jejeong5976/Project2_Turtle_Ninja/sim/robot_sim/rl/tasks/swerve_follow/README.md

# swerve_follow — 스워브 경로 추종 RL

Nav2 플래너 경로 + 목표 자세 → 몸 속도 (vx, vy, wz) 20 Hz. 아래는 팀 스워브 컨트롤러(`nt_swerve` 규칙) 그대로 → 정책은 바퀴를 직접 안 만짐.
목적 = MPPI(`motion_model: omni`, 조향 지연 모름) 가 못 보는 조향 지연 · 조향 범위 끝(한 바퀴 못 돎) 을 아는 명령. MPPI 대체 후보 (채택은 평가 후).

설계는 Claude 초안 → Codex 검토 3회 (설계 · 수정안 · 구현 코드) 로 정함 (2026-10-30).

## 구조

| 파일 | 내용 |
|---|---|
| `sim_core/swerve_torch.py` | `nt_swerve.SwerveDrive.update` torch 벡터화 (coherent · 범위 · blend · 균일 cos 감속 · 게이트 · 굴림 보상) |
| `tools/check_swerve_torch.py` | 원본과 일치 검사: 역기구학 2만 건 + 상태 기계 48 env × 3000 틱, 불일치 0 |
| `tools/make_path_bank.py` | 경로 은행 `rl/data/path_bank.npz` (NavFn 흉내 지도 경로 + 합성) |
| `cfg.py` | 환경 · DR · 보상 · PPO 설정 |
| `plant.py` | 간이 플랜트 (조향 속도 한계 + 1차 지연, 바퀴 1차 지연, 순기구학 최소제곱, 몸 관성 필터) |
| `paths.py` | 경로 묶음: 창 안 투영 (부호 횡오차 · 경로까지 거리), 호 길이 보간 |
| `follower.py` | 기준 추종기 (= `scripts/measure_dice_routes.py` 추종기 식) |
| `env.py` | rsl_rl VecEnv (Isaac 안 띄움) |
| `check_env.py` | 경로 끝 이탈 · 헤어핀 창 · 플랜트 직진/옆/회전 · 명령 지연 · 관측 지연 검사 |
| `rl/train.py`, `rl/tasks/swerve_follow/play.py` | 학습 · 간이 플랜트 평가 (기준선 vs 정책, 같은 경로 · DR) |
| `rl/tasks/swerve_follow/viz_episode.py` | 평가 지도 경로 1 개를 지도 방향 그대로 달려 미로 위에 그림 (gif · png, 바퀴 조향 · 게이트 표시) |

**미로 물리는 없음**: 학습 · 평가 모두 평평한 바닥 간이 플랜트 (벽 충돌 없음, 라이다 관측 없음). 미로는 경로를 만드는 지도로만 씀. 벽 충돌 · 여유는 Isaac 미로 평가로 따로 (미구현).

## 주요 결정

| 항목 | 결정 | 이유 |
|---|---|---|
| 학습 시뮬 | torch 간이 플랜트 (GPU, 4096 env) | 전체 로봇 Isaac + Python 컨트롤러는 env 수천 개 불가. Isaac 은 검증용 (미구현) |
| 행동 | **잔차** = 기준 추종기 + (Δvx, Δvy) 노름 ≤ 0.05 m/s, Δwz ≤ 0.3 rad/s | 잔차 0 = 기준선, 실패 원인 분리. Codex 는 0.03 / 0.15 권고 → 비교 실험 대상 |
| yaw | 기준 추종기가 처음부터 목표 yaw 로 (비례 1.5), 잔차가 조정 | 자유 yaw 학습 안 함 |
| 속도 한계 | {0.10/0.2, 0.13/0.2} (m/s, m/s²) 균등, 관측으로 줌. 각속도 = 1.675 × v/0.2612, 각가속 = 6 × a | 실물 확인 범위. 0.2612/1.0 은 `--hardware_profile` |
| 판정 자세 | 보상 · 도착 · 이탈 = 현재 추정 자세 (참 + 위치 오차, 지연 없음) | Nav2 goal checker 와 같음. 위치 오차는 컨트롤러가 못 고침 |
| reset 조향 | 직전 에피소드 끝 상태 이어받기 (컨트롤러 분기 이력도), 20 % 는 범위 안 무작위 | 연속 Nav2 목표와 같은 상황. 설계 v2 의 '무작위 사전 주행' 대신 |
| 지도 나눔 | 학습 real + rand_00..06, 평가 dice + rand_07 | 같은 지도로 평가하면 일반화 주장 불가 |

## 관측 (actor 130)

| 항목 | 차원 |
|---|---|
| 경로 앞 점 16 개 (0.1 m 간격, 추정 자세 base 기준) | 32 |
| 목표 (dx/2, dy/2, sin · cos dyaw, 남은 길이/3) | 5 |
| 기준 추종기 명령 / 한계 | 3 |
| 고유 상태 × 4 프레임 (현재 + 이전 3): 조향 sin · cos · 범위 위치, 바퀴 속도, odom, 직전 보낸 명령 | 22 × 4 |
| 한계 (v_max/0.26, a_max/1.0) | 2 |

critic 추가 (25): 참 몸 속도, 판정 자세 횡오차 · dyaw · 남은 길이, 조향 속도 한계 · τ 3 개 · 지연 2 개 · blend 비율 · 게이트, 위치 오차, 바퀴 미끄럼 4.

## 보상 (정책 스텝 50 ms)

| 항 | 식 |
|---|---|
| 진행 | +5 · Δs (부호 있음, \|Δs\| > v_max·dt + 0.05 면 0) |
| 경로 거리 | −0.02 · min((d/0.05)², 9) |
| 끝 방향 | −0.02 · (1 − cos dyaw) · clip(1 − 남은 길이/0.3, 0, 1) |
| 행동 변화 | −0.01 · ‖Δa‖² |
| 시간 | −0.005 |
| 성공 | +20: 5 cm · 0.1 rad · 0.02 m/s · 0.05 rad/s 를 0.5 s 유지 (종료) |
| 실패 | −20: 경로 거리 0.25 m 즉시 또는 0.15 m 0.5 s (종료) |
| 시간 초과 | 2 L / v_max + 15 s, truncation (bootstrap = rsl_rl 식 V(s_t) 근사) |

분기 전환 · 조향 이동량은 가중 0, 지표로만 기록.

## 도메인 랜덤화 (에피소드마다)

| 항목 | 범위 |
|---|---|
| 조향 속도 한계 | {0.96, 2.44, 4.80} × U(0.8, 1.2) rad/s (실물 미측정 → 3 조건 층화) |
| 조향 · 바퀴 · 몸 1차 지연 τ | 0.05–0.15 · 0.02–0.06 · 0.02–0.08 s |
| 바퀴별 접지 미끄럼 | 0.90–1.0 (odom 에는 안 걸림) |
| 명령 · 관측 지연 | 0–30 · 0–40 ms (10 ms 틱 링 버퍼) |
| 관측 잡음 | 조향 0.005 rad, 선속도 0.005 m/s, 각속도 0.02 rad/s |
| 위치 추정 오차 | 시작 ±2 cm · ±1°, 2 s 마다 30 % 로 ±1 cm · ±0.5° 계단 (범위 안으로 자름) |

## 경로

- 지도 경로: `layout_to_occupancy` 격자 → Nav2 식 비용 (내접 0.17 m 253, 팽창 0.25 m · scale 10) → NavFn 식 칸 비용 (50 + 0.8 c) Dijkstra 8 이웃 (대각선 모서리 통과 금지) → 퍼텐셜 경사 하강 → 0.05 m 재표본 → 중심 비용 < 253. 사각 footprint 충돌 검사는 안 함 (NavFn 과 같음). 실제 NavFn 출력과 비교 안 함.
- 합성: 꺾은선 + 원호, 등급 0 (≤45°, ≤2 m) / 1 (≤135°) / 2 (U턴).
- 학습 7800 개 (지도 4800), 평가 1200 개 (지도 600). 길이 중앙 2.4 m · 최대 10 m.
- 커리큘럼: 학습 성공률 (최근 2000 에피소드) 0.9 넘으면 등급 0 → 1 → 2. 초기 위치 ±2 → 5 cm, yaw ±15° → ±180°.

## PPO

actor [128, 128] ELU · critic [256, 256] ELU, 관측 정규화, 초기 std 0.3, entropy 0.001, γ 0.995, λ 0.95, 64 스텝/env, 5 epoch, 4 미니배치, lr 3e-4 adaptive (kl 0.01).

## 결과 (2026-10-30)

| 항목 | 기준선 (잔차 0) |
|---|---|
| 평가 에피소드 | 2400 (평가 경로 1200 × 2) |
| 성공 · 실패 · 시간 초과 | 99.25 % · 0.75 % · 0 % |
| 성공 시간 · 평균 속도 | 29.9 s · 0.092 m/s |
| 경로 거리 평균 · 최대 평균 · 최대 p95 | 1.7 · 6.2 · 11.5 cm |
| 분기 전환 · 조향 이동량 · 게이트 정지 | 4.4 회 · 29.6 rad · 0.41 s |
| 참 자세 끝 오차 p95 | 2.7 cm |

학습 처리량: 컨트롤러 + 플랜트 한 틱을 `torch.compile` (cfg `compile`) → 4096 env 111 → 16 ms/step, 16384 env 21 ms/step (약 78 만 env-step/s). 작은 연산 수천 개라 커널 띄우는 시간이 병목 (nvidia-smi 사용률은 높게 나와도 메모리 · 연산은 적음) → env 를 늘리는 게 거의 공짜. 기본 16384 env, iteration 3.2 s (100 만 샘플). 본학습 아직.

## 실행

```bash
cd sim/robot_sim
PY="env -u PYTHONPATH $HOME/pa-course/IsaacLab-6.2/.venv/bin/python"
$PY tools/check_swerve_torch.py              # 컨트롤러 일치
$PY rl/tasks/swerve_follow/check_env.py      # 환경 검사
$PY tools/make_path_bank.py                  # 경로 은행 (4 s)
$PY rl/tasks/swerve_follow/play.py --baseline                    # 기준선
$PY rl/train.py --max_iterations 1500 --run_name res005   # 약 80 분
$PY rl/tasks/swerve_follow/play.py --checkpoint rl/logs/swerve_follow/<실행>/model_1500.pt
$PY rl/tasks/swerve_follow/viz_episode.py --baseline --map dice --k 0   # → rl/data/swerve_follow/viz/*.gif
```

## 본학습 1 (2026-10-30, `rl/logs/swerve_follow/20261030_162155_res005`, 16384 env · 1500 iter · 약 61 분)

| 항목 | 기준선 | 정책 |
|---|---|---|
| 성공 | 99.25 % | 99.29 % |
| 성공 시간 · 평균 속도 | 29.89 s · 0.0918 m/s | 29.92 s · 0.0917 m/s |
| 경로 거리 평균 · 최대 p95 | 1.73 · 11.5 cm | 1.63 · 11.5 cm |
| 분기 전환 · 조향 이동량 | 4.4 회 · 29.6 rad | **6.9 회 · 40.1 rad** |
| 게이트 정지 | 0.41 s | 0.39 s |
| 끝 오차 (판정) | 0.23 cm | 1.0 cm |
| 조향 끝 0.5° 안 닿은 env (75 s 연속) | 37.9 % | 39.0 % |

- 개선 없음. 잔차 평균 약 0.01 m/s · 0.065 rad/s 만 씀, std 0.29 → 0.005 (iter 750 쯤 0.017) 로 일찍 줄어듦. 커리큘럼은 iter 150 전에 단계 2
- 원인 (판단): ① 보상에서 빨리 가는 이득이 작음 (진행 보상 총합은 속도와 무관, 시간 감점 0.005/스텝뿐), ② 기준 추종기가 이미 직선 · 곡선에서 v_max, 남는 시간은 가속 · 끝 감속 · 0.5 s 유지 쪽, ③ 조향 비용 가중 0 → 정책이 조향을 더 많이 씀, ④ 탐색이 일찍 죽음

## 남은 것 · 한계

- 간이 플랜트는 접촉 물리가 아님 (최소제곱 순기구학 = 바퀴 어긋남 근사). Isaac 재생 비교 (같은 명령 → 궤적) 로 τ 맞추기 · Isaac 미로 평가 (footprint 충돌 · 최소 여유) 미구현
- `nt_swerve` = 팀 swerve.cpp 10-27 로컬 판. 레포 main C++ 은 옛 판 → 실물에 올라간 판 확인 필요 (control)
- 실물 `/joint_states` 조향각 · 바퀴 속도 제공 · 빈도 · 신선도 미확인 (관측에 필수)
- 실물 조향 속도 (0.96 vs 4.8 rad/s) 미측정 → 측정되면 DR 3 조건을 실측 ±20 % 로
- 잔차 0.05/0.3 vs 0.03/0.15 비교, 커리큘럼 승급을 고정 검증셋 기준으로 바꿀지 (Codex 권고)
- 배포: 가중치 + 정규화 → Nav2 controller 플러그인 (C++) 미구현
- 채택 기준 (Codex 제안): 시뮬 고정 평가 100 회 충돌 0 · 성공 ≥ 99, 실물 대표 경로 20 회 연속, 기준선 대비 중앙 시간 10 % 이상 개선 + p95 오차 · 시간 악화 없음
