jejeong5976/Project2_Turtle_Ninja/sim/robot_sim/rl/tasks/swerve_track/README.md

# swerve_track — 스워브 속도 추종 잔차 RL

`/cmd_vel` (MPPI 출력) → 몸 속도 잔차 → `nt_swerve` → 조향 · 바퀴. MPPI 는 그대로 두고 그 아래 끼우는 층 (MPPI 대체 아님).
R12 팀 주행 PPO (velog "프로젝트2 PPO 신경망 구조": 목표 속도 → 바퀴 속도 잔차, 고정 평가 RMSE) 를 참고해 2026-11-02 설계. `swerve_follow` (경로 층) 본학습 1 이 보상 문제로 개선 없었던 것 → 목표를 "명령 속도 따라가기" 하나로 좁힘.

```
Nav2 MPPI → collision_monitor → /cmd_vel ─┐
                                          ├→ [정책: 몸 속도 잔차] → nt_swerve → 조향 · 바퀴
odom · 조향각 · 바퀴 속도 · 자이로 ───────┘
```

## R12 설계와 다른 점

| 항목 | R12 | 여기 | 이유 |
|---|---|---|---|
| 행동 | 바퀴 구동 속도 잔차 4 | 몸 속도 잔차 3 (nt_swerve 앞) | 바퀴별로 고치면 역기구학이 맞춘 바퀴 사이 일관성이 깨짐 → 실물 끌림. 간이 플랜트 (최소제곱 순기구학) 는 끌림 비용을 못 봄 |
| 기울기 보상 | −10 (roll² + pitch²) | 없음 | 간이 플랜트에 roll · pitch 없음 (Isaac 검증 때 지표로만) |
| IMU | 각속도 3 · 가속도 3 | 자이로 z 1 | 평평한 바닥 플랜트 |
| 조향 비용 | 없음 | 이동량 + 범위 끝 | swerve_follow 본학습 1 에서 분기 전환 4.4 → 6.9 회 악화, 조향 끝 닿음 38 % (선 꼬임) |
| 학습 규모 | env 8 × 64 스텝 | env 16384 × 64 (torch 플랜트) | |
| critic | 1 층 128 | [256, 256] + 특권 관측 | |

## 구조

| 파일 | 내용 |
|---|---|
| `tools/make_cmd_bank.py` | 명령 은행 `rl/data/swerve_track/cmd_bank.npz` (20 Hz, 열 최대 20 s, 열마다 v_max · a_max) |
| `cfg.py` | 환경 · 보상 · PPO. DR = `swerve_follow.cfg.DRCfg` 그대로 |
| `env.py` | rsl_rl VecEnv. 플랜트 · 컨트롤러 = `swerve_follow.plant` · `sim_core/swerve_torch.py` |
| `rl/tasks/swerve_track/play.py` | 평가 (기준선 vs 정책, 출처별) |
| `rl/train.py --task swerve_track` | 학습 |

## 명령 은행

| 출처 | 만드는 법 | 학습 · 평가 열 |
|---|---|---|
| follower | `swerve_follow` 기준 추종기를 경로 은행 위에서 닫힌 고리 주행 → 보낸 명령 기록 (경로 split 0 → 학습, 1 → 평가) | 13851 · 2192 |
| synth | 구간 상수 (0.5–3 s, 정지 15 %, 방향 ±90° 40 % · 180° 20 %, 회전 동시 50 %) → 가속 한계 램프 → 잡음 0.005 | 4000 · 600 |

- 실제 MPPI 출력이 아님 (대용). MPPI 녹화 (`sim_nav2` 로 `/cmd_vel` 기록) 는 미구현 → 하면 은행에 출처 2 로 추가

## 관측 (actor 77)

| 항목 | 차원 |
|---|---|
| 목표 명령 / 한계 | 3 |
| 목표 − odom / 한계 | 3 |
| 앞으로 올 명령 (`preview`, 기본 0) | 3 × k |
| 고유 상태 × 3 프레임: 조향 sin · cos · 범위 위치 12, 바퀴 4, odom 3, 자이로 z 1, 직전 보낸 명령 3 | 23 × 3 |
| 한계 (v_max/0.26, a_max/1.0) | 2 |

critic 추가 (21): 참 몸 속도 3, 조향 속도 한계 · τ 3 · 지연 2 · blend · 게이트 8, 바퀴 미끄럼 4, 0.25 · 0.5 s 뒤 명령 6.

- 미리보기 기본 0: 실물에서 앞 명령을 얻으려면 MPPI 내부 최적 열이 필요 (Nav2 는 경로 형태로만 냄) → 지금은 반응형만

## 행동 · 안전

- 잔차 = (Δvx, Δvy) 노름 ≤ 0.03 m/s, Δwz ≤ 0.15 rad/s (Codex 권고값). 합친 명령은 v_max · w_max 로 자름
- 목표가 정지 (‖v‖ < 0.005 · |wz| < 0.02) 면 잔차 0 → collision_monitor 정지 · `/mission/hold` 가 항상 이김

## 보상 (정책 스텝 50 ms)

| 항 | 식 |
|---|---|
| 선속도 추종 | 1.0 · exp(−‖v_xy − c_xy‖² / 0.05²) (참 몸 속도) |
| 각속도 추종 | 0.5 · exp(−(wz − c_wz)² / 0.15²) |
| 조향 이동량 | −0.2 · Σ\|Δθ\| [rad/스텝] |
| 조향 범위 끝 | −0.05 · 바퀴 평균 clip((0.1 − 끝까지 거리)/0.1, 0, 1) |
| 행동 크기 · 변화 | −0.01 ‖a‖², −0.01 ‖Δa‖² |

에피소드 = 명령 열 끝까지 (truncation, 실패 종료 없음). 조향 상태는 직전 에피소드에서 이어받음 (20 % 무작위).

## PPO

actor [128, 128] ELU · critic [256, 256] ELU, 관측 정규화, 초기 std 0.3 · **최소 std 0.02** (`std_range`), entropy 0.002, γ 0.99, λ 0.95, 64 스텝/env, 5 epoch, 4 미니배치, lr 3e-4 adaptive (kl 0.01).

## 기준선 (잔차 0, 2026-11-02, 평가 2792 열 × 2)

| 묶음 | 선속도 RMSE 평균 · p95 | 각속도 RMSE 평균 · p95 | R12 기준 (0.03 · 0.10) 통과 | 조향 이동 rad/s | 게이트 s |
|---|---|---|---|---|---|
| 전체 | 0.039 · 0.070 | 0.111 · 0.317 | 22.5 % | 1.79 | 0.40 |
| follower | 0.040 · 0.073 | 0.117 · 0.332 | 21.4 % | 1.24 | 0.32 |
| synth | 0.038 · 0.060 | 0.088 · 0.148 | 26.4 % | 3.76 | 0.72 |

조향 속도별 (follower + synth, 첫 1 s 따로):

| 조향 속도 | 선속도 전체 · 첫 1 s · 나머지 | 각속도 전체 · 첫 1 s · 나머지 | \|wz 명령\| > 0.3 스텝 (12.6 %) 각속도 |
|---|---|---|---|
| 0.96 rad/s | 0.054 · 0.103 · 0.049 | 0.194 · 0.451 · 0.164 | 0.528 |
| 2.44 | 0.037 · 0.096 · 0.030 | 0.141 · 0.419 · 0.100 | 0.380 |
| 4.80 | 0.029 · 0.080 · 0.022 | 0.109 · 0.355 · 0.068 | 0.289 |

- 오차 대부분 = 느린 조향 · 출발 첫 1 s (무작위 조향에서 시작) · 큰 회전 명령 구간
- 조향 4.8 rad/s 면 첫 1 s 뺀 나머지는 R12 기준 안 → **실물 조향 속도가 정책 쓸모를 정함** (hardware_map profile_vel 40 = 0.96 rad/s 라는 기록 있음, 실측 필요)

## 본학습 1 (2026-11-02, `rl/logs/swerve_track/20261102_170547_track`, 16384 env · 1000 iter, 잔차 0.03 · 0.15, 미리보기 0)

평가 은행 (2792 열 × 2), 기준선 → 정책:

| 조건 | 선속도 RMSE 평균 | 각속도 RMSE 평균 | 각속도 p95 | 변화 구간 각속도 | 조향 이동 rad/s | 게이트 s |
|---|---|---|---|---|---|---|
| DR 3 조건 | 0.0394 → 0.0385 (−2.1 %) | 0.1105 → 0.1085 (−1.8 %) | 0.317 → 0.303 (−4.4 %) | 0.105 → 0.101 (−3.9 %) | 1.79 → 1.79 | 0.40 → 0.39 |
| 조향 0.96 | 0.0531 → 0.0517 (−2.7 %) | 0.1417 → 0.1388 (−2.1 %) | 0.394 → 0.383 | 0.153 → 0.152 | 1.45 → 1.47 | 0.69 → 0.67 |
| 조향 2.44 | 0.0367 → 0.0358 (−2.4 %) | 0.1049 → 0.1023 (−2.4 %) | 0.281 → 0.266 | 0.090 → 0.088 | 1.88 → 1.88 | 0.33 → 0.32 |
| 조향 4.80 | 0.0282 → 0.0281 (−0.7 %) | 0.0850 → 0.0842 (−0.9 %) | 0.211 → 0.204 | 0.073 → 0.067 (−8.9 %) | 2.04 → 2.04 | 0.19 → 0.18 |

- 개선 1–3 % = 채택 기준 (20 %) 에 크게 못 미침. 조향 비용 · 범위 끝은 악화 없음 (본학습 1 swerve_follow 와 달리 조향을 더 쓰지 않음)
- 잔차 평균 선속도 0.008 m/s (한계의 27 %) · 각속도 0.009 rad/s (6 %), std 0.30 → 0.034 (하한 0.02 근처)
- synth (계단 · 90° 전환) 는 개선 0 또는 소폭 악화 (선속도 +0.8 %). 이득은 follower 쪽 (−2.8 %) 에서만
- 판단: 오차가 조향 속도 · 출발 조향 · 가속 한계 같은 물리 한계에서 나옴 → 지금 명령만 보는 반응형 잔차로는 못 줄임. 줄이려면 앞 명령 (미리보기) 이 필요 → 시뮬에서 `preview` 로 상한 확인할 가치 있음

## 남은 것

- 실물 조향 속도 · `/joint_states` 빈도 실측 → DR 을 실측 ±20 % 로
- MPPI `/cmd_vel` 녹화 은행 (`sim_nav2`), 미리보기 (MPPI 최적 열) 얻는 법
- Isaac 재생 비교 (같은 명령 → 궤적), 배포 (C++ 추론, swerve_controller 안 또는 cmd_vel 중계 노드)
- 채택 기준 (안): 평가 은행에서 기준선 대비 선속도 · 각속도 RMSE 20 % 이상 감소 + 조향 이동량 · 범위 끝 악화 없음, 실물 대표 경로 20 회

## 실행

```bash
cd sim/robot_sim
PY="env -u PYTHONPATH $HOME/pa-course/IsaacLab-6.2/.venv/bin/python"
$PY tools/make_cmd_bank.py                                  # 약 2.5 분
$PY rl/tasks/swerve_track/play.py --baseline                             # 기준선
$PY rl/train.py --task swerve_track --max_iterations 1000 --run_name track
$PY rl/tasks/swerve_track/play.py --checkpoint rl/logs/swerve_track/<실행>/model_1000.pt
```
