jejeong5976/Project2_Turtle_Ninja/config/camera_home_ref.png

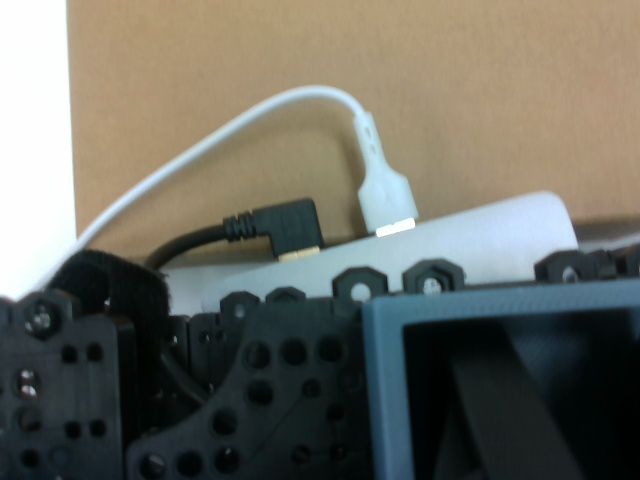
config/camera_home_ref.png
