jejeong5976/Project2_Turtle_Ninja/sim/robot_sim/usd/props/tex/barcode_3.png

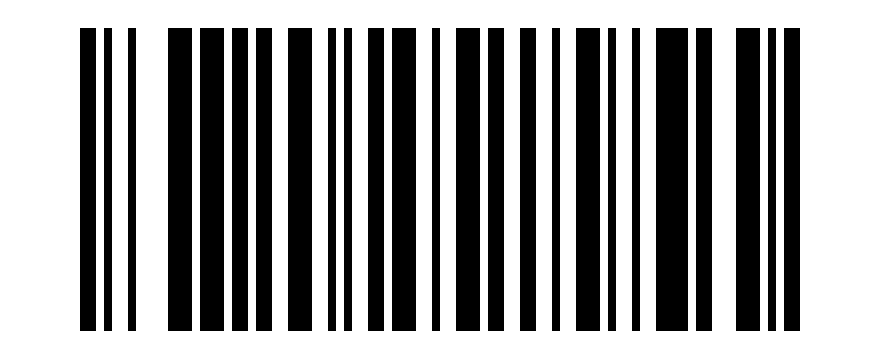
sim/robot_sim/usd/props/tex/barcode_3.png
