jejeong5976/Project2_Turtle_Ninja/sim/robot_sim/usd/props/tex/tag36h11_03.png

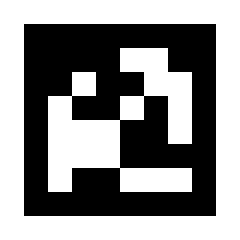
sim/robot_sim/usd/props/tex/tag36h11_03.png
