jejeong5976/Project2_Turtle_Ninja/sim/robot_sim/usd/textures/carpet_tile.jpg

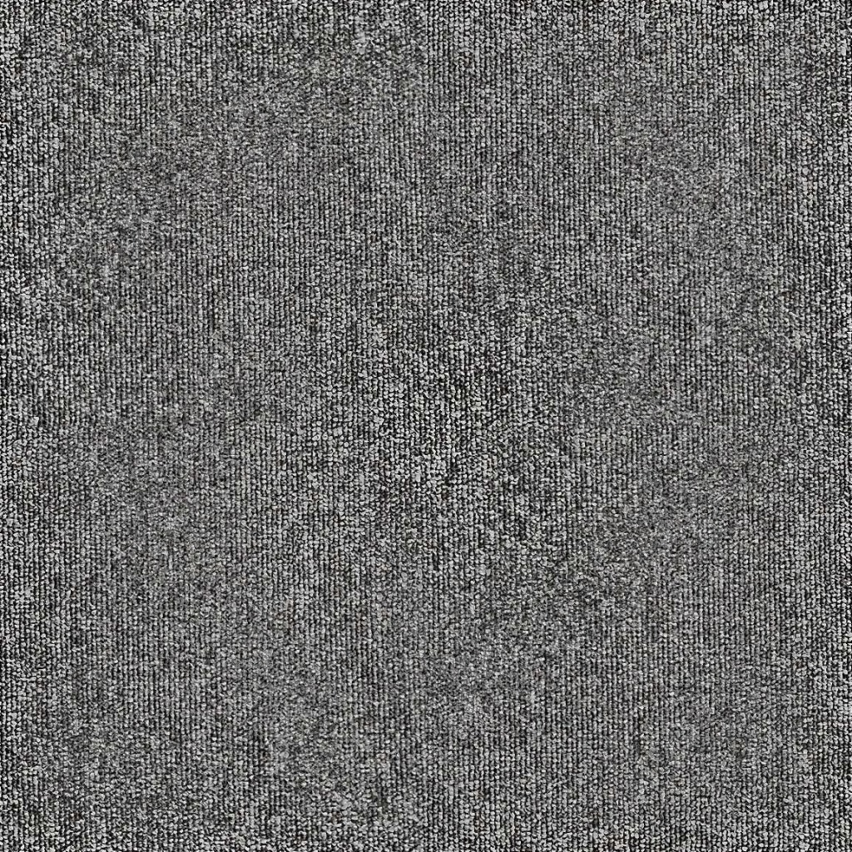
sim/robot_sim/usd/textures/carpet_tile.jpg
