jejeong5976/Project2_Turtle_Ninja/sim/robot_sim/usd/textures/pano_191331.jpg

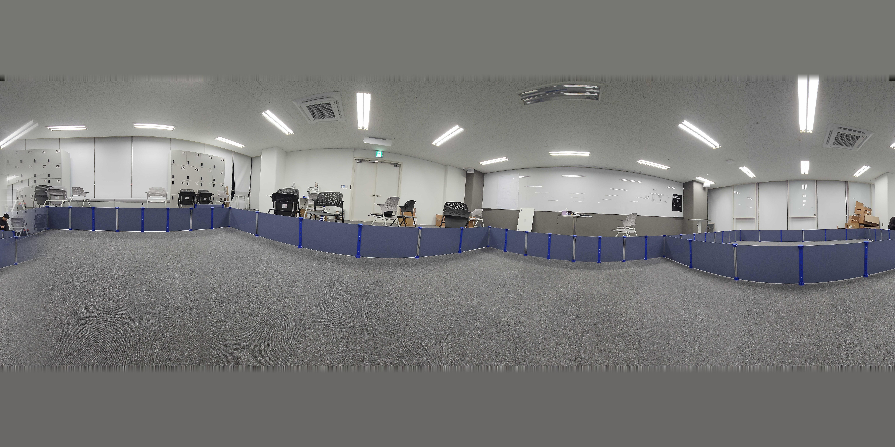
sim/robot_sim/usd/textures/pano_191331.jpg
