jejeong5976/Project2_Turtle_Ninja/ros2_ws/src/description/meshes/arm/collision/wrist_assembly_2_1_part_1_1.obj

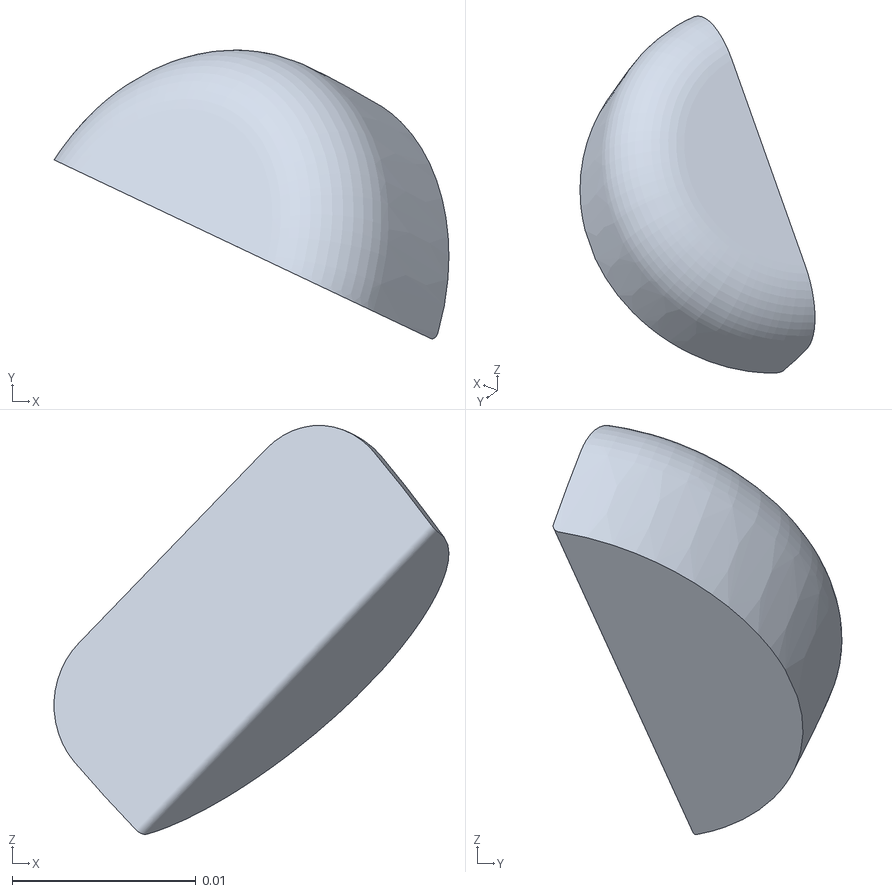
[picture p30: CAD file, 2026-11-02]
ros2_ws/src/description/meshes/arm/collision/wrist_assembly_2_1_part_1_1.obj
0.0215 x 0.0157 x 0.0222
