jejeong5976/Project2_Turtle_Ninja/ros2_ws/src/description/meshes/arm/collision/wrist_assembly_2_1_part_2_1.obj

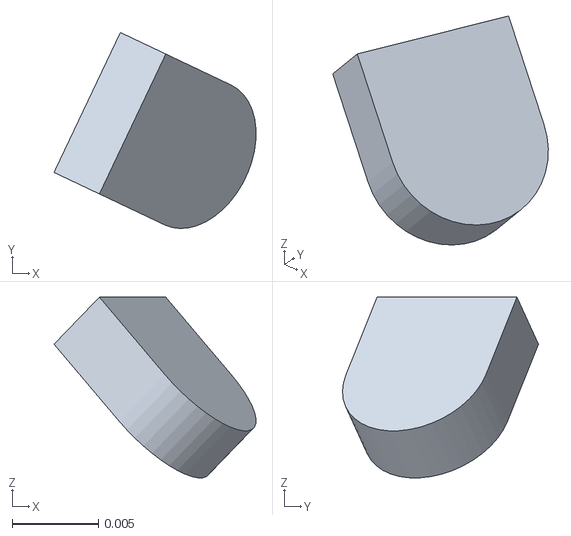
[picture p31: CAD file, 2026-11-02]
ros2_ws/src/description/meshes/arm/collision/wrist_assembly_2_1_part_2_1.obj
0.0117 x 0.0114 x 0.0105
