jejeong5976/Project2_Turtle_Ninja/ros2_ws/src/description/meshes/arm/collision/wrist_assembly_2_1_part_3_1.obj

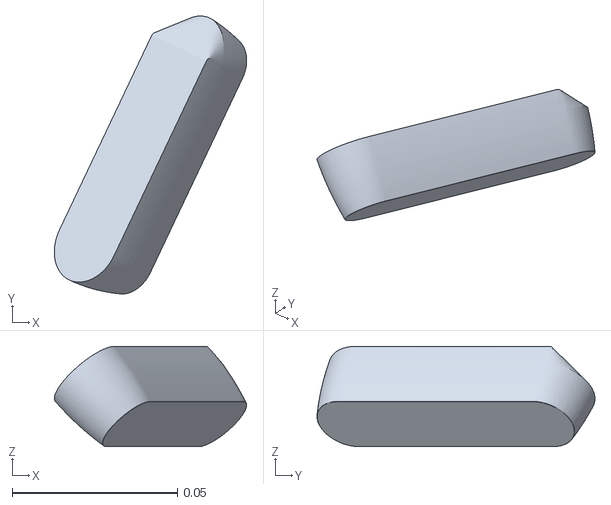
[picture p32: CAD file, 2026-11-02]
ros2_ws/src/description/meshes/arm/collision/wrist_assembly_2_1_part_3_1.obj
0.0581 x 0.084 x 0.0303
