jejeong5976/Project2_Turtle_Ninja/ros2_ws/src/description/meshes/arm/wrist_motor_mount_plate.obj

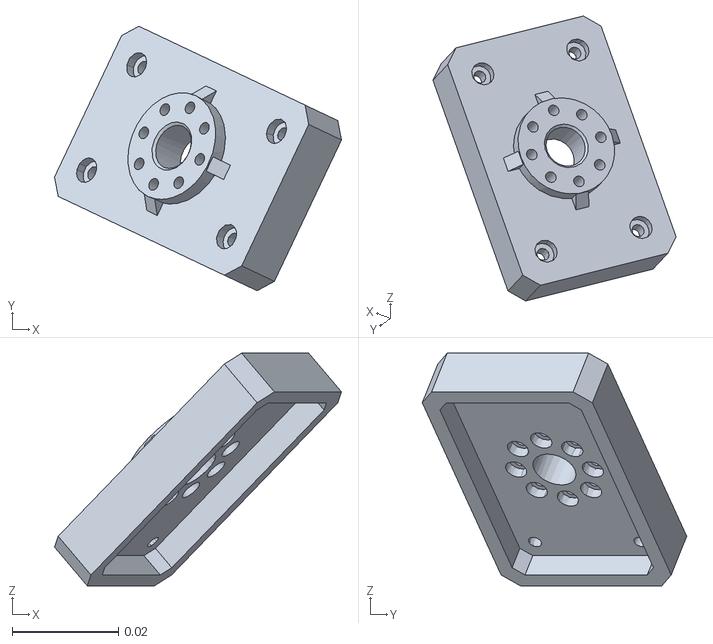
[picture p35: CAD file, 2026-11-02]
ros2_ws/src/description/meshes/arm/wrist_motor_mount_plate.obj
0.0541 x 0.0499 x 0.0439
