jejeong5976/Project2_Turtle_Ninja/ros2_ws/src/description/meshes/base/hardware/support_hex_m3_0xl35_ff_1.obj

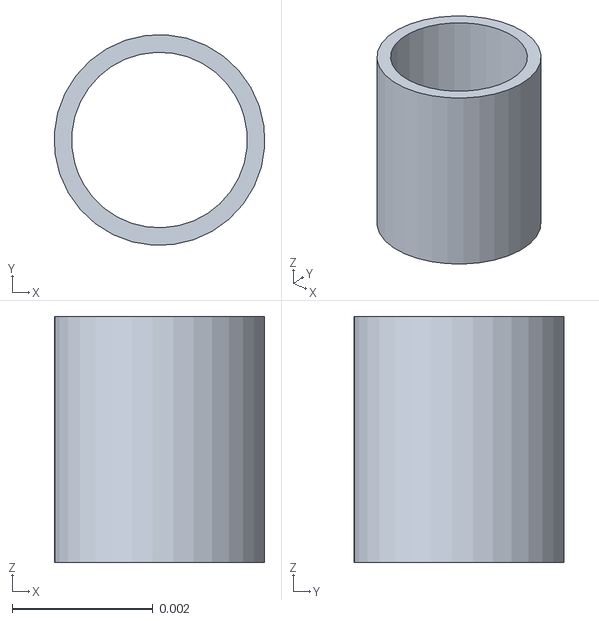
[picture p36: CAD file, 2026-11-02]
ros2_ws/src/description/meshes/base/hardware/support_hex_m3_0xl35_ff_1.obj
0.00299 x 0.00299 x 0.0035
