jejeong5976/Project2_Turtle_Ninja/ros2_ws/src/description/meshes/base/steer_motor.obj

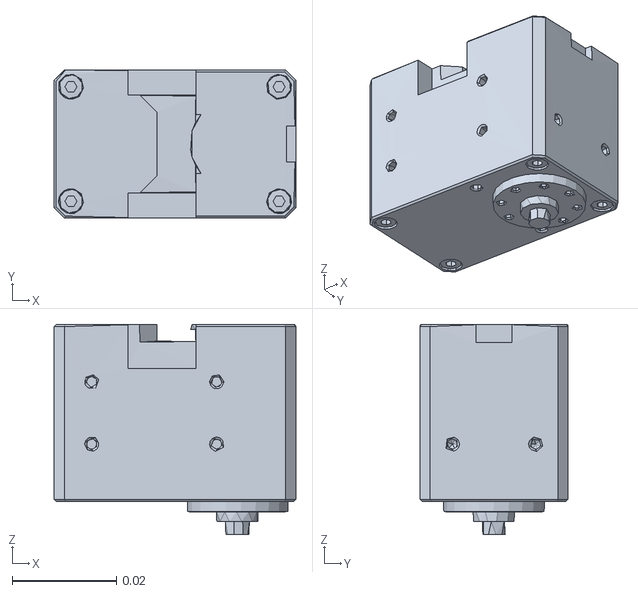
[picture p37: CAD file, 2026-11-02]
ros2_ws/src/description/meshes/base/steer_motor.obj
0.0465 x 0.0285 x 0.0404
