jejeong5976/Project2_Turtle_Ninja/ros2_ws/src/description/meshes/camera/bracket_lever.obj

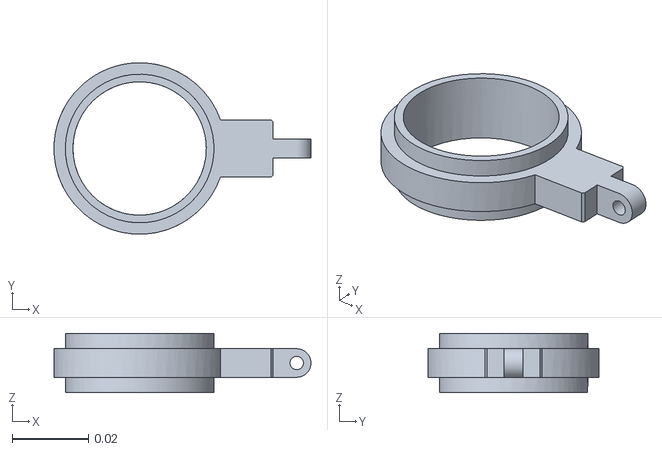
[picture p38: CAD file, 2026-11-02]
ros2_ws/src/description/meshes/camera/bracket_lever.obj
0.0675 x 0.045 x 0.0155
