jejeong5976/Project2_Turtle_Ninja/ros2_ws/src/description/meshes/camera/collision/birdeye_connector.obj

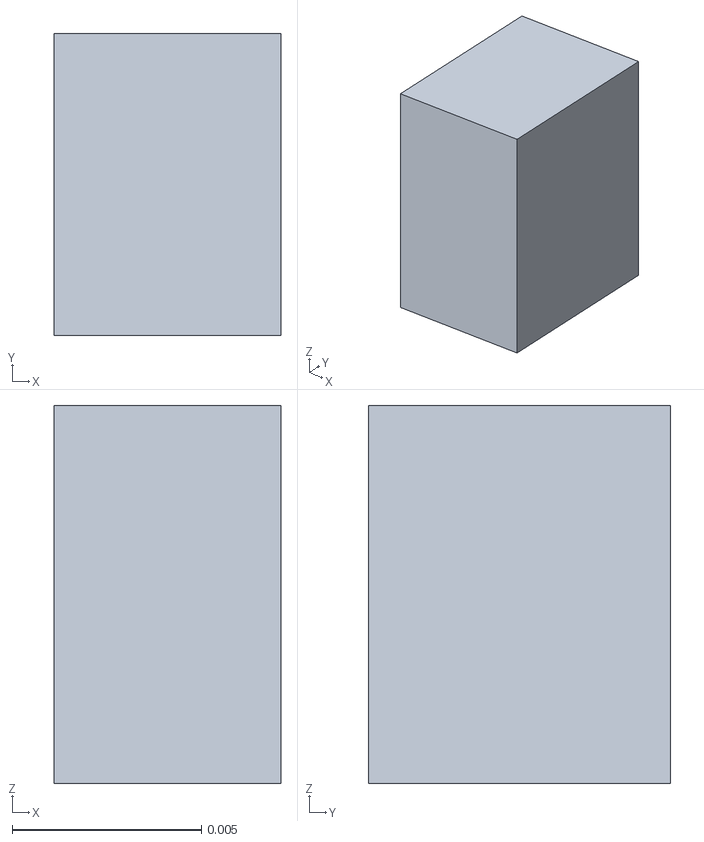
[picture p39: CAD file, 2026-11-02]
ros2_ws/src/description/meshes/camera/collision/birdeye_connector.obj
0.006 x 0.008 x 0.01
