jejeong5976/Project2_Turtle_Ninja/ros2_ws/src/description/meshes/electronics/opencr_drive.obj

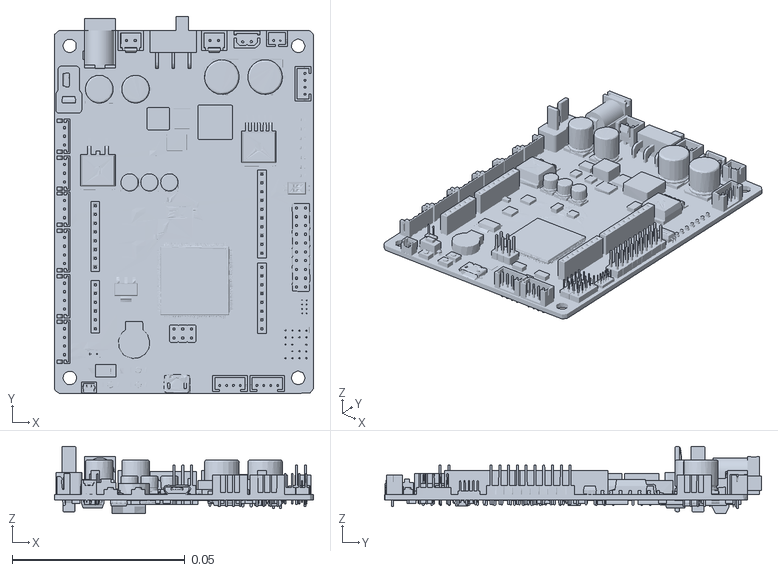
[picture p40: CAD file, 2026-11-02]
ros2_ws/src/description/meshes/electronics/opencr_drive.obj
0.075 x 0.109 x 0.0194
