jejeong5976/Project2_Turtle_Ninja/ros2_ws/src/description/meshes/lidar/lds03_body.obj

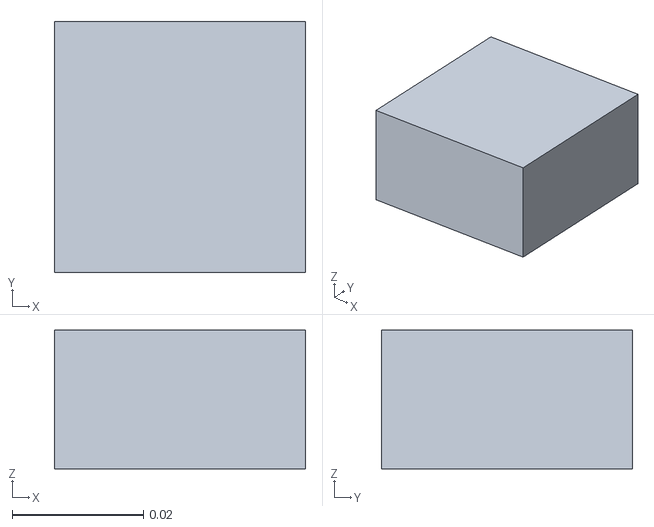
[picture p41: CAD file, 2026-11-02]
ros2_ws/src/description/meshes/lidar/lds03_body.obj
0.0382 x 0.0382 x 0.0211
