jejeong5976/Project2_Turtle_Ninja/ros2_ws/src/description/meshes/rack/rack_4cell.obj

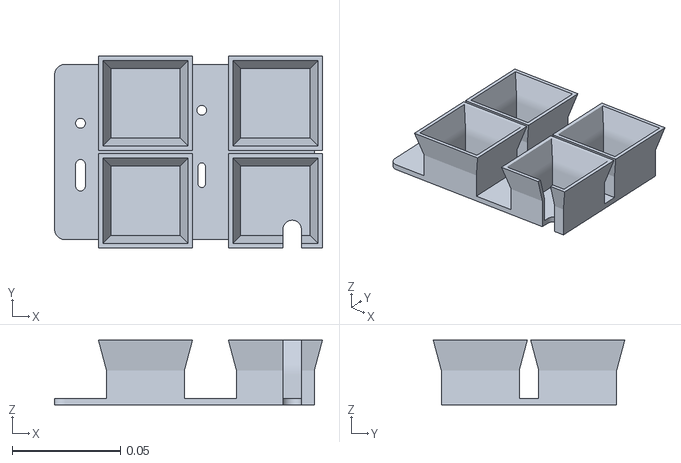
[picture p42: CAD file, 2026-11-05]
ros2_ws/src/description/meshes/rack/rack_4cell.obj
0.124 x 0.0885 x 0.03
