jejeong5976/Project2_Turtle_Ninja/ros2_ws/src/description/meshes/structure/collision/profile_holder.obj

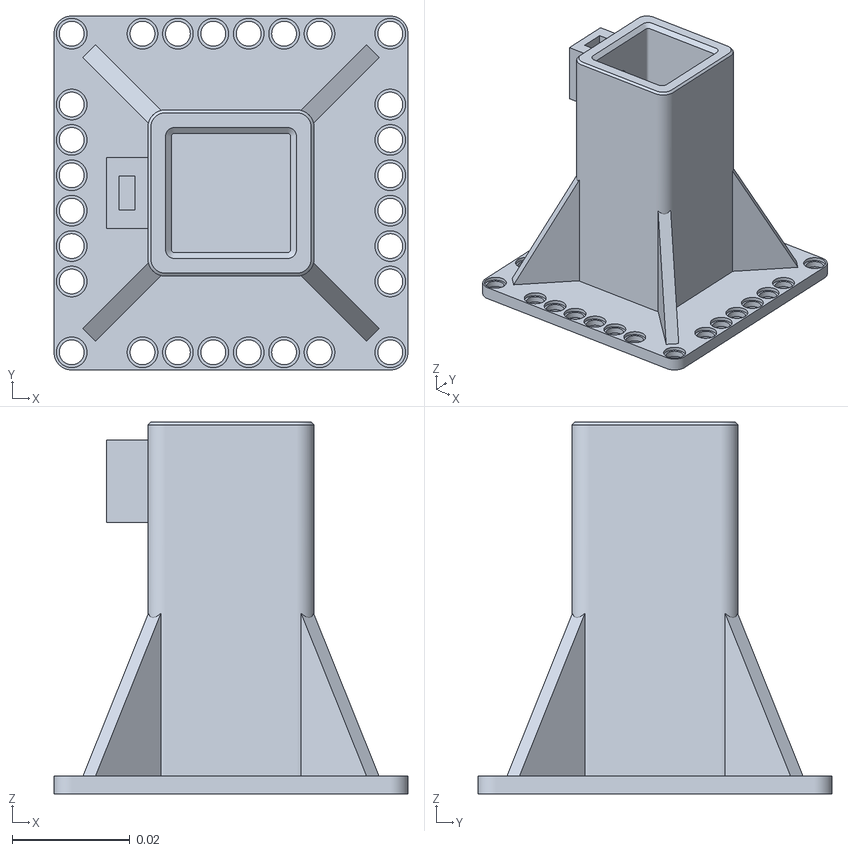
[picture p43: CAD file, 2026-11-02]
ros2_ws/src/description/meshes/structure/collision/profile_holder.obj
0.06 x 0.06 x 0.063
