jejeong5976/Project2_Turtle_Ninja/ros2_ws/src/description/meshes/structure/profile_450mm.obj

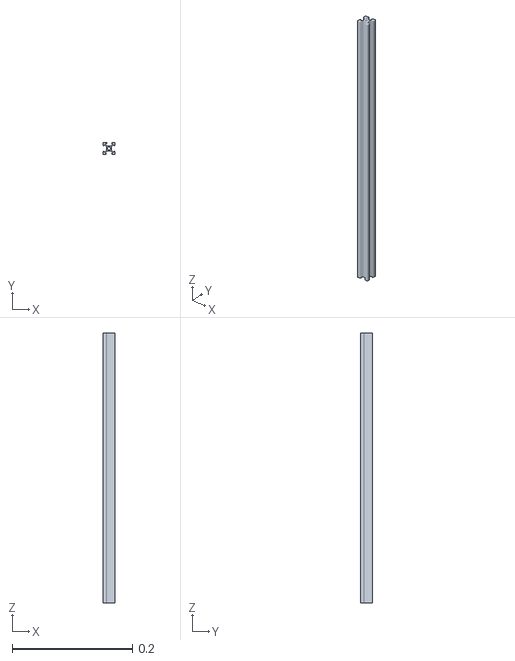
[picture p44: CAD file, 2026-11-02]
ros2_ws/src/description/meshes/structure/profile_450mm.obj
0.02 x 0.02 x 0.45
