jejeong5976/Project2_Turtle_Ninja/ros2_ws/src/description/meshes/swerve/module_fr.stl

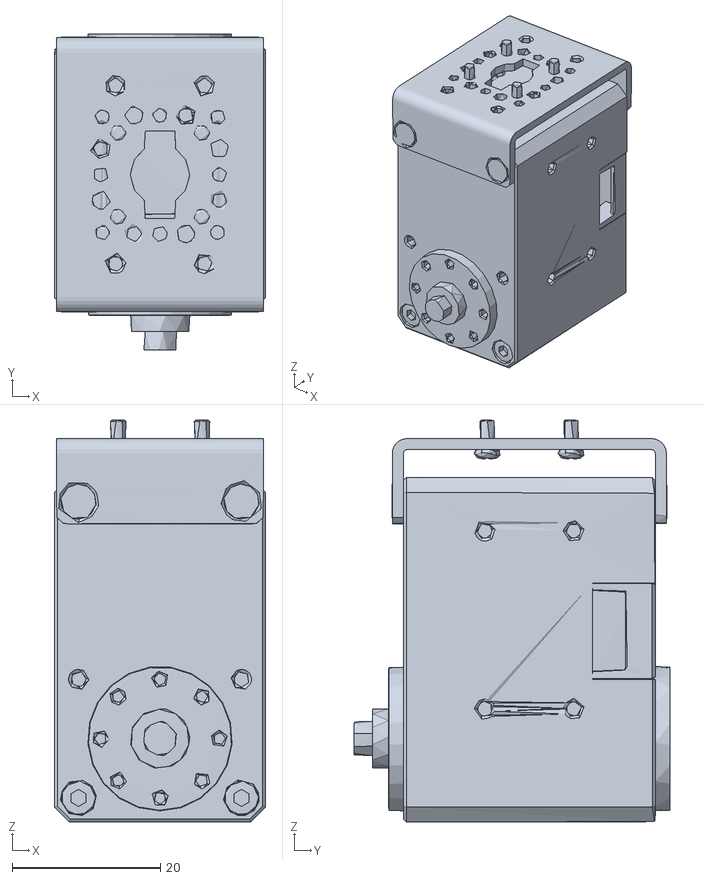
[picture p45: CAD file, 2026-10-21]
ros2_ws/src/description/meshes/swerve/module_fr.stl
28.5 x 42.7 x 54.3
