jejeong5976/Project2_Turtle_Ninja/ros2_ws/src/description/meshes/arm/wrist_frame_hinged_camera.obj

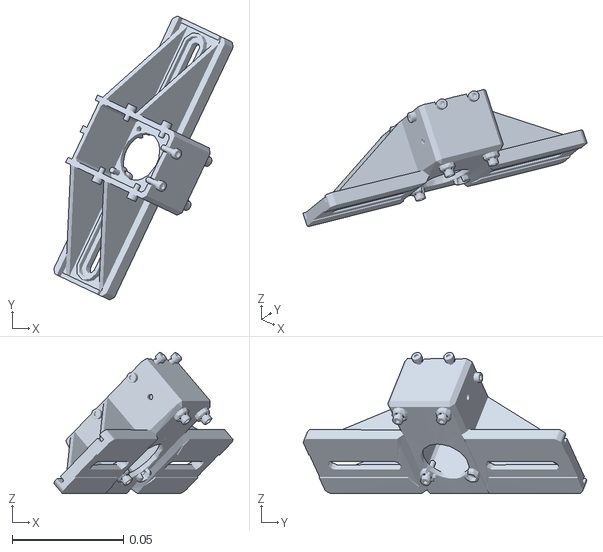
[picture p47: CAD file, 2026-11-02]
ros2_ws/src/description/meshes/arm/wrist_frame_hinged_camera.obj
0.0805 x 0.128 x 0.0635
