jejeong5976/Project2_Turtle_Ninja/ros2_ws/src/description/meshes/base/hardware/nut2_m3_1.obj

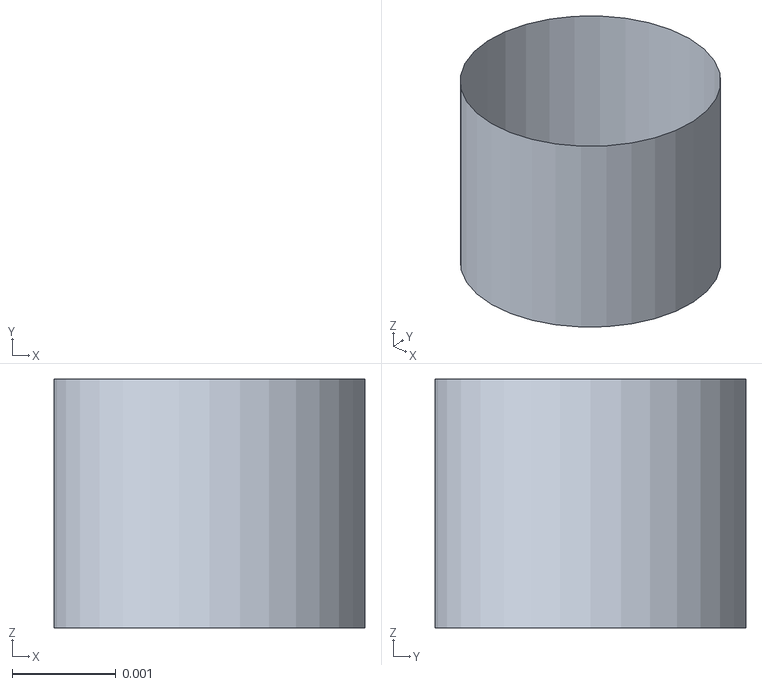
[picture p48: CAD file, 2026-11-02]
ros2_ws/src/description/meshes/base/hardware/nut2_m3_1.obj
0.003 x 0.003 x 0.0024
