jejeong5976/Project2_Turtle_Ninja/ros2_ws/src/description/meshes/base/usb_board.obj

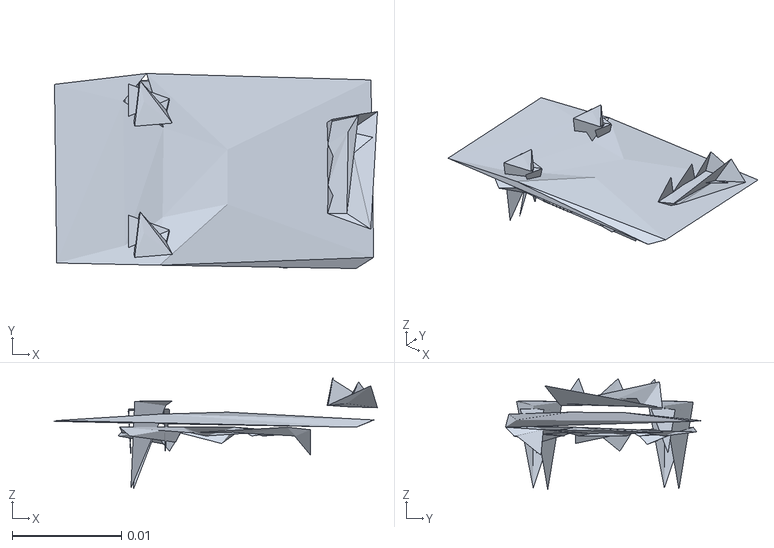
[picture p49: CAD file, 2026-11-02]
ros2_ws/src/description/meshes/base/usb_board.obj
0.0295 x 0.0178 x 0.0102
