jejeong5976/Project2_Turtle_Ninja/ros2_ws/src/description/meshes/camera/birdeye_pcb.obj

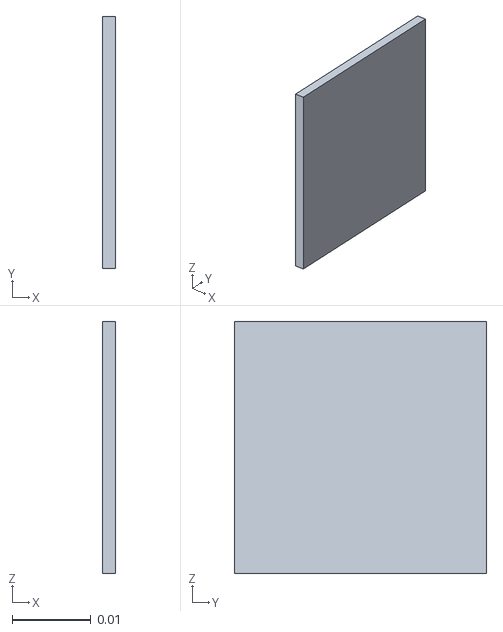
[picture p50: CAD file, 2026-11-02]
ros2_ws/src/description/meshes/camera/birdeye_pcb.obj
0.0016 x 0.032 x 0.032
