jejeong5976/Project2_Turtle_Ninja/ros2_ws/src/description/meshes/electronics/jetson_carrier.obj

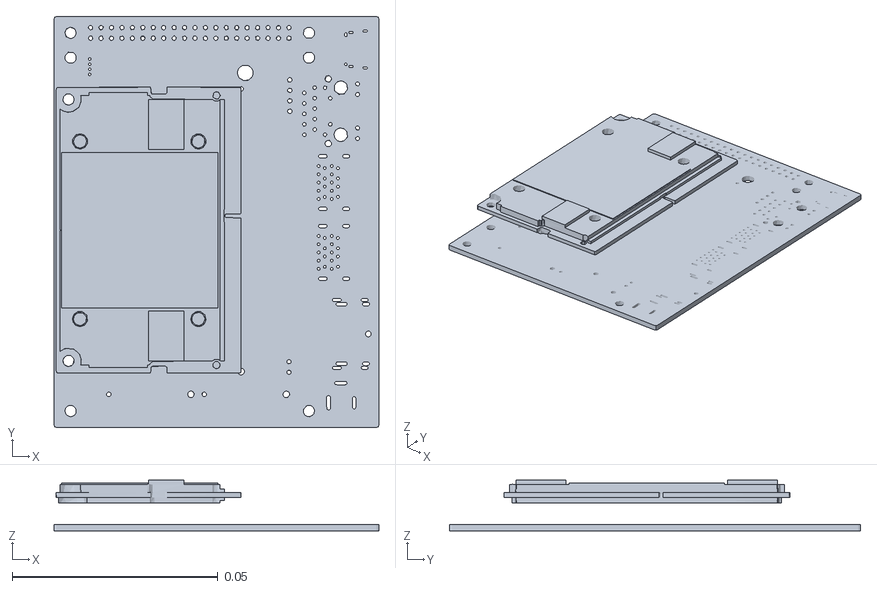
[picture p51: CAD file, 2026-11-02]
ros2_ws/src/description/meshes/electronics/jetson_carrier.obj
0.079 x 0.1 x 0.0123
