jejeong5976/Project2_Turtle_Ninja/ros2_ws/src/description/meshes/lidar/lds03_mount_right.obj

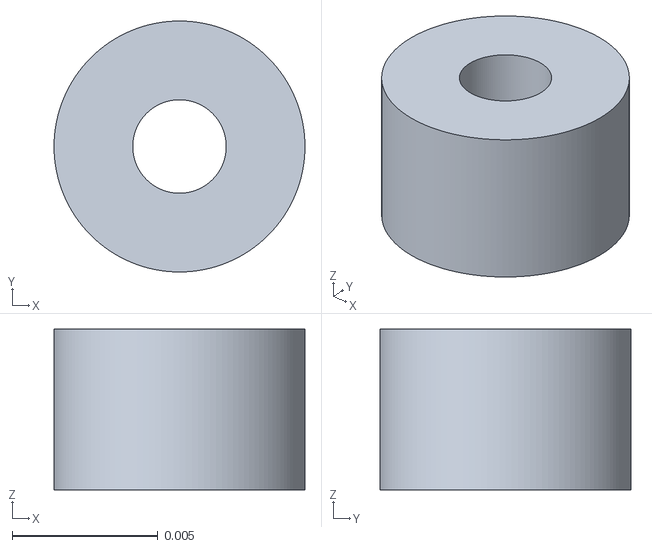
[picture p52: CAD file, 2026-11-02]
ros2_ws/src/description/meshes/lidar/lds03_mount_right.obj
0.0086 x 0.0086 x 0.0055
