jejeong5976/Project2_Turtle_Ninja/ros2_ws/src/description/meshes/rack/rack_8cell.obj

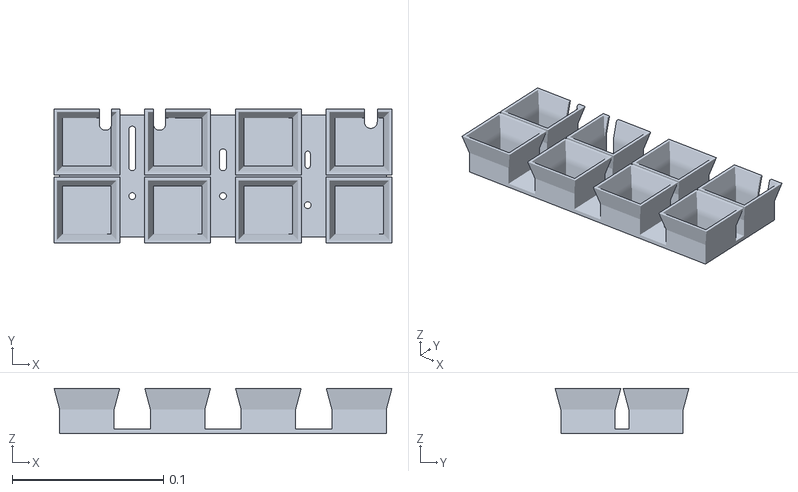
[picture p53: CAD file, 2026-11-05]
ros2_ws/src/description/meshes/rack/rack_8cell.obj
0.224 x 0.0885 x 0.03
