jejeong5976/Project2_Turtle_Ninja/ros2_ws/src/description/meshes/arm/collision/gripper_drive_crank_collision.obj

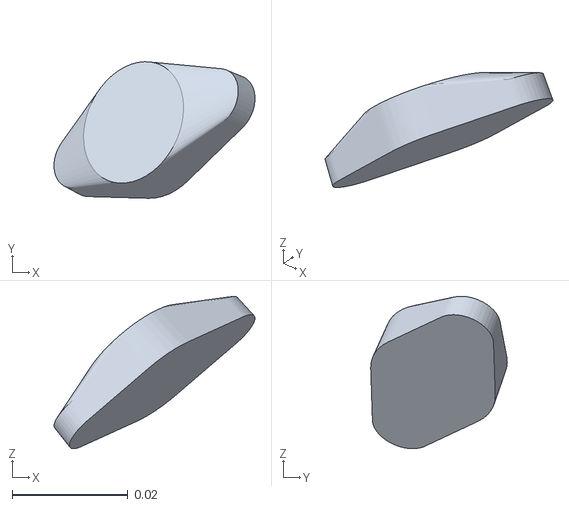
[picture p54: CAD file, 2026-11-02]
ros2_ws/src/description/meshes/arm/collision/gripper_drive_crank_collision.obj
0.0347 x 0.0236 x 0.0263
