jejeong5976/Project2_Turtle_Ninja/ros2_ws/src/description/meshes/base/hardware/nut2_m2.obj

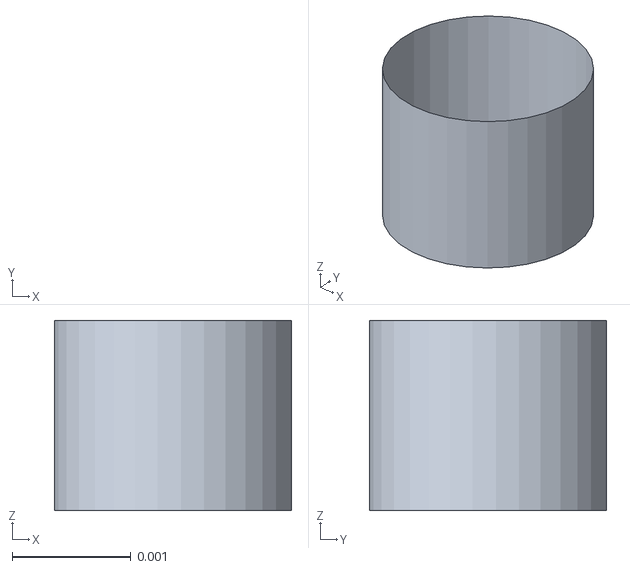
[picture p55: CAD file, 2026-11-02]
ros2_ws/src/description/meshes/base/hardware/nut2_m2.obj
0.002 x 0.002 x 0.0016
