jejeong5976/Project2_Turtle_Ninja/ros2_ws/src/description/meshes/base/waffle_plate.obj

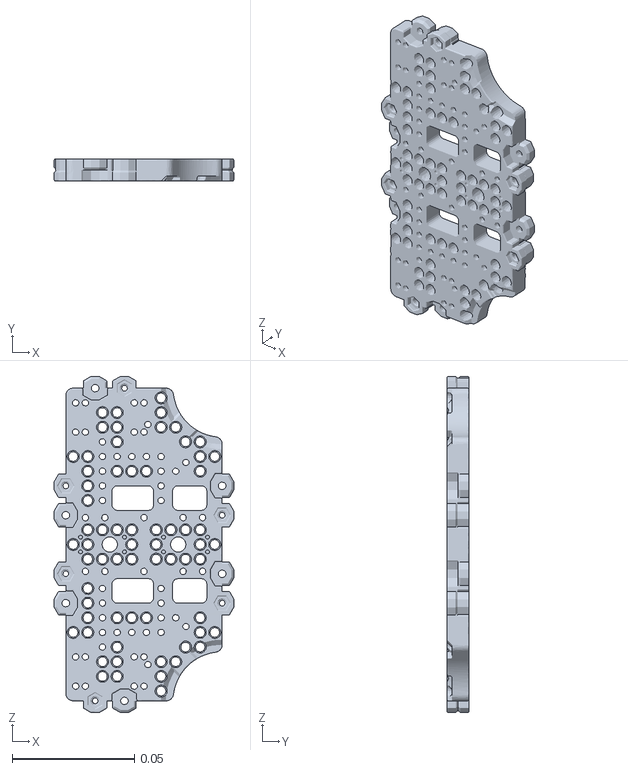
[picture p56: CAD file, 2026-11-02]
ros2_ws/src/description/meshes/base/waffle_plate.obj
0.0735 x 0.00905 x 0.138
