jejeong5976/Project2_Turtle_Ninja/ros2_ws/src/description/meshes/camera/bracket_clamp.obj

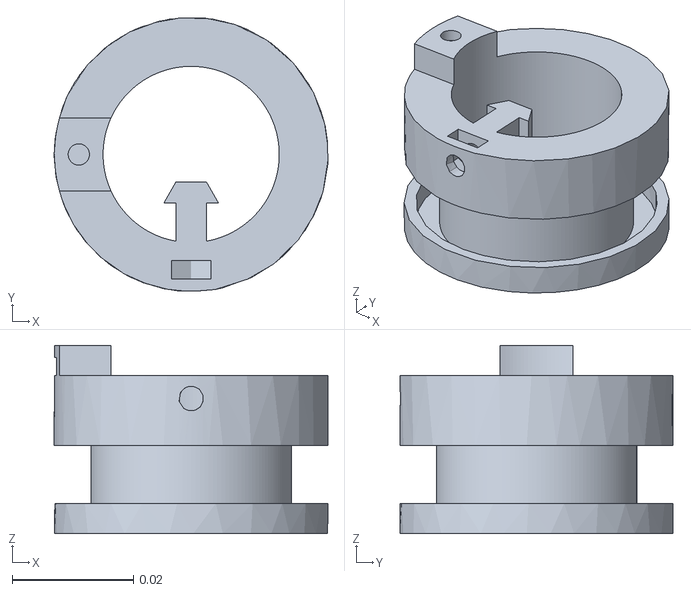
[picture p57: CAD file, 2026-11-02]
ros2_ws/src/description/meshes/camera/bracket_clamp.obj
0.0451 x 0.045 x 0.031
