jejeong5976/Project2_Turtle_Ninja/ros2_ws/src/description/meshes/electronics/jetson_ssd.obj

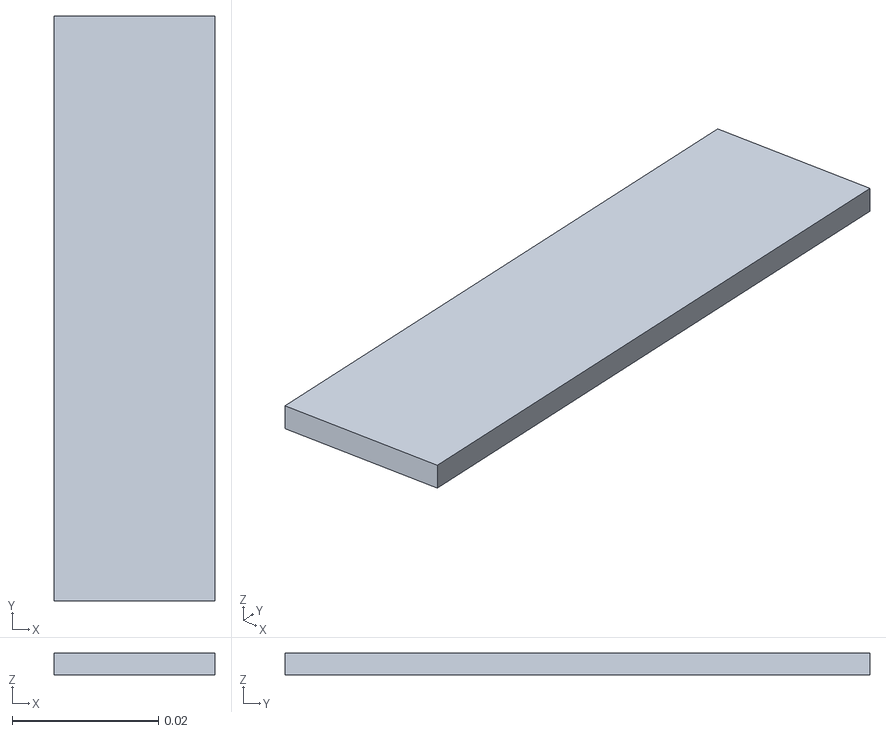
[picture p58: CAD file, 2026-11-02]
ros2_ws/src/description/meshes/electronics/jetson_ssd.obj
0.022 x 0.08 x 0.003
