jejeong5976/Project2_Turtle_Ninja/ros2_ws/src/description/meshes/swerve/wheel_fl.stl

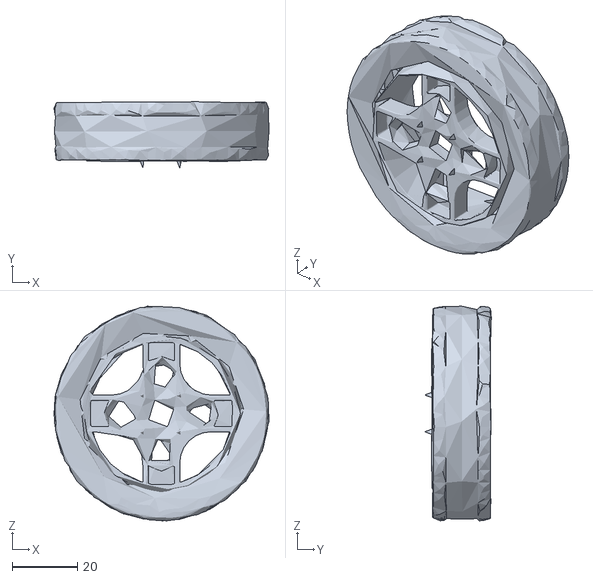
[picture p59: CAD file, 2026-10-21]
ros2_ws/src/description/meshes/swerve/wheel_fl.stl
66.1 x 20.5 x 66.0
