jejeong5976/Project2_Turtle_Ninja/ros2_ws/src/description/meshes/arm/wrist_camera_bracket_fixed.obj

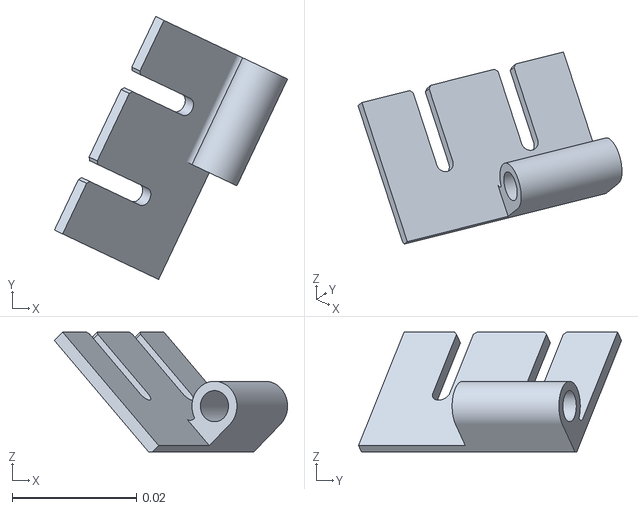
[picture p60: CAD file, 2026-11-02]
ros2_ws/src/description/meshes/arm/wrist_camera_bracket_fixed.obj
0.0375 x 0.0423 x 0.0193
