jejeong5976/Project2_Turtle_Ninja/ros2_ws/src/description/meshes/camera/bracket_cradle.obj

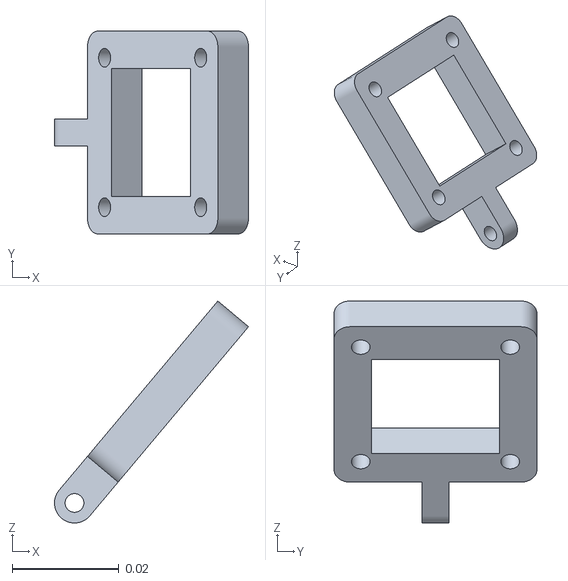
[picture p62: CAD file, 2026-11-02]
ros2_ws/src/description/meshes/camera/bracket_cradle.obj
0.0364 x 0.038 x 0.0416
