jejeong5976/Project2_Turtle_Ninja/ros2_ws/src/description/meshes/camera/collision/birdeye_lens.obj

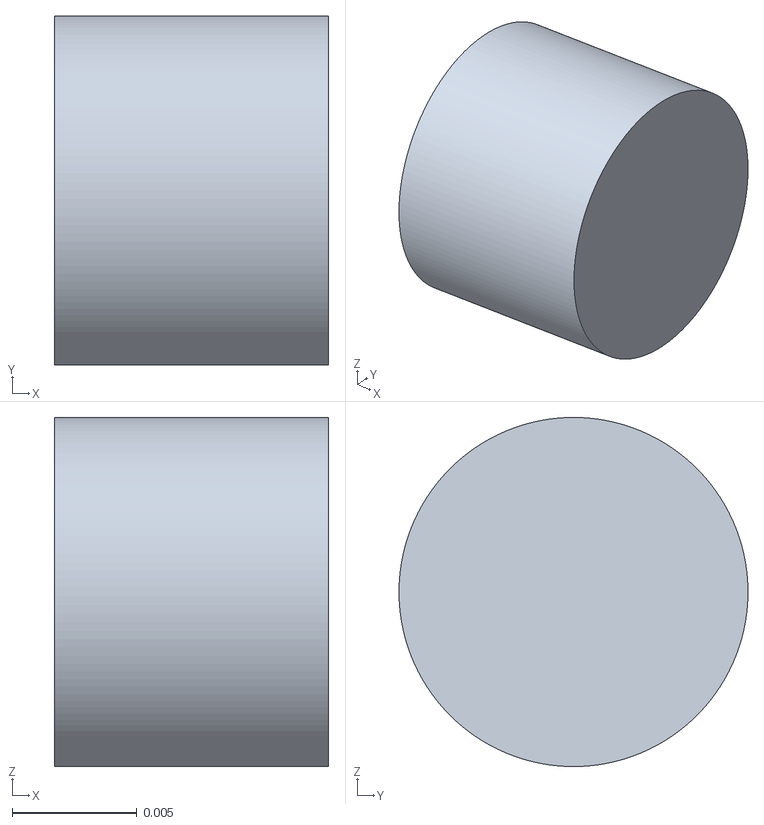
[picture p63: CAD file, 2026-11-02]
ros2_ws/src/description/meshes/camera/collision/birdeye_lens.obj
0.011 x 0.014 x 0.014
