jejeong5976/Project2_Turtle_Ninja/ros2_ws/src/description/meshes/electronics/battery_right.obj

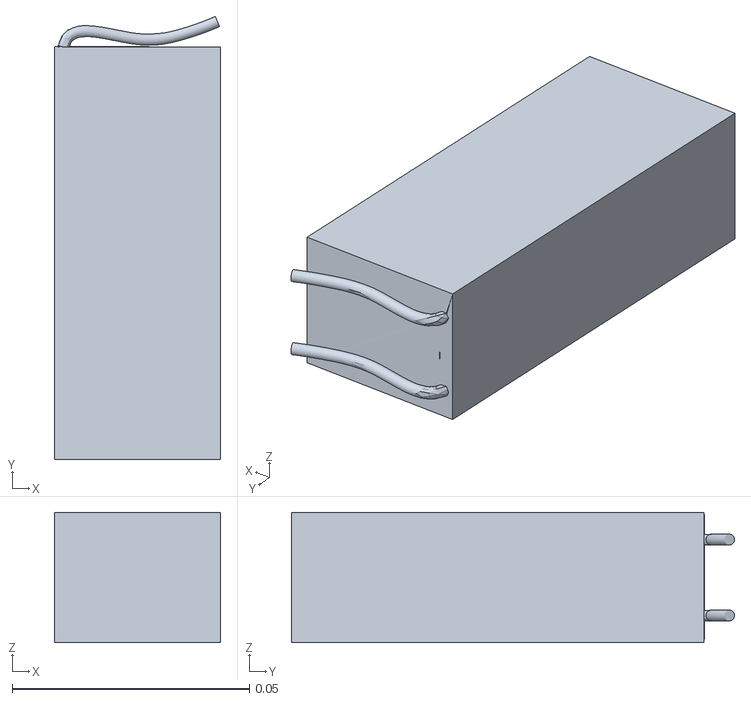
[picture p64: CAD file, 2026-11-02]
ros2_ws/src/description/meshes/electronics/battery_right.obj
0.035 x 0.0934 x 0.0275
