jejeong5976/Project2_Turtle_Ninja/ros2_ws/src/description/meshes/arm/collision/wrist_camera_bracket_fixed.obj

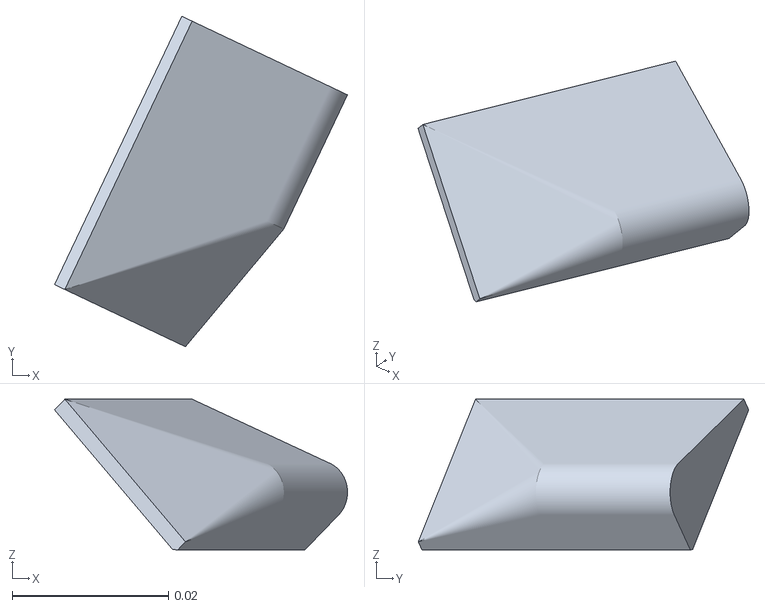
[picture p65: CAD file, 2026-11-02]
ros2_ws/src/description/meshes/arm/collision/wrist_camera_bracket_fixed.obj
0.0375 x 0.0423 x 0.0193
