jejeong5976/Project2_Turtle_Ninja/ros2_ws/src/description/meshes/arm/gripper_drive_crank.obj

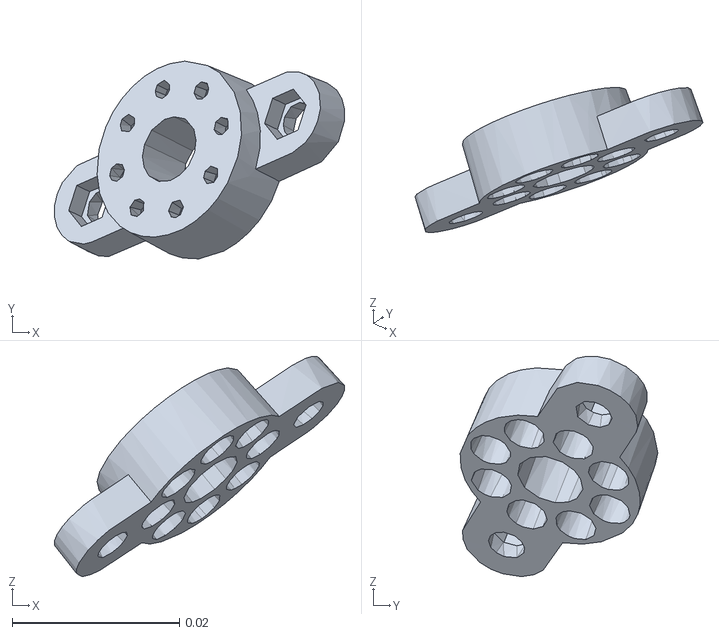
[picture p66: CAD file, 2026-11-02]
ros2_ws/src/description/meshes/arm/gripper_drive_crank.obj
0.0346 x 0.0236 x 0.0263
