jejeong5976/Project2_Turtle_Ninja/ros2_ws/src/description/meshes/base/hardware/m_pr07_a01_pin_3.obj

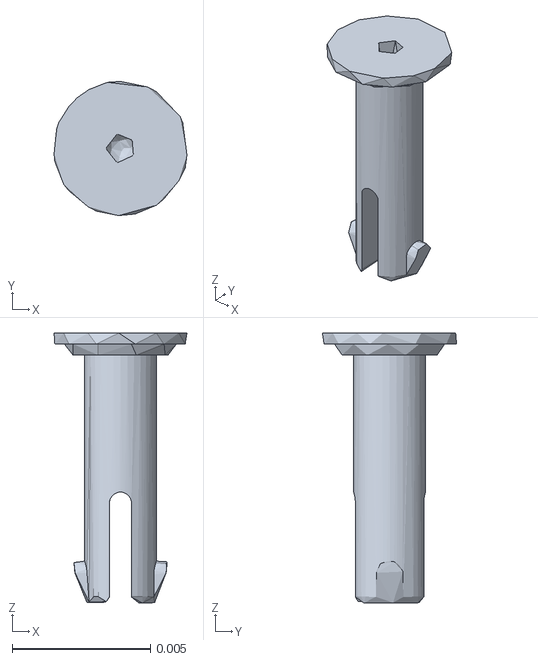
[picture p67: CAD file, 2026-11-02]
ros2_ws/src/description/meshes/base/hardware/m_pr07_a01_pin_3.obj
0.00481 x 0.00485 x 0.00976
