jejeong5976/Project2_Turtle_Ninja/ros2_ws/src/description/meshes/lidar/lds03_optics.obj

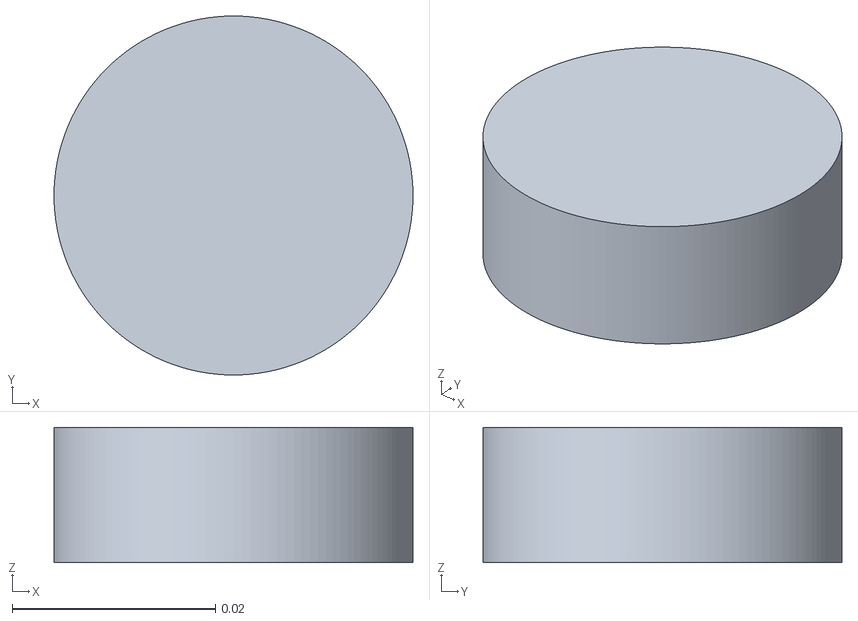
[picture p68: CAD file, 2026-11-02]
ros2_ws/src/description/meshes/lidar/lds03_optics.obj
0.0353 x 0.0353 x 0.0133
