jejeong5976/Project2_Turtle_Ninja/ros2_ws/src/description/meshes/arm/gripper_drive_pin.obj

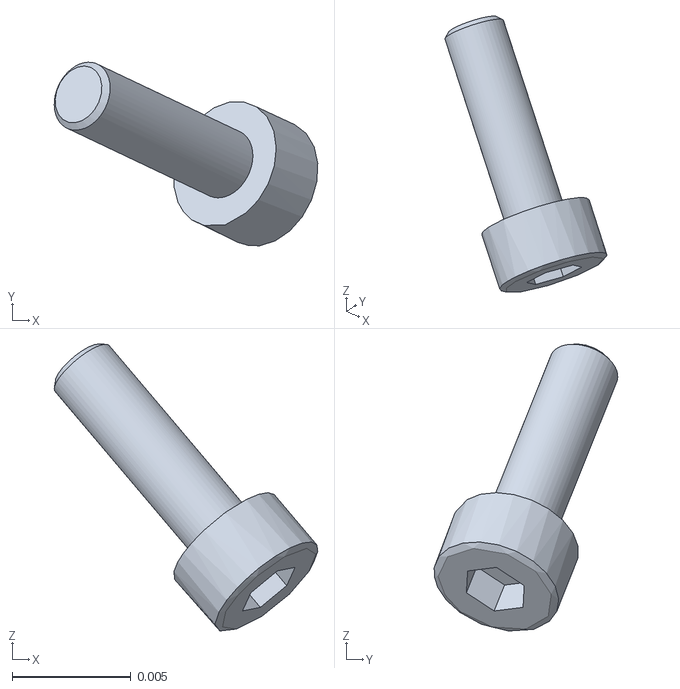
[picture p69: CAD file, 2026-11-02]
ros2_ws/src/description/meshes/arm/gripper_drive_pin.obj
0.0111 x 0.00775 x 0.0121
