jejeong5976/Project2_Turtle_Ninja/ros2_ws/src/description/meshes/base/hardware/phs_m2x6.obj

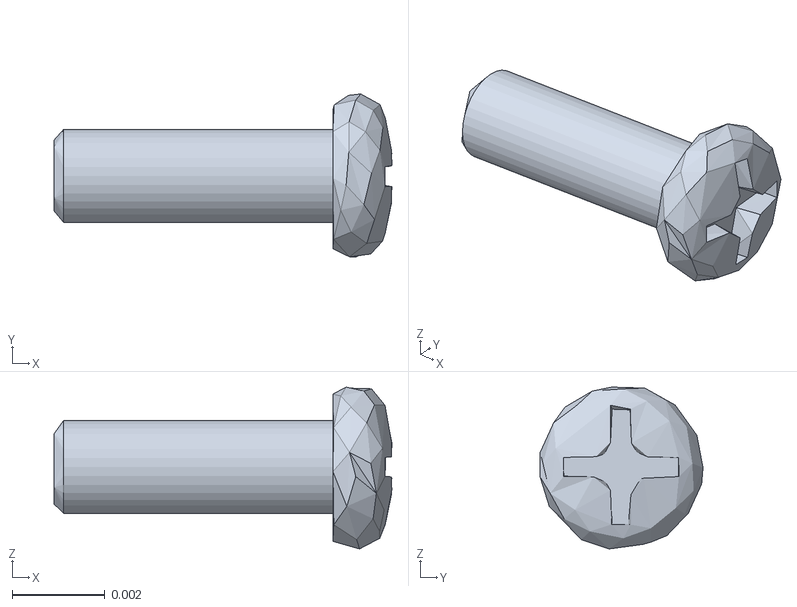
[picture p70: CAD file, 2026-11-02]
ros2_ws/src/description/meshes/base/hardware/phs_m2x6.obj
0.00728 x 0.00351 x 0.00349
