jejeong5976/Project2_Turtle_Ninja/ros2_ws/src/description/meshes/camera/collision/birdeye_lens_seat.obj

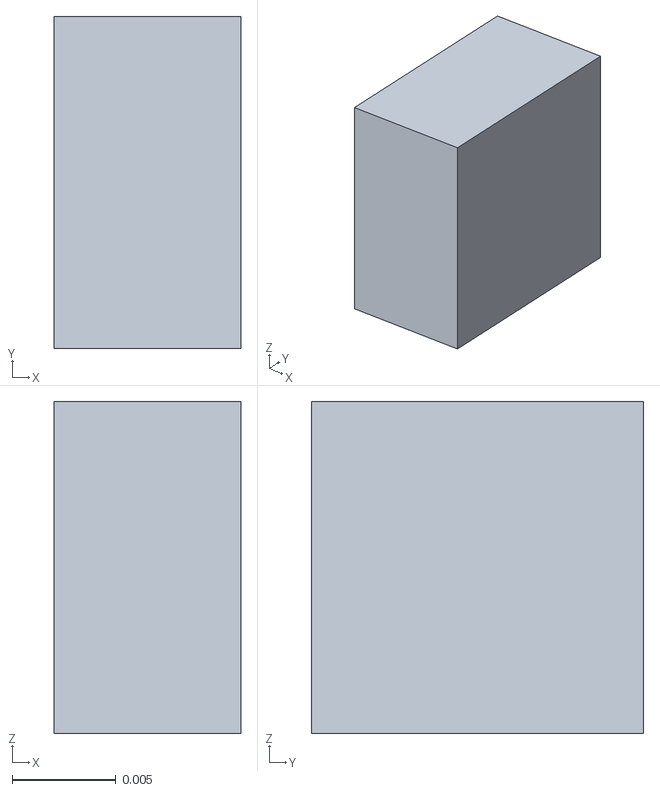
[picture p71: CAD file, 2026-11-02]
ros2_ws/src/description/meshes/camera/collision/birdeye_lens_seat.obj
0.009 x 0.016 x 0.016
