jejeong5976/Project2_Turtle_Ninja/ros2_ws/src/description/meshes/camera/wrist_d435.obj

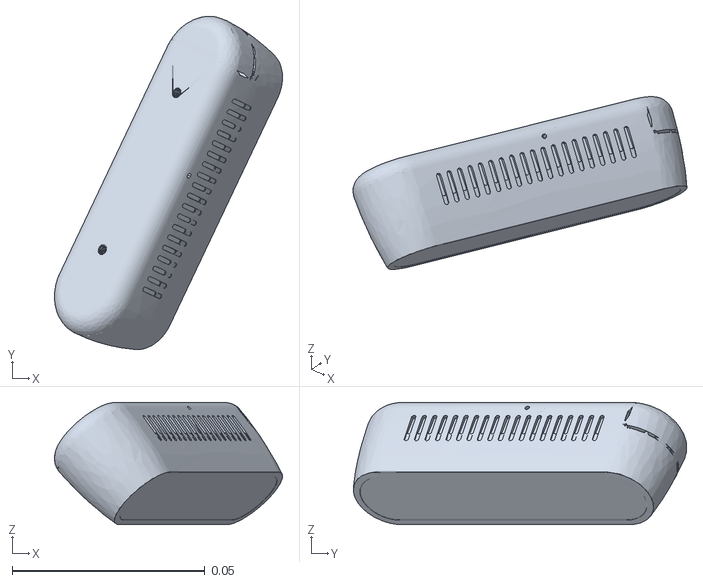
[picture p72: CAD file, 2026-11-02]
ros2_ws/src/description/meshes/camera/wrist_d435.obj
0.0591 x 0.0864 x 0.0317
