jejeong5976/Project2_Turtle_Ninja/ros2_ws/src/description/meshes/arm/collision/wrist_irb_a02_open_1.obj

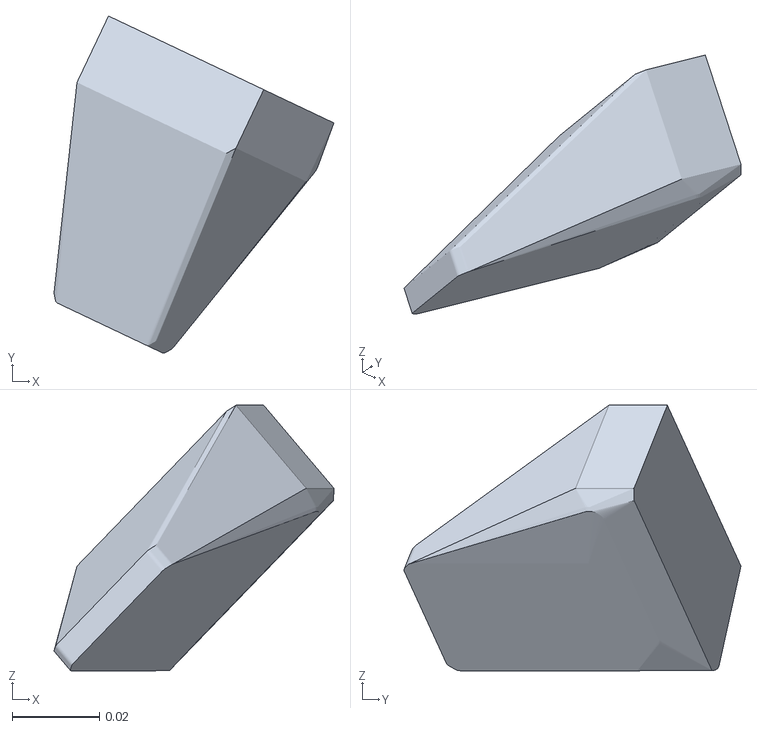
[picture p73: CAD file, 2026-11-02]
ros2_ws/src/description/meshes/arm/collision/wrist_irb_a02_open_1.obj
0.064 x 0.077 x 0.0607
