jejeong5976/Project2_Turtle_Ninja/ros2_ws/src/description/meshes/arm/wrist_camera_bracket_carrier.obj

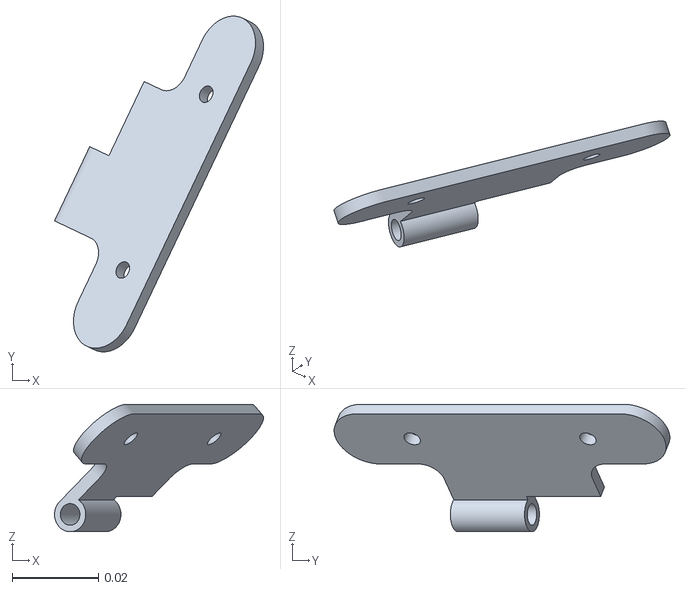
[picture p74: CAD file, 2026-11-02]
ros2_ws/src/description/meshes/arm/wrist_camera_bracket_carrier.obj
0.0483 x 0.0777 x 0.0295
