jejeong5976/Project2_Turtle_Ninja/ros2_ws/src/description/meshes/base/hardware/nut2_m2_5.obj

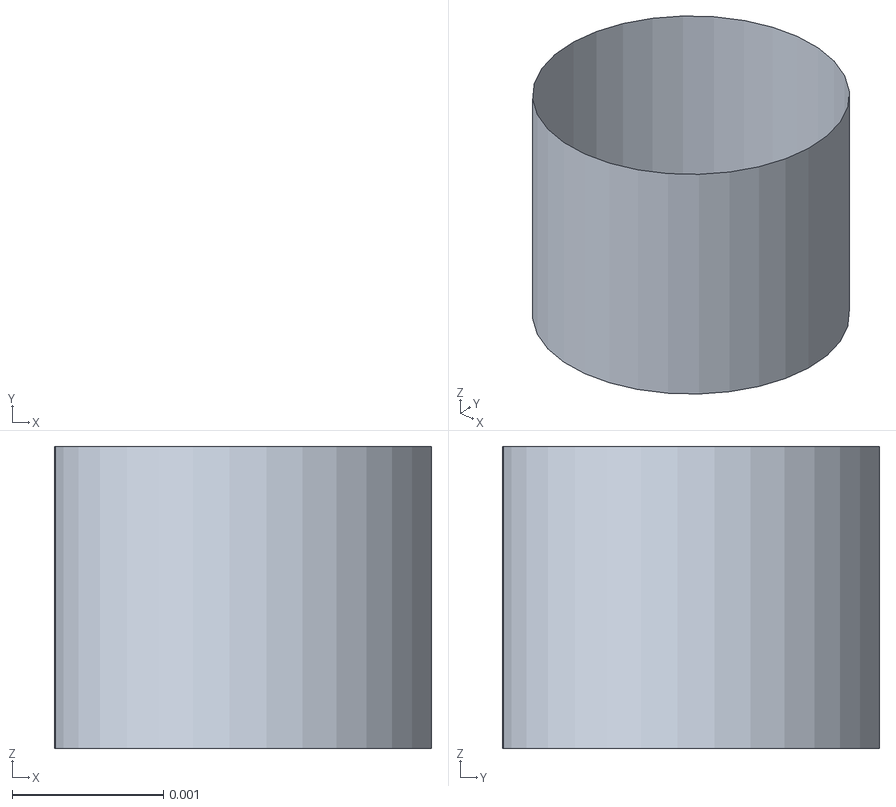
[picture p75: CAD file, 2026-11-02]
ros2_ws/src/description/meshes/base/hardware/nut2_m2_5.obj
0.00249 x 0.00249 x 0.002
