jejeong5976/Project2_Turtle_Ninja/ros2_ws/src/description/meshes/electronics/jetson_module.obj

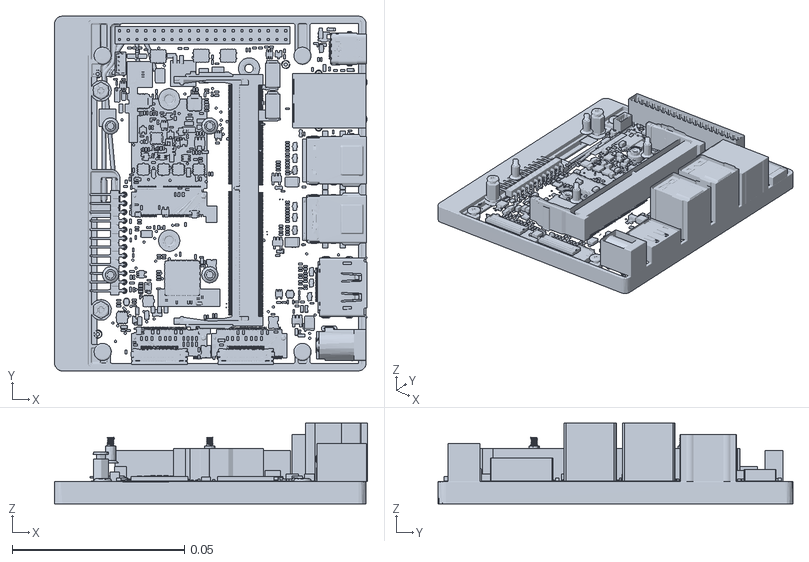
[picture p76: CAD file, 2026-11-02]
ros2_ws/src/description/meshes/electronics/jetson_module.obj
0.0909 x 0.103 x 0.0234
