jejeong5976/Project2_Turtle_Ninja/ros2_ws/src/description/meshes/arm/collision/finger_right_049.obj

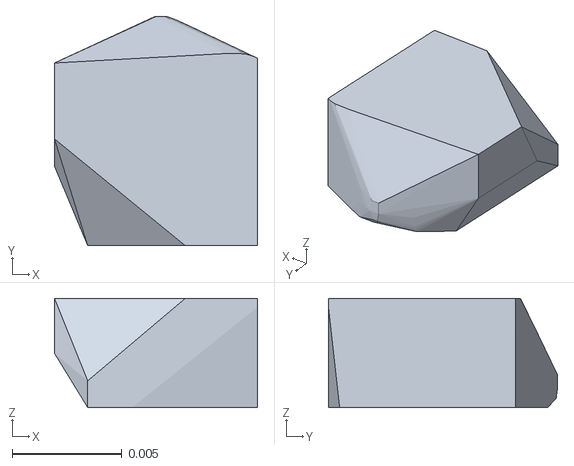
[picture p77: CAD file, 2026-11-02]
ros2_ws/src/description/meshes/arm/collision/finger_right_049.obj
0.00923 x 0.0104 x 0.00496
