jejeong5976/Project2_Turtle_Ninja/ros2_ws/src/description/meshes/arm/gripper_link_right.obj

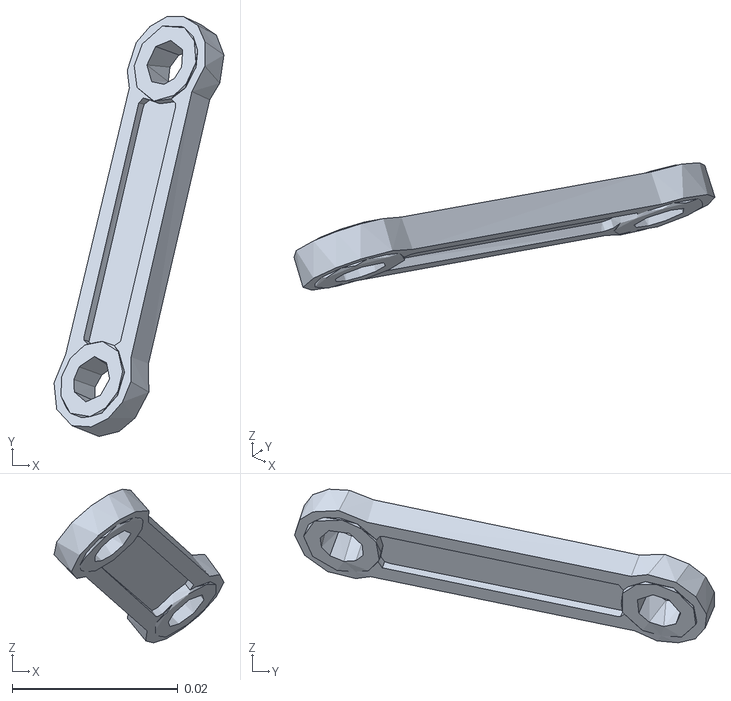
[picture p78: CAD file, 2026-11-02]
ros2_ws/src/description/meshes/arm/gripper_link_right.obj
0.0205 x 0.0507 x 0.0185
