jejeong5976/Project2_Turtle_Ninja/ros2_ws/src/description/meshes/base/hardware/camera_stand.obj

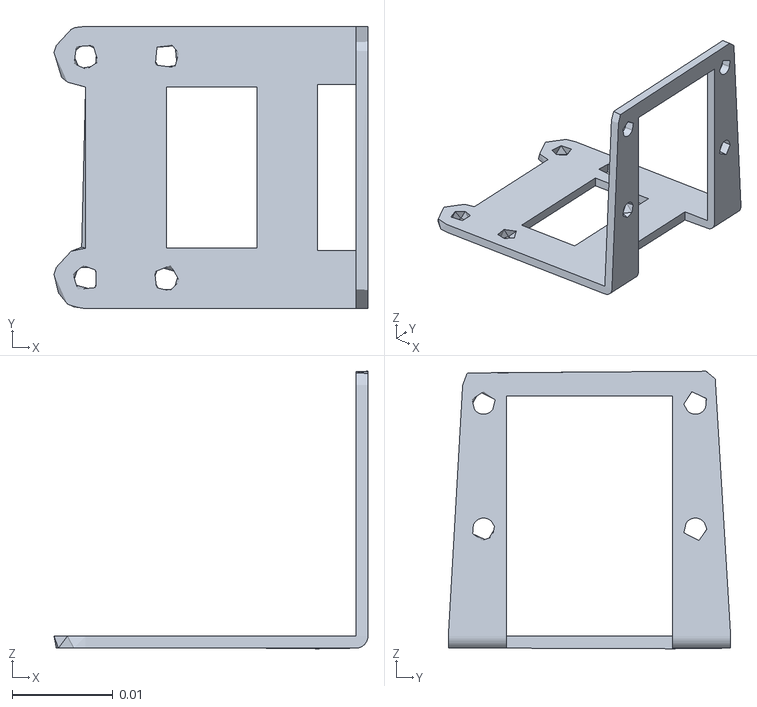
[picture p79: CAD file, 2026-11-02]
ros2_ws/src/description/meshes/base/hardware/camera_stand.obj
0.0311 x 0.028 x 0.0275
