jejeong5976/Project2_Turtle_Ninja/ros2_ws/src/description/meshes/electronics/jetson_ssd_mount.obj

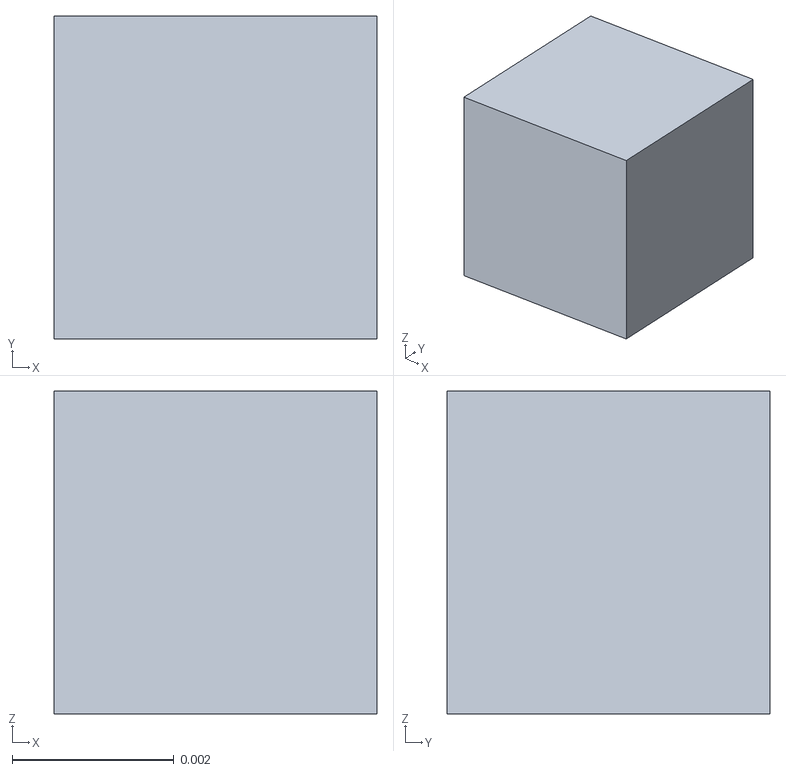
[picture p80: CAD file, 2026-11-02]
ros2_ws/src/description/meshes/electronics/jetson_ssd_mount.obj
0.004 x 0.004 x 0.004
