jejeong5976/Project2_Turtle_Ninja/ros2_ws/src/description/meshes/arm/collision/finger_left_044.obj

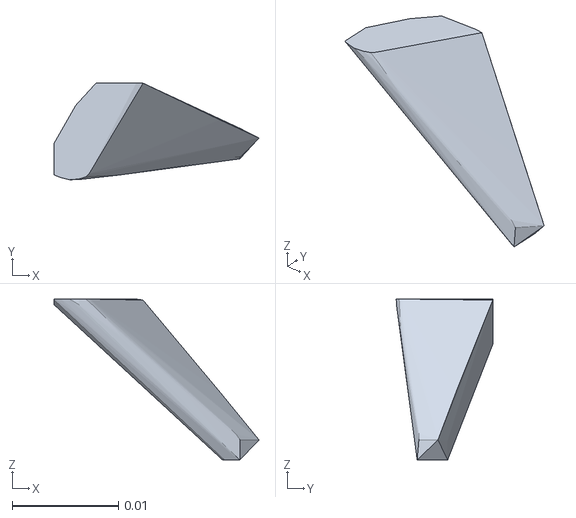
[picture p81: CAD file, 2026-11-02]
ros2_ws/src/description/meshes/arm/collision/finger_left_044.obj
0.0193 x 0.00908 x 0.0151
