jejeong5976/Project2_Turtle_Ninja/ros2_ws/src/description/meshes/base/hardware/nut2_m3.obj

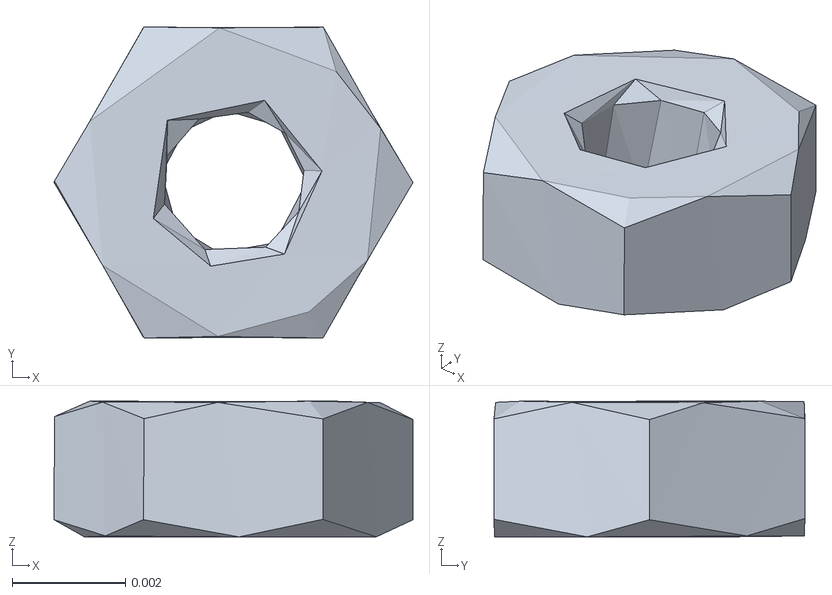
[picture p82: CAD file, 2026-11-02]
ros2_ws/src/description/meshes/base/hardware/nut2_m3.obj
0.00635 x 0.0055 x 0.0024
