jejeong5976/Project2_Turtle_Ninja/ros2_ws/src/description/meshes/electronics/jetson_heatsink.obj

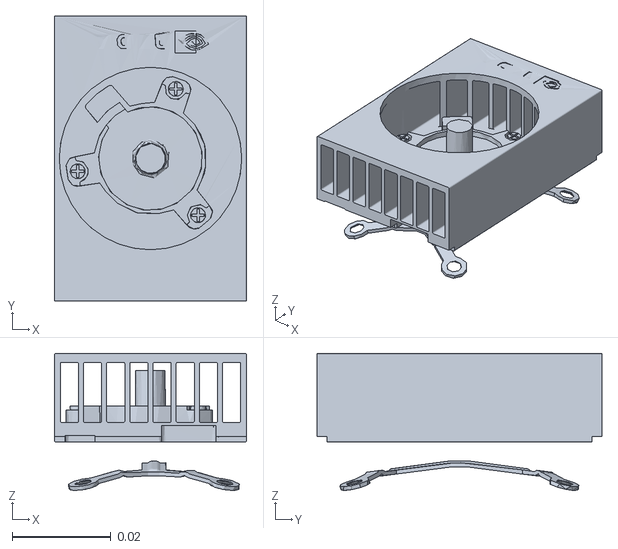
[picture p83: CAD file, 2026-11-02]
ros2_ws/src/description/meshes/electronics/jetson_heatsink.obj
0.039 x 0.0578 x 0.0278
