jejeong5976/Project2_Turtle_Ninja/ros2_ws/src/description/meshes/arm/collision/finger_right_091.obj

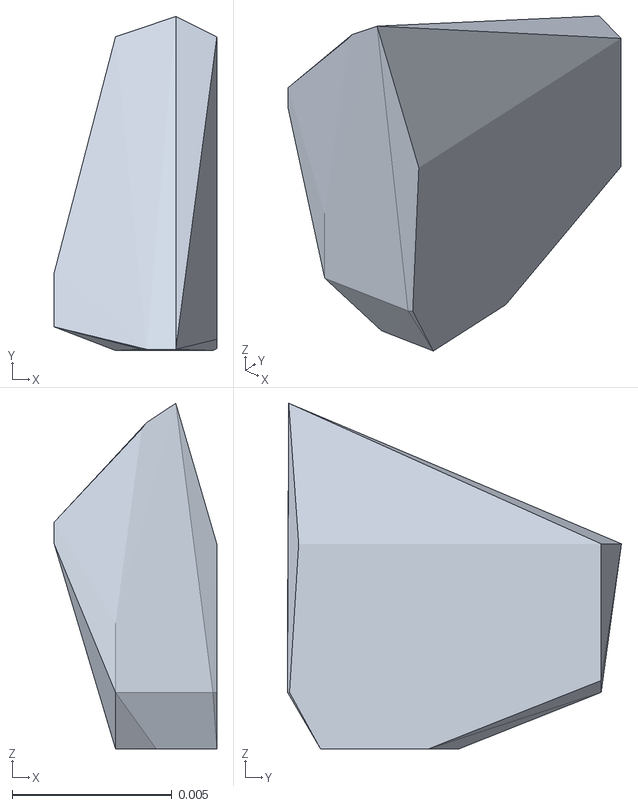
[picture p84: CAD file, 2026-11-02]
ros2_ws/src/description/meshes/arm/collision/finger_right_091.obj
0.00509 x 0.0105 x 0.0108
