jejeong5976/Project2_Turtle_Ninja/ros2_ws/src/description/meshes/arm/link1_motor.obj

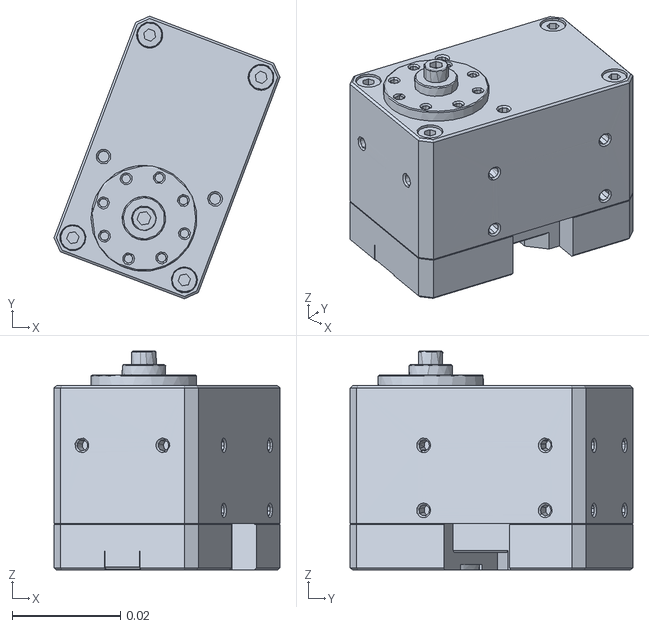
[picture p85: CAD file, 2026-11-02]
ros2_ws/src/description/meshes/arm/link1_motor.obj
0.0417 x 0.0522 x 0.0404
