jejeong5976/Project2_Turtle_Ninja/ros2_ws/src/description/meshes/base/hardware/m_pr07_a01_bracket_2_2.obj

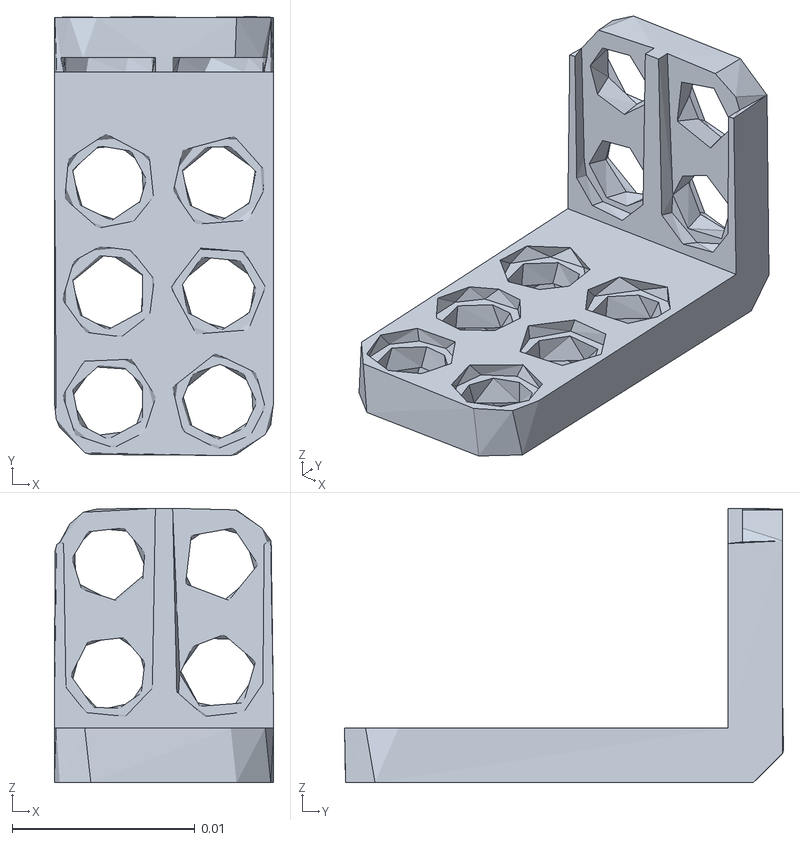
[picture p86: CAD file, 2026-11-02]
ros2_ws/src/description/meshes/base/hardware/m_pr07_a01_bracket_2_2.obj
0.012 x 0.024 x 0.015
