jejeong5976/Project2_Turtle_Ninja/ros2_ws/src/description/meshes/electronics/jetson_fan.obj

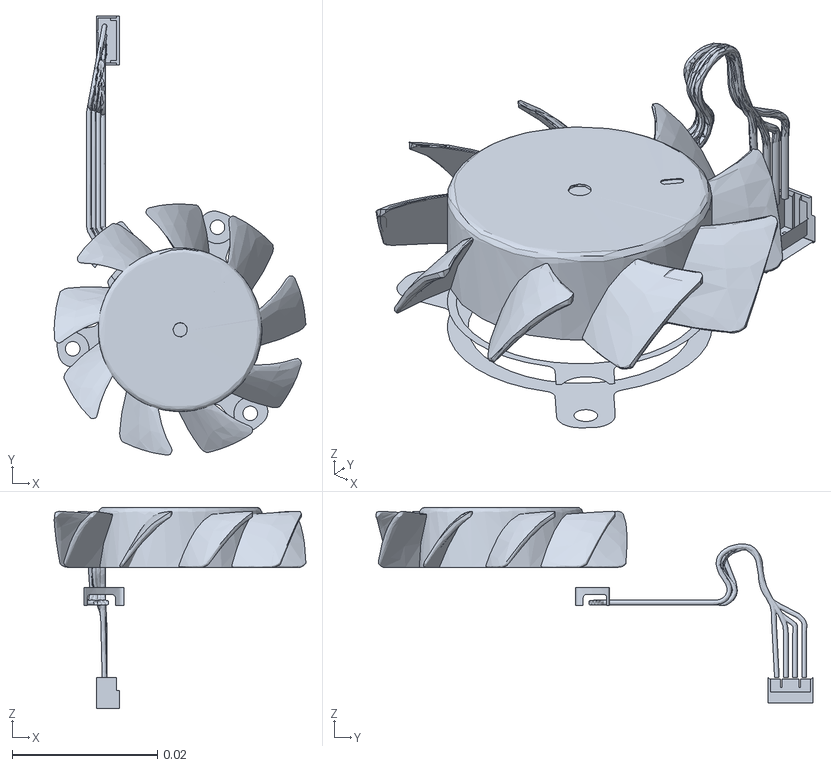
[picture p87: CAD file, 2026-11-02]
ros2_ws/src/description/meshes/electronics/jetson_fan.obj
0.0346 x 0.0604 x 0.0277
