jejeong5976/Project2_Turtle_Ninja/ros2_ws/src/description/meshes/arm/collision/finger_left_090.obj

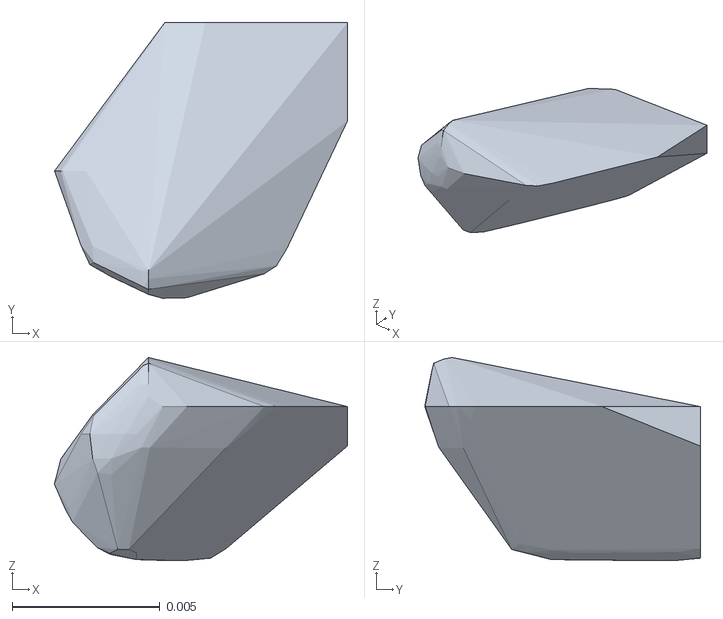
[picture p88: CAD file, 2026-11-02]
ros2_ws/src/description/meshes/arm/collision/finger_left_090.obj
0.00993 x 0.00934 x 0.00688
