jejeong5976/Project2_Turtle_Ninja/ros2_ws/src/description/meshes/arm/collision/finger_left_081.obj

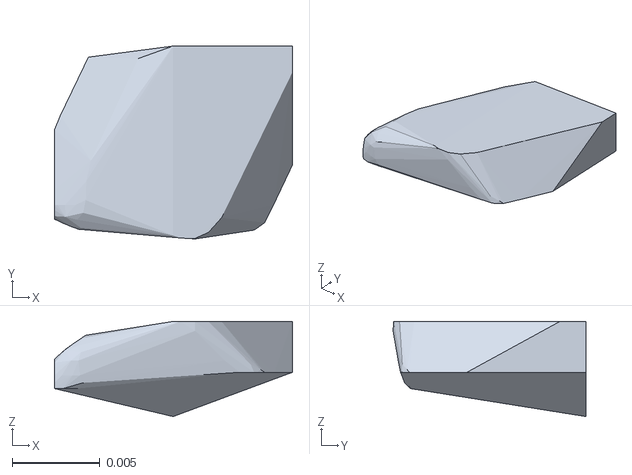
[picture p90: CAD file, 2026-11-02]
ros2_ws/src/description/meshes/arm/collision/finger_left_081.obj
0.0135 x 0.011 x 0.00541
