jejeong5976/Project2_Turtle_Ninja/ros2_ws/src/description/meshes/arm/finger_left.obj

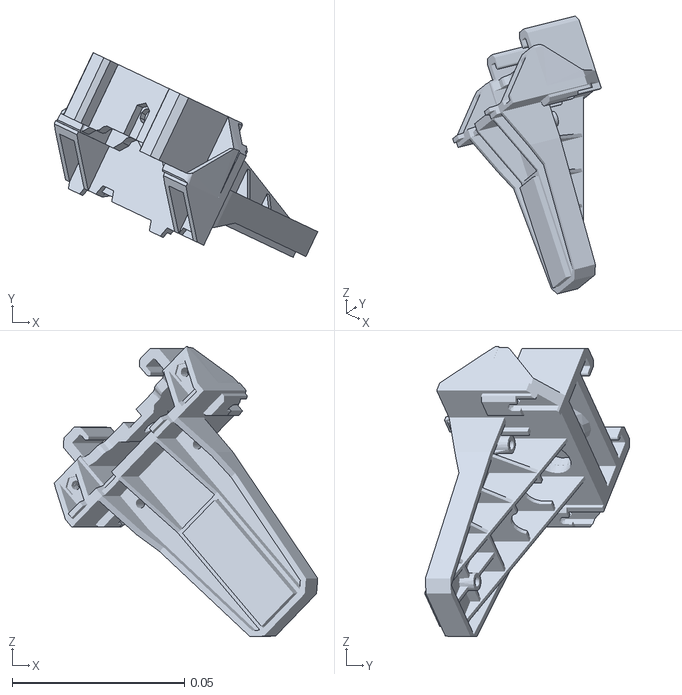
[picture p91: CAD file, 2026-11-02]
ros2_ws/src/description/meshes/arm/finger_left.obj
0.0764 x 0.0594 x 0.0841
