jejeong5976/Project2_Turtle_Ninja/ros2_ws/src/description/meshes/base/hardware/phs_m2_5x8.obj

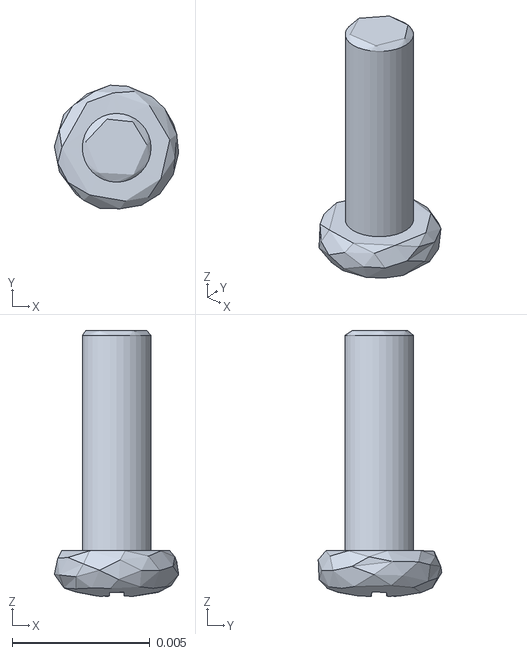
[picture p92: CAD file, 2026-11-02]
ros2_ws/src/description/meshes/base/hardware/phs_m2_5x8.obj
0.00452 x 0.0045 x 0.00967
