jejeong5976/Project2_Turtle_Ninja/ros2_ws/src/description/meshes/arm/collision/finger_right_009.obj

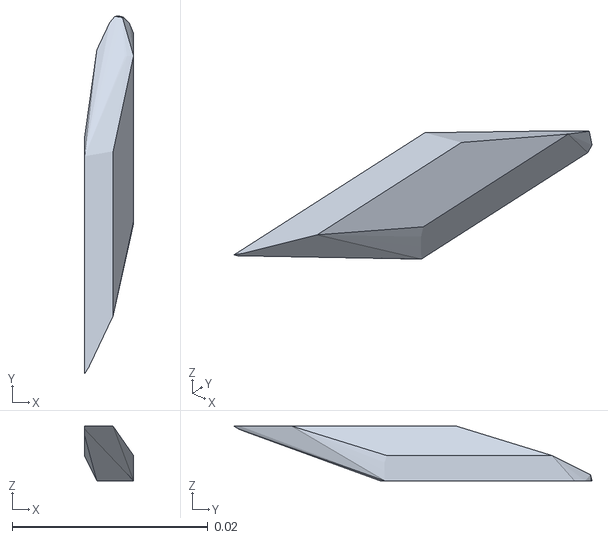
[picture p93: CAD file, 2026-11-02]
ros2_ws/src/description/meshes/arm/collision/finger_right_009.obj
0.00503 x 0.0366 x 0.00558
