jejeong5976/Project2_Turtle_Ninja/ros2_ws/src/description/meshes/arm/link4_frame.obj

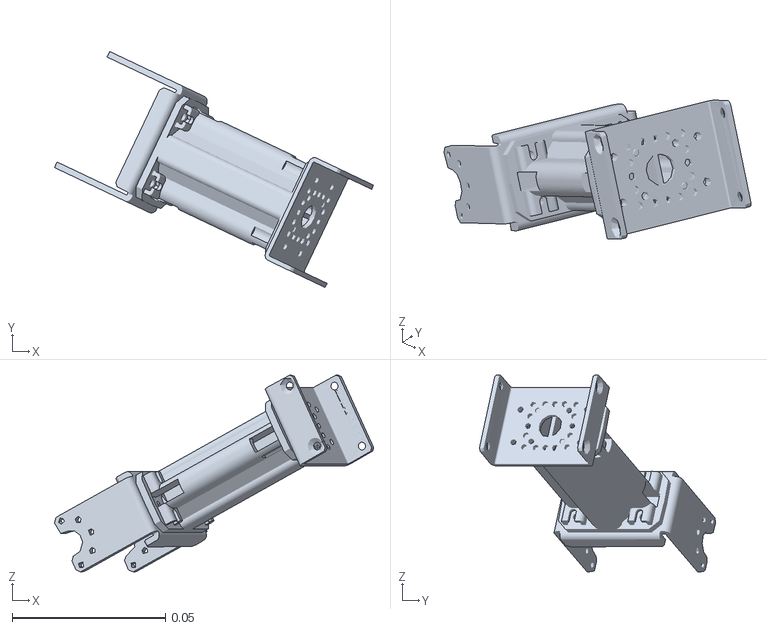
[picture p94: CAD file, 2026-11-02]
ros2_ws/src/description/meshes/arm/link4_frame.obj
0.104 x 0.0771 x 0.0643
