jejeong5976/Project2_Turtle_Ninja/ros2_ws/src/description/meshes/base/hardware/phs_m2_5x12_1.obj

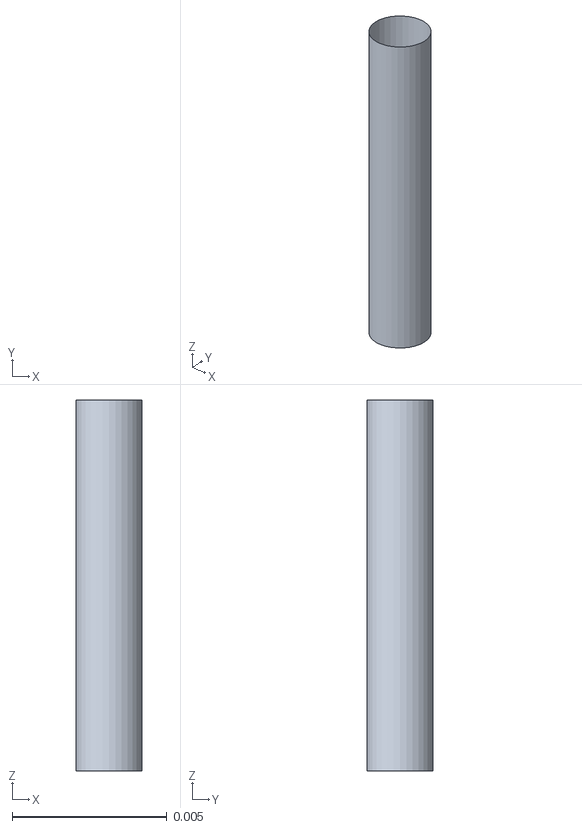
[picture p95: CAD file, 2026-11-02]
ros2_ws/src/description/meshes/base/hardware/phs_m2_5x12_1.obj
0.00215 x 0.00215 x 0.012
