jejeong5976/Project2_Turtle_Ninja/ros2_ws/src/description/meshes/arm/collision/finger_right_067.obj

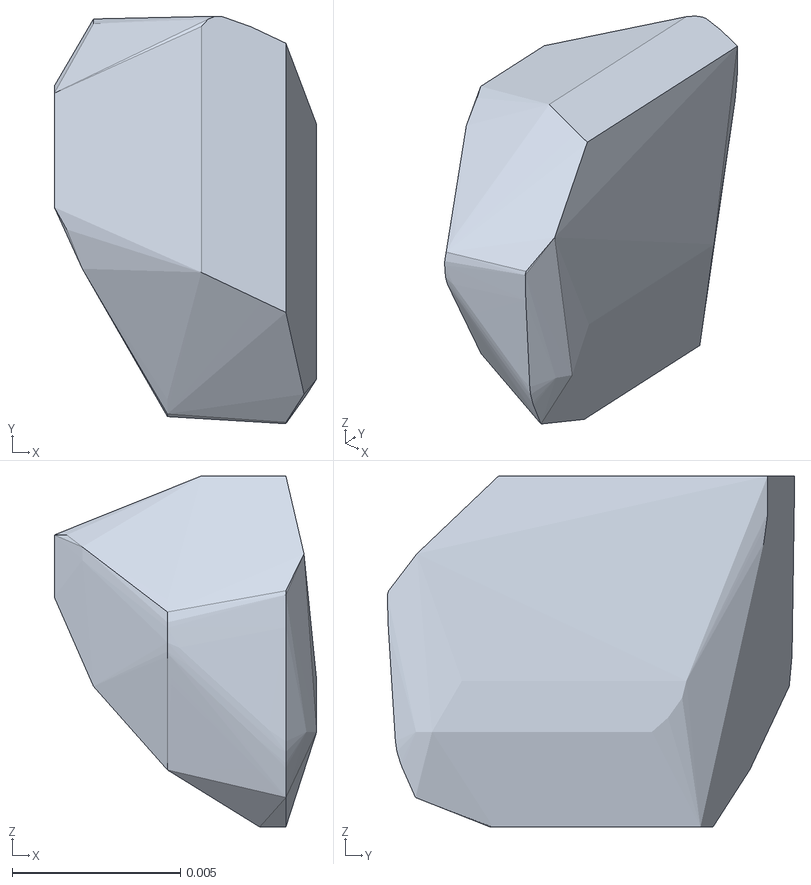
[picture p96: CAD file, 2026-11-02]
ros2_ws/src/description/meshes/arm/collision/finger_right_067.obj
0.0078 x 0.0121 x 0.0104
