jejeong5976/Project2_Turtle_Ninja/ros2_ws/src/description/meshes/arm/link3_frame.obj

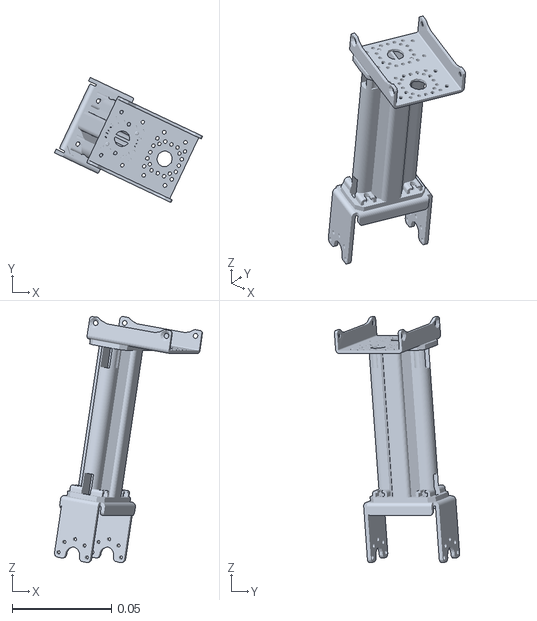
[picture p97: CAD file, 2026-11-02]
ros2_ws/src/description/meshes/arm/link3_frame.obj
0.0745 x 0.063 x 0.124
