jejeong5976/Project2_Turtle_Ninja/ros2_ws/src/description/meshes/arm/collision/finger_left_008.obj

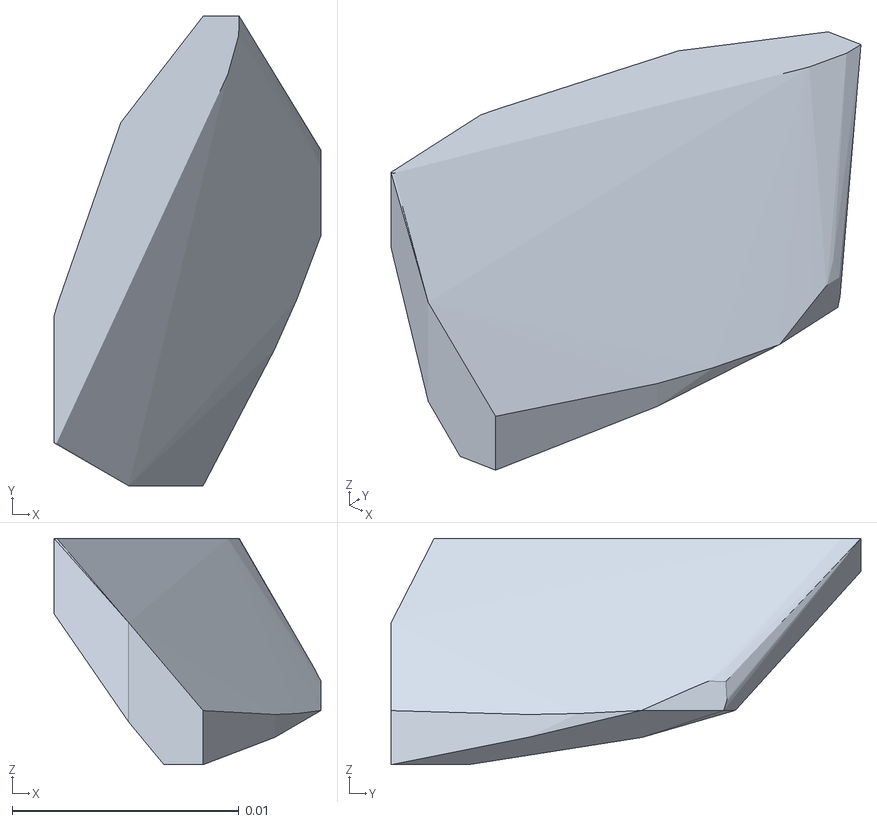
[picture p98: CAD file, 2026-11-02]
ros2_ws/src/description/meshes/arm/collision/finger_left_008.obj
0.0118 x 0.0207 x 0.00998
