jejeong5976/Project2_Turtle_Ninja/ros2_ws/src/description/meshes/arm/link3_motor.obj

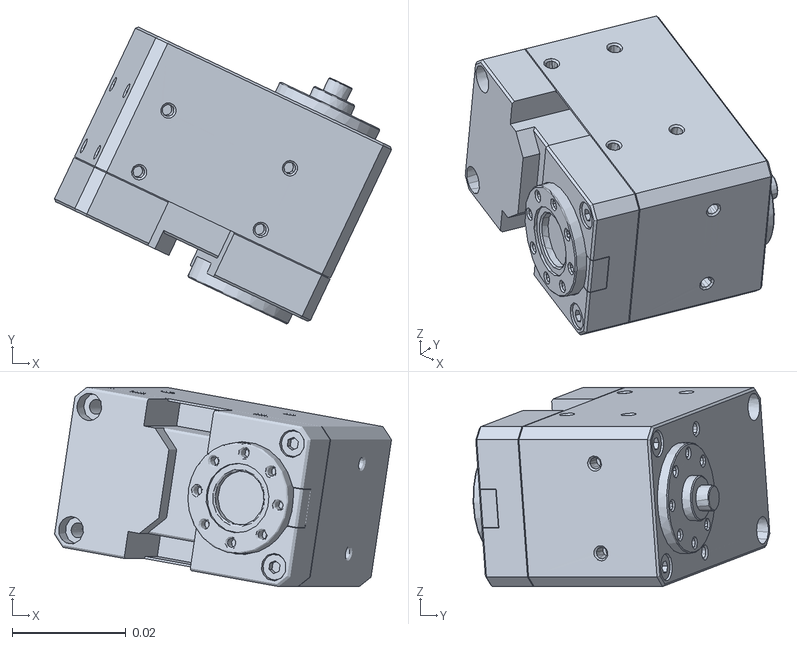
[picture p99: CAD file, 2026-11-02]
ros2_ws/src/description/meshes/arm/link3_motor.obj
0.0593 x 0.0522 x 0.035
