jejeong5976/Project2_Turtle_Ninja/ros2_ws/src/description/meshes/base/hardware/space_ring.obj

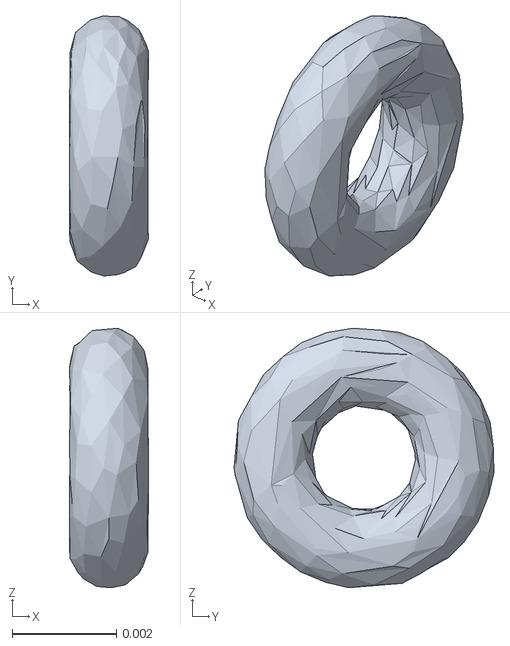
[picture p100: CAD file, 2026-11-02]
ros2_ws/src/description/meshes/base/hardware/space_ring.obj
0.00152 x 0.00499 x 0.00498
