jejeong5976/Project2_Turtle_Ninja/ros2_ws/src/description/meshes/arm/collision/wrist_part_1_2.obj

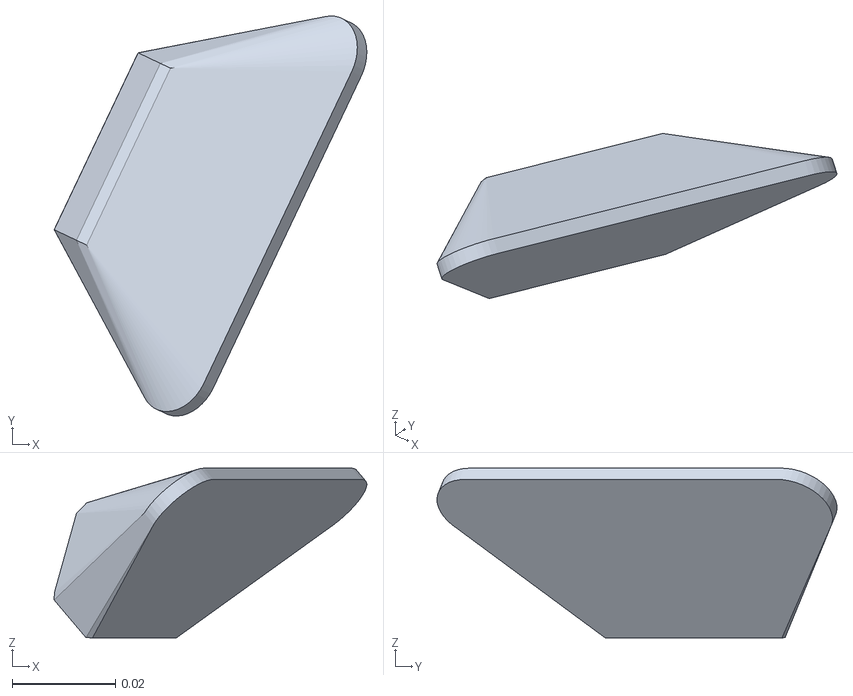
[picture p101: CAD file, 2026-11-02]
ros2_ws/src/description/meshes/arm/collision/wrist_part_1_2.obj
0.0607 x 0.0777 x 0.0329
