jejeong5976/Project2_Turtle_Ninja/ros2_ws/src/description/meshes/arm/link2_motor.obj

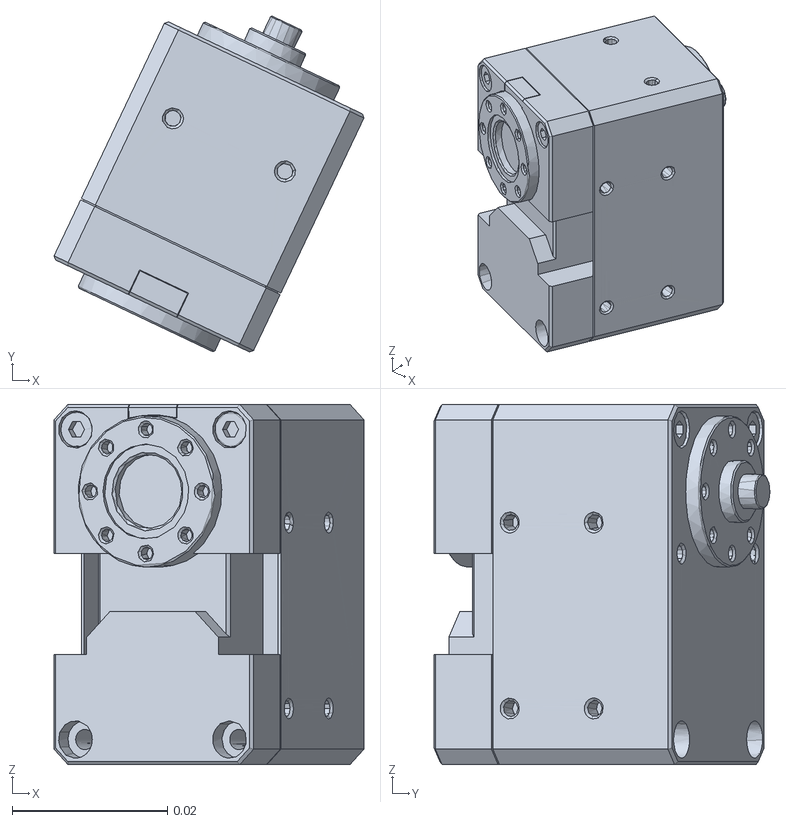
[picture p102: CAD file, 2026-11-02]
ros2_ws/src/description/meshes/arm/link2_motor.obj
0.04 x 0.0433 x 0.0465
