jejeong5976/Project2_Turtle_Ninja/ros2_ws/src/description/meshes/base/hardware/nut2_m2_1.obj

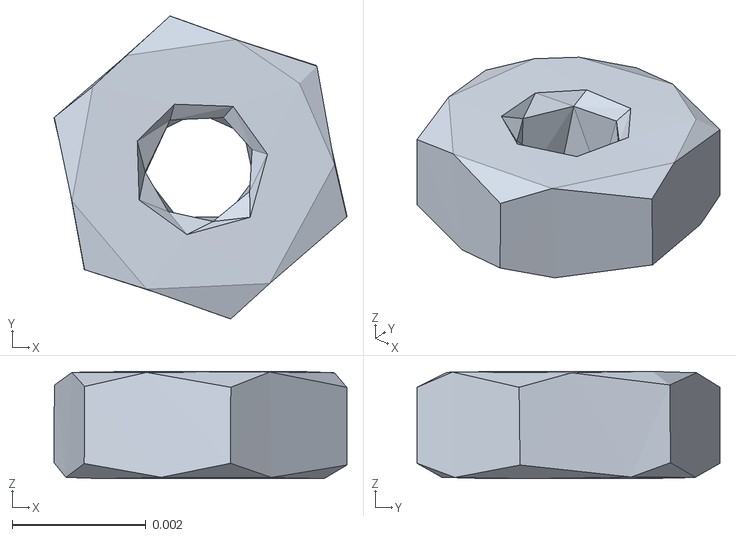
[picture p103: CAD file, 2026-11-02]
ros2_ws/src/description/meshes/base/hardware/nut2_m2_1.obj
0.00438 x 0.00453 x 0.0016
