jejeong5976/Project2_Turtle_Ninja/ros2_ws/src/description/meshes/arm/collision/finger_right_045.obj

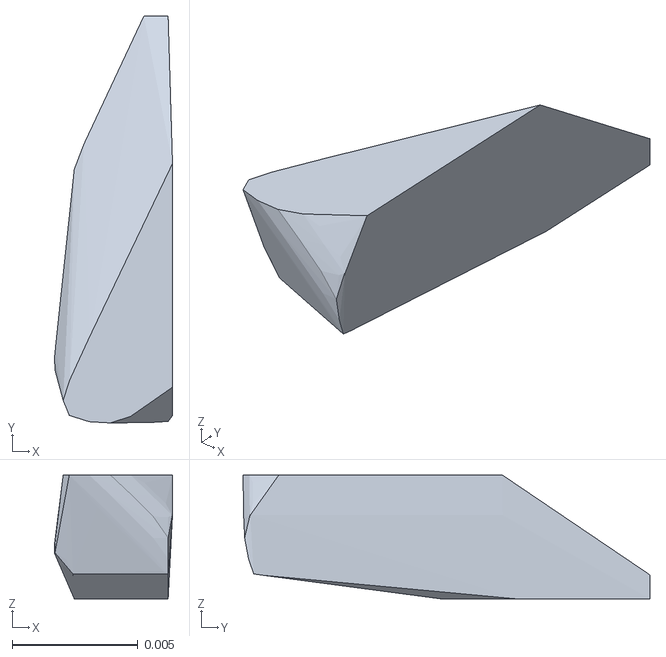
[picture p104: CAD file, 2026-11-02]
ros2_ws/src/description/meshes/arm/collision/finger_right_045.obj
0.00469 x 0.0162 x 0.00492
