jejeong5976/Project2_Turtle_Ninja/ros2_ws/src/description/meshes/arm/link2_frame.obj

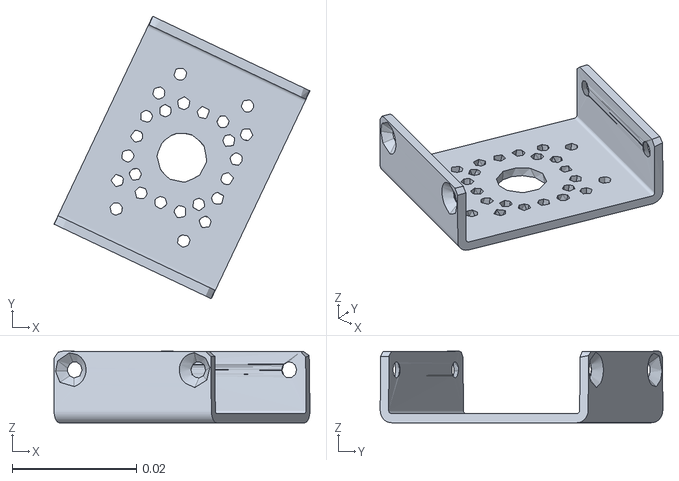
[picture p105: CAD file, 2026-11-02]
ros2_ws/src/description/meshes/arm/link2_frame.obj
0.0412 x 0.0454 x 0.0115
