jejeong5976/Project2_Turtle_Ninja/ros2_ws/src/description/meshes/arm/collision/finger_left_037.obj

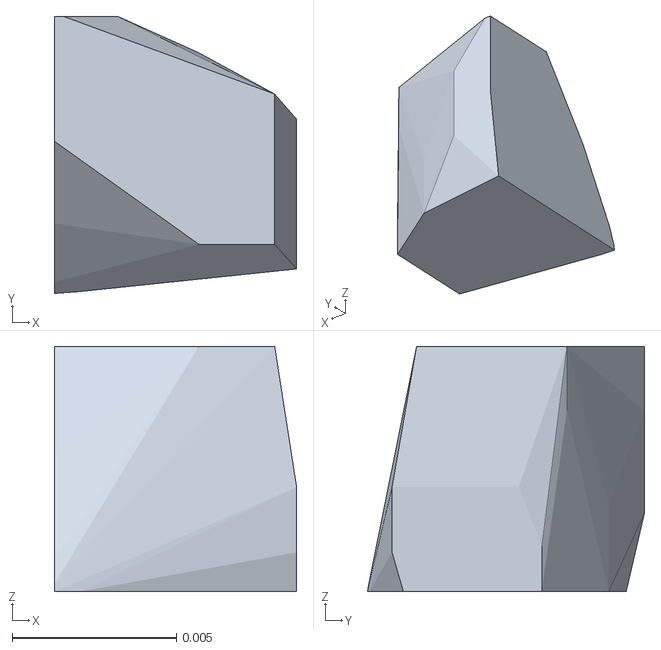
[picture p106: CAD file, 2026-11-02]
ros2_ws/src/description/meshes/arm/collision/finger_left_037.obj
0.00738 x 0.00843 x 0.00747
