jejeong5976/Project2_Turtle_Ninja/ros2_ws/src/description/meshes/base/hardware/pi_camera_2_1.obj

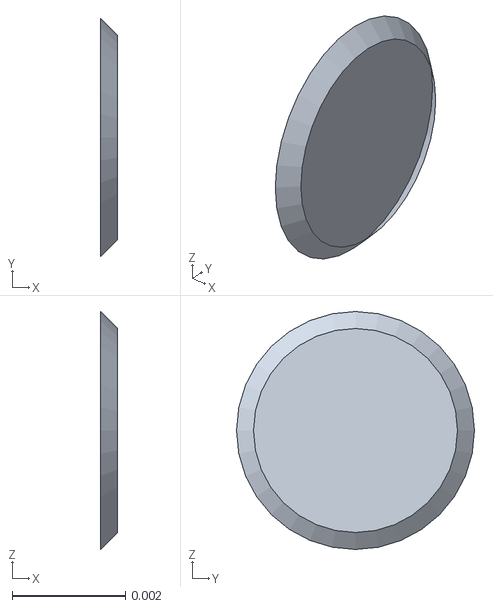
[picture p107: CAD file, 2026-11-02]
ros2_ws/src/description/meshes/base/hardware/pi_camera_2_1.obj
0.0003 x 0.0042 x 0.0042
