jejeong5976/Project2_Turtle_Ninja/ros2_ws/src/description/meshes/arm/collision/finger_right_001.obj

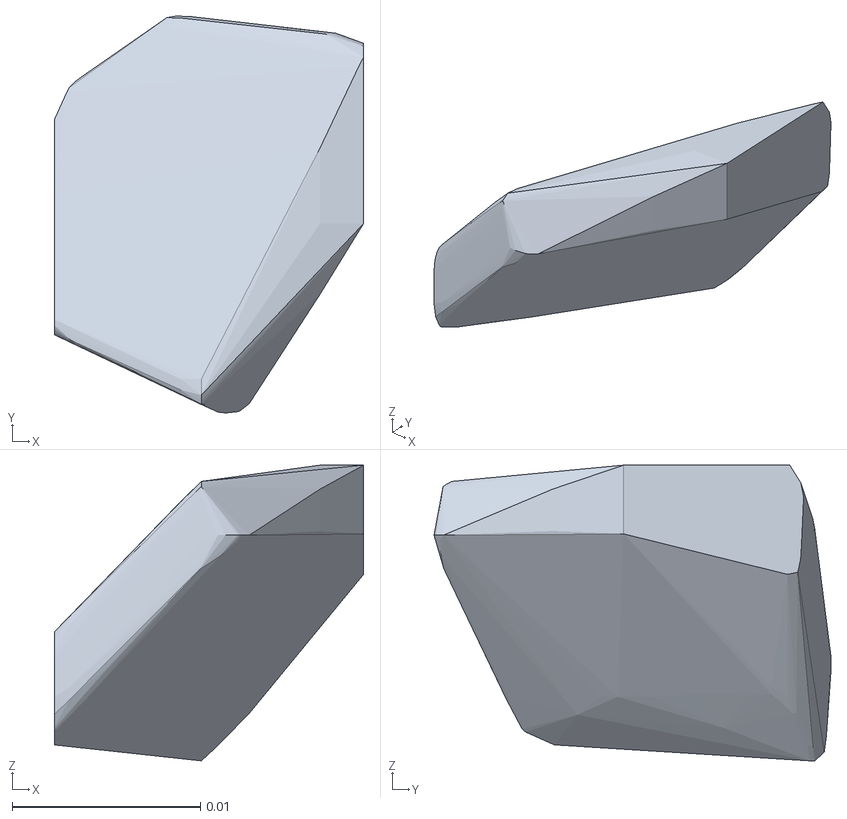
[picture p108: CAD file, 2026-11-02]
ros2_ws/src/description/meshes/arm/collision/finger_right_001.obj
0.0164 x 0.0211 x 0.0157
