jejeong5976/Project2_Turtle_Ninja/ros2_ws/src/description/meshes/arm/finger_right.obj

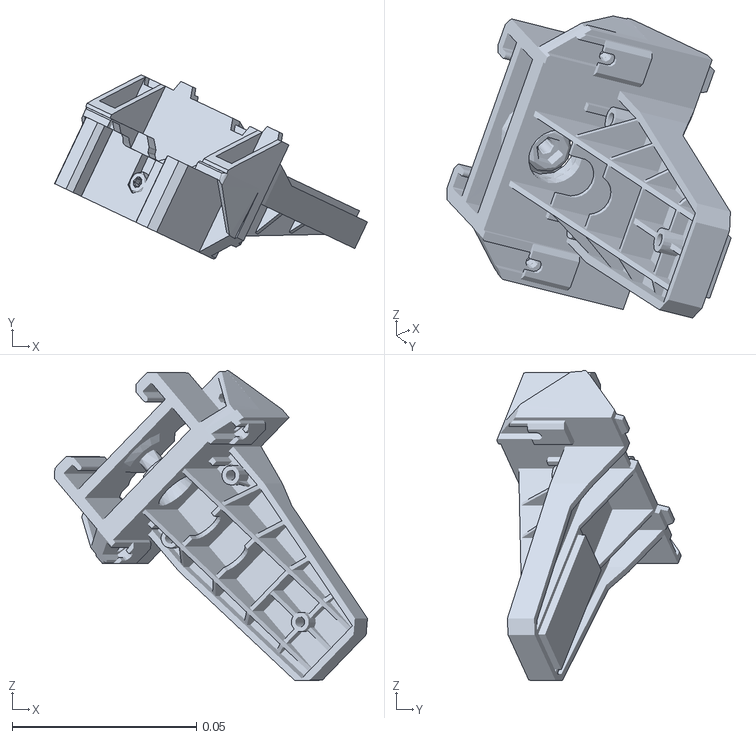
[picture p109: CAD file, 2026-11-02]
ros2_ws/src/description/meshes/arm/finger_right.obj
0.0849 x 0.05 x 0.0841
