jejeong5976/Project2_Turtle_Ninja/ros2_ws/src/description/meshes/arm/collision/finger_left_017.obj

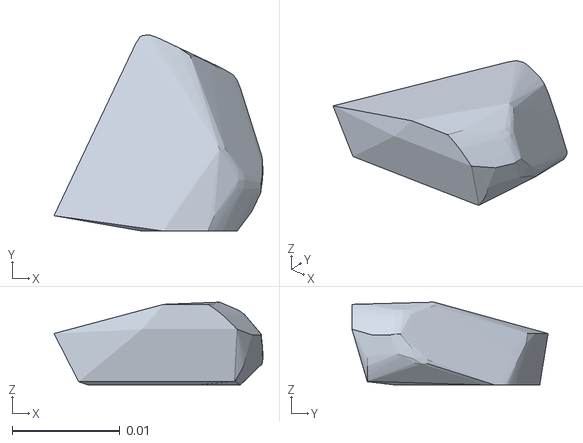
[picture p111: CAD file, 2026-11-02]
ros2_ws/src/description/meshes/arm/collision/finger_left_017.obj
0.0194 x 0.0182 x 0.00767
