jejeong5976/Project2_Turtle_Ninja/ros2_ws/src/description/meshes/arm/wrist_plate.obj

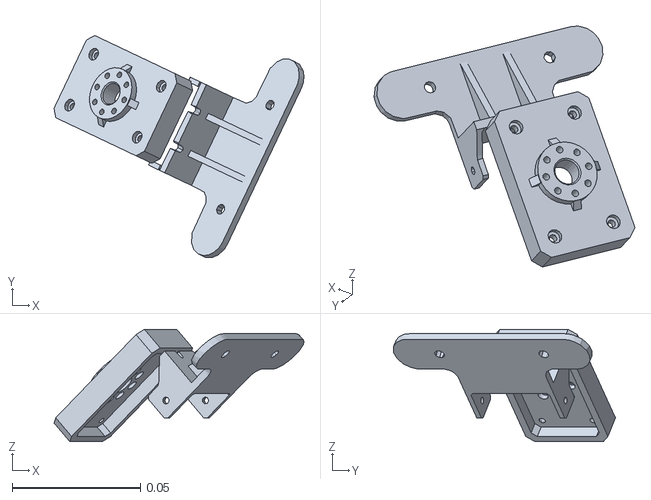
[picture p112: CAD file, 2026-11-02]
ros2_ws/src/description/meshes/arm/wrist_plate.obj
0.0976 x 0.0866 x 0.0439
