jejeong5976/Project2_Turtle_Ninja/ros2_ws/src/description/meshes/base/hardware/nut2_m2_5_1.obj

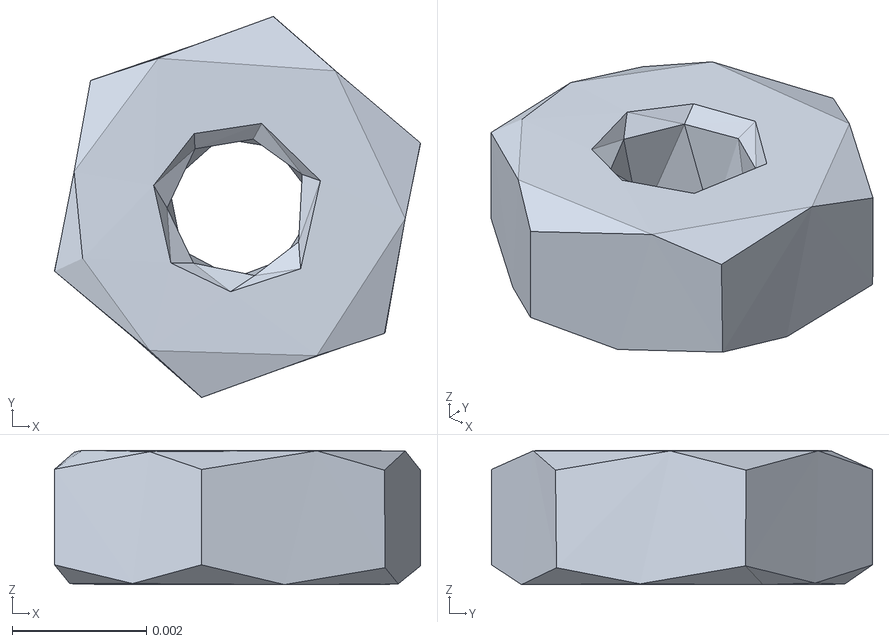
[picture p113: CAD file, 2026-11-02]
ros2_ws/src/description/meshes/base/hardware/nut2_m2_5_1.obj
0.00545 x 0.00567 x 0.002
