jejeong5976/Project2_Turtle_Ninja/ros2_ws/src/description/meshes/arm/gripper_linkage.obj

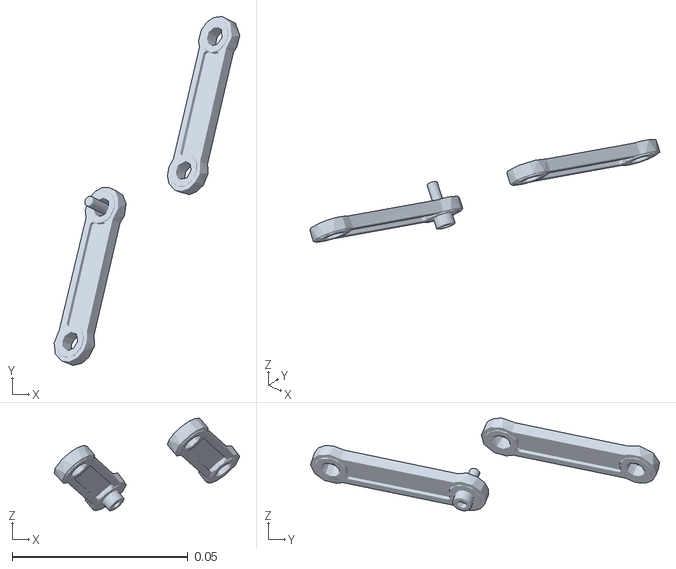
[picture p115: CAD file, 2026-11-02]
ros2_ws/src/description/meshes/arm/gripper_linkage.obj
0.0529 x 0.0994 x 0.0264
