jejeong5976/Project2_Turtle_Ninja/ros2_ws/src/description/meshes/base/hardware/m_bic13_a01_case_top.obj

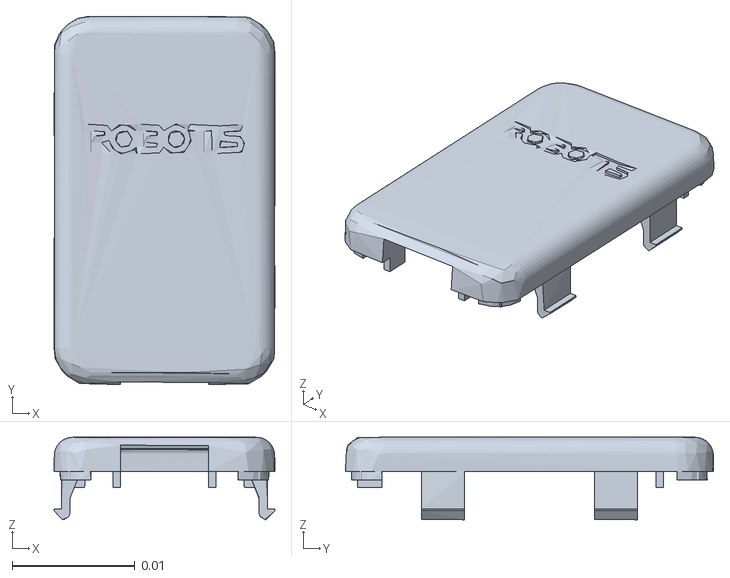
[picture p116: CAD file, 2026-11-02]
ros2_ws/src/description/meshes/base/hardware/m_bic13_a01_case_top.obj
0.018 x 0.03 x 0.00672
