jejeong5976/Project2_Turtle_Ninja/ros2_ws/src/description/meshes/arm/wrist_motor.obj

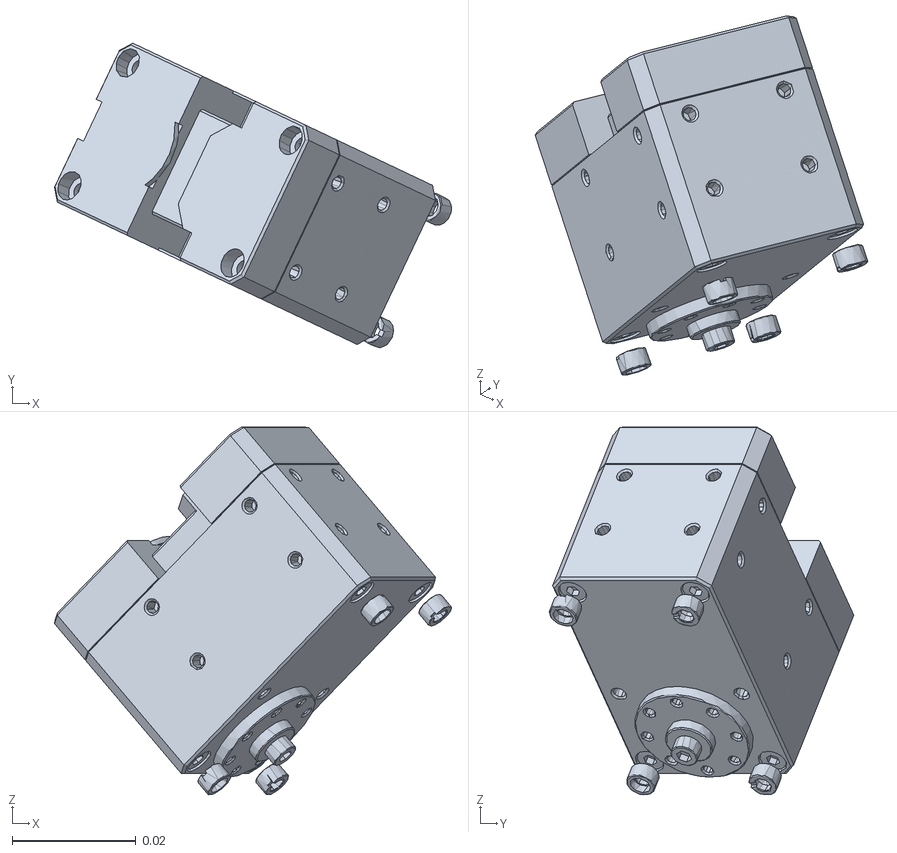
[picture p117: CAD file, 2026-11-02]
ros2_ws/src/description/meshes/arm/wrist_motor.obj
0.0643 x 0.0493 x 0.0595
