jejeong5976/Project2_Turtle_Ninja/ros2_ws/src/description/meshes/base/hardware/pi_camera_2_1_1.obj

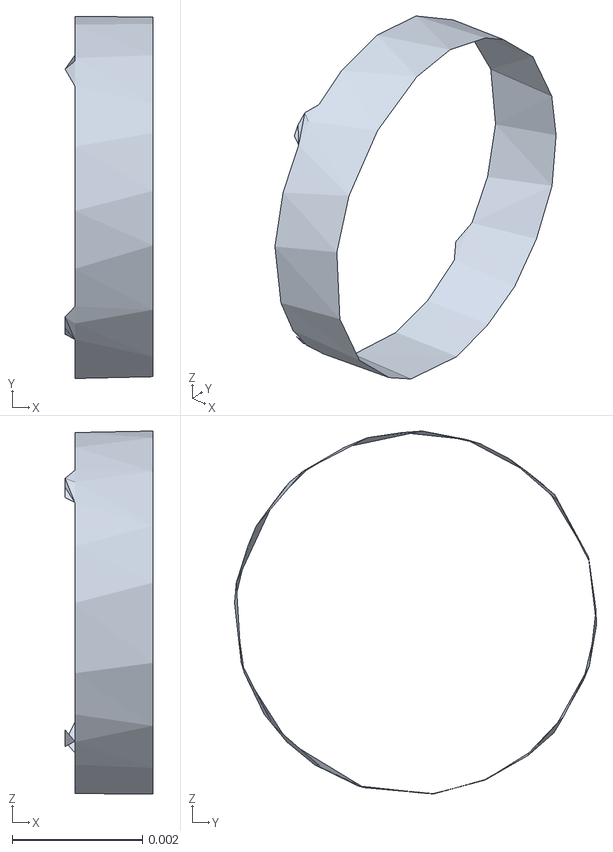
[picture p118: CAD file, 2026-11-02]
ros2_ws/src/description/meshes/base/hardware/pi_camera_2_1_1.obj
0.00135 x 0.00557 x 0.00558
