jejeong5976/Project2_Turtle_Ninja/ros2_ws/src/description/meshes/arm/collision/finger_right_017.obj

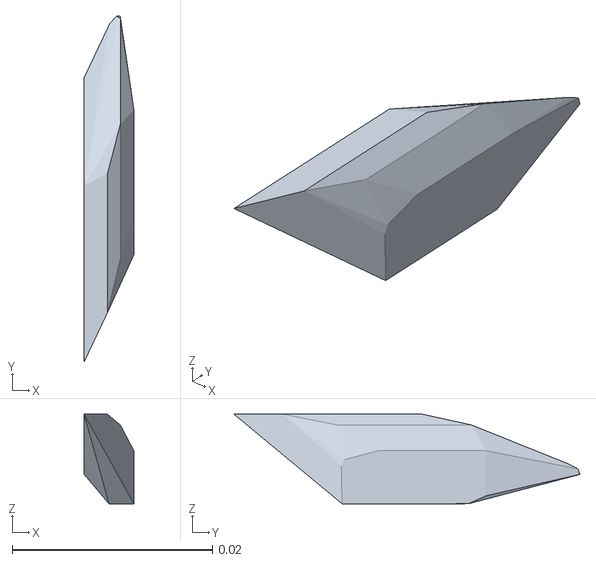
[picture p119: CAD file, 2026-11-02]
ros2_ws/src/description/meshes/arm/collision/finger_right_017.obj
0.00498 x 0.0346 x 0.00894
