jejeong5976/Project2_Turtle_Ninja/ros2_ws/src/description/meshes/arm/link5_frame.obj

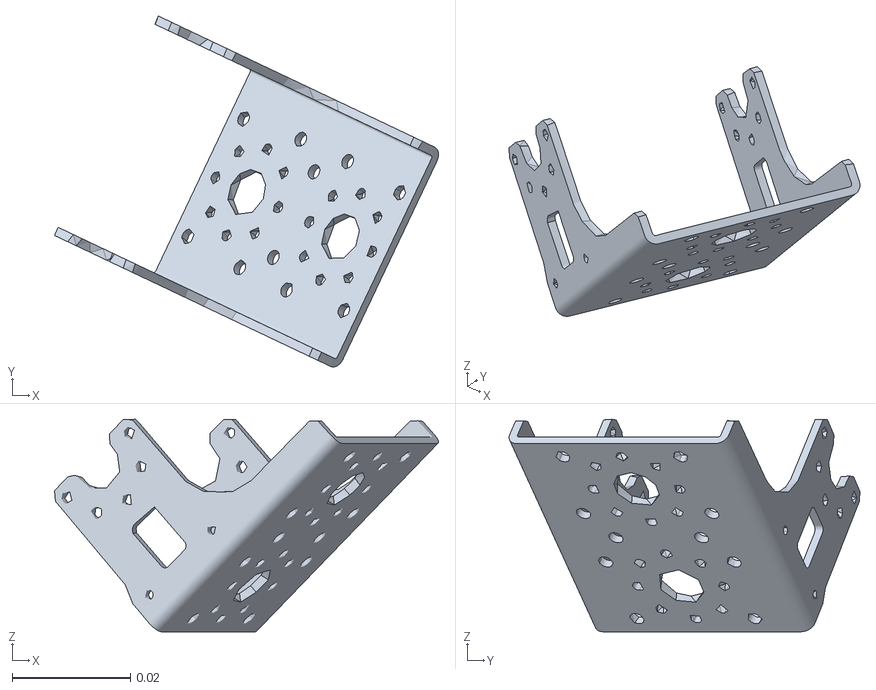
[picture p120: CAD file, 2026-11-02]
ros2_ws/src/description/meshes/arm/link5_frame.obj
0.0649 x 0.0593 x 0.0359
