jejeong5976/Project2_Turtle_Ninja/ros2_ws/src/description/meshes/arm/collision/finger_left_059.obj

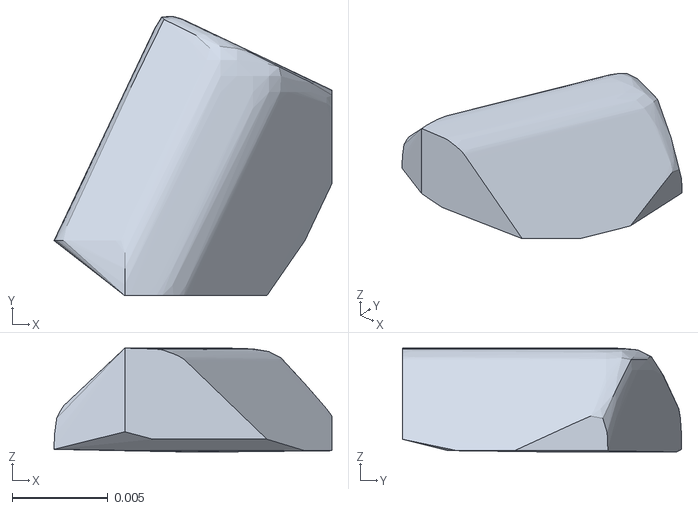
[picture p121: CAD file, 2026-11-02]
ros2_ws/src/description/meshes/arm/collision/finger_left_059.obj
0.0145 x 0.0146 x 0.00544
