jejeong5976/Project2_Turtle_Ninja/ros2_ws/src/description/meshes/arm/park_stand.obj

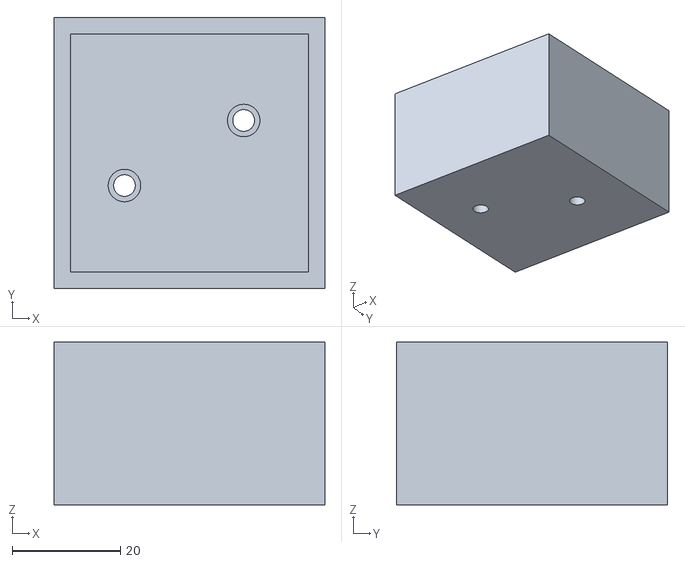
[picture p122: CAD file, 2026-11-02]
ros2_ws/src/description/meshes/arm/park_stand.obj
50.0 x 50.0 x 30.0
