jejeong5976/Project2_Turtle_Ninja/ros2_ws/src/description/meshes/base/hardware/pi_camera_2_1_2.obj

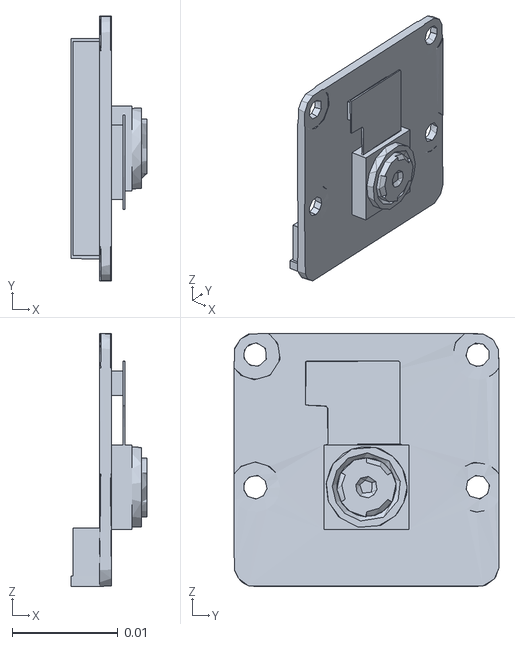
[picture p123: CAD file, 2026-11-02]
ros2_ws/src/description/meshes/base/hardware/pi_camera_2_1_2.obj
0.00715 x 0.025 x 0.0239
