jejeong5976/Project2_Turtle_Ninja/ros2_ws/src/description/meshes/arm/collision/finger_right_077.obj

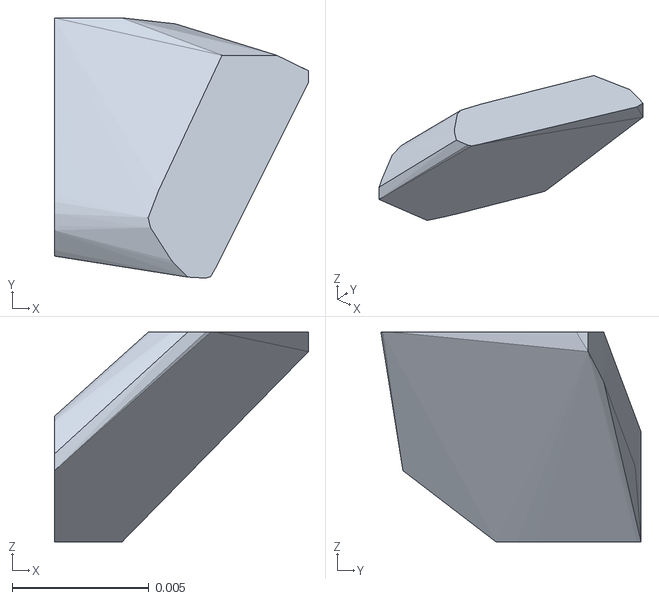
[picture p124: CAD file, 2026-11-02]
ros2_ws/src/description/meshes/arm/collision/finger_right_077.obj
0.0093 x 0.00953 x 0.00768
