jejeong5976/Project2_Turtle_Ninja/ros2_ws/src/description/meshes/base/hardware/phs_m2x6_1.obj

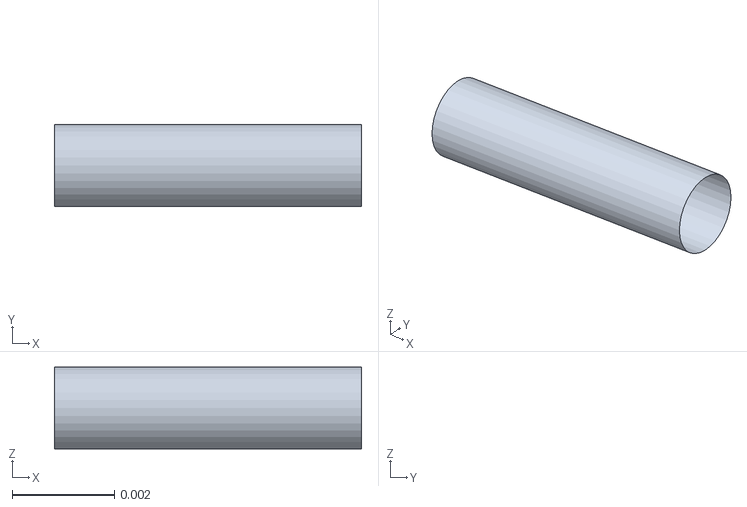
[picture p125: CAD file, 2026-11-02]
ros2_ws/src/description/meshes/base/hardware/phs_m2x6_1.obj
0.006 x 0.0016 x 0.0016
