jejeong5976/Project2_Turtle_Ninja/ros2_ws/src/description/meshes/arm/collision/finger_right_020.obj

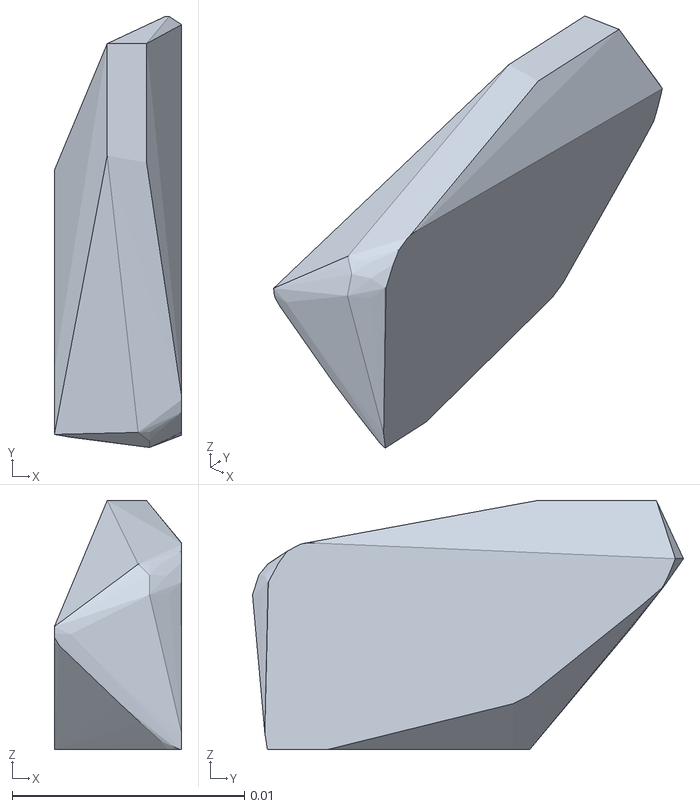
[picture p126: CAD file, 2026-11-02]
ros2_ws/src/description/meshes/arm/collision/finger_right_020.obj
0.00547 x 0.0185 x 0.0107
