jejeong5976/Project2_Turtle_Ninja/ros2_ws/src/description/meshes/arm/link4_motor.obj

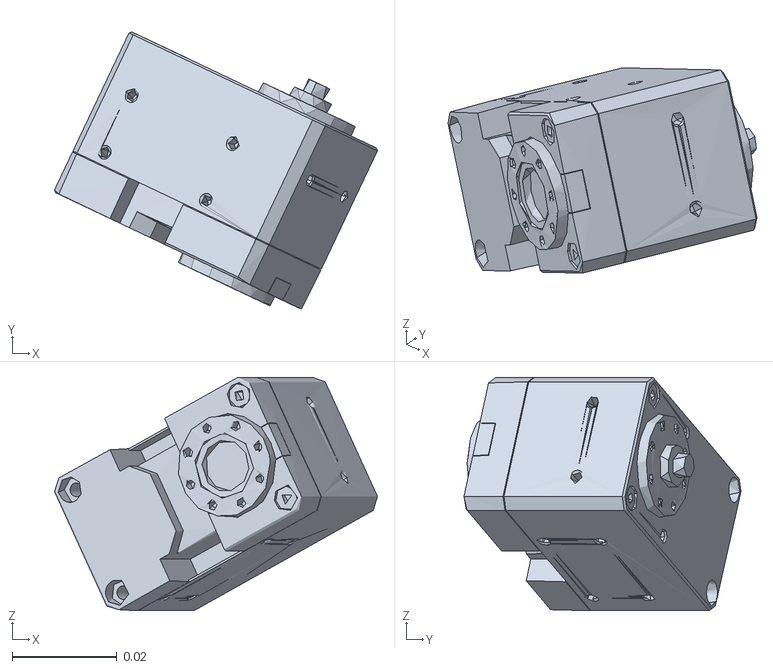
[picture p127: CAD file, 2026-11-02]
ros2_ws/src/description/meshes/arm/link4_motor.obj
0.0617 x 0.0529 x 0.0446
