jejeong5976/Project2_Turtle_Ninja/ros2_ws/src/description/meshes/arm/collision/finger_left_068.obj

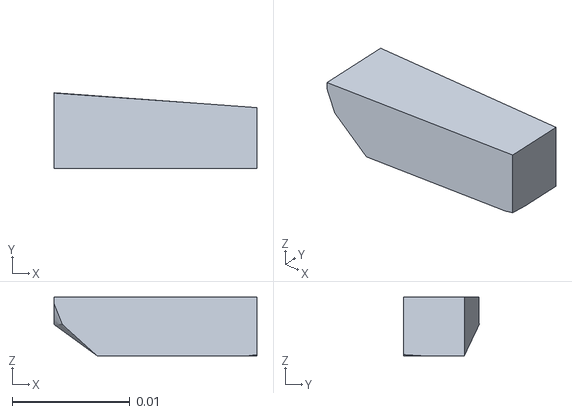
[picture p129: CAD file, 2026-11-02]
ros2_ws/src/description/meshes/arm/collision/finger_left_068.obj
0.0172 x 0.00641 x 0.00497
