jejeong5976/Project2_Turtle_Ninja/ros2_ws/src/description/meshes/arm/link5_motor.obj

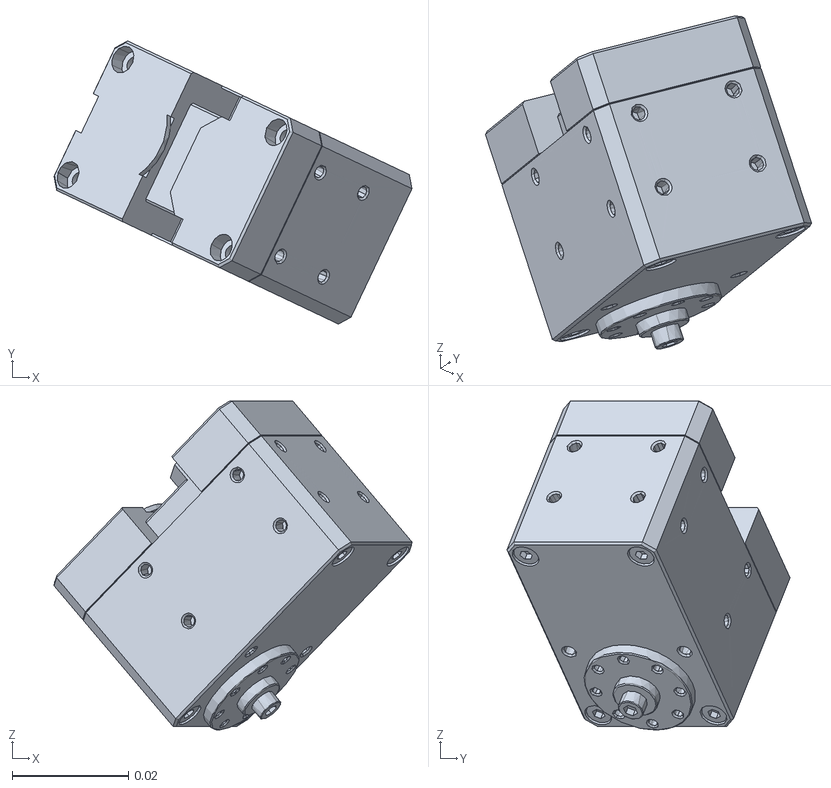
[picture p130: CAD file, 2026-11-02]
ros2_ws/src/description/meshes/arm/link5_motor.obj
0.0617 x 0.0488 x 0.0566
