jejeong5976/Project2_Turtle_Ninja/ros2_ws/src/description/meshes/arm/collision/finger_left_016.obj

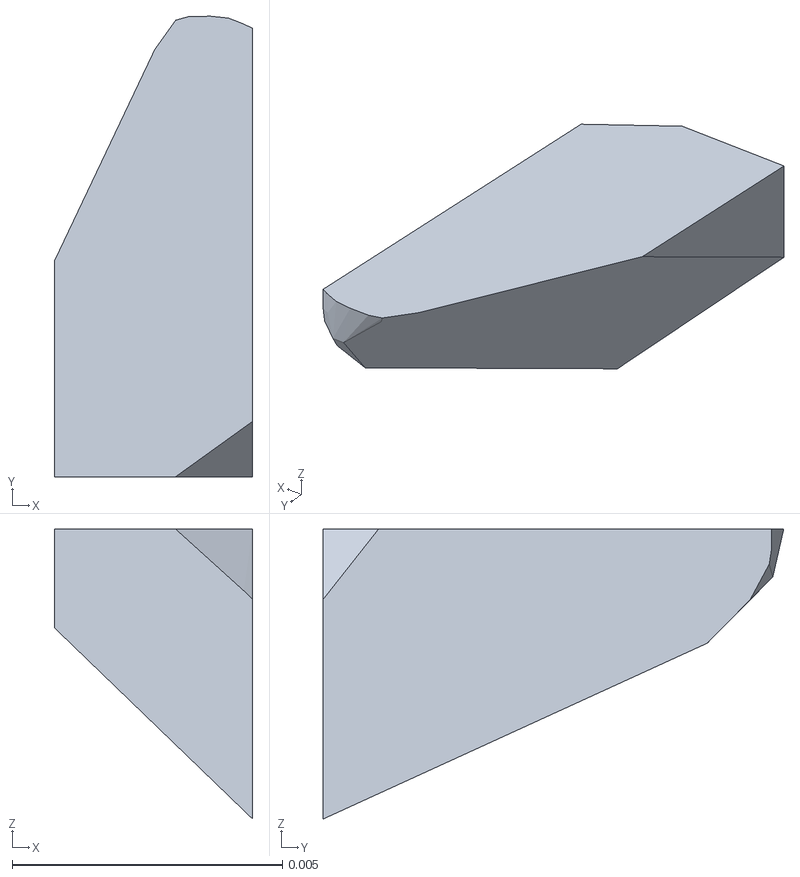
[picture p131: CAD file, 2026-11-02]
ros2_ws/src/description/meshes/arm/collision/finger_left_016.obj
0.00366 x 0.00851 x 0.00536
