jejeong5976/Project2_Turtle_Ninja/ros2_ws/src/description/meshes/arm/collision/finger_left_050.obj

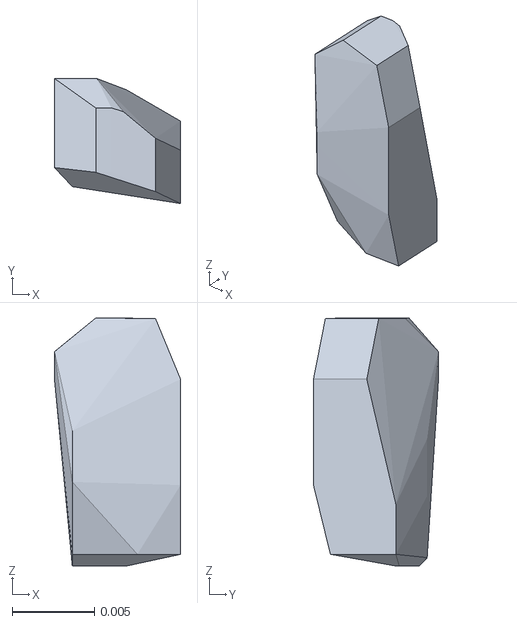
[picture p132: CAD file, 2026-11-02]
ros2_ws/src/description/meshes/arm/collision/finger_left_050.obj
0.00766 x 0.00759 x 0.0151
