jejeong5976/Project2_Turtle_Ninja/ros2_ws/src/description/meshes/base/hardware/pcb_surface.obj

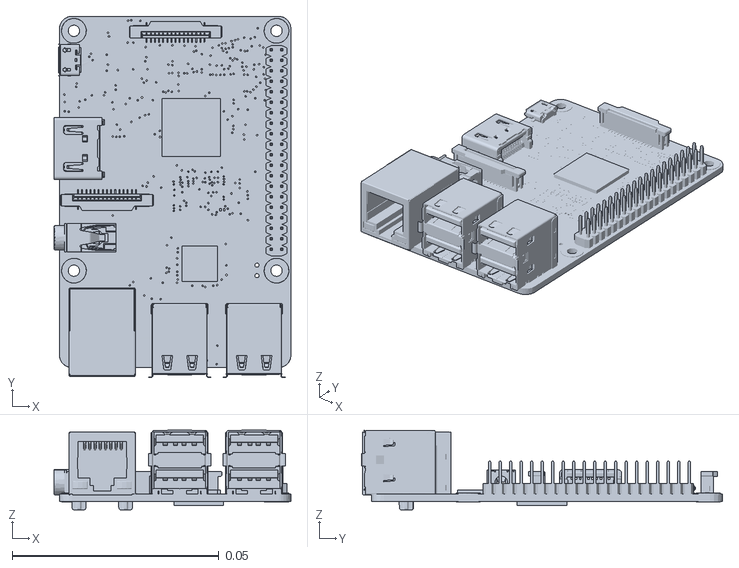
[picture p133: CAD file, 2026-11-02]
ros2_ws/src/description/meshes/base/hardware/pcb_surface.obj
0.0573 x 0.0874 x 0.0193
