jejeong5976/Project2_Turtle_Ninja/ros2_ws/src/description/meshes/base/hardware/connector_50_37_5023.obj

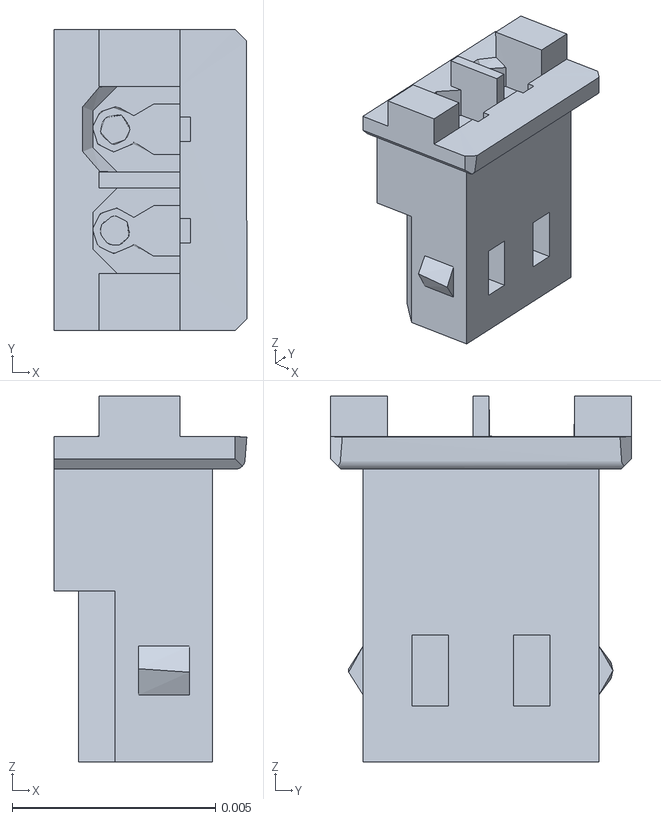
[picture p134: CAD file, 2026-11-02]
ros2_ws/src/description/meshes/base/hardware/connector_50_37_5023.obj
0.00474 x 0.0074 x 0.009
