jejeong5976/Project2_Turtle_Ninja/ros2_ws/src/description/meshes/arm/collision/finger_left_057.obj

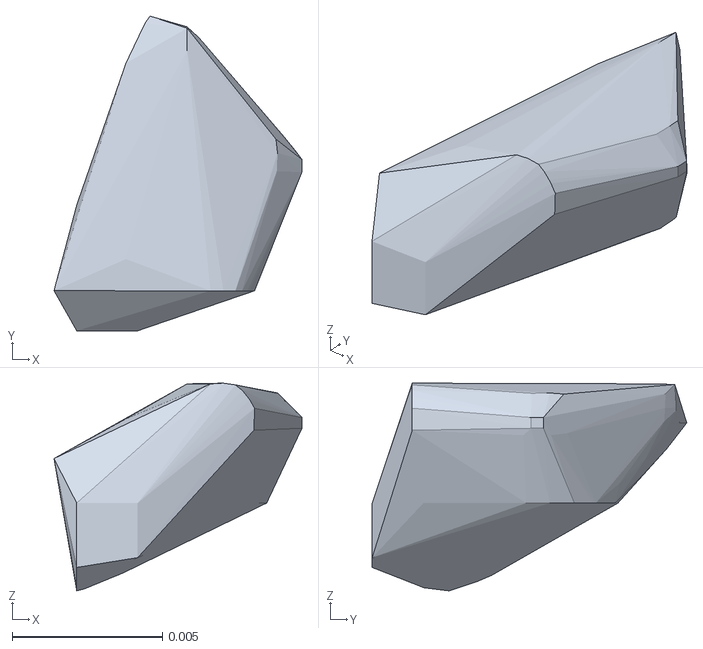
[picture p135: CAD file, 2026-11-02]
ros2_ws/src/description/meshes/arm/collision/finger_left_057.obj
0.00824 x 0.0105 x 0.0069
