jejeong5976/Project2_Turtle_Ninja/ros2_ws/src/description/meshes/base/hardware/pr30_ibb_01.obj

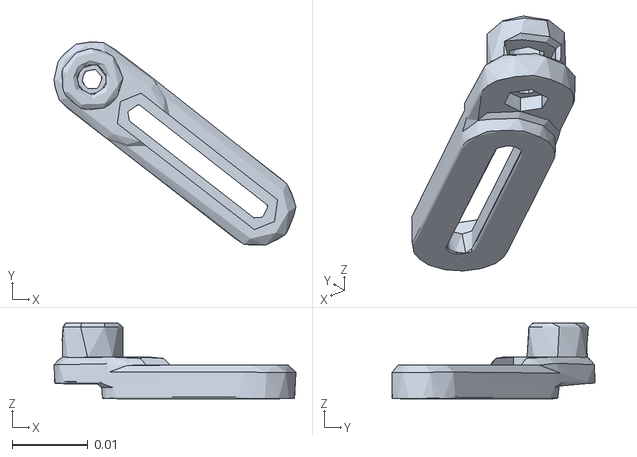
[picture p136: CAD file, 2026-11-02]
ros2_ws/src/description/meshes/base/hardware/pr30_ibb_01.obj
0.032 x 0.0269 x 0.01
