jejeong5976/Project2_Turtle_Ninja/ros2_ws/src/description/meshes/arm/collision/finger_left_060.obj

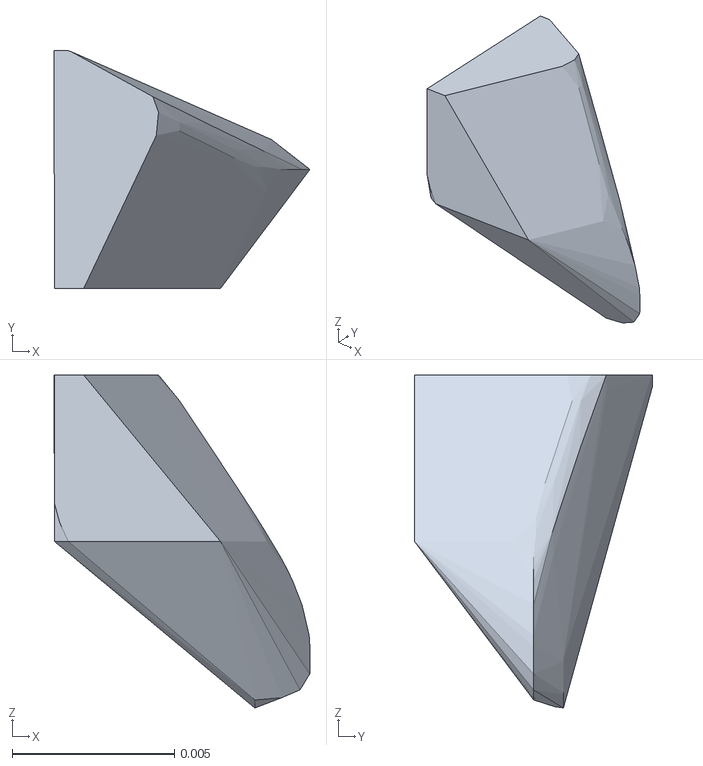
[picture p137: CAD file, 2026-11-02]
ros2_ws/src/description/meshes/arm/collision/finger_left_060.obj
0.00788 x 0.00733 x 0.0103
