jejeong5976/Project2_Turtle_Ninja/ros2_ws/src/description/meshes/arm/collision/finger_left_021.obj

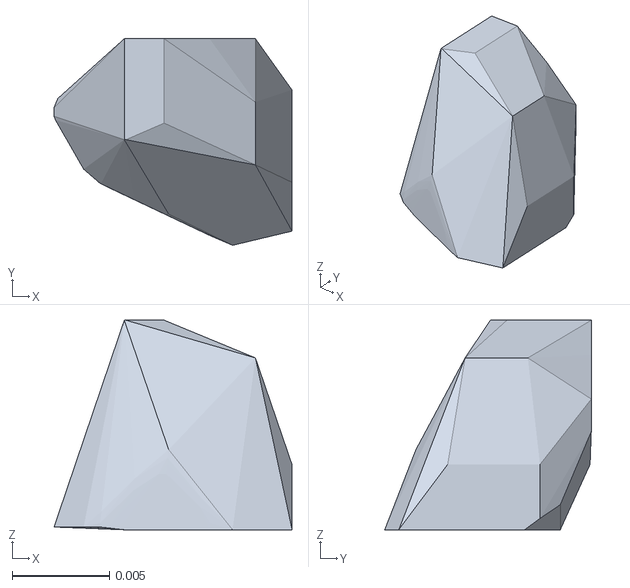
[picture p139: CAD file, 2026-11-02]
ros2_ws/src/description/meshes/arm/collision/finger_left_021.obj
0.0123 x 0.0106 x 0.0108
