jejeong5976/Project2_Turtle_Ninja/ros2_ws/src/description/meshes/base/hardware/connector_530480810.obj

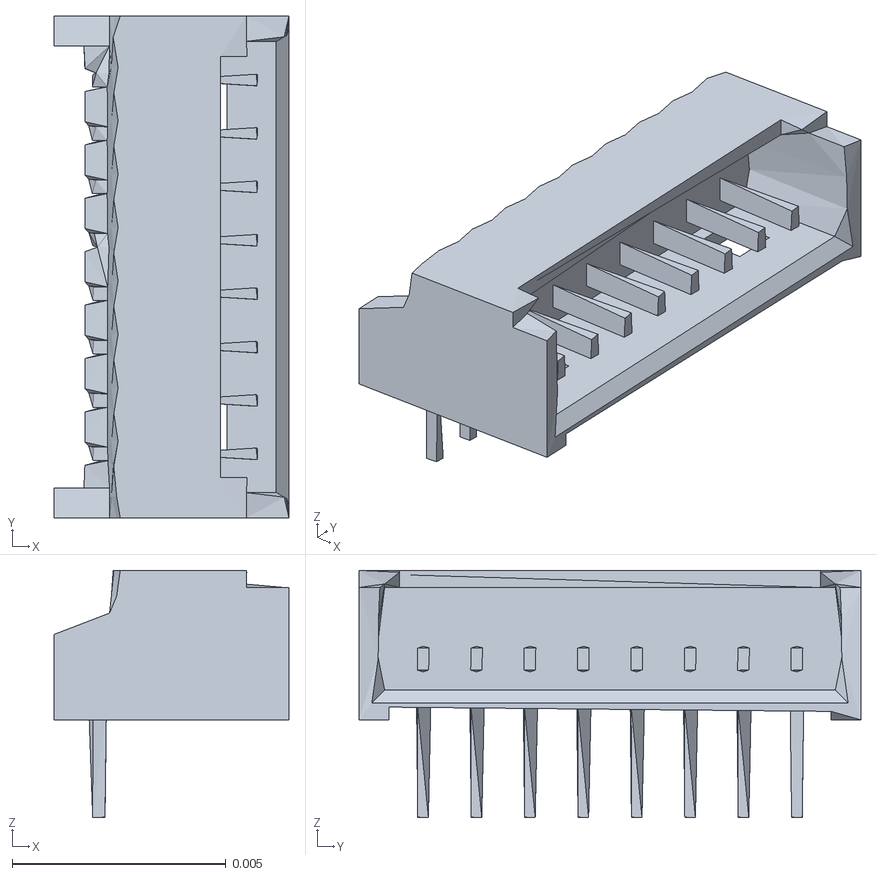
[picture p140: CAD file, 2026-11-02]
ros2_ws/src/description/meshes/base/hardware/connector_530480810.obj
0.0055 x 0.0118 x 0.00579
