jejeong5976/Project2_Turtle_Ninja/ros2_ws/src/description/meshes/base/hardware/pi_camera_2_1_3.obj

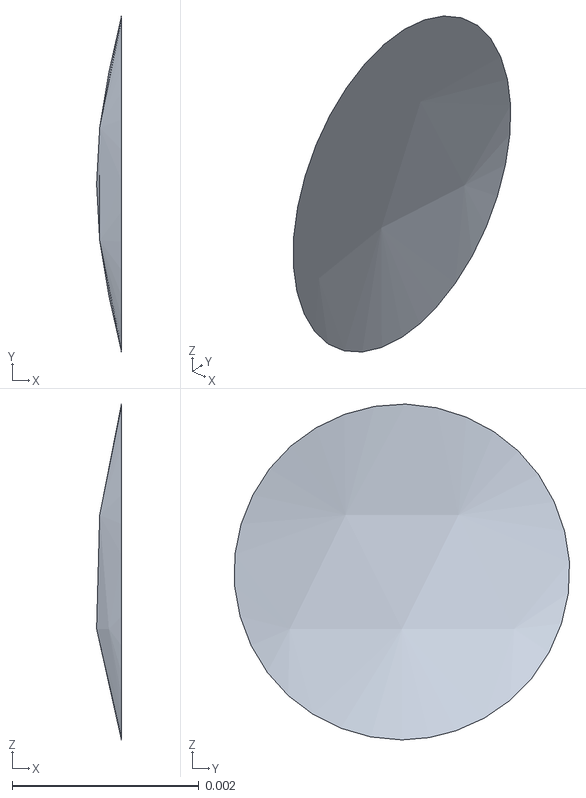
[picture p141: CAD file, 2026-11-02]
ros2_ws/src/description/meshes/base/hardware/pi_camera_2_1_3.obj
0.000266 x 0.00359 x 0.0036
