jejeong5976/Project2_Turtle_Ninja/ros2_ws/src/description/meshes/arm/collision/finger_right_047.obj

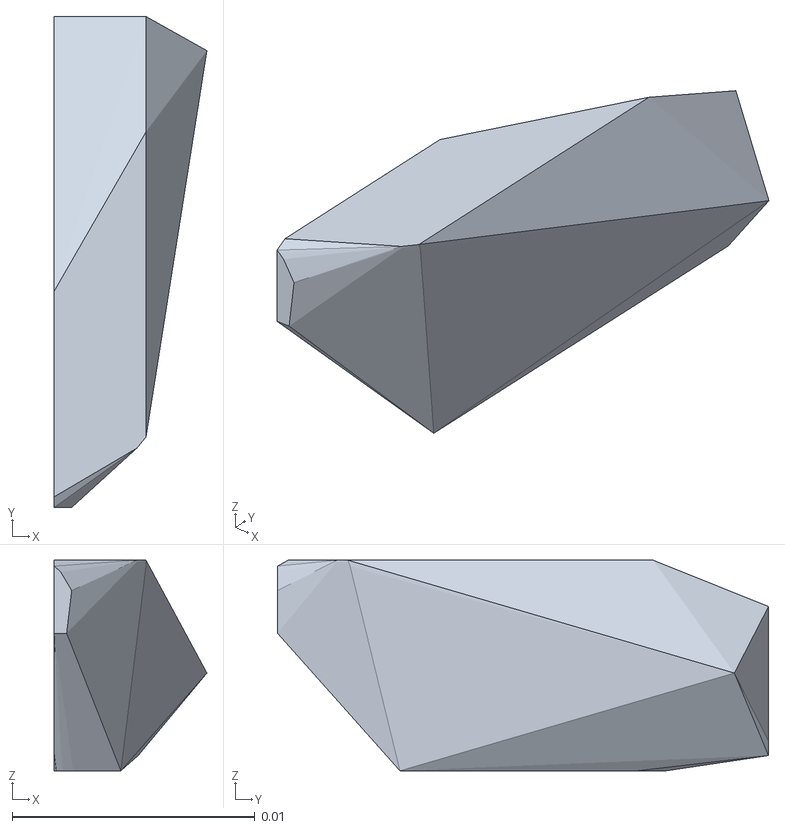
[picture p142: CAD file, 2026-11-02]
ros2_ws/src/description/meshes/arm/collision/finger_right_047.obj
0.0063 x 0.0202 x 0.00868
