jejeong5976/Project2_Turtle_Ninja/ros2_ws/src/description/meshes/arm/collision/finger_right_069.obj

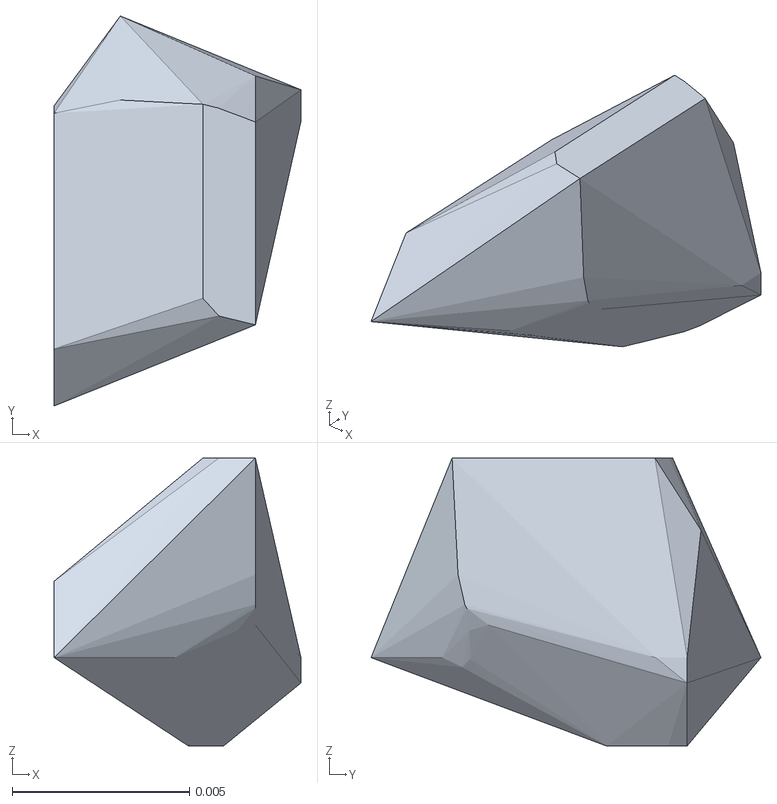
[picture p144: CAD file, 2026-11-02]
ros2_ws/src/description/meshes/arm/collision/finger_right_069.obj
0.00696 x 0.011 x 0.00812
