jejeong5976/Project2_Turtle_Ninja/ros2_ws/src/description/meshes/base/hardware/pr07_one_rivet_2.obj

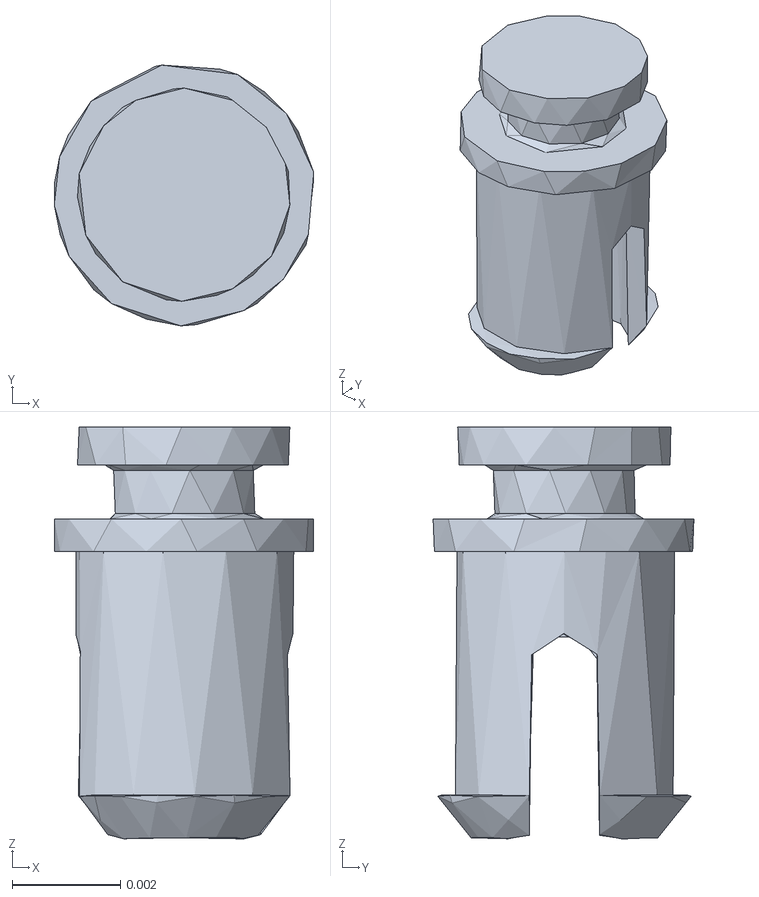
[picture p145: CAD file, 2026-11-02]
ros2_ws/src/description/meshes/base/hardware/pr07_one_rivet_2.obj
0.0048 x 0.00482 x 0.00762
