jejeong5976/Project2_Turtle_Ninja/ros2_ws/src/description/meshes/arm/collision/finger_right_056.obj

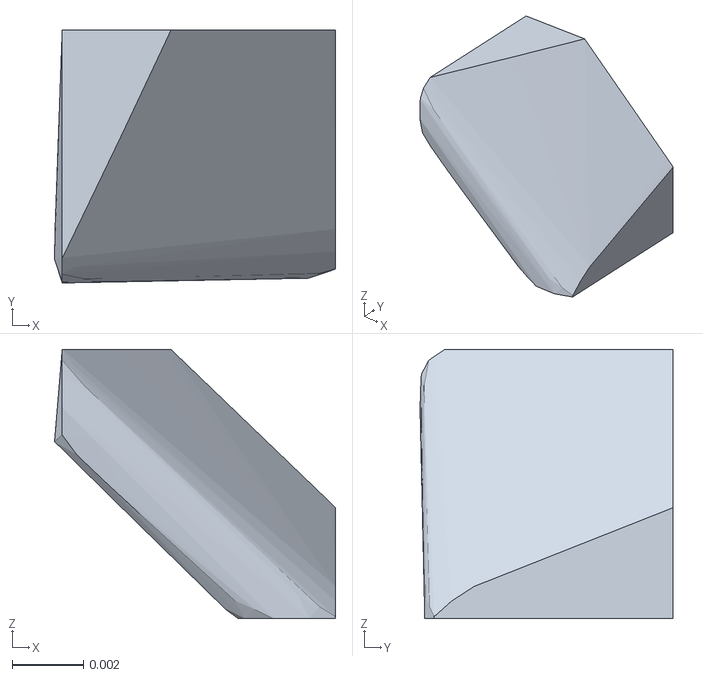
[picture p146: CAD file, 2026-11-02]
ros2_ws/src/description/meshes/arm/collision/finger_right_056.obj
0.00786 x 0.00708 x 0.00753
