jejeong5976/Project2_Turtle_Ninja/ros2_ws/src/description/meshes/base/hardware/m_pr07_plate_3x3_b_1.obj

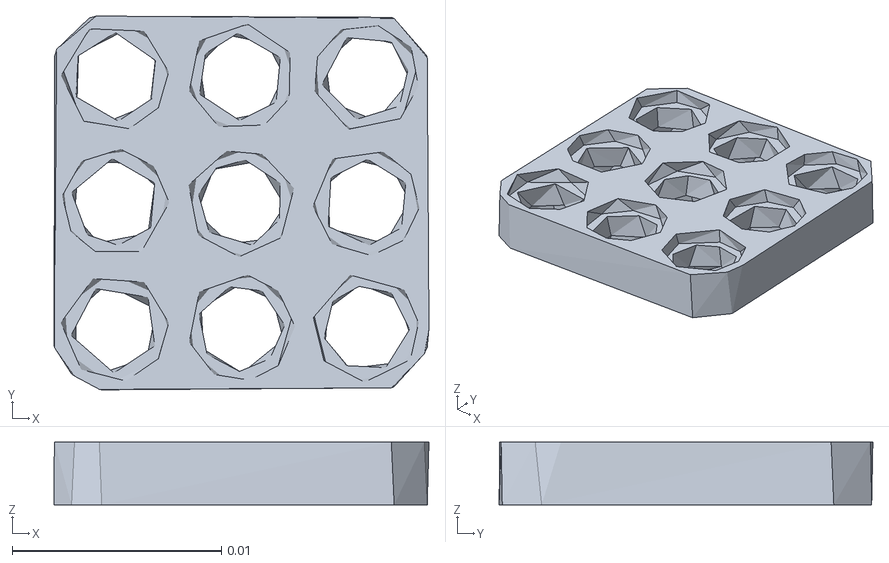
[picture p147: CAD file, 2026-11-02]
ros2_ws/src/description/meshes/base/hardware/m_pr07_plate_3x3_b_1.obj
0.0179 x 0.0179 x 0.003
