jejeong5976/Project2_Turtle_Ninja/ros2_ws/src/description/meshes/arm/collision/wrist_dc12_a01_spacer_ring_1_1.obj

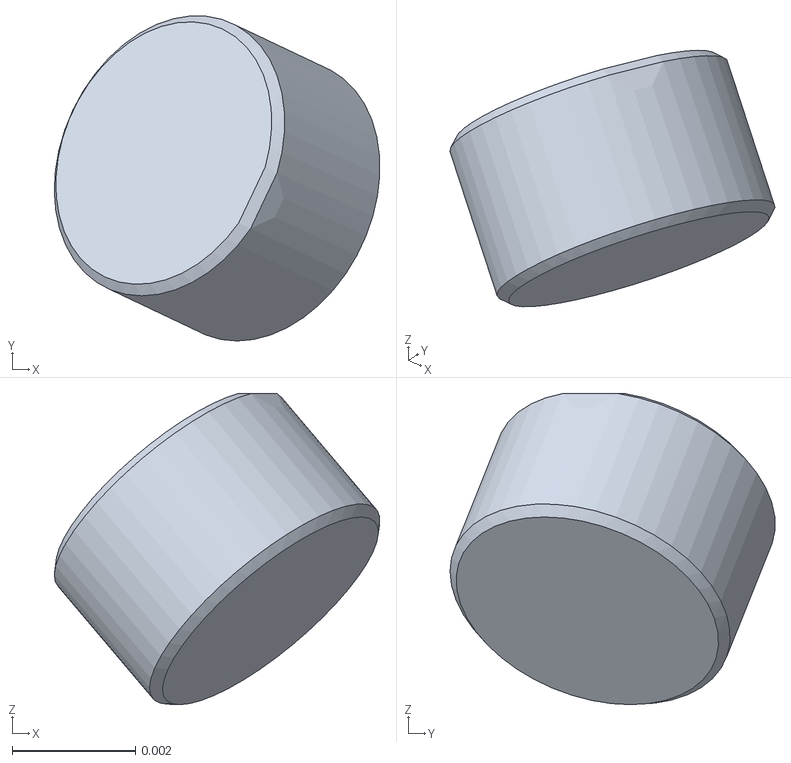
[picture p148: CAD file, 2026-11-02]
ros2_ws/src/description/meshes/arm/collision/wrist_dc12_a01_spacer_ring_1_1.obj
0.00528 x 0.00527 x 0.00505
