jejeong5976/Project2_Turtle_Ninja/ros2_ws/src/description/meshes/base/hardware/phs_m3x8.obj

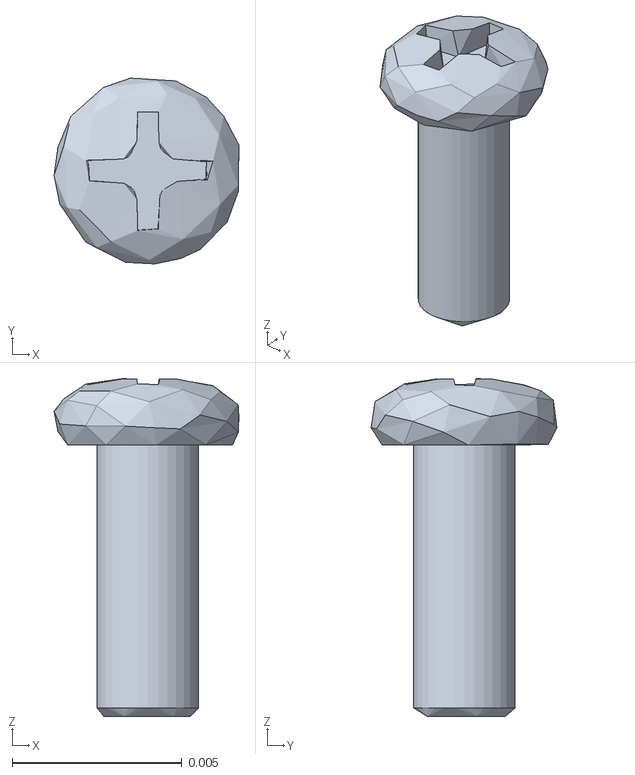
[picture p149: CAD file, 2026-11-02]
ros2_ws/src/description/meshes/base/hardware/phs_m3x8.obj
0.00545 x 0.00548 x 0.00997
