jejeong5976/Project2_Turtle_Ninja/ros2_ws/src/description/meshes/arm/collision/finger_right_024.obj

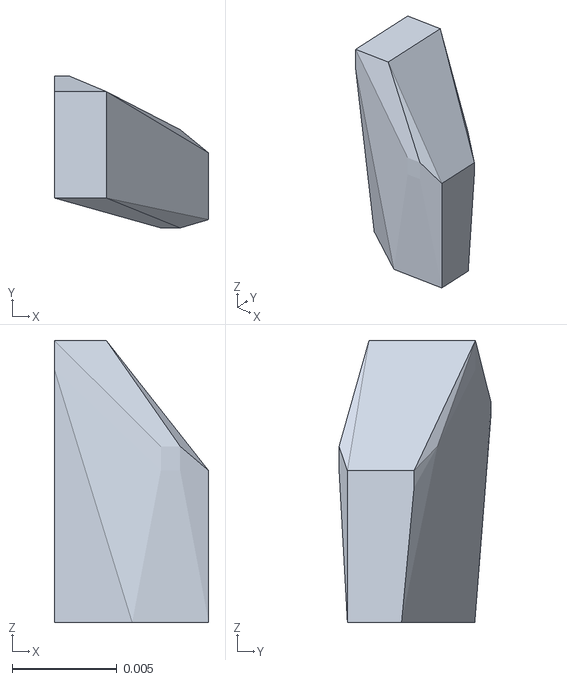
[picture p150: CAD file, 2026-11-02]
ros2_ws/src/description/meshes/arm/collision/finger_right_024.obj
0.00737 x 0.00725 x 0.0135
