jejeong5976/Project2_Turtle_Ninja/ros2_ws/src/description/meshes/base/hardware/support_hex_m3_0xl45_ff.obj

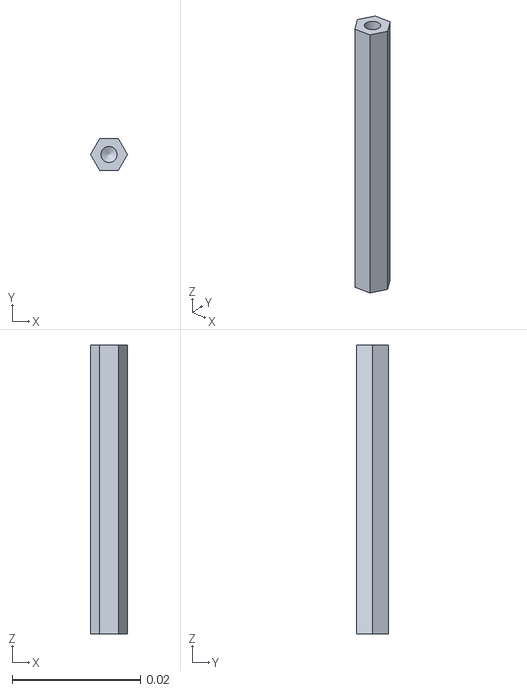
[picture p151: CAD file, 2026-11-02]
ros2_ws/src/description/meshes/base/hardware/support_hex_m3_0xl45_ff.obj
0.00577 x 0.005 x 0.045
