jejeong5976/Project2_Turtle_Ninja/(list of files, cad)

Other CAD files:
ros2_ws/src/description/meshes/camera/collision/bracket_lever.obj
ros2_ws/src/description/meshes/structure/profile_holder.obj
ros2_ws/src/description/meshes/swerve/module_rl.stl
ros2_ws/src/description/meshes/camera/collision/bracket_clamp.obj
ros2_ws/src/description/meshes/lidar/lds03_mount_left.obj
ros2_ws/src/description/meshes/lidar/lds03_mount_single.obj
ros2_ws/src/description/meshes/swerve/wheel_rl.stl
ros2_ws/src/description/meshes/camera/birdeye_lens.obj
ros2_ws/src/description/meshes/camera/collision/birdeye_pcb.obj
ros2_ws/src/description/meshes/electronics/opencr_arm.obj
ros2_ws/src/description/meshes/swerve/module_fl.stl
ros2_ws/src/description/meshes/arm/collision/gripper_link_left.obj
ros2_ws/src/description/meshes/electronics/battery_left.obj
ros2_ws/src/description/meshes/swerve/module_rr.stl
ros2_ws/src/description/meshes/camera/birdeye_lens_seat.obj
ros2_ws/src/description/meshes/camera/collision/bracket_cradle.obj
ros2_ws/src/description/meshes/swerve/wheel_rr.stl
ros2_ws/src/description/meshes/camera/birdeye_connector.obj
ros2_ws/src/description/meshes/swerve/wheel_fr.stl
ros2_ws/src/description/meshes/arm/gripper_link_left.obj
ros2_ws/src/description/meshes/arm/wrist_frame.obj
ros2_ws/src/description/meshes/base/hardware/support_hex_m3_0xl35_ff_2.obj
ros2_ws/src/description/meshes/base/hardware/support_hex_m3_0xl45_ff_1.obj
ros2_ws/src/description/meshes/base/hardware/support_hex_m3_0xl45_ff_2.obj
ros2_ws/src/description/meshes/arm/gripper_crank.obj
ros2_ws/src/description/meshes/base/hardware/m_pr07_a01_bracket_2.obj
ros2_ws/src/description/meshes/base/hardware/m_pr07_a01_bracket_2_1.obj
ros2_ws/src/description/meshes/arm/collision/finger_left_000.obj
ros2_ws/src/description/meshes/arm/collision/finger_left_001.obj
ros2_ws/src/description/meshes/arm/collision/finger_left_002.obj
ros2_ws/src/description/meshes/arm/collision/finger_left_003.obj
ros2_ws/src/description/meshes/arm/collision/finger_left_004.obj
ros2_ws/src/description/meshes/arm/collision/finger_left_005.obj
ros2_ws/src/description/meshes/arm/collision/finger_left_006.obj
ros2_ws/src/description/meshes/arm/collision/finger_left_007.obj
ros2_ws/src/description/meshes/arm/collision/finger_left_009.obj
ros2_ws/src/description/meshes/arm/collision/finger_left_010.obj
ros2_ws/src/description/meshes/arm/collision/finger_left_011.obj
ros2_ws/src/description/meshes/arm/collision/finger_left_012.obj
ros2_ws/src/description/meshes/arm/collision/finger_left_013.obj
ros2_ws/src/description/meshes/arm/collision/finger_left_014.obj
ros2_ws/src/description/meshes/arm/collision/finger_left_015.obj
ros2_ws/src/description/meshes/arm/collision/finger_left_018.obj
ros2_ws/src/description/meshes/arm/collision/finger_left_019.obj
ros2_ws/src/description/meshes/arm/collision/finger_left_020.obj
ros2_ws/src/description/meshes/arm/collision/finger_left_022.obj
ros2_ws/src/description/meshes/arm/collision/finger_left_023.obj
ros2_ws/src/description/meshes/arm/collision/finger_left_024.obj
ros2_ws/src/description/meshes/arm/collision/finger_left_025.obj
ros2_ws/src/description/meshes/arm/collision/finger_left_027.obj
ros2_ws/src/description/meshes/arm/collision/finger_left_028.obj
ros2_ws/src/description/meshes/arm/collision/finger_left_029.obj
ros2_ws/src/description/meshes/arm/collision/finger_left_030.obj
ros2_ws/src/description/meshes/arm/collision/finger_left_031.obj
ros2_ws/src/description/meshes/arm/collision/finger_left_032.obj
ros2_ws/src/description/meshes/arm/collision/finger_left_033.obj
ros2_ws/src/description/meshes/arm/collision/finger_left_034.obj
ros2_ws/src/description/meshes/arm/collision/finger_left_035.obj
ros2_ws/src/description/meshes/arm/collision/finger_left_036.obj
ros2_ws/src/description/meshes/arm/collision/finger_left_038.obj
ros2_ws/src/description/meshes/arm/collision/finger_left_039.obj
ros2_ws/src/description/meshes/arm/collision/finger_left_040.obj
ros2_ws/src/description/meshes/arm/collision/finger_left_041.obj
ros2_ws/src/description/meshes/arm/collision/finger_left_042.obj
ros2_ws/src/description/meshes/arm/collision/finger_left_043.obj
ros2_ws/src/description/meshes/arm/collision/finger_left_045.obj
ros2_ws/src/description/meshes/arm/collision/finger_left_046.obj
ros2_ws/src/description/meshes/arm/collision/finger_left_047.obj
ros2_ws/src/description/meshes/arm/collision/finger_left_048.obj
ros2_ws/src/description/meshes/arm/collision/finger_left_049.obj
ros2_ws/src/description/meshes/arm/collision/finger_left_051.obj
ros2_ws/src/description/meshes/arm/collision/finger_left_052.obj
ros2_ws/src/description/meshes/arm/collision/finger_left_053.obj
ros2_ws/src/description/meshes/arm/collision/finger_left_054.obj
ros2_ws/src/description/meshes/arm/collision/finger_left_055.obj
ros2_ws/src/description/meshes/arm/collision/finger_left_056.obj
ros2_ws/src/description/meshes/arm/collision/finger_left_058.obj
ros2_ws/src/description/meshes/arm/collision/finger_left_061.obj
ros2_ws/src/description/meshes/arm/collision/finger_left_062.obj
ros2_ws/src/description/meshes/arm/collision/finger_left_063.obj
ros2_ws/src/description/meshes/arm/collision/finger_left_064.obj
ros2_ws/src/description/meshes/arm/collision/finger_left_065.obj
ros2_ws/src/description/meshes/arm/collision/finger_left_066.obj
ros2_ws/src/description/meshes/arm/collision/finger_left_067.obj
ros2_ws/src/description/meshes/arm/collision/finger_left_069.obj
ros2_ws/src/description/meshes/arm/collision/finger_left_070.obj
ros2_ws/src/description/meshes/arm/collision/finger_left_071.obj
ros2_ws/src/description/meshes/arm/collision/finger_left_072.obj
ros2_ws/src/description/meshes/arm/collision/finger_left_073.obj
ros2_ws/src/description/meshes/arm/collision/finger_left_074.obj
ros2_ws/src/description/meshes/arm/collision/finger_left_075.obj
ros2_ws/src/description/meshes/arm/collision/finger_left_076.obj
ros2_ws/src/description/meshes/arm/collision/finger_left_077.obj
ros2_ws/src/description/meshes/arm/collision/finger_left_078.obj
ros2_ws/src/description/meshes/arm/collision/finger_left_079.obj
ros2_ws/src/description/meshes/arm/collision/finger_left_080.obj
ros2_ws/src/description/meshes/arm/collision/finger_left_082.obj
ros2_ws/src/description/meshes/arm/collision/finger_left_083.obj
ros2_ws/src/description/meshes/arm/collision/finger_left_084.obj
ros2_ws/src/description/meshes/arm/collision/finger_left_085.obj
ros2_ws/src/description/meshes/arm/collision/finger_left_086.obj
ros2_ws/src/description/meshes/arm/collision/finger_left_087.obj
ros2_ws/src/description/meshes/arm/collision/finger_left_088.obj
ros2_ws/src/description/meshes/arm/collision/finger_left_089.obj
ros2_ws/src/description/meshes/arm/collision/finger_left_091.obj
ros2_ws/src/description/meshes/arm/collision/finger_left_092.obj
ros2_ws/src/description/meshes/arm/collision/finger_left_093.obj
ros2_ws/src/description/meshes/arm/collision/finger_left_094.obj
ros2_ws/src/description/meshes/arm/collision/finger_left_095.obj
ros2_ws/src/description/meshes/arm/collision/finger_right_000.obj
ros2_ws/src/description/meshes/arm/collision/finger_right_002.obj
ros2_ws/src/description/meshes/arm/collision/finger_right_003.obj
ros2_ws/src/description/meshes/arm/collision/finger_right_004.obj
ros2_ws/src/description/meshes/arm/collision/finger_right_005.obj
ros2_ws/src/description/meshes/arm/collision/finger_right_006.obj
ros2_ws/src/description/meshes/arm/collision/finger_right_007.obj
ros2_ws/src/description/meshes/arm/collision/finger_right_008.obj
ros2_ws/src/description/meshes/arm/collision/finger_right_010.obj
ros2_ws/src/description/meshes/arm/collision/finger_right_011.obj
ros2_ws/src/description/meshes/arm/collision/finger_right_012.obj
ros2_ws/src/description/meshes/arm/collision/finger_right_013.obj
ros2_ws/src/description/meshes/arm/collision/finger_right_014.obj
ros2_ws/src/description/meshes/arm/collision/finger_right_015.obj
ros2_ws/src/description/meshes/arm/collision/finger_right_016.obj
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
