jejeong5976/Project2_Turtle_Ninja/sim/robot_sim/robot_description/robot.urdf

<?xml version="1.0"?>
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
<robot name="nt_ninja_turtle_release_20261026">
  <link name="base_link">
    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
    <inertial>
      <mass value="2.291189" />
      <origin xyz="0.000645130182916 -0.000396029069585 0.0379828377509" rpy="0 0 0" />
      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
    </inertial>
    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
  </link>
  <link name="birdeye_camera_link">
    <inertial>
      <mass value="0.03" />
      <origin xyz="-7.95939647524e-10 4.86405549172e-09 -1.25984772614e-09" rpy="0 0 0" />
      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
    </inertial>
    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
  </link>
  <joint name="birdeye_camera_link_mount" type="fixed">
    <parent link="profile_camera_bracket_TEMP" />
    <child link="birdeye_camera_link" />
    <origin xyz="0.0555354645249 0.0065 0.0195025360476" rpy="0 0.698131700798 0" />
  </joint>
  <link name="birdeye_camera_optical_frame" />
  <joint name="birdeye_camera_optical_frame_fixed" type="fixed">
    <parent link="birdeye_camera_link" />
    <child link="birdeye_camera_optical_frame" />
    <origin xyz="0 0 0" rpy="-1.57079632679 0 -1.57079632679" />
  </joint>
  <link name="v5_fl_steer_link_0">
    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
    <inertial>
      <origin xyz="0 0.000411 0.013322" rpy="0 0 0" />
      <mass value="0.09411" />
      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
    </inertial>
    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
  </link>
  <link name="v5_fl_wheel_link_0">
    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
    <inertial>
      <origin xyz="2e-06 0.000144 0" rpy="0 0 0" />
      <mass value="0.029086" />
      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
    </inertial>
    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
  </link>
  <link name="v5_fr_steer_link_0">
    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
    <inertial>
      <origin xyz="0 0.000411 0.013322" rpy="0 0 0" />
      <mass value="0.09411" />
      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
    </inertial>
    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
  </link>
  <link name="v5_fr_wheel_link_0">
    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
    <inertial>
      <origin xyz="2e-06 0.000144 0" rpy="0 0 0" />
      <mass value="0.029086" />
      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
    </inertial>
    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
  </link>
  <link name="v5_rl_steer_link_0">
    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
    <inertial>
      <origin xyz="0 -0.000411 0.013322" rpy="0 0 0" />
      <mass value="0.09411" />
      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
    </inertial>
    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
  </link>
  <link name="v5_rl_wheel_link_0">
    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
    <inertial>
      <origin xyz="-2e-06 -0.000144 0" rpy="0 0 0" />
      <mass value="0.029086" />
      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
    </inertial>
    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
  </link>
  <link name="v5_rr_steer_link_0">
    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
    <inertial>
      <origin xyz="0 -0.000411 0.013322" rpy="0 0 0" />
      <mass value="0.09411" />
      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
    </inertial>
    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
  </link>
  <link name="v5_rr_wheel_link_0">
    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
    <inertial>
      <origin xyz="-2e-06 -0.000144 0" rpy="0 0 0" />
      <mass value="0.029086" />
      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
    </inertial>
    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
  </link>
  <joint name="steer_fl_joint" type="revolute">
    <parent link="base_link" />
    <child link="v5_fl_steer_link_0" />
    <origin xyz="-0.064 0.112 -0.039" rpy="0 0 0" />
    <axis xyz="0 0 1" />
    <limit effort="4.1" velocity="4.7962" lower="-1.578466" upper="4.703185" />
    <dynamics damping="0.01" friction="0" />
  </joint>
  <joint name="drive_fl_joint" type="continuous">
    <parent link="v5_fl_steer_link_0" />
    <child link="v5_fl_wheel_link_0" />
    <origin xyz="0 0.0269 0" rpy="0 0 0" />
    <axis xyz="0 1 0" />
    <limit effort="3.0" velocity="7.9137" />
    <dynamics damping="0.01" friction="0" />
  </joint>
  <joint name="steer_fr_joint" type="revolute">
    <parent link="base_link" />
    <child link="v5_fr_steer_link_0" />
    <origin xyz="0.064 0.112 -0.039" rpy="0 0 0" />
    <axis xyz="0 0 1" />
    <limit effort="4.1" velocity="4.7962" lower="-3.900913" upper="2.380738" />
    <dynamics damping="0.01" friction="0" />
  </joint>
  <joint name="drive_fr_joint" type="continuous">
    <parent link="v5_fr_steer_link_0" />
    <child link="v5_fr_wheel_link_0" />
    <origin xyz="0 0.0269 0" rpy="0 0 0" />
    <axis xyz="0 1 0" />
    <limit effort="3.0" velocity="7.9137" />
    <dynamics damping="0.01" friction="0" />
  </joint>
  <joint name="steer_rl_joint" type="revolute">
    <parent link="base_link" />
    <child link="v5_rl_steer_link_0" />
    <origin xyz="-0.064 -0.112 -0.039" rpy="0 0 0" />
    <axis xyz="0 0 1" />
    <limit effort="4.1" velocity="4.7962" lower="-2.328583" upper="3.953068" />
    <dynamics damping="0.01" friction="0" />
  </joint>
  <joint name="drive_rl_joint" type="continuous">
    <parent link="v5_rl_steer_link_0" />
    <child link="v5_rl_wheel_link_0" />
    <origin xyz="0 -0.0269 0" rpy="0 0 0" />
    <axis xyz="0 1 0" />
    <limit effort="3.0" velocity="7.9137" />
    <dynamics damping="0.01" friction="0" />
  </joint>
  <joint name="steer_rr_joint" type="revolute">
    <parent link="base_link" />
    <child link="v5_rr_steer_link_0" />
    <origin xyz="0.064 -0.112 -0.039" rpy="0 0 0" />
    <axis xyz="0 0 1" />
    <limit effort="4.1" velocity="4.7962" lower="-0.776194" upper="5.505457" />
    <dynamics damping="0.01" friction="0" />
  </joint>
  <joint name="drive_rr_joint" type="continuous">
    <parent link="v5_rr_steer_link_0" />
    <child link="v5_rr_wheel_link_0" />
    <origin xyz="0 -0.0269 0" rpy="0 0 0" />
    <axis xyz="0 1 0" />
    <limit effort="3.0" velocity="7.9137" />
    <dynamics damping="0.01" friction="0" />
  </joint>
  <link name="base_footprint" />
  <joint name="base_footprint_fixed" type="fixed">
    <parent link="base_link" />
    <child link="base_footprint" />
    <origin xyz="0 0 -0.072" rpy="0 0 0" />
  </joint>
  <link name="imu_link" />
  <joint name="imu_link_fixed" type="fixed">
    <parent link="base_link" />
    <child link="imu_link" />
    <origin xyz="0.001 0.075 0.0558" rpy="0 0 1.5707963" />
  </joint>
  <link name="arm_base_link">
    <inertial>
      <origin xyz="-0.00415132607 -0.010952074 -0.0180586568" rpy="0 0 3.141592653589793" />
      <mass value="0.082" />
      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
    </inertial>
    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
  </link>
  <joint name="arm_mount_fixed" type="fixed">
    <parent link="base_link" />
    <child link="arm_base_link" />
    <origin xyz="0.0225499941511 0.0 0.127512411" rpy="0 0 -1.208484306590865" />
  </joint>
  <link name="arm_link1">
    <inertial>
      <origin xyz="0.000214663527 0.000452446131 0.0246135119" rpy="0 0 0" />
      <mass value="0.098407" />
      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
    </inertial>
    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
  </link>
  <link name="arm_link2">
    <inertial>
      <origin xyz="0.0304527158 0.00704105429 0.0996142267" rpy="0 0 0" />
      <mass value="0.138509" />
      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
    </inertial>
    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
  </link>
  <link name="arm_link3">
    <inertial>
      <origin xyz="0.0636767132 -0.0507622342 0.040063244" rpy="0 0 0" />
      <mass value="0.132745" />
      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
    </inertial>
    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
  </link>
  <link name="arm_link4_wrist">
    <inertial>
      <origin xyz="0.041579542 0.000607488191 -0.0239602612" rpy="0 0 0" />
      <mass value="0.090765" />
      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
    </inertial>
    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
  </link>
  <link name="arm_link5_wrist_roll">
    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
    <inertial>
      <origin xyz="0.031622244642 -0.0155729284527 -0.0131686116713" rpy="0 0 0" />
      <mass value="0.216231" />
      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
    </inertial>
  </link>
  <link name="gripper_finger_a">
    <inertial>
      <origin xyz="0.00868217813 -0.0135062975 -0.0145487284" rpy="0 0 0" />
      <mass value="0.017573" />
      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
    </inertial>
    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
  </link>
  <link name="gripper_finger_b">
    <inertial>
      <origin xyz="0.0157587188 0.00178277523 -0.0144018902" rpy="0 0 0" />
      <mass value="0.017815" />
      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
    </inertial>
    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
  </link>
  <joint name="arm_joint1" type="revolute">
    <parent link="arm_base_link" />
    <child link="arm_link1" />
    <origin xyz="0 0 0" rpy="0 0 0" />
    <axis xyz="-4.2922224e-20 1.22808217e-19 -1" />
    <limit lower="-5.062000" upper="2.615700" effort="4.1" velocity="4.8171" />
  </joint>
  <joint name="arm_joint2" type="revolute">
    <parent link="arm_link1" />
    <child link="arm_link2" />
    <origin xyz="-0.00818725488 -0.0172562701 0.0405" rpy="0 0 0" />
    <axis xyz="0.428652088 0.903469638 -3.60532141e-16" />
    <limit lower="-2.215300" upper="1.547700" effort="4.1" velocity="4.8171" />
  </joint>
  <joint name="arm_joint3" type="revolute">
    <parent link="arm_link2" />
    <child link="arm_link3" />
    <origin xyz="0.0564421339 0.0152810464 0.122412316" rpy="0 0 0" />
    <axis xyz="-0.428652088 -0.903469638 1.13101149e-15" />
    <limit lower="-2.182400" upper="1.431800" effort="4.1" velocity="4.8171" />
  </joint>
  <joint name="arm_joint5" type="revolute">
    <parent link="arm_link4_wrist" />
    <child link="arm_link5_wrist_roll" />
    <origin xyz="0.0468000374 -0.00117428823 -0.0456961436" rpy="0 0 0" />
    <axis xyz="-0.61750236 0.292974622 0.729970346" />
    <limit lower="-3.136300" upper="1.975000" effort="4.1" velocity="4.8171" />
  </joint>
  <joint name="arm_joint4" type="revolute">
    <parent link="arm_link3" />
    <child link="arm_link4_wrist" />
    <origin xyz="0.0837025426 -0.0817728306 0.0559203768" rpy="0 0 0" />
    <axis xyz="0.428652088 0.903469638 3.62556313e-15" />
    <limit lower="-2.861900" upper="0.904100" effort="4.1" velocity="4.8171" />
  </joint>
  <joint name="gripper_finger_a_joint" type="prismatic">
    <parent link="arm_link5_wrist_roll" />
    <child link="gripper_finger_a" />
    <origin xyz="0.0447943345 0.0319351454 -0.0461602038" rpy="0 0 0" />
    <axis xyz="0.428628063 0.903481036 -2.48981564e-05" />
    <limit lower="-0.021254" upper="0.010247" effort="1" velocity="0.1000" />
  </joint>
  <joint name="gripper_finger_b_joint" type="prismatic">
    <parent link="arm_link5_wrist_roll" />
    <child link="gripper_finger_b" />
    <origin xyz="0.00359776597 -0.0548948267 -0.0461602038" rpy="0 0 0" />
    <axis xyz="-0.428628063 -0.903481036 2.48981564e-05" />
    <limit lower="-0.021254" upper="0.010247" effort="1" velocity="0.1000" />
    <mimic joint="gripper_finger_a_joint" multiplier="1.0" offset="0" />
  </joint>
  <link name="d435_cad_front_frame" />
  <joint name="d435_cad_front_fixed" type="fixed">
    <parent link="arm_link5_wrist_roll" />
    <child link="d435_cad_front_frame" />
    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
    <origin xyz="0.0558718776 -0.0262351581 -0.0058396682" rpy="0.000000001 1.027718072 -0.443000320" />
  </joint>
  <link name="arm_top_plate_link">
    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
  </link>
  <joint name="arm_top_plate_mount" type="fixed">
    <parent link="base_link" />
    <child link="arm_top_plate_link" />
    <origin xyz="0 0 0" rpy="0 0 1.5707963267948966" />
  </joint>
  <link name="bottom_plate_link">
    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
  </link>
  <joint name="bottom_plate_mount" type="fixed">
    <parent link="base_link" />
    <child link="bottom_plate_link" />
    <origin xyz="0 0 0.0084" rpy="0 0 0" />
  </joint>
  <link name="lidar_front_link">
    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
  </link>
  <joint name="lidar_front_mount" type="fixed">
    <parent link="base_link" />
    <child link="lidar_front_link" />
    <origin xyz="0.11454702 -0.006 -0.043" rpy="0 0 3.14159265" />
  </joint>
  <link name="base_scan_front" />
  <joint name="base_scan_front_fixed" type="fixed">
    <parent link="lidar_front_link" />
    <child link="base_scan_front" />
    <origin xyz="0 0 0.031" rpy="0 0 0" />
  </joint>
  <link name="lidar_rear_link">
    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
  </link>
  <joint name="lidar_rear_mount" type="fixed">
    <parent link="base_link" />
    <child link="lidar_rear_link" />
    <origin xyz="-0.11454702 -0.006 -0.043" rpy="0 0 0" />
  </joint>
  <link name="base_scan_rear" />
  <joint name="base_scan_rear_fixed" type="fixed">
    <parent link="lidar_rear_link" />
    <child link="base_scan_rear" />
    <origin xyz="0 0 0.031" rpy="0 0 0" />
  </joint>
  <link name="battery_link">
    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
  </link>
  <joint name="battery_mount" type="fixed">
    <parent link="base_link" />
    <child link="battery_link" />
    <origin xyz="0.003 0.0005 0.009" rpy="0 0 0" />
  </joint>
  <link name="jetson_planned_link">
    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
  </link>
  <joint name="jetson_planned_mount" type="fixed">
    <parent link="base_link" />
    <child link="jetson_planned_link" />
    <origin xyz="-0.0054 -0.0475 -0.007617" rpy="0 0 -1.5707963" />
  </joint>
  <link name="gripper_park_stand_TEMP">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</link>
  <joint name="gripper_park_stand_mount" type="fixed">
    <parent link="base_link" />
    <child link="gripper_park_stand_TEMP" />
    <origin xyz="0.1008 0.00115 0.0915" rpy="0 0 0" />
  </joint>
  <link name="holder_front_right">
    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
  </link>
  <joint name="holder_front_right_mount" type="fixed">
    <parent link="base_link" />
    <child link="holder_front_right" />
    <origin xyz="0.09 -0.09 .0915" rpy="0 0 -0.7615313591935458" />
  </joint>
  <link name="holder_middle_right">
    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
  </link>
  <joint name="holder_middle_right_mount" type="fixed">
    <parent link="base_link" />
    <child link="holder_middle_right" />
    <origin xyz="0.03 -0.07 .0915" rpy="0 0 -0.32904118515343533" />
  </joint>
  <link name="holder_front_left">
    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
  </link>
  <joint name="holder_front_left_mount" type="fixed">
    <parent link="base_link" />
    <child link="holder_front_left" />
    <origin xyz="0.09 0.09 .0915" rpy="0 0 0.7631364032593321" />
  </joint>
  <link name="holder_middle_left">
    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
  </link>
  <joint name="holder_middle_left_mount" type="fixed">
    <parent link="base_link" />
    <child link="holder_middle_left" />
    <origin xyz="0.025 0.08 .0915" rpy="0 0 0.43607439722636343" />
  </joint>
  <link name="holder_rear_left">
    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
  </link>
  <joint name="holder_rear_left_mount" type="fixed">
    <parent link="base_link" />
    <child link="holder_rear_left" />
    <origin xyz="-0.09 0.09 .0915" rpy="0 0 0.762058342264611" />
  </joint>
  <link name="profile_camera_bracket_TEMP">
    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
  </link>
  <joint name="profile_camera_bracket_TEMP_mount" type="fixed">
    <parent link="profile_column_link" />
    <child link="profile_camera_bracket_TEMP" />
    <origin xyz="-0.110213045 -0.09580939 0.53649997" rpy="0 0 0.274506446118" />
  </joint>
  <link name="profile_fixing_plate_TEMP">
    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
  </link>
  <joint name="profile_fixing_plate_TEMP_mount" type="fixed">
    <parent link="base_link" />
    <child link="profile_fixing_plate_TEMP" />
    <origin xyz="-0.098 -0.101 0.0915" rpy="0 0 0" />
  </joint>
  <link name="profile_column_link">
    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
    <inertial>
      <origin xyz="-0.110258358486 -0.0956971033869 0.316499985" rpy="0 0 0" />
      <mass value="0.201981990747" />
      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
    </inertial>
  </link>
  <joint name="profile_column_mount" type="fixed">
    <parent link="profile_fixing_plate_TEMP" />
    <child link="profile_column_link" />
    <origin xyz="0.110213045 0.09580939 -0.0885" rpy="0 0 0" />
  </joint>
  <link name="d435_cad_optical_proxy_frame" />
  <joint name="d435_cad_optical_proxy_frame_fixed" type="fixed">
    <parent link="d435_cad_front_frame" />
    <child link="d435_cad_optical_proxy_frame" />
    <origin xyz="0 0 0" rpy="-1.57079633 0 -1.57079633" />
  </joint>
  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
  <link name="d435_color_optical_frame" />
  <joint name="d435_color_optical_fixed" type="fixed">
    <parent link="d435_cad_optical_proxy_frame" />
    <child link="d435_color_optical_frame" />
    <origin xyz="-0.0325 0 0" rpy="0 0 0" />
  </joint>
  <link name="holder_rear_center">
    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
  </link>
  <joint name="holder_rear_center_mount" type="fixed">
    <parent link="base_link" />
    <child link="holder_rear_center" />
    <origin xyz="-0.03 -0.075 .0915" rpy="0 0 -0.32942754577161754" />
  </joint>
  
  
  
  
  
  
  
  
  
  
  
  
  <link name="lidar_jetson_interface_board_link">
    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
  </link>
  <joint name="lidar_jetson_interface_board_link_mount" type="fixed">
    <parent link="base_link" />
    <child link="lidar_jetson_interface_board_link" />
    <origin xyz="0.11 0.049 0.0475" rpy="0 0 0" />
  </joint>
</robot>
