jejeong5976/Project2_Turtle_Ninja/ros2_ws/src/description/urdf/robot.urdf.xacro

<?xml version="1.0"?>
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
<robot name="ninja_turtle" xmlns:xacro="http://www.ros.org/wiki/xacro">

  <xacro:arg name="hardware" default="mock"/>
  <xacro:arg name="with_gripper_linkage" default="true" />
  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
  <xacro:arg name="arm_mount_x" default="0.0225499941511"/>
  <xacro:arg name="arm_mount_y" default="0.0"/>
  <xacro:arg name="arm_mount_z" default="0.166512411"/>
  <xacro:arg name="arm_mount_yaw" default="-1.208484306590865"/>
  <xacro:arg name="with_accessories" default="true"/>
  <xacro:arg name="hardware_map" default="$(find bringup)/config/hardware_map.yaml"/>
  <xacro:arg name="opencr_port" default="auto"/>   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
  <xacro:arg name="opencr_ports" default="auto"/>  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

  <xacro:property name="hw" value="${xacro.load_yaml('$(arg hardware_map)')}"/>
  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
  <xacro:arg name="mock_dynamics" default="false"/>
  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
  <xacro:arg name="lidar_front_x" default="0.1145"/>
  <xacro:arg name="lidar_front_y" default="0.0"/>
  <xacro:arg name="lidar_front_z" default="0.060"/>
  <xacro:arg name="lidar_front_yaw" default="3.14159265"/>
  <xacro:arg name="lidar_rear_x" default="-0.1145"/>
  <xacro:arg name="lidar_rear_y" default="0.0"/>
  <xacro:arg name="lidar_rear_z" default="0.060"/>
  <xacro:arg name="lidar_rear_yaw" default="0"/>
  <xacro:property name="mock_dynamics" value="${'$(arg mock_dynamics)' == 'true'}"/>
  <xacro:property name="opencr_ports" value="${dict([kv.split('=', 1) for kv in '$(arg opencr_ports)'.split(',') if '=' in kv])}"/>
  <xacro:property name="mesh" value="package://description/meshes"/>

  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
  <xacro:property name="wheel_r" value="0.033"/>       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
  <xacro:property name="module_x_front" value="0.060"/>
  <xacro:property name="module_x_rear" value="0.070"/>  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
  <xacro:property name="module_y" value="0.112"/> 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
  <xacro:property name="wheel_off" value="0.0269"/>    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
  <xacro:property name="plate_low" value="0.039"/>     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
  <xacro:property name="plate_top" value="0.1306"/>    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
  <xacro:property name="body_front" value="0.141"/>    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
  <xacro:property name="body_back" value="-0.133"/>    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
  <xacro:property name="body_half_w" value="0.133"/>   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

  <xacro:include filename="$(find description)/urdf/ros2_control.xacro"/>

  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
  <link name="base_footprint"/>
  <link name="base_link">
    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
    <inertial>
      <origin xyz="-0.000338 -0.000726 0.065100"/>
      <mass value="2.270004"/>
      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
    </inertial>
    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
    <xacro:unless value="$(arg with_accessories)">
      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
    </xacro:unless>
    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
    <xacro:unless value="$(arg with_accessories)">
      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
    </xacro:unless>
    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
    <xacro:unless value="$(arg with_accessories)">
      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
    </xacro:unless>
    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
    <xacro:unless value="$(arg with_accessories)">
      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
    </xacro:unless>
    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
    <xacro:macro name="lower_plate_support_visual" params="name y">
      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
    </xacro:macro>
    <xacro:if value="$(arg with_accessories)">
      <xacro:lower_plate_support_visual name="left" y="0.024"/>
      <xacro:lower_plate_support_visual name="right" y="-0.024"/>
    </xacro:if>

    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
    <xacro:macro name="steering_motor_visual" params="name x y yaw">
      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
    </xacro:macro>
    <xacro:steering_motor_visual name="fl" x="${-module_x_rear}" y="${module_y}" yaw="${pi/2}"/>
    <xacro:steering_motor_visual name="fr" x="${module_x_front}" y="${module_y}" yaw="${pi/2}"/>
    <xacro:steering_motor_visual name="rl" x="${-module_x_rear}" y="${-module_y}" yaw="${-pi/2}"/>
    <xacro:steering_motor_visual name="rr" x="${module_x_front}" y="${-module_y}" yaw="${-pi/2}"/>
    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
  </link>
  <joint name="base_joint" type="fixed">
    <parent link="base_footprint"/>
    <child link="base_link"/>
    <origin xyz="0 0 ${wheel_r}"/>   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
  </joint>

  <xacro:if value="$(arg with_accessories)">
  <link name="profile_fixing_plate_link">
    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
  </link>
  <link name="profile_link">
    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
    <inertial><origin xyz="-0.110258358486 -0.0956971033869 0.316499985" rpy="0 0 0" /><mass value="0.201981990747" />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</inertial>
  </link>
  <link name="profile_camera_bracket_link">
    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
  </link>
  <link name="gripper_park_stand_link">
    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
  </link>
  <joint name="profile_fixing_plate_link_mount" type="fixed"><parent link="base_link" /><child link="profile_fixing_plate_link" /><origin xyz="-0.098 -0.101 0.1305" rpy="0 0 0" /></joint>
  <joint name="profile_joint" type="fixed"><parent link="profile_fixing_plate_link" /><child link="profile_link" /><origin xyz="0.110213045 0.09580939 -0.0885" rpy="0 0 0" /></joint>
  <joint name="profile_camera_bracket_link_mount" type="fixed"><parent link="profile_link" /><child link="profile_camera_bracket_link" /><origin xyz="-0.110213045 -0.09580939 0.53649997" rpy="0 0 0.274506446118" /></joint>
  <joint name="gripper_park_stand_mount" type="fixed"><parent link="base_link" /><child link="gripper_park_stand_link" /><origin xyz="0.1008 0.00115 0.1305" rpy="0 0 0" /></joint>
    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
    <link name="rack_link">
      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
    </link>
    <joint name="rack_fixed" type="fixed"><parent link="base_link"/><child link="rack_link"/><origin xyz="-0.102 0.0671 0.1385" rpy="0 0 0"/></joint>
    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
    <xacro:property name="rack_flare" value="0.24663"/>
    <xacro:macro name="rack_wall" params="name part xyz rpy size">
      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
    </xacro:macro>
    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
    <xacro:macro name="rack_cell" params="name x y">
      <link name="rack_cell_${name}_link">
        <xacro:rack_wall name="${name}" part="wall_px" xyz="0.017 0 0.00625" rpy="0 0 0" size="0.002 0.036 0.0125"/>
        <xacro:rack_wall name="${name}" part="wall_nx" xyz="-0.017 0 0.00625" rpy="0 0 0" size="0.002 0.036 0.0125"/>
        <xacro:rack_wall name="${name}" part="wall_py" xyz="0 0.017 0.00625" rpy="0 0 0" size="0.032 0.002 0.0125"/>
        <xacro:rack_wall name="${name}" part="wall_ny" xyz="0 -0.017 0.00625" rpy="0 0 0" size="0.032 0.002 0.0125"/>
        <xacro:rack_wall name="${name}" part="flare_px" xyz="0.018825 0 0.01975" rpy="0 ${rack_flare} 0" size="0.00194 0.0397 0.01495"/>
        <xacro:rack_wall name="${name}" part="flare_nx" xyz="-0.018825 0 0.01975" rpy="0 ${-rack_flare} 0" size="0.00194 0.0397 0.01495"/>
        <xacro:rack_wall name="${name}" part="flare_py" xyz="0 0.018825 0.01975" rpy="${-rack_flare} 0 0" size="0.0397 0.00194 0.01495"/>
        <xacro:rack_wall name="${name}" part="flare_ny" xyz="0 -0.018825 0.01975" rpy="${rack_flare} 0 0" size="0.0397 0.00194 0.01495"/>
      </link>
      <joint name="rack_cell_${name}_fixed" type="fixed"><parent link="rack_link"/><child link="rack_cell_${name}_link"/><origin xyz="${x} ${y} -0.005" rpy="0 0 0"/></joint>
    </xacro:macro>
    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
    <xacro:rack_cell name="S1" x="0.000" y="0.045"/>     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
    <xacro:rack_cell name="S2" x="0.000" y="0.000"/>     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
    <xacro:rack_cell name="S3" x="0.060" y="0.045"/>     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
    <xacro:rack_cell name="S4" x="0.180" y="-0.183"/>    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
    <xacro:rack_cell name="S5" x="0.180" y="0.045"/>     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
    <xacro:rack_cell name="S6" x="0.120" y="0.045"/>     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
    <xacro:rack_cell name="S7" x="0.120" y="-0.183"/>    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
    <xacro:rack_cell name="S8" x="0.060" y="0.000"/>     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
    <xacro:rack_cell name="S9" x="0.180" y="-0.138"/>    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
    <xacro:rack_cell name="S10" x="0.180" y="0.000"/>    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
    <xacro:rack_cell name="S11" x="0.120" y="0.000"/>    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
    <xacro:rack_cell name="S12" x="0.120" y="-0.138"/>   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
  </xacro:if>

  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
  <xacro:macro name="swerve_module" params="name x y off visual_yaw:=0">
    <link name="steer_${name}_link">
      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
      <xacro:box_physics mass="0.10" sx="0.029" sy="0.043" sz="0.054" xyz="0 0 0.016"/>
      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
    </link>
    <joint name="steer_${name}_joint" type="revolute">
      <parent link="base_link"/>
      <child link="steer_${name}_link"/>
      <origin xyz="${x} ${y} 0"/>     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
      <axis xyz="0 0 1"/>
      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
      <xacro:property name="sm" value="${hw['motors'].get('steer_' + name + '_joint', dict())}"/>
      <xacro:if value="${sm.get('extended')}">   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
        <limit lower="${float(sm['cable_min_deg']) * pi / 180}" upper="${float(sm['cable_max_deg']) * pi / 180}" effort="3.0" velocity="5.0"/>
      </xacro:if>
      <xacro:if value="${sm.get('zero_tick') is not None and not sm.get('extended')}">
        <xacro:property name="ka" value="${float(sm.get('scale', 1.0)) * (0 - int(sm['zero_tick'])) * 2 * pi / 4096}"/>
        <xacro:property name="kb" value="${float(sm.get('scale', 1.0)) * (4095 - int(sm['zero_tick'])) * 2 * pi / 4096}"/>
        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
        <limit lower="${max(min(ka, kb), float(sm.get('cable_min_deg', -1e9)) * pi / 180)}" upper="${min(max(ka, kb), float(sm.get('cable_max_deg', 1e9)) * pi / 180)}" effort="3.0" velocity="5.0"/>
      </xacro:if>
      <xacro:if value="${sm.get('zero_tick') is None}">
        <limit lower="${-pi}" upper="${pi}" effort="3.0" velocity="5.0"/>
      </xacro:if>
    </joint>

    <link name="wheel_${name}_link">
      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
      <inertial><mass value="0.0284989"/>
        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
      </inertial>
      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
    </link>
    <joint name="drive_${name}_joint" type="continuous">
      <parent link="steer_${name}_link"/>
      <child link="wheel_${name}_link"/>
      <origin xyz="0 ${off} 0"/>
      <axis xyz="0 1 0"/>
    </joint>
  </xacro:macro>

  <xacro:swerve_module name="fl" x="${-module_x_rear}" y="${module_y}" off="${wheel_off}"/>
  <xacro:swerve_module name="fr" x="${module_x_front}" y="${module_y}" off="${wheel_off}" visual_yaw="${pi}"/>
  <xacro:swerve_module name="rl" x="${-module_x_rear}" y="${-module_y}" off="${-wheel_off}" visual_yaw="${pi}"/>
  <xacro:swerve_module name="rr" x="${module_x_front}" y="${-module_y}" off="${-wheel_off}"/>

  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
  <link name="imu_link"/>
  <joint name="imu_joint" type="fixed">
    <parent link="base_link"/>
    <child link="imu_link"/>
    <origin xyz="0.035 0.069 0.0948" rpy="0 0 1.5707963"/>
  </joint>

  <link name="base_scan"/>
  <joint name="scan_joint" type="fixed"><parent link="lidar_front_link"/><child link="base_scan"/><origin xyz="0 0 0" rpy="0 0 0"/></joint>
  <link name="lidar_front_link">
    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
  </link>
  <joint name="lidar_front_joint" type="fixed"><parent link="base_footprint"/><child link="lidar_front_link"/><origin xyz="$(arg lidar_front_x) $(arg lidar_front_y) $(arg lidar_front_z)" rpy="0 0 $(arg lidar_front_yaw)"/></joint>
  <link name="base_scan_front"/>
  <joint name="base_scan_front_joint" type="fixed"><parent link="lidar_front_link"/><child link="base_scan_front"/><origin xyz="0 0 0" rpy="0 0 0"/></joint>
  <link name="lidar_rear_link">
    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
  </link>
  <joint name="lidar_rear_joint" type="fixed"><parent link="base_footprint"/><child link="lidar_rear_link"/><origin xyz="$(arg lidar_rear_x) $(arg lidar_rear_y) $(arg lidar_rear_z)" rpy="0 0 $(arg lidar_rear_yaw)"/></joint>
  <link name="base_scan_rear"/>
  <joint name="base_scan_rear_joint" type="fixed"><parent link="lidar_rear_link"/><child link="base_scan_rear"/><origin xyz="0 0 0" rpy="0 0 0"/></joint>

  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
  <link name="link1">
    <inertial><origin xyz="-0.00415132607 -0.010952074 -0.0180586568" rpy="0 0 3.141592653589793" /><mass value="0.082" />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</inertial>
    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
  </link>
  <link name="link2">
    <inertial><origin xyz="0.000214663527 0.000452446131 0.0246135119" rpy="0 0 0" /><mass value="0.098407" />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</inertial>
    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
  </link>
  <link name="link3">
    <inertial><origin xyz="0.0304527158 0.00704105429 0.0996142267" rpy="0 0 0" /><mass value="0.138509" />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</inertial>
    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
  </link>
  <link name="link4">
    <inertial><origin xyz="0.0636767132 -0.0507622342 0.040063244" rpy="0 0 0" /><mass value="0.132745" />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</inertial>
    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
  </link>
  <link name="link5">
    <inertial><origin xyz="0.041579542 0.000607488191 -0.0239602612" rpy="0 0 0" /><mass value="0.090765" />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</inertial>
    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
  </link>
  <link name="wrist_link">
    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
    <xacro:unless value="$(arg with_gripper_linkage)">
    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
    </xacro:unless>
    <inertial><origin xyz="0.031622244642 -0.0155729284527 -0.0131686116713" rpy="0 0 0" /><mass value="0.216231" />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</inertial>
  </link>
  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
  <xacro:if value="$(arg with_gripper_linkage)">
    <link name="gripper_crank_link">
      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
    </link>
    <joint name="gripper_crank_joint" type="revolute"><parent link="wrist_link" /><child link="gripper_crank_link" /><origin xyz="0.0192560308655604 -0.009136042293253334 -0.04032044210465657" rpy="0.9286570308921239 0.09976950658531902 -1.084709416798092" /><axis xyz="0.6175023401994564 -0.2929746130211112 -0.7299703665035485" /><limit lower="-1.290744303827211" upper="0.5487568609631227" effort="0" velocity="1000" /></joint>
    <link name="gripper_left_rod_link">
      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
    </link>
    <joint name="gripper_left_rod_joint" type="revolute"><parent link="gripper_crank_link" /><child link="gripper_left_rod_link" /><origin xyz="0.0166411304345537 0.002862983975471935 0.001968785899468133" rpy="-0.6200899640021704 0.7436650506083438 0.8801201391939419" /><axis xyz="0.6175023401994564 -0.2929746130211112 -0.7299703665035485" /><limit lower="-0.3736772420719872" upper="1.250575271287316" effort="0" velocity="1000" /></joint>
    <link name="gripper_right_rod_link">
      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
    </link>
    <joint name="gripper_right_rod_joint" type="revolute"><parent link="gripper_crank_link" /><child link="gripper_right_rod_link" /><origin xyz="-0.006761092579914814 -0.007550579022409307 -0.01364831091835624" rpy="-0.6200899905872147 0.7436651279863109 0.8801202064386958" /><axis xyz="0.6175023401994564 -0.2929746130211112 -0.7299703665035485" /><limit lower="-0.3736772618533231" upper="1.250575319127795" effort="0" velocity="1000" /></joint>
  </xacro:if>
  <link name="gripper_left_link">
    <inertial><origin xyz="0.00868217813 -0.0135062975 -0.0145487284" rpy="0 0 0" /><mass value="0.017573" />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</inertial>
    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
  </link>
  <link name="gripper_right_link">
    <inertial><origin xyz="0.0157587188 0.00178277523 -0.0144018902" rpy="0 0 0" /><mass value="0.017815" />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</inertial>
    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
  </link>
  <joint name="arm_base_joint" type="fixed"><parent link="base_link" /><child link="link1" /><origin xyz="$(arg arm_mount_x) $(arg arm_mount_y) $(arg arm_mount_z)" rpy="0 0 $(arg arm_mount_yaw)" /></joint>
  <joint name="joint1" type="revolute"><parent link="link1" /><child link="link2" /><origin xyz="0 0 0" rpy="0 0 1.65192969333263" /><axis xyz="4.2922224e-20 -1.22808217e-19 1" /><limit lower="-3.14159265358979" upper="3.14159265358979" effort="4.1" velocity="4.8" /></joint>
  <joint name="joint2" type="revolute"><parent link="link2" /><child link="link3" /><origin xyz="-0.00818725488 -0.0172562701 0.0405" rpy="-0.0702715101621958 -0.146922948567712 0.00517367264559843" /><axis xyz="0.42865208814261 0.90346963830058 -3.60532141119947e-16" /><limit lower="-1.5" upper="1.5" effort="4.1" velocity="4.8" /></joint>
  <joint name="joint3" type="revolute"><parent link="link3" /><child link="link4" /><origin xyz="0.0564421339 0.0152810464 0.122412316" rpy="0.314942732921767 0.578400770037455 0.0944208666904185" /><axis xyz="0.42865208814261 0.90346963830058 -1.13101149037628e-15" /><limit lower="-1.5" upper="1.4" effort="4.1" velocity="4.8" /></joint>
  <joint name="joint4" type="revolute"><parent link="link4" /><child link="link5" /><origin xyz="0.0837025426 -0.0817728306 0.0559203768" rpy="0.100310507818748 0.208016764036196 0.0104796110834654" /><axis xyz="0.42865208814261 0.90346963830058 3.62556313120621e-15" /><limit lower="-1.7" upper="0.673475800587938" effort="4.1" velocity="4.8" /></joint>
  <joint name="joint5" type="revolute"><parent link="link5" /><child link="wrist_link" /><origin xyz="0.0468000374 -0.00117428823 -0.0456961436" rpy="0.0281770785855214 -0.0128000821217835 -0.0332370782500288" /><axis xyz="0.617502360067625 -0.292974622032085 -0.729970346079942" /><limit lower="-1.5708" upper="1.5708" effort="4.1" velocity="4.8" /></joint>
  <joint name="gripper_left_joint" type="prismatic"><parent link="wrist_link" /><child link="gripper_left_link" /><origin xyz="0.0363703506666601 0.0141787026983163 -0.0461597144674409" rpy="0 0 0" /><axis xyz="0.428628063 0.903481036 -2.48981564e-05" /><limit lower="-0.003" upper="0.0175" effort="1" velocity="4.8" /></joint>
  <joint name="gripper_right_joint" type="prismatic"><parent link="wrist_link" /><child link="gripper_right_link" /><origin xyz="0.0120217498033399 -0.0371383839983163 -0.0461606931325592" rpy="0 0 0" /><axis xyz="-0.428628063 -0.903481036 2.48981564e-05" /><limit lower="-0.003" upper="0.0175" effort="1" velocity="4.8" /><mimic joint="gripper_left_joint" multiplier="1.0" offset="0" /></joint>
  <link name="end_effector_link"/>
  <joint name="end_effector_joint" type="fixed"><parent link="wrist_link"/><child link="end_effector_link"/><origin xyz="0.070261725235 -0.0333357494 -0.1006159938" rpy="0 0 0"/></joint>
  <xacro:if value="$(arg with_accessories)">
  <link name="camera_link"/>
  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
  <joint name="camera_body_joint" type="fixed"><parent link="wrist_link" /><child link="camera_link" /><origin xyz="0.07285831910124538 -0.03358933820604513 -0.01335717514995661" rpy="-0.01555906262262852 1.249203250793414 -0.4626942145495506" /></joint>
  <link name="wrist_cam_color_optical_frame"/>
  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
  <joint name="camera_joint" type="fixed"><parent link="wrist_link"/><child link="wrist_cam_color_optical_frame"/><origin xyz="0.086934 -0.004296 -0.013517" rpy="-2.973050 0.011127 -2.000066"/></joint>
  <link name="wrist_cam_depth_optical_frame"/>
  <joint name="wrist_cam_depth_optical_joint" type="fixed"><parent link="wrist_link"/><child link="wrist_cam_depth_optical_frame"/><origin xyz="0.080572 -0.017984 -0.013716" rpy="-2.966714 0.000048 -1.992139"/></joint>
  <link name="camera_optical_frame"/>
  <joint name="camera_optical_joint" type="fixed"><parent link="wrist_cam_color_optical_frame"/><child link="camera_optical_frame"/><origin xyz="0 0 0" rpy="0 0 0"/></joint>
  <link name="d435_color_optical_frame"/> 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
  <joint name="d435_color_optical_alias" type="fixed"><parent link="wrist_cam_color_optical_frame"/><child link="d435_color_optical_frame"/><origin xyz="0 0 0" rpy="0 0 0"/></joint>
  <link name="birdeye_camera_link">
    <inertial><mass value="0.03" /><origin xyz="-7.95939647524e-10 4.86405549172e-09 -1.25984772614e-09" rpy="0 0 0" />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</inertial>
    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
  </link>
  <link name="birdeye_camera_optical_frame"/>
  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
  <joint name="birdeye_camera_joint" type="fixed"><parent link="profile_camera_bracket_link" /><child link="birdeye_camera_link" /><origin xyz="0.0555354645249 0.0065 0.0195025360476" rpy="0 0.523598775598 0" /></joint>
  <joint name="birdeye_camera_optical_joint" type="fixed"><parent link="birdeye_camera_link" /><child link="birdeye_camera_optical_frame" /><origin xyz="0 0 0" rpy="-1.57079632679 0 -1.57079632679" /></joint>
  </xacro:if>

  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
  <xacro:nt_buses buses="${hw['buses']}" hardware="$(arg hardware)"/>

  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
  <link name="jetson_link">
    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
  </link>
  <joint name="jetson_joint" type="fixed">
    <parent link="base_link" />
    <child link="jetson_link" />
    <origin xyz="-0.0054 -0.0475 0.031383" rpy="0 0 -1.5707963" />
  </joint>
  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
  <link name="opencr_drive_link">
    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
  </link>
  <joint name="opencr_drive_mount" type="fixed">
    <parent link="base_link" /><child link="opencr_drive_link" />
    <origin xyz="0.035 0.139 0.0465" rpy="0 0 0" />
  </joint>
  <link name="opencr_arm_link">
    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
  </link>
  <joint name="opencr_arm_mount" type="fixed">
    <parent link="base_link" /><child link="opencr_arm_link" />
    <origin xyz="-0.107 -0.028 0.039" rpy="0 0 0" />
  </joint>
  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
  <link name="lidar_board_center_link">
    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
  </link>
  <joint name="lidar_board_center_mount" type="fixed">
    <parent link="base_link" /><child link="lidar_board_center_link" />
    <origin xyz="-0.029 0.013 0.0864575" rpy="0 0 -0.052359877560" />
  </joint>
  <link name="lidar_board_front_right_link">
    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
  </link>
  <joint name="lidar_board_front_right_mount" type="fixed">
    <parent link="base_link" /><child link="lidar_board_front_right_link" />
    <origin xyz="0.099 -0.116 0.0864575" rpy="0 0 -0.087266462600" />
  </joint>
  <link name="battery_link">
    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
  </link>
  <joint name="battery_mount" type="fixed">
    <parent link="base_link" />
    <child link="battery_link" />
    <origin xyz="0.003 0.0005 0.048000" rpy="0 0 0" />
  </joint>
  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
  <link name="bottom_plate_link">
    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
  </link>
  <joint name="bottom_plate_mount" type="fixed">
    <parent link="base_link" />
    <child link="bottom_plate_link" />
    <origin xyz="0 0 0.047400" rpy="0 0 0" />
  </joint>
</robot>
