jejeong5976/Project2_Turtle_Ninja/config/controllers.yaml

# controllers.yaml — ros2_control 이 돌릴 "기성 컨트롤러" 고르기
# =============================================================================
# 기성 컨트롤러는 계산 코드 없이 이름만 골라 적는다. 컨트롤러 = 토픽/액션을 받아 관절 명령으로 바꾸는 부품.
#
#   joint_state_broadcaster : 모든 관절 상태 → /joint_states
#   swerve_controller       : ★ swerve_controller/SwerveController. /cmd_vel → 조향 4 + 바퀴 4, /odom + TF
#                             cmd_vel 끊김 · 차례 · 조향 먼저를 100 Hz 루프 안에서 (D8 — 보내는 노드가 멈춰도 여기서 멈춤)
#   arm_controller          : /arm_controller/follow_joint_trajectory      ← control_master · (나중에) MoveIt
#   gripper_controller      : /gripper_controller/follow_joint_trajectory  ← control_master
#   imu_sensor_broadcaster  : OpenCR 내장 IMU → /imu_sensor_broadcaster/imu  (hardware:=opencr 일 때만 켬, D12)
#
# ⚠ 관절 이름 · 순서는 hardware_map.yaml · control.yaml 과 같아야 함 (fl, fr, rl, rr)

controller_manager:
  ros__parameters:
    update_rate: 100   # [Hz] 모터 읽기 → 컨트롤러 → 모터 쓰기 를 1초에 100번 (펌웨어 주기와 같음)

    joint_state_broadcaster:
      type: joint_state_broadcaster/JointStateBroadcaster
    swerve_controller:
      type: swerve_controller/SwerveController
    arm_controller:
      type: joint_trajectory_controller/JointTrajectoryController
    gripper_controller:
      type: joint_trajectory_controller/JointTrajectoryController
    imu_sensor_broadcaster:
      type: imu_sensor_broadcaster/IMUSensorBroadcaster

# ⚠ Jazzy 부터 컨트롤러는 controller_manager 의 설정을 물려받지 않음 → robot.launch.py 가 spawner 마다
#   --param-file 로 이 파일을 넘김 (Jazzy 부터 컨트롤러가 controller_manager 설정을 안 물려받아서, 없으면 joints 를 못 받음)

swerve_controller:
  ros__parameters:
    # 모듈 순서 fl, fr, rl, rr → 관절 이름 steer_<이름>_joint / drive_<이름>_joint 로 자동
    module_names: ["fl", "fr", "rl", "rr"]
    # 실물 기하 — URDF(robot.urdf.xacro) module_x_front 0.060 · module_x_rear 0.070 · module_y 0.112 · wheel_off 와 같은 값
    #   앞 = +X (라이다 쪽), 왼쪽 = +Y. 관절 이름 fl · fr · rl · rr 은 옛 위치 이름을 그대로 씀 (아래 순서가 실제 위치)
    #   실측: 좌우 조향축 224 mm · 앞뒤 130 mm · 앞 모듈이 뒤보다 몸체 안쪽으로 약 10 mm
    #     → 몸체 가운데(base_footprint) 에서 앞 모듈 +60 · 뒤 모듈 −70 mm
    #   offset: 바퀴가 조향축에서 떨어진 쪽 (+ = 바퀴 굴림 방향의 왼쪽). 왼쪽 모듈(fl · fr) +, 오른쪽 모듈(rl · rr) − (바퀴가 바깥쪽)
    module_x: [-0.070, 0.060, -0.070, 0.060]           # [m] 조향축 위치 앞(+) 뒤(-)
    module_y: [0.112, 0.112, -0.112, -0.112]           # [m] 왼(+) 오른(-)
    module_offset: [0.0269, 0.0269, -0.0269, -0.0269]  # [m] 바퀴가 조향축에서 바깥쪽으로 (D14)
    wheel_radius: 0.033                                # [m] 바퀴 반지름 (CAD 33.0 mm)
    steer_limit: 3.14159           # [rad] 영점(zero_tick) 없는 지도(mock)일 때만 쓰는 공통 범위 ±π. 넘는 목표는 반대쪽 + 바퀴 거꾸로 (D19)
    # 모듈별 범위 steer_min / steer_max (순서 fl, fr, rl, rr · rad · 관절 각): 여기 적지 않음.
    #   launch(swerve_setup)가 hardware_map 의 zero_tick · scale · 선 한계(cable_*_deg)로 계산해 arm:=true · false 모두 넘김
    # 한 모듈이라도 가능한 각도/역회전 조합이 없으면 전체 구동 0, 조향 현재 위치 유지.

    # ---- 안전 ----
    cmd_timeout_s: 0.3             # /cmd_vel 이 이만큼 끊기면 목표 0 (이 루프 안에서 — 보내는 쪽이 죽어도)
    cmd_vel_topic: /cmd_vel        # Nav2 · teleop 은 TwistStamped 로 보낼 것 (D11)
    motion_mode_topic: /control/motion_mode
    require_motion_mode: true      # control_master 가 DRIVE 라고 할 때만 움직임 (D15). 바퀴만 시험할 땐 false
    turn_timeout_s: 0.5            # 차례가 이만큼 안 오면 잠금 (control_master 가 10 Hz 로 보냄 — 죽거나 끊기면 바퀴 정지)
    motion_mode_ack_topic: /control/motion_mode_ack   # "이 요청 번호로 잠갔음" 답 → control_master 가 받아야 팔 시작

    # ---- 속도 ----
    max_linear: 0.255              # [m/s] 주행 0.255 (2026-11-06 사용자, 옛 0.2). 하드웨어 끝 0.261 (바퀴 7.9 rad/s) 의 98 % → 이동 + 회전이면 같은 비율로 줄어듦, 배터리 11.1 V 면 약 0.245 (실물 측정 필요)
    max_angular: 0.5               # [rad/s]
    max_wheel_speed: 7.9           # [rad/s] 바퀴 모터 한계 (XM430-W210 Velocity Limit 330 × 0.229 rpm = 7.91). 넘으면 네 바퀴를 같은 비율로 줄임
                                   #   (다이나믹셀은 한계를 넘는 속도 명령을 무시하고 이전 속도로 계속 돎). 0.2 m/s 에선 약 6.1 rad/s 라 닿지 않음
    # 실물 바닥 비교로 정함 (예전 0.2 / 0.8):
    #   0.2 / 0.8 은 방향 전환이 늦고(ㄹ자 0.40) 바퀴끼리 끌림(구동 729 mA) → 0.5 / 2.0 (제한 없음은 덜컹거림)
    max_linear_accel: 0.5          # [m/s²]
    max_angular_accel: 2.0         # [rad/s²]
    # 자세 고를 때 "돌아야 할 각도 × 2" 를 비용에 더함 (0 = 예전). 범위 끝에서 314° 크게 도는 것 없앰
    steer_travel_weight: 2.0
    # 정면 유지 (자이로 되먹임, 최대 0.15 rad/s, 0.5° 이하 무시): 끝 방향 오차 7~8° → 0.5° 안팎
    heading_hold_kp: 2.0           # [1/s]
    heading_hold_wz_per_speed: 0.4 # 보정 회전 ≤ 0.4 × 이동 속도 (0.05 m/s 에서 조향 흔들림 관찰)
    # 가지 고르기 보강 (모의 36 방향 seed 87419: 뒤집힘 9 → 4, 출발 지연 최대 1.12 → 0.86 s, 정확도 그대로.
    #   설정 찾기 30 조합 × 순서 6 에서 한도 90° 가 뒤집힘 · 총 시간 모두 좋음).
    steer_coherent_max_travel: 1.5708   # [rad] 90°. 공통 자세로 맞추려면 이보다 크게 도는 바퀴가 있으면 바퀴별로 (0 = 끔)
    steer_end_guard: 0.2618             # [rad] 15°. 멈춘 상태에서 고를 때 범위 끝 15° 안쪽 가지에 벌점 (주행 중 옆 보정 ≤ 약 17° 대비, 0 = 끔)
    keep_branch_max_wz: 0.2             # [rad/s] 이동 중 이 이하 회전(정면 유지 · 추종기 보정)이 가지를 바꾸게 하면 줄임 (0 = 끔)
    cosine_scale: true

    # ---- 조향 먼저, 구동 나중 (D15) ----
    steer_then_drive: true
    steer_tolerance: 0.17          # [rad] ≈ 10°
    roll_while_steering: true      # 조향만 도는 동안 바퀴를 offset 만큼 따라 굴림 (D14). 이때 바퀴 모터도 조금 힘을 씀
    # 정지 후 바깥쪽 자세(조향 0°) 복귀 — 기본 끔. 신선한 0 명령 + 바퀴 차례 + 실측 바퀴 정지가 park_idle_s 이어질 때만.
    #   명령 끊김 · 상태 못 읽음 · 컨트롤러 끄기에서는 시작 안 함. 바퀴는 roll_while_steering 보상만 (launch park_on_idle:=true)
    park_on_idle: false
    park_idle_s: 1.0               # [s]
    park_still_wheel: 0.05         # [rad/s]
    steer_rate_source: reported    # position: OpenCR 보드 시각 기반 60 ms 위치 추정 (ROS 실물 검증 전, 선택 옵션)

    # ---- odom (회전은 IMU 자이로, D12) ----
    odom_frame: odom
    base_frame: base_footprint
    publish_tf: true               # odom → base_footprint (EKF 를 쓰면 false)
    odom_rate_hz: 50.0
    use_imu: true                  # 안 오면 (mock) 자동으로 바퀴 계산
    imu_topic: /imu_sensor_broadcaster/imu
    imu_bias_time_s: 5.0           # 켠 뒤 멈춰 있는 5 s 평균 = 자이로 바이어스 (잡음 0.07 ~ 0.16°/s)
    imu_still_hold_s: 1.0          # 그 뒤 멈춘 지 1 s 지나야 바이어스 따라감 (멈춘 직후 남은 회전까지 배우면 직진 1 m 마다 약 1° 틀어짐)
    imu_track_gate: 0.0087         # [rad/s] 바이어스 뺀 값 0.5°/s 안일 때만 따라감
    imu_timeout_s: 0.2
    still_linear: 0.01
    still_angular: 0.05

arm_controller:
  ros__parameters:
    joints: [joint1, joint2, joint3, joint4, joint5]   # joint5 = 손목 비틀기 (6축 손목)
    command_interfaces: [position]
    state_interfaces: [position, velocity]
    allow_partial_joints_goal: true
    # 목표 오차 검사. 없으면 JTC 의 기본 허용값이 0 = "검사 안 함" 이라서
    #   관절이 걸려 목표에 못 가도 시간만 지나면 성공을 돌려줌 (Codex 재현: 어깨 고정 → HOME 성공)
    #   goal_time: 궤적 끝 시각 뒤 이 시간 안에 모든 관절이 goal 오차 안 + 거의 멈춤이 아니면 실패 (GOAL_TOLERANCE_VIOLATED)
    #   ⚠ 값은 잠정 — 실물에서 HOME · 집기 자세의 처짐(중력) · 모터 분해능을 재고 다시 정할 것
    #   바퀴를 풀어도 되는지는 control_master 가 /joint_states 로 한 번 더 확인 (fold_tolerance, control.yaml)
    constraints:
      stopped_velocity_tolerance: 0.05   # [rad/s] XM430 속도 눈금 1 칸 ≈ 0.024 rad/s → 기본 0.01 이면 떨림만으로 실패할 수 있음
      goal_time: 1.0                     # [s]
      joint1: {trajectory: 0.0, goal: 0.05}   # [rad] ≈ 2.9°. trajectory 0 = 가는 도중 오차는 안 봄
      joint2: {trajectory: 0.0, goal: 0.12}   # 어깨 · 팔꿈치는 처짐 앞먹임 명령과 실제 자세가 0.06 rad 까지 다름 (실물 실행기와 같은 값)
      joint3: {trajectory: 0.0, goal: 0.12}
      joint4: {trajectory: 0.0, goal: 0.05}
      joint5: {trajectory: 0.0, goal: 0.05}

gripper_controller:
  ros__parameters:
    joints: [gripper_left_joint]   # 단위 m (손가락 이동). 오른쪽은 URDF mimic 으로 따라감
    command_interfaces: [position]
    state_interfaces: [position, velocity]
    # 그리퍼는 일부러 goal 오차 검사를 안 켬: 퍽을 쥐면 닫힘 목표(-0.005 m)에 못 미치는 게 정상이라
    #   팔과 같은 "위치 도달" 규칙을 쓰면 잘 잡았을 때 오히려 실패가 됨. 쥐었나 확인은 별도 규칙 (위치 · 전류 · 정지 시간 · 카메라, TODO)

imu_sensor_broadcaster:
  ros__parameters:
    sensor_name: imu        # ros2_control.xacro 의 <sensor name="imu"> (hardware 플러그인이 채움)
    frame_id: imu_link      # URDF 의 imu_link (OpenCR 위치 · 방향 — 실제 붙인 방향과 맞출 것)
