jejeong5976/Project2_Turtle_Ninja/config/rack_look_paths.yaml

# LOOK_RACK 경로 — tools/arm_real/rack_look/gen_rack_look.py 가 config/arm_paths.yaml 에서 만듦. 손으로 고치지 말 것
#   look_rack_S: PICK 끝 → 관찰 자세 (퍽 쥔 채 칸 바닥 태그를 손목 카메라로) · store_look_S: 관찰 → 컵 입구 위 → 기록 넣기 → 받침
#   점 고르기 = MoveIt 충돌 검사 (seg_check.cpp, 머리말 gen_rack_look.py)
control_master:
  ros__parameters:
    arm_paths:
      look_rack_names: [look_rack_S1, store_look_S1, look_rack_S2, store_look_S2, look_rack_S3, store_look_S3, look_rack_S4, store_look_S4, look_rack_S5, store_look_S5, look_rack_S6, store_look_S6, look_rack_S7, store_look_S7, look_rack_S8, store_look_S8, look_rack_S9, store_look_S9, look_rack_S10, store_look_S10, look_rack_S11, store_look_S11, look_rack_S12, store_look_S12]
      # look_rack_S1: 기록 store_S1 0–1 → 관찰 (scan_LB2) 멈춤, 퍽 쥠
      look_rack_S1:
        ends_home: false
        nodes: ["lift", "lift_real", "rack_look"]
        q: [0.18408, 0.41417, -0.66575, 0.18868, 0.20862, 0.12272, 0.17334, -0.69336, 0.15647, -0.01074, 2.35837, -0.58035, -0.09174, 0.20469, -0.03038]
        stand: [false, false, false]
        speed: [0.0, 0.0, 0.0]
        grip: ["-", "-", "-"]
        stop: [false, false, true]
        hold: [0.0, 0.0, 0.0]
      # store_look_S1: 관찰 → 기록 store_S1 140 (컵 입구 위, 놓기 149) → 끝 (받침)
      store_look_S1:
        ends_home: true
        nodes: ["rack_look", "r140", "r141", "r142", "r143", "r144", "r145", "r146", "r147", "r148", "in_cell", "r150", "r151", "r152", "r153", "r154", "r155", "r156", "r157", "r158", "r159", "r160", "r161", "r162", "r163", "r164", "r165", "r166", "r167", "r168", "r169", "r170", "out_cell", "r172", "r173", "r174", "r175", "r176", "r177", "r178", "r179", "r180", "r181", "r182", "r183", "r184", "r185", "r186", "r187", "r188", "r189", "r190", "r191", "r192", "r193", "r194", "r195", "r196", "r197", "r198", "r199", "r200", "r201", "r202", "r203", "r204", "r205", "r206", "r207", "r208", "r209", "r210", "r211", "r212", "r213", "r214", "r215", "r216", "r217", "r218", "r219", "r220", "r221", "r222", "r223", "r224", "r225", "r226", "r227", "r228", "r229", "r230", "r231", "r232", "r233", "r234", "r235", "r236", "r237", "r238", "r239", "r240", "r241", "r242", "r243", "r244", "r245", "r246", "r247", "r248", "r249", "r250", "r251", "r252", "r253", "r254", "r255", "r256", "r257", "r258", "r259", "r260", "r261", "r262", "r263", "r264", "r265", "r266", "r267", "r268", "r269", "r270", "r271", "r272", "r273", "r274", "r275", "r276", "r277", "r278", "r279", "r280", "r281", "r282", "r283", "r284", "r285", "r286", "r287", "r288", "r289", "r290", "r291", "r292", "r293", "r294", "r295", "r296", "r297", "r298", "r299", "r300", "r301", "r302", "r303", "r304", "r305", "r306", "r307", "r308", "r309", "r310", "r311", "r312", "r313", "r314", "r315", "r316", "r317", "r318", "r319", "r320", "r321", "r322", "r323", "r324", "r325", "r326", "r327", "r328", "r329", "r330", "r331", "r332", "r333", "r334", "r335", "r336", "r337", "r338", "r339", "r340", "r341", "r342", "r343", "r344", "r345", "r346", "r347", "r348", "r349", "r350", "r351", "r352", "r353", "r354", "r355", "r356", "r357", "r358", "r359", "r360", "r361", "r362", "r363", "r364", "r365", "r366", "r367", "r368", "r369", "r370", "r371", "r372", "r373", "P0_복귀", "rJ1a_복귀", "rJ2_1_복귀", "rJ2_2_복귀", "rJ2_3_복귀", "rJ2_4_복귀", "rJ1b_복귀", "rJ4_복귀", "r1_복귀", "r2_복귀", "r3_복귀", "r4_복귀", "r5_복귀", "r6_복귀", "r7_복귀", "받침_복귀"]
        q: [2.35837, -0.58035, -0.09174, 0.20469, -0.03038, 2.29997, 0.22462, -0.92699, 0.54114, 0.72703, 2.30008, 0.24823, -0.92918, 0.54155, 0.72695, 2.30073, 0.25499, -0.90878, 0.51755, 0.72910, 2.30265, 0.25555, -0.88380, 0.49515, 0.72946, 2.30112, 0.25506, -0.86112, 0.48075, 0.72940, 2.30112, 0.24485, -0.83771, 0.46598, 0.72941, 2.30127, 0.23290, -0.81397, 0.44796, 0.72961, 2.30281, 0.22719, -0.78877, 0.43160, 0.72959, 2.30114, 0.20275, -0.77093, 0.42260, 0.72959, 2.29956, 0.19670, -0.76959, 0.42264, 0.72957, 2.29898, 0.19806, -0.79070, 0.44703, 0.72896, 2.29887, 0.19893, -0.81558, 0.46480, 0.72738, 2.29877, 0.19820, -0.83883, 0.48097, 0.72735, 2.29870, 0.20219, -0.86066, 0.49570, 0.72884, 2.29849, 0.21243, -0.88564, 0.51510, 0.72858, 2.29846, 0.22094, -0.90875, 0.52970, 0.72856, 2.29850, 0.22614, -0.93150, 0.54256, 0.72864, 2.30925, 0.22437, -0.90692, 0.52914, 0.73931, 2.31515, 0.22176, -0.88192, 0.51923, 0.74510, 2.32406, 0.20296, -0.85731, 0.51031, 0.75251, 2.33137, 0.18599, -0.83166, 0.50161, 0.75982, 2.33866, 0.18470, -0.80775, 0.49459, 0.76699, 2.34601, 0.15966, -0.78617, 0.48713, 0.77444, 2.35484, 0.13939, -0.76021, 0.47834, 0.78483, 2.36518, 0.12832, -0.73564, 0.47108, 0.79512, 2.37385, 0.10494, -0.71124, 0.46538, 0.80231, 2.38730, 0.08893, -0.68479, 0.45652, 0.81575, 2.39915, 0.06838, -0.66007, 0.44925, 0.82917, 2.41415, 0.05538, -0.63352, 0.44041, 0.84260, 2.42600, 0.03642, -0.60889, 0.43320, 0.85600, 2.44064, 0.01890, -0.58413, 0.43067, 0.87061, 2.44958, 0.009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
        hold: [0.0, 0.0, 0.0, 0.0, 0.0, 0.0, 0.0, 0.0, 0.0, 0.0, 0.0, 0.0, 0.0, 0.0, 0.0, 0.0, 0.0, 0.0, 0.0, 0.0, 0.0, 0.0, 0.0, 0.0, 0.0, 0.0, 0.0, 0.0, 0.0, 0.0, 0.0, 0.0, 0.0, 0.0, 0.0, 0.0, 0.0, 0.0, 0.0, 0.0, 0.0, 0.0, 0.0, 0.0, 0.0, 0.0, 0.0, 0.0, 0.0, 0.0, 0.0, 0.0, 0.0, 0.0, 0.0, 0.0, 0.0, 0.0, 0.0, 0.0, 0.0, 0.0, 0.0, 0.0, 0.0, 0.0, 0.0, 0.0, 0.0, 0.0, 0.0, 0.0, 0.0, 0.0, 0.0, 0.0, 0.0, 0.0, 0.0, 0.0, 0.0, 0.0, 0.0, 0.0, 0.0, 0.0, 0.0, 0.0, 0.0, 0.0, 0.0, 0.0, 0.0, 0.0, 0.0, 0.0, 0.0, 0.0, 0.0, 0.0, 0.0, 0.0, 0.0, 0.0, 0.0, 0.0, 0.0, 0.0, 0.0, 0.0, 0.0, 0.0, 0.0, 0.0, 0.0, 0.0, 0.0, 0.0, 0.0, 0.0, 0.0, 0.0, 0.0, 0.0, 0.0, 0.0, 0.0, 0.0, 0.0, 0.0, 0.0, 0.0, 0.0, 0.0, 0.0, 0.0, 0.0, 0.0, 0.0, 0.0, 0.0, 0.0, 0.0, 0.0, 0.0, 0.0, 0.0, 0.0, 0.0, 0.0, 0.0, 0.0, 0.0, 0.0, 0.0, 0.0, 0.0, 0.0, 0.0, 0.0, 0.0, 0.0, 0.0, 0.0, 0.0, 0.0, 0.0, 0.0, 0.0, 0.0, 0.0, 0.0, 0.0, 0.0, 0.0, 0.0, 0.0, 0.0, 0.0, 0.0, 0.0, 0.0, 0.0, 0.0, 0.0, 0.0, 0.0, 0.0, 0.0, 0.0, 0.0, 0.0, 0.0, 0.0, 0.0, 0.0, 0.0, 0.0, 0.0, 0.0, 0.0, 0.0, 0.0, 0.0, 0.0, 0.0, 0.0, 0.0, 0.0, 0.0, 0.0, 0.0, 0.0, 0.0, 0.0, 0.0, 0.0, 0.0, 0.0, 0.0, 0.0, 0.0, 0.0, 0.0, 0.0, 0.0, 0.0, 0.0, 0.0, 0.0, 0.0, 0.0, 0.0, 0.0, 0.0, 0.0, 0.0, 0.0, 0.0, 0.0, 0.0, 0.0, 0.0, 0.0, 0.0, 0.0, 0.0, 0.0, 0.0, 0.0, 0.0]
      # look_rack_S2: 기록 store_S2 0–1 → 관찰 (scan_LB2) 멈춤, 퍽 쥠
      look_rack_S2:
        ends_home: false
        nodes: ["lift", "lift_real", "rack_look"]
        q: [0.18408, 0.41417, -0.66575, 0.18868, 0.20862, 0.30986, -0.40804, -0.28225, -0.17027, 0.28839, 2.35837, -0.58035, -0.09174, 0.20469, -0.03038]
        stand: [false, false, false]
        speed: [0.0, 0.0, 0.0]
        grip: ["-", "-", "-"]
        stop: [false, false, true]
        hold: [0.0, 0.0, 0.0]
      # store_look_S2: 관찰 → 기록 store_S2 144 (컵 입구 위, 놓기 155) → 끝 (받침)
      store_look_S2:
        ends_home: true
        nodes: ["rack_look", "r144", "r145", "r146", "r147", "r148", "r149", "r150", "r151", "r152", "r153", "r154", "in_cell", "r156", "r157", "r158", "r159", "r160", "r161", "r162", "r163", "r164", "r165", "r166", "r167", "r168", "out_cell", "r170", "r171", "r172", "r173", "r174", "r175", "r176", "r177", "r178", "r179", "r180", "r181", "r182", "r183", "r184", "r185", "r186", "r187", "r188", "r189", "r190", "r191", "r192", "r193", "r194", "r195", "r196", "r197", "r198", "r199", "r200", "r201", "r202", "r203", "r204", "r205", "r206", "r207", "r208", "r209", "r210", "r211", "r212", "r213", "r214", "r215", "r216", "r217", "r218", "r219", "r220", "r221", "r222", "r223", "r224", "r225", "r226", "r227", "r228", "r229", "r230", "r231", "r232", "r233", "r234", "r235", "r236", "r237", "r238", "r239", "r240", "r241", "r242", "r243", "r244", "r245", "r246", "r247", "r248", "r249", "r250", "r251", "r252", "r253", "r254", "r255", "r256", "r257", "r258", "r259", "r260", "r261", "r262", "r263", "r264", "r265", "r266", "r267", "r268", "r269", "r270", "r271", "r272", "r273", "r274", "r275", "r276", "r277", "r278", "r279", "r280", "r281", "r282", "r283", "r284", "r285", "r286", "r287", "r288", "r289", "r290", "r291", "r292", "r293", "r294", "r295", "r296", "r297", "r298", "r299", "r300", "r301", "r302", "r303", "r304", "r305", "r306", "r307", "r308", "r309", "r310", "r311", "r312", "r313", "r314", "r315", "r316", "r317", "r318", "r319", "r320", "r321", "r322", "r323", "r324", "r325", "r326", "r327", "r328", "r329", "r330", "r331", "r332", "r333", "r334", "r335", "r336", "r337", "r338", "r339", "r340", "r341", "r342", "r343", "r344", "r345", "r346", "r347", "r348", "r349", "r350", "r351", "r352", "r353", "r354", "r355", "r356", "r357", "r358", "r359", "r360", "r361", "r362", "r363", "r364", "r365", "r366", "r367", "r368", "r369", "r370", "r371", "r372", "r373", "r374", "r375", "r376", "r377", "r378", "r379", "r380", "r381", "r382", "r383", "r384", "r385", "r386", "r387", "r388", "r389", "r390", "r391", "r392", "r393", "r394", "r395", "r396", "r397", "r398", "r399", "r400", "r401", "r402", "r403", "r404", "r405", "r406", "P0_복귀", "rJ1a_복귀", "rJ2_1_복귀", "rJ2_2_복귀", "rJ2_3_복귀", "rJ2_4_복귀", "rJ1b_복귀", "rJ4_복귀", "r1_복귀", "r2_복귀", "r3_복귀", "r4_복귀", "r5_복귀", "r6_복귀", "r7_복귀", "받침_복귀"]
        q: [2.35837, -0.58035, -0.09174, 0.20469, -0.03038, 2.54632, 0.00294, -0.65464, 0.51642, 0.95618, 2.54671, -0.00264, -0.62818, 0.49248, 0.95964, 2.54390, -0.00207, -0.60452, 0.47134, 0.95526, 2.54389, -0.00155, -0.58080, 0.45640, 0.95979, 2.54404, -0.00113, -0.55540, 0.43677, 0.95531, 2.54426, -0.00073, -0.52995, 0.41559, 0.95549, 2.54435, -0.00492, -0.50621, 0.39760, 0.95557, 2.54430, -0.01827, -0.48136, 0.38145, 0.95555, 2.54451, -0.02871, -0.45922, 0.36200, 0.95735, 2.54444, -0.03139, -0.43381, 0.34548, 0.95570, 2.54428, -0.03712, -0.40856, 0.33060, 0.96011, 2.54440, -0.05236, -0.39701, 0.32035, 0.95572, 2.54459, -0.05271, -0.42108, 0.33392, 0.95905, 2.54445, -0.05299, -0.44520, 0.35366, 0.95587, 2.54450, -0.04569, -0.47044, 0.37006, 0.95900, 2.54433, -0.03988, -0.49425, 0.38961, 0.95729, 2.54431, -0.03413, -0.51798, 0.40603, 0.95881, 2.54423, -0.02531, -0.54003, 0.42237, 0.95871, 2.54419, -0.01810, -0.56358, 0.43870, 0.95868, 2.54390, -0.01541, -0.58739, 0.45980, 0.95839, 2.54389, -0.00831, -0.61227, 0.47603, 0.95839, 2.54387, -0.00125, -0.63707, 0.49222, 0.95838, 2.54351, 0.00596, -0.65900, 0.51313, 0.95798, 2.54372, 0.01588, -0.68332, 0.52445, 0.95821, 2.54323, 0.02300, -0.70660, 0.54833, 0.95767, 2.54329, 0.03298, -0.72639, 0.55969, 0.95772, 2.57160, 0.01455, -0.72514, 0.55833, 0.96469, 2.58734, -0.01359, -0.72580, 0.55617, 0.97300, 2.59645, -0.03814, -0.72701, 0.56025, 0.97771, 2.60898, -0.06291, -0.72949, 0.55967, 0.98590, 2.62175, -0.08801, -0.74220, 0.55880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
        hold: [0.0, 0.0, 0.0, 0.0, 0.0, 0.0, 0.0, 0.0, 0.0, 0.0, 0.0, 0.0, 0.0, 0.0, 0.0, 0.0, 0.0, 0.0, 0.0, 0.0, 0.0, 0.0, 0.0, 0.0, 0.0, 0.0, 0.0, 0.0, 0.0, 0.0, 0.0, 0.0, 0.0, 0.0, 0.0, 0.0, 0.0, 0.0, 0.0, 0.0, 0.0, 0.0, 0.0, 0.0, 0.0, 0.0, 0.0, 0.0, 0.0, 0.0, 0.0, 0.0, 0.0, 0.0, 0.0, 0.0, 0.0, 0.0, 0.0, 0.0, 0.0, 0.0, 0.0, 0.0, 0.0, 0.0, 0.0, 0.0, 0.0, 0.0, 0.0, 0.0, 0.0, 0.0, 0.0, 0.0, 0.0, 0.0, 0.0, 0.0, 0.0, 0.0, 0.0, 0.0, 0.0, 0.0, 0.0, 0.0, 0.0, 0.0, 0.0, 0.0, 0.0, 0.0, 0.0, 0.0, 0.0, 0.0, 0.0, 0.0, 0.0, 0.0, 0.0, 0.0, 0.0, 0.0, 0.0, 0.0, 0.0, 0.0, 0.0, 0.0, 0.0, 0.0, 0.0, 0.0, 0.0, 0.0, 0.0, 0.0, 0.0, 0.0, 0.0, 0.0, 0.0, 0.0, 0.0, 0.0, 0.0, 0.0, 0.0, 0.0, 0.0, 0.0, 0.0, 0.0, 0.0, 0.0, 0.0, 0.0, 0.0, 0.0, 0.0, 0.0, 0.0, 0.0, 0.0, 0.0, 0.0, 0.0, 0.0, 0.0, 0.0, 0.0, 0.0, 0.0, 0.0, 0.0, 0.0, 0.0, 0.0, 0.0, 0.0, 0.0, 0.0, 0.0, 0.0, 0.0, 0.0, 0.0, 0.0, 0.0, 0.0, 0.0, 0.0, 0.0, 0.0, 0.0, 0.0, 0.0, 0.0, 0.0, 0.0, 0.0, 0.0, 0.0, 0.0, 0.0, 0.0, 0.0, 0.0, 0.0, 0.0, 0.0, 0.0, 0.0, 0.0, 0.0, 0.0, 0.0, 0.0, 0.0, 0.0, 0.0, 0.0, 0.0, 0.0, 0.0, 0.0, 0.0, 0.0, 0.0, 0.0, 0.0, 0.0, 0.0, 0.0, 0.0, 0.0, 0.0, 0.0, 0.0, 0.0, 0.0, 0.0, 0.0, 0.0, 0.0, 0.0, 0.0, 0.0, 0.0, 0.0, 0.0, 0.0, 0.0, 0.0, 0.0, 0.0, 0.0, 0.0, 0.0, 0.0, 0.0, 0.0, 0.0, 0.0, 0.0, 0.0, 0.0, 0.0, 0.0, 0.0, 0.0, 0.0, 0.0, 0.0, 0.0, 0.0, 0.0, 0.0, 0.0, 0.0, 0.0, 0.0, 0.0, 0.0, 0.0, 0.0, 0.0, 0.0, 0.0, 0.0, 0.0, 0.0, 0.0, 0.0, 0.0, 0.0, 0.0]
      # look_rack_S3: 기록 store_S3 0–8 → 관찰 (scan_LB1) 멈춤, 퍽 쥠
      look_rack_S3:
        ends_home: false
        nodes: ["lift", "lift_real", "r2", "r3", "r4", "r5", "r6", "r7", "r8", "rack_look"]
        q: [0.18408, 0.41417, -0.66575, 0.18868, 0.20862, 0.23163, 0.36662, -0.73478, 0.22089, 0.19635, 0.24697, 0.35435, -0.73478, 0.22856, 0.17181, 0.26231, 0.34054, -0.73324, 0.23623, 0.14573, 0.27612, 0.32981, -0.73478, 0.24390, 0.11505, 0.28839, 0.32367, -0.73478, 0.25157, 0.08897, 0.30219, 0.32214, -0.73478, 0.25771, 0.06443, 0.31447, 0.31447, -0.73478, 0.26538, 0.03988, 0.32827, 0.30373, -0.73324, 0.27151, 0.01534, 1.90522, -0.84783, 0.00736, 0.39323, -0.03038]
        stand: [false, false, false, false, false, false, false, false, false, false]
        speed: [0.0, 0.0, 0.0, 0.0, 0.0, 0.0, 0.0, 0.0, 0.0, 0.0]
        grip: ["-", "-", "-", "-", "-", "-", "-", "-", "-", "-"]
        stop: [false, false, false, false, false, false, false, false, false, true]
        hold: [0.0, 0.0, 0.0, 0.0, 0.0, 0.0, 0.0, 0.0, 0.0, 0.0]
      # store_look_S3: 관찰 → 기록 store_S3 88 (컵 입구 위, 놓기 104) → 끝 (받침)
      store_look_S3:
        ends_home: true
        nodes: ["rack_look", "r88", "r89", "r90", "r91", "r92", "r93", "r94", "r95", "r96", "r97", "r98", "r99", "r100", "r101", "r102", "r103", "in_cell", "r105", "r106", "r107", "r108", "r109", "r110", "r111", "r112", "r113", "r114", "r115", "r116", "r117", "r118", "out_cell", "r120", "r121", "r122", "r123", "r124", "r125", "r126", "r127", "r128", "r129", "r130", "r131", "r132", "r133", "r134", "r135", "r136", "r137", "r138", "r139", "r140", "r141", "r142", "r143", "r144", "r145", "r146", "r147", "r148", "r149", "r150", "r151", "r152", "r153", "r154", "r155", "r156", "r157", "r158", "r159", "r160", "r161", "r162", "r163", "r164", "r165", "r166", "r167", "r168", "r169", "r170", "r171", "r172", "r173", "r174", "r175", "r176", "r177", "r178", "r179", "r180", "r181", "r182", "r183", "r184", "r185", "r186", "r187", "r188", "r189", "r190", "r191", "r192", "r193", "r194", "r195", "r196", "r197", "r198", "r199", "r200", "r201", "r202", "r203", "r204", "r205", "r206", "r207", "r208", "r209", "r210", "r211", "r212", "r213", "r214", "r215", "r216", "r217", "r218", "r219", "r220", "r221", "r222", "r223", "r224", "r225", "r226", "r227", "r228", "r229", "r230", "r231", "r232", "r233", "r234", "r235", "r236", "r237", "r238", "r239", "r240", "r241", "r242", "r243", "r244", "r245", "r246", "r247", "r248", "r249", "r250", "r251", "r252", "r253", "r254", "r255", "r256", "r257", "r258", "r259", "r260", "r261", "r262", "r263", "r264", "r265", "r266", "r267", "r268", "r269", "r270", "r271", "r272", "r273", "r274", "r275", "r276", "r277", "P0_복귀", "rJ1a_복귀", "rJ2_1_복귀", "rJ2_2_복귀", "rJ2_3_복귀", "rJ2_4_복귀", "rJ1b_복귀", "rJ4_복귀", "r1_복귀", "r2_복귀", "r3_복귀", "r4_복귀", "r5_복귀", "r6_복귀", "r7_복귀", "받침_복귀"]
        q: [1.90522, -0.84783, 0.00736, 0.39323, -0.03038, 2.01087, -0.09801, -0.55492, 0.53253, 0.38652, 2.03512, -0.10469, -0.54964, 0.53236, 0.40925, 2.04455, -0.09092, -0.53135, 0.50800, 0.42172, 2.04302, -0.09239, -0.50531, 0.49114, 0.42326, 2.04452, -0.09859, -0.47910, 0.47575, 0.42167, 2.04465, -0.11103, -0.45421, 0.45252, 0.42182, 2.04319, -0.11875, -0.42952, 0.43247, 0.42190, 2.04482, -0.12188, -0.40488, 0.41096, 0.42353, 2.04479, -0.13270, -0.37860, 0.39395, 0.42197, 2.04480, -0.14196, -0.35235, 0.37544, 0.42198, 2.04483, -0.14347, -0.32628, 0.35551, 0.42200, 2.04335, -0.15117, -0.30163, 0.33547, 0.42207, 2.04491, -0.16048, -0.27536, 0.31542, 0.42209, 2.04496, -0.16664, -0.24918, 0.29387, 0.42214, 2.04340, -0.17277, -0.22460, 0.27695, 0.42366, 2.04493, -0.17895, -0.19996, 0.25849, 0.42211, 2.04477, -0.17889, -0.19543, 0.26314, 0.42194, 2.04286, -0.17875, -0.20479, 0.28930, 0.42001, 2.04455, -0.17888, -0.22919, 0.29997, 0.42018, 2.04299, -0.17889, -0.25372, 0.31987, 0.42169, 2.04294, -0.17893, -0.27821, 0.33978, 0.42166, 2.04454, -0.17437, -0.30274, 0.35360, 0.42173, 2.04442, -0.16662, -0.32745, 0.37672, 0.42007, 2.04443, -0.15892, -0.35211, 0.39367, 0.42007, 2.04437, -0.15275, -0.37981, 0.41521, 0.42002, 2.04436, -0.14504, -0.40602, 0.43370, 0.42000, 2.04434, -0.13576, -0.43228, 0.45222, 0.41998, 2.04431, -0.12960, -0.45846, 0.47069, 0.41996, 2.04426, -0.12186, -0.48316, 0.48920, 0.42144, 2.04420, -0.11566, -0.50938, 0.50921, 0.41984, 2.04407, -0.11101, -0.53404, 0.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
        stop: [false, false, false, false, false, false, false, false, false, false, false, false, false, false, false, false, false, false, false, false, false, false, false, false, false, false, false, false, false, false, false, false, false, false, false, false, false, false, false, false, false, false, false, false, false, false, false, false, false, false, false, false, false, false, false, false, false, false, false, false, false, false, false, false, false, false, false, false, false, false, false, false, false, false, false, false, false, false, false, false, false, false, false, false, false, false, false, false, false, false, false, false, false, false, false, false, false, false, false, false, false, false, false, false, false, false, false, false, false, false, false, false, false, false, false, false, false, false, false, false, false, false, false, false, false, false, false, false, false, false, false, false, false, false, false, false, false, false, false, false, false, false, false, false, false, false, false, false, false, false, false, false, false, false, false, false, false, false, false, false, false, false, false, false, false, false, false, false, false, false, false, false, false, false, false, false, false, false, false, false, false, false, false, false, false, false, false, false, false, false, false, false, false, false, false, false, false, false, false, false, false, false, false, false, false, false, false]
        hold: [0.0, 0.0, 0.0, 0.0, 0.0, 0.0, 0.0, 0.0, 0.0, 0.0, 0.0, 0.0, 0.0, 0.0, 0.0, 0.0, 0.0, 0.0, 0.0, 0.0, 0.0, 0.0, 0.0, 0.0, 0.0, 0.0, 0.0, 0.0, 0.0, 0.0, 0.0, 0.0, 0.0, 0.0, 0.0, 0.0, 0.0, 0.0, 0.0, 0.0, 0.0, 0.0, 0.0, 0.0, 0.0, 0.0, 0.0, 0.0, 0.0, 0.0, 0.0, 0.0, 0.0, 0.0, 0.0, 0.0, 0.0, 0.0, 0.0, 0.0, 0.0, 0.0, 0.0, 0.0, 0.0, 0.0, 0.0, 0.0, 0.0, 0.0, 0.0, 0.0, 0.0, 0.0, 0.0, 0.0, 0.0, 0.0, 0.0, 0.0, 0.0, 0.0, 0.0, 0.0, 0.0, 0.0, 0.0, 0.0, 0.0, 0.0, 0.0, 0.0, 0.0, 0.0, 0.0, 0.0, 0.0, 0.0, 0.0, 0.0, 0.0, 0.0, 0.0, 0.0, 0.0, 0.0, 0.0, 0.0, 0.0, 0.0, 0.0, 0.0, 0.0, 0.0, 0.0, 0.0, 0.0, 0.0, 0.0, 0.0, 0.0, 0.0, 0.0, 0.0, 0.0, 0.0, 0.0, 0.0, 0.0, 0.0, 0.0, 0.0, 0.0, 0.0, 0.0, 0.0, 0.0, 0.0, 0.0, 0.0, 0.0, 0.0, 0.0, 0.0, 0.0, 0.0, 0.0, 0.0, 0.0, 0.0, 0.0, 0.0, 0.0, 0.0, 0.0, 0.0, 0.0, 0.0, 0.0, 0.0, 0.0, 0.0, 0.0, 0.0, 0.0, 0.0, 0.0, 0.0, 0.0, 0.0, 0.0, 0.0, 0.0, 0.0, 0.0, 0.0, 0.0, 0.0, 0.0, 0.0, 0.0, 0.0, 0.0, 0.0, 0.0, 0.0, 0.0, 0.0, 0.0, 0.0, 0.0, 0.0, 0.0, 0.0, 0.0, 0.0, 0.0, 0.0, 0.0, 0.0, 0.0, 0.0, 0.0, 0.0, 0.0, 0.0, 0.0]
      # look_rack_S4: 기록 store_S4 0–1 → 관찰 (scan_R1) 멈춤, 퍽 쥠
      look_rack_S4:
        ends_home: false
        nodes: ["lift", "lift_real", "rack_look"]
        q: [0.18408, 0.41417, -0.66575, 0.18868, 0.20862, -0.07056, 0.74705, -1.47722, 0.53229, -0.15493, -1.31704, -0.86230, 0.00903, 0.40733, -0.03038]
        stand: [false, false, false]
        speed: [0.0, 0.0, 0.0]
        grip: ["-", "-", "-"]
        stop: [false, false, true]
        hold: [0.0, 0.0, 0.0]
      # store_look_S4: 관찰 → 기록 store_S4 40 (컵 입구 위, 놓기 57) → 끝 (받침)
      store_look_S4:
        ends_home: true
        nodes: ["rack_look", "r40", "r41", "r42", "r43", "r44", "r45", "r46", "r47", "r48", "r49", "r50", "r51", "r52", "r53", "r54", "r55", "r56", "in_cell", "r58", "r59", "r60", "r61", "r62", "r63", "r64", "r65", "r66", "r67", "r68", "r69", "r70", "r71", "r72", "r73", "r74", "r75", "r76", "r77", "r78", "r79", "r80", "r81", "r82", "r83", "r84", "r85", "r86", "r87", "r88", "r89", "r90", "r91", "r92", "r93", "r94", "r95", "r96", "r97", "r98", "r99", "r100", "r101", "r102", "r103", "r104", "r105", "r106", "r107", "r108", "r109", "r110", "r111", "r112", "r113", "out_cell", "r115", "r116", "r117", "r118", "r119", "r120", "r121", "r122", "r123", "r124", "r125", "r126", "r127", "r128", "r129", "r130", "r131", "r132", "r133", "r134", "r135", "r136", "r137", "r138", "r139", "r140", "r141", "r142", "r143", "r144", "r145", "r146", "r147", "r148", "r149", "r150", "r151", "r152", "r153", "r154", "r155", "r156", "r157", "r158", "r159", "r160", "r161", "r162", "r163", "r164", "r165", "r166", "r167", "r168", "r169", "r170", "r171", "r172", "r173", "r174", "r175", "r176", "r177", "r178", "r179", "r180", "r181", "r182", "r183", "r184", "r185", "r186", "r187", "r188", "r189", "r190", "r191", "r192", "r193", "r194", "r195", "r196", "r197", "r198", "P0_복귀", "rJ1a_복귀", "rJ2_1_복귀", "rJ2_2_복귀", "rJ2_3_복귀", "rJ2_4_복귀", "rJ1b_복귀", "rJ4_복귀", "r1_복귀", "r2_복귀", "r3_복귀", "r4_복귀", "r5_복귀", "r6_복귀", "r7_복귀", "받침_복귀"]
        q: [-1.31704, -0.86230, 0.00903, 0.40733, -0.03038, -1.10576, -0.05129, -0.61687, 0.53835, 0.40385, -1.13184, -0.07094, -0.59535, 0.53801, 0.41920, -1.15470, -0.05622, -0.57059, 0.53093, 0.43002, -1.15466, -0.05621, -0.54602, 0.51408, 0.42851, -1.15450, -0.05783, -0.52132, 0.49100, 0.43020, -1.15448, -0.05939, -0.49669, 0.47410, 0.43021, -1.15444, -0.05940, -0.47212, 0.45570, 0.43024, -1.15289, -0.07035, -0.44708, 0.43701, 0.42874, -1.15135, -0.08444, -0.42350, 0.41979, 0.43028, -1.15280, -0.09064, -0.39875, 0.39971, 0.43037, -1.15278, -0.09531, -0.37405, 0.38121, 0.42886, -1.15276, -0.10620, -0.34912, 0.36256, 0.43042, -1.15273, -0.11553, -0.32275, 0.34242, 0.42893, -1.15116, -0.12645, -0.29935, 0.32377, 0.43049, -1.15112, -0.13421, -0.27457, 0.30367, 0.42901, -1.15111, -0.13884, -0.24991, 0.28519, 0.42901, -1.15115, -0.14501, -0.22523, 0.26822, 0.42898, -1.15113, -0.15900, -0.21866, 0.26330, 0.42902, -1.15103, -0.15908, -0.24465, 0.27857, 0.42914, -1.15114, -0.15754, -0.27076, 0.30314, 0.42903, -1.15109, -0.15450, -0.29532, 0.31849, 0.43063, -1.15111, -0.14831, -0.32002, 0.33701, 0.42908, -1.15114, -0.14055, -0.34632, 0.35709, 0.42904, -1.15118, -0.13124, -0.37269, 0.37722, 0.42899, -1.15125, -0.12502, -0.39744, 0.39729, 0.42892, -1.15127, -0.11726, -0.42376, 0.41585, 0.42891, -1.15131, -0.11104, -0.44851, 0.43439, 0.42886, -1.15136, -0.10637, -0.47323, 0.45288, 0.42882, -1.15145, -0.10014, -0.49802, 0.47298, 0.42873, -1.15149, -0.09233, -0.52134, 0.49003, 0.42868, 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
        stand: [false, false, false, false, false, false, false, false, false, false, false, false, false, false, false, false, false, false, false, false, false, false, false, false, false, false, false, false, false, false, false, false, false, false, false, false, false, false, false, false, false, false, false, false, false, false, false, false, false, false, false, false, false, false, false, false, false, false, false, false, false, false, false, false, false, false, false, false, false, false, false, false, false, false, false, false, false, false, false, false, false, false, false, false, false, false, false, false, false, false, false, false, false, false, false, false, false, false, false, false, false, false, false, false, false, false, false, false, false, false, false, false, false, false, false, false, false, false, false, false, false, false, false, false, false, false, false, false, false, false, false, false, false, false, false, false, false, false, false, false, false, false, false, false, false, false, false, false, false, false, false, false, false, false, false, false, false, false, false, false, true, true, true, true, true, true, true, true, true, true, true, true, true, true, true, true]
        speed: [0.0, 15.0, 15.0, 15.0, 15.0, 15.0, 15.0, 15.0, 15.0, 15.0, 15.0, 15.0, 15.0, 15.0, 15.0, 15.0, 15.0, 15.0, 15.0, 15.0, 15.0, 15.0, 15.0, 15.0, 15.0, 15.0, 15.0, 15.0, 15.0, 15.0, 15.0, 15.0, 15.0, 15.0, 15.0, 15.0, 15.0, 15.0, 15.0, 15.0, 15.0, 15.0, 15.0, 0.0, 0.0, 0.0, 0.0, 0.0, 0.0, 0.0, 0.0, 0.0, 0.0, 0.0, 0.0, 0.0, 0.0, 0.0, 0.0, 0.0, 0.0, 0.0, 0.0, 0.0, 0.0, 0.0, 0.0, 0.0, 0.0, 0.0, 0.0, 0.0, 0.0, 0.0, 0.0, 0.0, 0.0, 0.0, 0.0, 0.0, 0.0, 0.0, 0.0, 0.0, 0.0, 0.0, 0.0, 0.0, 0.0, 0.0, 0.0, 0.0, 0.0, 0.0, 0.0, 0.0, 0.0, 0.0, 0.0, 0.0, 0.0, 0.0, 0.0, 0.0, 0.0, 0.0, 0.0, 0.0, 0.0, 0.0, 0.0, 0.0, 0.0, 0.0, 0.0, 0.0, 0.0, 0.0, 0.0, 0.0, 0.0, 0.0, 0.0, 0.0, 0.0, 0.0, 0.0, 0.0, 0.0, 0.0, 0.0, 0.0, 0.0, 0.0, 0.0, 0.0, 0.0, 0.0, 0.0, 0.0, 0.0, 0.0, 0.0, 0.0, 0.0, 0.0, 0.0, 0.0, 0.0, 0.0, 0.0, 0.0, 0.0, 0.0, 0.0, 0.0, 0.0, 0.0, 0.0, 0.0, 0.0, 0.0, 0.0, 0.0, 0.0, 0.0, 0.0, 0.0, 0.0, 0.0, 0.0, 0.0, 0.0, 0.0, 0.0, 0.0]
        grip: ["-", "-", "-", "-", "-", "-", "-", "-", "-", "-", "-", "-", "-", "-", "-", "-", "-", "-", "release", "-", "-", "-", "-", "-", "-", "-", "-", "-", "-", "-", "-", "-", "-", "-", "-", "-", "-", "-", "-", "-", "-", "-", "-", "-", "-", "-", "-", "-", "-", "-", "-", "-", "-", "-", "-", "-", "-", "-", "-", "-", "-", "-", "-", "-", "-", "-", "-", "-", "-", "-", "-", "-", "-", "-", "-", "close", "-", "-", "-", "-", "-", "-", "-", "-", "-", "-", "-", "-", "-", "-", "-", "-", "-", "-", "-", "-", "-", "-", "-", "-", "-", "-", "-", "-", "-", "-", "-", "-", "-", "-", "-", "-", "-", "-", "-", "-", "-", "-", "-", "-", "-", "-", "-", "-", "-", "-", "-", "-", "-", "-", "-", "-", "-", "-", "-", "-", "-", "-", "-", "-", "-", "-", "-", "-", "-", "-", "-", "-", "-", "-", "-", "-", "-", "-", "-", "-", "-", "-", "-", "-", "-", "-", "-", "-", "-", "-", "-", "-", "-", "-", "-", "-", "-", "-", "-", "-"]
        stop: [false, false, false, false, false, false, false, false, false, false, false, false, false, false, false, false, false, false, false, false, false, false, false, false, false, false, false, false, false, false, false, false, false, false, false, false, false, false, false, false, false, false, false, false, false, false, false, false, false, false, false, false, false, false, false, false, false, false, false, false, false, false, false, false, false, false, false, false, false, false, false, false, false, false, false, false, false, false, false, false, false, false, false, false, false, false, false, false, false, false, false, false, false, false, false, false, false, false, false, false, false, false, false, false, false, false, false, false, false, false, false, false, false, false, false, false, false, false, false, false, false, false, false, false, false, false, false, false, false, false, false, false, false, false, false, false, false, false, false, false, false, false, false, false, false, false, false, false, false, false, false, false, false, false, false, false, false, false, false, false, false, false, false, false, false, false, false, false, false, false, false, false, false, false, false, false]
        hold: [0.0, 0.0, 0.0, 0.0, 0.0, 0.0, 0.0, 0.0, 0.0, 0.0, 0.0, 0.0, 0.0, 0.0, 0.0, 0.0, 0.0, 0.0, 0.0, 0.0, 0.0, 0.0, 0.0, 0.0, 0.0, 0.0, 0.0, 0.0, 0.0, 0.0, 0.0, 0.0, 0.0, 0.0, 0.0, 0.0, 0.0, 0.0, 0.0, 0.0, 0.0, 0.0, 0.0, 0.0, 0.0, 0.0, 0.0, 0.0, 0.0, 0.0, 0.0, 0.0, 0.0, 0.0, 0.0, 0.0, 0.0, 0.0, 0.0, 0.0, 0.0, 0.0, 0.0, 0.0, 0.0, 0.0, 0.0, 0.0, 0.0, 0.0, 0.0, 0.0, 0.0, 0.0, 0.0, 0.0, 0.0, 0.0, 0.0, 0.0, 0.0, 0.0, 0.0, 0.0, 0.0, 0.0, 0.0, 0.0, 0.0, 0.0, 0.0, 0.0, 0.0, 0.0, 0.0, 0.0, 0.0, 0.0, 0.0, 0.0, 0.0, 0.0, 0.0, 0.0, 0.0, 0.0, 0.0, 0.0, 0.0, 0.0, 0.0, 0.0, 0.0, 0.0, 0.0, 0.0, 0.0, 0.0, 0.0, 0.0, 0.0, 0.0, 0.0, 0.0, 0.0, 0.0, 0.0, 0.0, 0.0, 0.0, 0.0, 0.0, 0.0, 0.0, 0.0, 0.0, 0.0, 0.0, 0.0, 0.0, 0.0, 0.0, 0.0, 0.0, 0.0, 0.0, 0.0, 0.0, 0.0, 0.0, 0.0, 0.0, 0.0, 0.0, 0.0, 0.0, 0.0, 0.0, 0.0, 0.0, 0.0, 0.0, 0.0, 0.0, 0.0, 0.0, 0.0, 0.0, 0.0, 0.0, 0.0, 0.0, 0.0, 0.0, 0.0, 0.0]
      # look_rack_S5: 기록 store_S5 0–1 → 관찰 (scan_LF1) 멈춤, 퍽 쥠
      look_rack_S5:
        ends_home: false
        nodes: ["lift", "lift_real", "rack_look"]
        q: [0.18408, 0.41417, -0.66575, 0.18868, 0.20862, 0.28839, 0.28685, -0.79307, 0.33134, -1.30695, 0.64414, -0.87737, 0.01027, 0.42254, -0.03038]
        stand: [false, false, false]
        speed: [0.0, 0.0, 0.0]
        grip: ["-", "-", "-"]
        stop: [false, false, true]
        hold: [0.0, 0.0, 0.0]
      # store_look_S5: 관찰 → 기록 store_S5 36 (컵 입구 위, 놓기 49) → 끝 (받침)
      store_look_S5:
        ends_home: true
        nodes: ["rack_look", "r36", "r37", "r38", "r39", "r40", "r41", "r42", "r43", "r44", "r45", "r46", "r47", "r48", "in_cell", "r50", "r51", "r52", "r53", "r54", "r55", "r56", "r57", "r58", "r59", "r60", "r61", "r62", "r63", "r64", "out_cell", "r66", "r67", "r68", "r69", "r70", "r71", "r72", "r73", "r74", "r75", "r76", "r77", "r78", "r79", "r80", "r81", "r82", "r83", "r84", "r85", "r86", "r87", "r88", "r89", "r90", "r91", "r92", "r93", "r94", "r95", "r96", "r97", "r98", "r99", "r100", "r101", "r102", "r103", "r104", "r105", "r106", "r107", "r108", "r109", "r110", "r111", "r112", "r113", "r114", "r115", "r116", "r117", "r118", "r119", "r120", "r121", "r122", "r123", "r124", "r125", "r126", "r127", "r128", "r129", "r130", "r131", "r132", "r133", "r134", "r135", "r136", "r137", "r138", "r139", "r140", "r141", "r142", "r143", "r144", "r145", "r146", "r147", "r148", "r149", "r150", "r151", "r152", "r153", "r154", "r155", "r156", "r157", "r158", "r159", "r160", "r161", "r162", "r163", "r164", "r165", "r166", "r167", "r168", "r169", "r170", "r171", "r172", "r173", "r174", "r175", "r176", "r177", "r178", "r179", "r180", "r181", "r182", "r183", "r184", "r185", "r186", "r187", "r188", "r189", "r190", "r191", "r192", "r193", "r194", "r195", "r196", "r197", "r198", "r199", "r200", "r201", "r202", "r203", "r204", "r205", "r206", "r207", "r208", "r209", "r210", "r211", "r212", "r213", "r214", "r215", "r216", "r217", "r218", "r219", "r220", "r221", "r222", "r223", "r224", "r225", "r226", "P0_복귀", "rJ1a_복귀", "rJ2_1_복귀", "rJ2_2_복귀", "rJ2_3_복귀", "rJ2_4_복귀", "rJ1b_복귀", "rJ4_복귀", "r1_복귀", "r2_복귀", "r3_복귀", "r4_복귀", "r5_복귀", "r6_복귀", "r7_복귀", "받침_복귀"]
        q: [0.64414, -0.87737, 0.01027, 0.42254, -0.03038, 1.18538, -0.09615, -0.55467, 0.52875, -0.41663, 1.18514, -0.09763, -0.53012, 0.51039, -0.41684, 1.18492, -0.09912, -0.50559, 0.49201, -0.41702, 1.18484, -0.11171, -0.47883, 0.47318, -0.41713, 1.18469, -0.12432, -0.45360, 0.45433, -0.41732, 1.18442, -0.13060, -0.42875, 0.43421, -0.41760, 1.18453, -0.14628, -0.40348, 0.41838, -0.41754, 1.18301, -0.15892, -0.37827, 0.40113, -0.41908, 1.17846, -0.17330, -0.35127, 0.38229, -0.41907, 1.18147, -0.18402, -0.32651, 0.36514, -0.41915, 1.18160, -0.19805, -0.30145, 0.34944, -0.41754, 1.17964, -0.18382, -0.27615, 0.32550, -0.41783, 1.18080, -0.17418, -0.25229, 0.30290, -0.41814, 1.18113, -0.17397, -0.23413, 0.29387, -0.41775, 1.18164, -0.16132, -0.25935, 0.31889, -0.41717, 1.18128, -0.15684, -0.28691, 0.33419, -0.41757, 1.17984, -0.15074, -0.31155, 0.35273, -0.41747, 1.18166, -0.14119, -0.33667, 0.37453, -0.41716, 1.18152, -0.13664, -0.36126, 0.38989, -0.41732, 1.18186, -0.12875, -0.38622, 0.41163, -0.41696, 1.18167, -0.12264, -0.41242, 0.42703, -0.41717, 1.18184, -0.11481, -0.43886, 0.44720, -0.41699, 1.18200, -0.10856, -0.46368, 0.46577, -0.41684, 1.18225, -0.10386, -0.48692, 0.48431, -0.41659, 1.18234, -0.09444, -0.51348, 0.50301, -0.41648, 1.18278, -0.08809, -0.53846, 0.52473, -0.41603, 1.18280, -0.08187, -0.56480, 0.54174, -0.41603, 1.18314, -0.07234, -0.59000, 0.56207, -0.41567, 1.18298, -0.06775, -0.61313, 0.57438, -0.41586, 1.18293, -0.06776, -0.61159, 0.57284, -0.41591, 1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
        stop: [false, false, false, false, false, false, false, false, false, false, false, false, false, false, false, false, false, false, false, false, false, false, false, false, false, false, false, false, false, false, false, false, false, false, false, false, false, false, false, false, false, false, false, false, false, false, false, false, false, false, false, false, false, false, false, false, false, false, false, false, false, false, false, false, false, false, false, false, false, false, false, false, false, false, false, false, false, false, false, false, false, false, false, false, false, false, false, false, false, false, false, false, false, false, false, false, false, false, false, false, false, false, false, false, false, false, false, false, false, false, false, false, false, false, false, false, false, false, false, false, false, false, false, false, false, false, false, false, false, false, false, false, false, false, false, false, false, false, false, false, false, false, false, false, false, false, false, false, false, false, false, false, false, false, false, false, false, false, false, false, false, false, false, false, false, false, false, false, false, false, false, false, false, false, false, false, false, false, false, false, false, false, false, false, false, false, false, false, false, false, false, false, false, false, false, false, false, false, false, false, false, false, false, false, false, false, false, false]
        hold: [0.0, 0.0, 0.0, 0.0, 0.0, 0.0, 0.0, 0.0, 0.0, 0.0, 0.0, 0.0, 0.0, 0.0, 0.0, 0.0, 0.0, 0.0, 0.0, 0.0, 0.0, 0.0, 0.0, 0.0, 0.0, 0.0, 0.0, 0.0, 0.0, 0.0, 0.0, 0.0, 0.0, 0.0, 0.0, 0.0, 0.0, 0.0, 0.0, 0.0, 0.0, 0.0, 0.0, 0.0, 0.0, 0.0, 0.0, 0.0, 0.0, 0.0, 0.0, 0.0, 0.0, 0.0, 0.0, 0.0, 0.0, 0.0, 0.0, 0.0, 0.0, 0.0, 0.0, 0.0, 0.0, 0.0, 0.0, 0.0, 0.0, 0.0, 0.0, 0.0, 0.0, 0.0, 0.0, 0.0, 0.0, 0.0, 0.0, 0.0, 0.0, 0.0, 0.0, 0.0, 0.0, 0.0, 0.0, 0.0, 0.0, 0.0, 0.0, 0.0, 0.0, 0.0, 0.0, 0.0, 0.0, 0.0, 0.0, 0.0, 0.0, 0.0, 0.0, 0.0, 0.0, 0.0, 0.0, 0.0, 0.0, 0.0, 0.0, 0.0, 0.0, 0.0, 0.0, 0.0, 0.0, 0.0, 0.0, 0.0, 0.0, 0.0, 0.0, 0.0, 0.0, 0.0, 0.0, 0.0, 0.0, 0.0, 0.0, 0.0, 0.0, 0.0, 0.0, 0.0, 0.0, 0.0, 0.0, 0.0, 0.0, 0.0, 0.0, 0.0, 0.0, 0.0, 0.0, 0.0, 0.0, 0.0, 0.0, 0.0, 0.0, 0.0, 0.0, 0.0, 0.0, 0.0, 0.0, 0.0, 0.0, 0.0, 0.0, 0.0, 0.0, 0.0, 0.0, 0.0, 0.0, 0.0, 0.0, 0.0, 0.0, 0.0, 0.0, 0.0, 0.0, 0.0, 0.0, 0.0, 0.0, 0.0, 0.0, 0.0, 0.0, 0.0, 0.0, 0.0, 0.0, 0.0, 0.0, 0.0, 0.0, 0.0, 0.0, 0.0, 0.0, 0.0, 0.0, 0.0, 0.0, 0.0, 0.0, 0.0, 0.0, 0.0, 0.0, 0.0]
      # look_rack_S6: 기록 store_S6 0–1 → 관찰 (scan_LF2) 멈춤, 퍽 쥠
      look_rack_S6:
        ends_home: false
        nodes: ["lift", "lift_real", "rack_look"]
        q: [0.18408, 0.41417, -0.66575, 0.18868, 0.20862, 0.17027, 0.37122, -0.76852, 0.23777, 0.01074, 1.19386, -0.96391, 0.00604, 0.52201, -0.03038]
        stand: [false, false, false]
        speed: [0.0, 0.0, 0.0]
        grip: ["-", "-", "-"]
        stop: [false, false, true]
        hold: [0.0, 0.0, 0.0]
      # store_look_S6: 관찰 → 기록 store_S6 74 (컵 입구 위, 놓기 88) → 끝 (받침)
      store_look_S6:
        ends_home: true
        nodes: ["rack_look", "r74", "r75", "r76", "r77", "r78", "r79", "r80", "r81", "r82", "r83", "r84", "r85", "r86", "r87", "in_cell", "r89", "r90", "r91", "r92", "r93", "r94", "r95", "r96", "r97", "r98", "r99", "r100", "r101", "r102", "out_cell", "r104", "r105", "r106", "r107", "r108", "r109", "r110", "r111", "r112", "r113", "r114", "r115", "r116", "r117", "r118", "r119", "r120", "r121", "r122", "r123", "r124", "r125", "r126", "r127", "r128", "r129", "r130", "r131", "r132", "r133", "r134", "r135", "r136", "r137", "r138", "r139", "r140", "r141", "r142", "r143", "r144", "r145", "r146", "r147", "r148", "r149", "r150", "r151", "r152", "r153", "r154", "r155", "r156", "r157", "r158", "r159", "r160", "r161", "r162", "r163", "r164", "r165", "r166", "r167", "r168", "r169", "r170", "r171", "r172", "r173", "r174", "r175", "r176", "r177", "r178", "r179", "r180", "r181", "r182", "r183", "r184", "r185", "r186", "r187", "r188", "r189", "r190", "r191", "r192", "r193", "r194", "r195", "r196", "r197", "r198", "r199", "r200", "r201", "r202", "r203", "r204", "r205", "r206", "r207", "r208", "r209", "r210", "r211", "r212", "r213", "r214", "r215", "r216", "r217", "r218", "r219", "r220", "r221", "r222", "r223", "r224", "r225", "r226", "r227", "r228", "r229", "r230", "r231", "r232", "r233", "r234", "r235", "r236", "r237", "r238", "r239", "r240", "r241", "r242", "r243", "r244", "r245", "r246", "r247", "r248", "r249", "P0_복귀", "rJ1a_복귀", "rJ2_1_복귀", "rJ2_2_복귀", "rJ2_3_복귀", "rJ2_4_복귀", "rJ1b_복귀", "rJ4_복귀", "r1_복귀", "r2_복귀", "r3_복귀", "r4_복귀", "r5_복귀", "r6_복귀", "r7_복귀", "받침_복귀"]
        q: [1.19386, -0.96391, 0.00604, 0.52201, -0.03038, 1.62957, -0.15587, -0.49820, 0.55929, 0.02794, 1.62909, -0.15744, -0.47661, 0.53469, 0.02745, 1.62892, -0.15748, -0.45355, 0.51625, 0.02729, 1.62879, -0.16064, -0.42727, 0.49618, 0.02717, 1.62876, -0.16690, -0.40238, 0.47908, 0.02715, 1.62868, -0.17625, -0.37738, 0.46036, 0.02706, 1.62861, -0.18403, -0.35246, 0.44171, 0.02699, 1.62856, -0.19181, -0.32910, 0.42458, 0.02694, 1.62850, -0.19957, -0.30422, 0.40593, 0.02687, 1.62843, -0.20421, -0.27796, 0.38585, 0.02680, 1.62843, -0.21195, -0.25158, 0.36722, 0.02680, 1.62842, -0.21814, -0.22374, 0.34708, 0.02680, 1.62833, -0.22740, -0.19887, 0.32688, 0.02670, 1.62831, -0.23511, -0.17407, 0.30825, 0.02667, 1.62830, -0.24590, -0.15069, 0.29108, 0.02665, 1.62915, -0.24440, -0.15988, 0.31869, 0.02755, 1.62904, -0.24443, -0.18591, 0.33557, 0.02742, 1.62907, -0.24292, -0.21046, 0.35401, 0.02743, 1.62900, -0.23830, -0.23669, 0.37103, 0.02735, 1.62918, -0.22749, -0.26162, 0.39280, 0.02755, 1.62917, -0.22130, -0.28640, 0.40986, 0.02754, 1.62924, -0.21511, -0.31118, 0.42845, 0.02761, 1.62921, -0.20890, -0.33751, 0.44552, 0.02757, 1.62935, -0.20115, -0.36238, 0.46570, 0.02772, 1.62955, -0.19183, -0.38581, 0.48592, 0.02793, 1.62954, -0.18558, -0.41220, 0.50302, 0.02791, 1.62965, -0.17934, -0.43706, 0.52163, 0.02802, 1.62970, -0.17308, -0.46195, 0.53873, 0.02807, 1.62982, -0.16525, -0.48693, 0.55742, 0.02819, 1.63103, -0.15270, -0.49687, 0.55786, 0.02787, 1.61140, -0.14403, -0.50432, 0.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
        hold: [0.0, 0.0, 0.0, 0.0, 0.0, 0.0, 0.0, 0.0, 0.0, 0.0, 0.0, 0.0, 0.0, 0.0, 0.0, 0.0, 0.0, 0.0, 0.0, 0.0, 0.0, 0.0, 0.0, 0.0, 0.0, 0.0, 0.0, 0.0, 0.0, 0.0, 0.0, 0.0, 0.0, 0.0, 0.0, 0.0, 0.0, 0.0, 0.0, 0.0, 0.0, 0.0, 0.0, 0.0, 0.0, 0.0, 0.0, 0.0, 0.0, 0.0, 0.0, 0.0, 0.0, 0.0, 0.0, 0.0, 0.0, 0.0, 0.0, 0.0, 0.0, 0.0, 0.0, 0.0, 0.0, 0.0, 0.0, 0.0, 0.0, 0.0, 0.0, 0.0, 0.0, 0.0, 0.0, 0.0, 0.0, 0.0, 0.0, 0.0, 0.0, 0.0, 0.0, 0.0, 0.0, 0.0, 0.0, 0.0, 0.0, 0.0, 0.0, 0.0, 0.0, 0.0, 0.0, 0.0, 0.0, 0.0, 0.0, 0.0, 0.0, 0.0, 0.0, 0.0, 0.0, 0.0, 0.0, 0.0, 0.0, 0.0, 0.0, 0.0, 0.0, 0.0, 0.0, 0.0, 0.0, 0.0, 0.0, 0.0, 0.0, 0.0, 0.0, 0.0, 0.0, 0.0, 0.0, 0.0, 0.0, 0.0, 0.0, 0.0, 0.0, 0.0, 0.0, 0.0, 0.0, 0.0, 0.0, 0.0, 0.0, 0.0, 0.0, 0.0, 0.0, 0.0, 0.0, 0.0, 0.0, 0.0, 0.0, 0.0, 0.0, 0.0, 0.0, 0.0, 0.0, 0.0, 0.0, 0.0, 0.0, 0.0, 0.0, 0.0, 0.0, 0.0, 0.0, 0.0, 0.0, 0.0, 0.0, 0.0, 0.0, 0.0, 0.0, 0.0, 0.0, 0.0, 0.0, 0.0, 0.0, 0.0, 0.0, 0.0, 0.0, 0.0, 0.0, 0.0, 0.0, 0.0, 0.0, 0.0, 0.0]
      # look_rack_S7: 기록 store_S7 0–1 → 관찰 (scan_R2) 멈춤, 퍽 쥠
      look_rack_S7:
        ends_home: false
        nodes: ["lift", "lift_real", "rack_look"]
        q: [0.18408, 0.41417, -0.66575, 0.18868, 0.20862, -0.10738, 0.40804, -0.80074, 0.24544, -0.20249, -2.04688, -0.96759, 0.00536, 0.52677, -0.03038]
        stand: [false, false, false]
        speed: [0.0, 0.0, 0.0]
        grip: ["-", "-", "-"]
        stop: [false, false, true]
        hold: [0.0, 0.0, 0.0]
      # store_look_S7: 관찰 → 기록 store_S7 65 (컵 입구 위, 놓기 81) → 끝 (받침)
      store_look_S7:
        ends_home: true
        nodes: ["rack_look", "r65", "r66", "r67", "r68", "r69", "r70", "r71", "r72", "r73", "r74", "r75", "r76", "r77", "r78", "r79", "r80", "in_cell", "r82", "r83", "r84", "r85", "r86", "r87", "r88", "r89", "r90", "r91", "r92", "r93", "r94", "r95", "r96", "r97", "r98", "r99", "r100", "r101", "r102", "r103", "r104", "r105", "r106", "r107", "r108", "r109", "r110", "r111", "r112", "r113", "r114", "r115", "r116", "r117", "r118", "r119", "r120", "r121", "r122", "r123", "r124", "r125", "r126", "r127", "r128", "r129", "r130", "r131", "r132", "r133", "r134", "r135", "r136", "r137", "r138", "r139", "r140", "r141", "r142", "r143", "r144", "r145", "r146", "r147", "r148", "r149", "r150", "r151", "r152", "r153", "r154", "r155", "r156", "r157", "r158", "r159", "r160", "out_cell", "r162", "r163", "r164", "r165", "r166", "r167", "r168", "r169", "r170", "r171", "r172", "r173", "r174", "r175", "r176", "r177", "r178", "r179", "r180", "r181", "r182", "r183", "r184", "r185", "r186", "r187", "r188", "r189", "r190", "r191", "r192", "r193", "r194", "r195", "r196", "r197", "r198", "r199", "r200", "r201", "r202", "r203", "r204", "r205", "r206", "r207", "r208", "r209", "r210", "r211", "r212", "r213", "r214", "r215", "r216", "r217", "r218", "r219", "r220", "r221", "r222", "r223", "r224", "r225", "r226", "r227", "r228", "r229", "r230", "P0_복귀", "rJ1a_복귀", "rJ2_1_복귀", "rJ2_2_복귀", "rJ2_3_복귀", "rJ2_4_복귀", "rJ1b_복귀", "rJ4_복귀", "r1_복귀", "r2_복귀", "r3_복귀", "r4_복귀", "r5_복귀", "r6_복귀", "r7_복귀", "받침_복귀"]
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
