jejeong5976/Project2_Turtle_Ninja/config/hardware_map.yaml

# hardware_map.yaml — ★ "어느 관절이 어느 보드·모터에 붙나" 를 적는 유일한 곳
# =============================================================================
# 이 파일을 robot.urdf.xacro 가 읽어서 <ros2_control> 블록을 자동으로 만든다.
#   - 보드(OpenCR / U2D2) 1장 = buses 항목 1개 = <ros2_control> 블록 1개
#   - OpenCR 1장 → 2장으로 나누려면: buses 에 항목을 하나 더 쓰고 joints 를 옮기면 끝. 코드 수정 없음
#     (아래 맨 끝에 2장 예시 있음)
#
# 근거
#   - 팔 이름 · ID: OpenManipulator-X + 6축 손목
#       관절 joint1~4 = ID 11~14 (OpenManipulator-X 그대로), 그리퍼 = 15, 새 손목 회전 joint5 = 16
#       "6축" = 그리퍼 포함 모터 6개 / 팔 관절은 5개 (몸통 1 + 굽힘 3 + 손목 비틀기 1)
#   - 스워브 ID: 바퀴 1 · 2 · 41 · 42, 조향 11~14 (실물 확인). 팔 11~14 와 겹치지만 보드(USB)가 달라 괜찮음
#
# 순서 규칙: 한 bus 안의 joints 순서 = ros2_control 블록 안 joint 순서 = CONFIG 상자의 모터 순서 (firmware/nt_opencr/nt_packet.h)

# 결정: OpenCR 2장 · 전원 2구역 (와플파이 기본 배터리 2개)
#   주행 보드 ← 배터리 A : 바퀴 4 + 조향 4   /   팔 보드 ← 배터리 B : 팔 5 + 그리퍼 1   /   Jetson ← 외부 19 V (기둥 따라 배선)
#   보드마다 ros2_control 하드웨어가 따로 (이름 = name). 한쪽이 고장 나면 control_master 가 전체 STOP
#   포트 이름은 udev 로 고정 — 시험 때는 launch 인자 opencr_ports:=bus_drive=…,bus_arm=… 로 바꿈
buses:
  - name: bus_drive
    port: /dev/opencr_drive
    baud: 1000000
    imu: true                       # IMU 는 주행 보드 것 하나만 (swerve_controller 의 회전 보정, D12)
    joints: [drive_fl_joint, drive_fr_joint, drive_rl_joint, drive_rr_joint,
             steer_fl_joint, steer_fr_joint, steer_rl_joint, steer_rr_joint]
  - name: bus_arm
    port: /dev/opencr_arm
    baud: 1000000
    joints: [joint1, joint2, joint3, joint4, joint5, gripper_left_joint]

# mode: velocity = 속도 모드(바퀴), position = 위치 모드(조향·팔), gripper = 전류기반 위치(그리퍼, 단위 m)
# scale · zero_tick: 관절 = (모터 rad − (zero_tick − 2048) × 2π/4096) × scale. 기본 scale 1 · zero_tick 2048 (= 예전과 같음)
#   조향은 모터 + 가 위에서 시계라 scale −1, zero_tick = 직진 눈금 (실측, 새 앞쪽 기준 — 아래 motors)
#   zero_tick 은 위치 모드만 (바퀴 속도 모드는 2048 그대로여야 함 — 플러그인이 거부)
# Homing Offset (조향 모터 EEPROM): 눈금 창의 가운데가 직진이 되게 맞춰 둠 — fl −1018 · fr +496 · rl −529 · rr −1024
#   (위치 모드 한계 ±1024 라 rr 은 덜 옮김) → zero_tick 2048 · 2048 · 2048 · 2565, 범위 fl · fr · rl ±180° · rr −133 ~ +225°.
#   ⚠ 모터를 바꾸면(교체 · 공장 초기화) Homing 이 0 으로 돌아가 이 영점과 어긋남 → DYNAMIXEL Wizard 로 Homing Offset 을 위 값으로 다시 쓸 것.
# 선(케이블) 한계 cable_min_deg / cable_max_deg: hardware_map_drive_only.yaml 설명과 같음 (지금은 적지 않음)
#   (모터로 네 바퀴 소프트웨어 양 끝까지 전류 상승 없음 · 손으로 돌린 선 범위 모두 한 바퀴 넘음 → 지금은 눈금 창이 범위)
# initial: 가짜 하드웨어(mock)로 켰을 때의 시작 각도 [rad] — 팔이 접힌 자세로 보이게
# profile_vel · profile_acc: 모터가 스스로 지키는 속도 · 가속 한계 (D16 "느리게" — 순간 전류를 모터 안에서 한 번 더 줄임)
#   단위는 다이나믹셀 눈금 그대로: Profile Velocity 1 = 0.229 rpm, Profile Acceleration 1 = 214.577 rev/min²
#   조향 200 → 최고 약 4.8 rad/s (실측 257~267°/s), 가속 60 → 약 22 rad/s²  (실물 비교로 정함, 예전 40/10)
#   바퀴 가속 40 → 바퀴 약 15 rad/s² = 몸통 약 0.5 m/s² (swerve_controller max_linear_accel 0.5 와 맞춤, 예전 20)
#   팔은 안 씀: joint_trajectory_controller 가 시간표대로(한 동작 4 s) 이미 천천히 보내기 때문 (둘 다 걸면 늦게 따라가 오차)
motors:
  # 바퀴 · 조향: hardware_map_drive_only.yaml 실측값과 같게 — ID · 회전 방향(scale) · 직진 영점(zero_tick, 실측)
  #   · 프로파일(조향 200/60 · 바퀴 가속 40, 실물 비교로 정함) (선 한계 없음, 위 설명). 바꿀 땐 두 파일 같이
  drive_fl_joint: {id: 1,  model: XM430-W210, mode: velocity, profile_acc: 40, scale: 1.0}
  drive_fr_joint: {id: 2,  model: XM430-W210, mode: velocity, profile_acc: 40, scale: -1.0}
  drive_rl_joint: {id: 41, model: XM430-W210, mode: velocity, profile_acc: 40, scale: -1.0}
  drive_rr_joint: {id: 42, model: XM430-W210, mode: velocity, profile_acc: 40, scale: 1.0}

  steer_fl_joint: {id: 11, model: XM430-W350, mode: position, profile_vel: 200, profile_acc: 60, scale: -1.0, zero_tick: 2048}
  steer_fr_joint: {id: 12, model: XM430-W350, mode: position, profile_vel: 200, profile_acc: 60, scale: -1.0, zero_tick: 2048}
  steer_rl_joint: {id: 13, model: XM430-W350, mode: position, profile_vel: 200, profile_acc: 60, scale: -1.0, zero_tick: 2048}
  steer_rr_joint: {id: 14, model: XM430-W350, mode: position, profile_vel: 200, profile_acc: 60, scale: -1.0, zero_tick: 2565}
  # 조향 = XM430-W350 (CAD 부품 이름 *_Steer_XM430_W350), 주행 = W210 (CAD *_Drive_XM430_W210)
  # joint1 영점 11-08: 4088 → 4104 (+16) = 한 바퀴 (4096) 뺀 8 로 적음 (플러그인이 zero_tick 0~4095 만 받음 — 4104 는 bus_arm 초기화 거부). 그리퍼를 받침대에 앉힌 J1 눈금이 어제 4081~4090 → 오늘 4097~4106 (받침대 좌우 여유
  #   1.3 mm = 9 눈금, URDF 받침대 · 손가락 메시로 계산) → 같은 자리를 16 눈금 크게 읽음. HOME 이 2.2 mm 오른쪽으로 가 오른쪽 손가락이 닿던 것
  #   여기만 바꿈: 경로 · HOME · 적재함 (관절 rad) 과 arm_kinematics (zero_tick · ref_tick 4088 = 관절 rad ↔ 팔 모델 환산),
  #   tools/arm_real/arm/ros/hardware_map_arm_only.yaml (생성기용 같은 환산) 은 그대로 둠 — 같은 관절 rad = 어제와 같은 실제 각도
  #   HOME = 모터 4 (= 4100 − 4096). 켤 때 J1 이 경계 아래 (4090 대) 로 읽혀도 플러그인이 영점에서 반 바퀴 안으로 바퀴를 맞춤
  #   (OpenCRLink 바퀴 보정 — 8 · 4104 어느 쪽으로 적어도 같은 관절값). robot_cli 눈금도 모터 그대로 (HOME 4 근처)
  #   손가락이 받침대에 닿으면: 오른쪽이 닿으면 +2 (10), 왼쪽이 닿으면 −2 (6) (J1 + = 왼쪽)
  joint1:             {id: 11, model: XM430-W350, mode: gripper, initial: -0.0061, goal_current: 0, zero_tick: 8}  # 그리퍼 모드 + goal_current 0 = 펌웨어가 확장 위치 모드로 씀 (여러 바퀴 · 떨림 없음)
  joint2:             {id: 12, model: XM430-W350, mode: position, initial: -1.4511, zero_tick: 2048}
  joint3:             {id: 13, model: XM430-W350, mode: position, initial: 0.9511, zero_tick: 2048}
  joint4:             {id: 14, model: XM430-W350, mode: position, initial: -0.1181, zero_tick: 2048}
  joint5:             {id: 16, model: XM430-W350, mode: position, initial: 0.0230, zero_tick: 2048}
  # 그리퍼: 모터 rad → 손가락 m 는 scale 배 (ROBOTIS 공식값 0.000017626621790 m/눈금 × 4096/2π = 0.01149 m/rad)
  #   ⚠ 부호(벌림이 + 인지)는 책상 시험에서 확인. ROBOTIS 설정은 Drive Mode 5(반대 방향) 라서 반대면 -0.01149 로
  #   goal_current: 쥐는 힘 한계 (눈금 2.69 mA → 200 ≈ 0.54 A), OpenManipulator-X 공식 값
  gripper_left_joint: {id: 15, model: XM430-W350, mode: gripper,  initial: 0.0, goal_current: 200, scale: 0.01149, zero_tick: 3549}

# 모터 경비견 (Bus Watchdog): 단위 20 ms. 15 = 300 ms (펌웨어 경비견과 같은 값)
# 펌웨어가 켤 때(CONFIG) 모터에 씀 = 안전장치 3겹째 (펌웨어까지 멈춰도 모터가 스스로 섬)
watchdog: 15

# 배터리 (와플파이 기본 배터리 3셀 리튬폴리머 11.1 V · 1,800 mAh · 5C, 보드마다 1 개)
#   펌웨어가 모터 입력 전압을 1 초 단위로 보고(DIAG). 평균이 stop 아래로 2 번 연속이면 그 보드 ERROR → control_master 전체 STOP
#   ⚠ 잠정: 셀당 3.6 V(10.8) 경고 · 3.4 V(10.2) 정지. XM430 입력 하한 약 10 V. 실제 부하 중 처짐을 재고 정할 것
battery_warn_v: 10.8
battery_stop_v: 10.2

# (a) 전용: 켤 때 모터가 하나라도 대답 안 하면 멈출까 (true). 모터 몇 개만 놓고 책상 시험할 땐 false
require_all_motors: true

# ---- OpenCR 1장으로 되돌릴 때 (책상 시험 등. 쓰려면 위 buses 를 지우고 주석 해제) ----
# buses:
#   - name: bus_main
#     port: /dev/opencr_main
#     baud: 1000000
#     imu: true
#     joints: [drive_fl_joint, drive_fr_joint, drive_rl_joint, drive_rr_joint,
#              steer_fl_joint, steer_fr_joint, steer_rl_joint, steer_rr_joint,
#              joint1, joint2, joint3, joint4, joint5, gripper_left_joint]
