jejeong5976/Project2_Turtle_Ninja/config/gripper_linkage.yaml

# 그리퍼 연결 막대 (크랭크 · 양쪽 막대) — 손가락 위치 하나로 관절각이 정해짐. URDF 메시 구멍축에서 뽑은 값 (손목 wrist_link 좌표, m · rad)
#   arm_state_publisher 가 /joint_states 의 gripper_left_joint 로 gripper_crank_joint · gripper_left_rod_joint · gripper_right_rod_joint 계산
/**:
  ros__parameters:
    gripper_linkage:
      hinge_axis: [0.617502340199456, -0.292974613021111, -0.729970366503549]
      crank_center: [0.0192560308655604, -0.00913604229325333, -0.0403204421046566]
      slide_axis: [0.428628063123727, 0.903481036260797, -2.48981564071871e-05]
      basis_e: [0.428628063123727, 0.903481036260797, -2.48981564071871e-05]
      basis_t: [0.659521677696038, -0.312870409662285, 0.683478795140535]
      finger_pin_q0: [0.0363703506666601, 0.0141787026983163, -0.0461597144674409, 0.0120217498033399, -0.0371383839983163, -0.0461606931325592]
      crank_pin_cad: [0.0358971613001141, -0.0062730583177814, -0.0383516562051884, 0.0124949382856456, -0.0166866213156626, -0.0539687530230128]
      finger_pin_cad: [0.0447943336385686, 0.031935146505626, -0.0461602050775458, 0.00359776560704854, -0.0548948249148685, -0.0461602049297265]
      crank_radius: 0.0150000005767194
      rod_length: 0.0400000003367451
      cad_pin_alpha: 0.865888198610095
      theta0: 1.43535990442675
      phi0: [-1.42879323330715, -1.42879335008252]
      q_range: [-0.003, 0.0175]
