jejeong5976/Project2_Turtle_Ninja/ros2_ws/src/robot_cli/src/pages.cpp

// pages.cpp — 1~7 쪽 (0 쪽에서 번호 + Enter), 설명은 status_view.hpp
//   맨 위 = 그 쪽 덩어리의 배지 줄 (0 쪽과 같은 색), 아래 = 표 (단위는 머리줄에만), 덩어리 사이 빈 줄, 맨 아래 = 번호 동작

#include <cmath>

#include "robot_cli/status_view.hpp"
#include "view_parts.hpp"

namespace robot_cli
{

namespace
{
using namespace parts;

std::string rj(const std::string & s, int w)
{
  const int n = text_width(s);
  return n >= w ? s : std::string(w - n, ' ') + s;
}

std::string sensor_age(const Snapshot & s, double t, const char * none)
{
  return t < 0.0 ? std::string(none) : fmt("%.1f s 전", s.now - t);
}

// 번호 동작 안내 (쪽 맨 아래)
void actions(Lines & L, int page, const Config & cfg)
{
  const auto acts = page_actions(page, cfg);
  head(L, "번호 동작 (번호 + Enter, 물으면 답 + Enter, Esc = 그만)");
  if (page == 3 && cfg.stops.empty()) {
    L.push_back({"정차 자세가 없어 번호 이동 없음 · 1 = 멈춤", Level::NORMAL});
  } else if (page == 3) {
    L.push_back({fmt("1~%zu = 그 정차로 이동 (팔이 접혀 있지 않으면 home 먼저 = 접고 이동, 퍽을 쥐었으면 거절) · %zu = 멈춤",
      cfg.stops.size(), cfg.stops.size() + 1), Level::NORMAL});
  } else if (acts.empty()) {
    L.push_back({"이 쪽은 동작 없음 — 번호 = 그 쪽으로", Level::NORMAL});
  } else {
    std::string t;
    for (std::size_t i = 0; i < acts.size(); ++i) {
      t += fmt("%s%zu %s", t.empty() ? "" : " · ", i + 1, acts[i].label.c_str()) + (acts[i].ask.empty() || acts[i].confirm ? "" : "(?)");
    }
    L.push_back({t, Level::NORMAL});
  }
  L.push_back({"0 · Esc = 전체 요약 · ←/→ = 옆 쪽", Level::OFF});
}

std::string det_pos(const DetView & d)
{
  if (!std::isfinite(d.x) || !std::isfinite(d.y) || !std::isfinite(d.z)) {return rj("-", 8) + rj("-", 8) + rj("-", 8);}
  return rj(fmt("%+.3f", d.x), 8) + rj(fmt("%+.3f", d.y), 8) + rj(fmt("%+.3f", d.z), 8);
}

// 1 위치 · SLAM
Lines loc_page(const Snapshot & s, const Config & cfg)
{
  Lines L;
  loc_block(L, s, cfg);
  head(L, "위치");
  pose_table(L, s);
  head(L, "위치 추정");
  row(L, "종류", s.loc_mode.empty() ? "없음" : s.loc_mode);
  if (s.health_t >= 0.0) {
    static const char * lv[] = {"정상", "경고", "정지", "모름"};
    row(L, "건강", std::string(s.health_level >= 0 && s.health_level <= 3 ? lv[s.health_level] : "?") + " · " + s.health_msg + " · " +
      age(s, s.health_t) + " 전", s.health_level >= 1 ? Level::WARN : Level::NORMAL);
  } else {
    row(L, "건강", "/localization_health 없음", Level::OFF);
  }
  auto up = [&](const char * n) {return has_node(s, n) ? "O" : "-";};
  row(L, "노드", fmt("slam_toolbox %s · amcl %s · pose_guard %s · scan_merger %s", up("/slam_toolbox"), up("/amcl"),
    up("/pose_guard"), up("/scan_merger")));
  auto act = [](int v) {return v < 0 ? std::string("서비스 없음") : v ? std::string("active") : std::string("비활성");};
  row(L, "lifecycle", "localization " + act(s.loc_active) + " · navigation " + act(s.nav_active));
  head(L, "센서");
  row(L, "라이다 앞", sensor_age(s, s.scan_front_t, "없음"), s.scan_front_t < 0.0 ? Level::OFF : age_level(s, s.scan_front_t));
  row(L, "라이다 뒤", sensor_age(s, s.scan_rear_t, "없음"), s.scan_rear_t < 0.0 ? Level::OFF : age_level(s, s.scan_rear_t));
  row(L, "합친 scan", sensor_age(s, s.scan_t, "없음 (scan_merger)"), s.scan_t < 0.0 ? Level::OFF : age_level(s, s.scan_t));
  row(L, "IMU", sensor_age(s, s.imu_t, "없음 (OpenCR 일 때만)"), s.imu_t < 0.0 ? Level::OFF : age_level(s, s.imu_t));
  if (s.odom_t >= 0.0) {
    row(L, "시계", fmt("이 PC − 로봇 %+.3f s (0.25 s 넘으면 drive · teleop 막힘)", s.clock_off),
      std::fabs(s.clock_off) > kClockTolS ? Level::BAD : Level::NORMAL);
  }
  head(L, "다시 띄우기 (실행 중에 바꾸는 방법 없음)");
  for (const auto & t : loc_hint()) {L.push_back({t, Level::NORMAL});}
  actions(L, 1, cfg);
  return L;
}
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
