jejeong5976/Project2_Turtle_Ninja/(commit log)

2026-10-19 chore: 프로젝트 디렉토리 구조 및 기본 문서 추가
2026-10-19 feat: import robot ROS packages and OpenCR firmware
    [chassis.stl, controllers.yaml, frame.stl, gripper_frame.stl, gripper_left_palm.stl, gripper_right_palm.stl, hardware_map.yaml, lds.stl]
2026-10-20 chore: yolo/dataset_gen 합성 데이터 생성 코드 제거
2026-10-20 Add: camera caliberation config file in yaml.
2026-10-20 Add: camera caliberation explanation
2026-10-20 Add: camera checking list in txt file
2026-10-21 fix: delete pdf, txt file. add camera calibration cpp file
2026-10-21 fix: adjust camera_calibration.md details after adding cam_calib.cpp
2026-10-21 chore: move camera calibration tool
2026-10-21 feat: 합성 데이터 카메라를 실측값으로 교체 (광각 fisheye, 손목 D435)
2026-10-21 chore: align ROS package names and layout with team structure
    [chassis.stl, controllers.yaml, frame.stl, gripper_frame.stl, gripper_left_palm.stl, gripper_right_palm.stl, hardware_map.yaml, lds.stl]
2026-10-21 docs: 가이드 3.4절 퍽 픽셀 표를 실측 fisheye 기준으로 갱신
2026-10-21 fix: align integration scope and shared configuration
    [controllers.yaml, hardware_map.yaml, robot.urdf.xacro, ros2_control.xacro]
2026-10-30 feat: add Isaac robot sim, release URDF, and dataset generators
    [robot.urdf]
2026-10-30 feat: add wrist YOLO seg pipeline, D435 viewer, and wrist calibration tools
2026-11-02 feat: 주행·SLAM·IMU 보정·위치 감시·URDF 실측·메시 정리·팔 펌웨어 fw_ext3
    [0021a7855b1f_arm_link2__frame.obj, 02e497356ade_link5_down__col_IRB-A02_OPEN_1.obj, 080df7e483bb_link5_down__col_Part_1_2.obj, 0dd1efe0f0fc_pm991a_one_assumed_6g_0.obj, 0f53f26fb067_link5_down__col_WBH_M2_5X5_3_1.obj, 1bdc5ea59e8e_link5_down__col_IRB-A01_OPEN_1.obj, 1f05da01fa08_link5_down__col_Assembly_2_1_Part_1_1.obj, 1f07555af253_link5_down__col_Assembly_2_1_Part_5_1.obj]
2026-11-02 refactor: navigation 패키지(C++ scan_merger · pose_guard) · tools 정리 · 메시 · 문서 이름 정리 · 주석 날짜 제거 · 검토 반영
    [battery_left.obj, battery_right.obj, birdeye_connector.obj, birdeye_lens.obj, birdeye_lens_seat.obj, birdeye_pcb.obj, bracket_clamp.obj, bracket_cradle.obj]
2026-11-02 fix: 2·3차 검토 반영 — 앞 물체 쓸림 계산 · 명령 시각 양방향 검사 · 라이다 포트 기본값 · 치우침 저장 · launch 인자 · 주석 정리
    [hardware_map.yaml, hardware_map_drive_only.yaml, robot.urdf.xacro]
2026-11-02 chore: 바퀴 모터 속도 한계 max_wheel_speed 7.9 · 주석 정리
    [controllers.yaml, hardware_map_drive_only.yaml]
2026-11-02 chore: rename rack cells to S1-S12 by distance from arm
    [robot.urdf.xacro]
2026-11-02 feat(description): real-robot URDF update (steer motors, battery plate, wrist camera body, gripper linkage)
    [gripper_drive_crank.obj, gripper_drive_crank_collision.obj, gripper_drive_nut.obj, gripper_drive_nut_collision.obj, gripper_drive_pin.obj, gripper_link_left.obj, gripper_link_right.obj, robot.urdf.xacro]
2026-11-02 feat(moveit_config): add MoveIt config with pick_ik and real-pose named states
    [joint_limits.yaml]
2026-11-02 feat(manipulation): ArmTask STORE/RETRIEVE S1-S12 real-run replay, PICK/PLACE C++ IK, sag-corrected TF
    [controllers.yaml]
2026-11-02 chore(config): fill cargo slots in the real-test order (S12, S7, S9, ...)
2026-11-02 docs: arm task contract (ArmTask, robot interfaces)
2026-11-02 fix(manipulation): review fixes for arm task runtime
    - wrist-rotated candidate paths S10_rot (-90 deg) and S7_rot (+68 deg) for neighbour-full cells (real test pending)
    - PICK/PLACE target follows planning contract (grip center = puck center + 0.015 along grasp axis); reject non-base_link frames, NaN, lying pucks
    - trajectories start from the measured joint state; every waypoint is kept in the output; sub-0.1 deg moves no longer take up to 100 s
    - PICK accepted from LOOK/LOOK_BARCODE via the verified home_from_* path
    - HOME refuses the unverified straight move while holding a puck or after a path task stopped mid-way
    - arm_state_publisher: drop arm joints when any is missing (no half-correct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
2026-11-02 docs: arm task target contract, PICK from LOOK, HOME guard, MoveIt joint states
2026-11-02 feat(manipulation): neighbour-aware grasp for PICK/PLACE
    - grasp_select: finger-tip footprint (URDF collision mesh) vs neighbour pucks and the target puck;
    closing direction (square: 2 face directions, cylinder: 15 deg steps) and opening (open, then release width)
    - control_master: wrist detections stored in odom, used as neighbours (same height, 12 cm); candidates tried until IK succeeds;
    PLACE refused when the place spot is already occupied
    - IK: explicit closing axis uses a 180 deg roll period (90 deg default unchanged, matches the real calculator)
    - HOME with slot 'force' skips the holding / mid-path guard (operator judgement)
2026-11-03 feat(manipulation): RETRIEVE from LOOK, pick at detection centre, tilted hand for far pucks
    - RETRIEVE accepted at the LOOK / LOOK_BARCODE end pose via the verified home_from_look path (same helper as PICK)
    - PICK uses the fresh wrist detection centre when it matches the target within 25 mm
    - vertical hand reaches ~0.24 m; if not, tilt the hand outward 10 deg steps (pick_max_tilt_deg, default 20 = ~0.30 m),
    closing axis tangential (5-DOF arm), only when the square face is within 10 deg; lift/lower stays vertical on the puck axis
    - held tilt tracked: STORE refused above 10 deg, PLACE keeps the hand within 20 deg of the pick tilt
    - IK solutions must keep the sag-feedforward command ticks in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
2026-11-03 docs: RETRIEVE from LOOK, arm reach and tilted hand
2026-11-03 tools(arm_real): tools that regenerate arm_paths.yaml and arm_kinematics.yaml
    The robot runs C++ control_master only; this folder holds the Python tools
    that produce its inputs (config/arm_paths.yaml, config/arm_kinematics.yaml,
    test/arm_kin_data.hpp), taken from the 10-28 .. 11-01 real arm tests and
    trimmed to what regeneration needs (22 scripts + data): replay of the real
    runs, retrieve tail, all-full check, LOOK paths, exporters, pose_safety
    (mesh collision check) and the reach model. One-off experiment tools stay
    in the test PC's arm_tests/.
    Only change from the originals: personal absolute paths -> NT_* environment
    variables with repo-relative defaults (README_KO.md). Large data stays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
    [hardware_map_arm_only.yaml]
2026-11-03 feat(manipulation): grasp 40 mm deep to match the rack paths, drop J5-only rotation paths
    - PICK grasp depth -30 -> -40 mm (pick_heights_mm): the depth of the 11-01
    real store runs that the rack paths replay. A 30 mm grasp carries the
    puck 10 mm lower and scrapes neighbour pucks. Isaac physics sim (team
    URDF, cells moved to where the real paths put the puck): store 41/56 ->
    53/56, real fill order 24/24.
    - Hand tilted more than 10 deg (cannot be stored anyway): grasp at the puck
    centre of mass (pick_tilted_depth_mm 30); deeper, a tilted cylinder rolls
    between the fingers and topples.
    - PLACE remembers the held depth (PICK plan, or retrieve_grip_depth_mm 25)
    and puts the lowest p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
2026-11-03 tools(jetson): default ROS_DOMAIN_ID 17 for the team robot
    The team robot network is fixed (Jetson 10.2.10.132, domain 17).
    run_robot.sh and save_map.sh now default to 17 when ROS_DOMAIN_ID is not
    set (an explicit export still wins); jetson_check.sh and
    jetson_robot_run.md say so (other terminals must export 17 themselves).
    build_jetson.sh runs colcon test on a private domain (181, localhost) so
    tests never join a live robot. Simulator examples move from domain 17 to 18
    so a sim on the same network never shares the real robot's domain.
2026-11-03 tools(arm_real): rename data files that looked like backups or dated copies
    The 11-01 rack-state snapshots read by replay_paths.py move from
    rack_cells.json.bak_state_1101_<time> to rack_states/1101_<time>.json,
    camera_calib_20261030.json becomes camera_calib.json and the L7/L8
    teaching record teach_20261101T162442/ becomes teach_l78/. Contents
    are unchanged; replay_paths.py, pose_safety.py, sag_model.py,
    unload_l78.py and README_KO.md read the new names. The snapshot
    timestamps parsed from the new names are identical to before.
2026-11-03 feat(manipulation): lazy fold - end STORE and PLACE above the rest, fold only before driving
    With lazy_fold: true (config/control.yaml) STORE and PLACE stop at P0,
    the pose just above the arm rest that every rack path already passes,
    and keep the wheels locked. A following PICK, RETRIEVE or LOOK starts
    from P0 without the unfold segment, LOOK -> PICK/RETRIEVE goes look ->
    P0 -> target, and HOME from P0 runs the checked fold path before DRIVE.
    Every segment is a sub-sequence of an already checked path (store tails
    equal the fold path, retrieve/look heads equal the unfold path), so no
    new arm motion is introduced. Saves fold 5.0 s + unfold 5.5 s between
    arm tasks at the same stop; on the mock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
2026-11-03 feat(description): body inertia from published part masses, TurtleBot3 wheels
    Total mass stays at the measured 3.81 kg. The body centre of mass and
    inertia are now the sum of the parts with published weights at their
    link positions: steering motors XM430-W350 82 g x4, Jetson Orin Nano
    developer kit 176 g, OpenCR 1.0 60 g x2, LB-012 battery 106 g, LDS-03
    42 g x2, plus the remaining plates, standoffs, screws and cables as the
    body box. Wheels use the TurtleBot3 Waffle Pi wheel mass and inertia.
    Arm links keep the OpenManipulator-X and CAD values. Comments now say
    where each mass comes from.
    [robot.urdf.xacro, ros2_control.xacro]
2026-11-03 feat(sim): opt-in team URDF robot for the Isaac sim (TN_ROBOT=team)
    The shared sim still defaults to the 10-27 release robot. With
    TN_ROBOT=team every sim_core environment uses the team URDF
    (ros2_ws/src/description) instead:
    - tools/convert_team_robot.py: xacro -> sim URDF (ros2_control removed,
    gripper linkage joints fixed), swerve config with module positions from
    config/controllers.yaml and steer ranges from the URDF, Isaac USD
    - sim_core/team_robot.py: joint names joint1-5 / gripper_left/right,
    arm home from config/control.yaml poses.home, arm limits from the URDF,
    lidars and top camera on base_footprint, wrist D435 on wrist_link
    - tools/check_team_robot.py: drive, arm hold, lid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
2026-11-03 feat(planning): final straight approach at box stops, drive at 0.2 m/s
    At box stops Nav2 used to aim 2 cm from the box; with 2.5 cm costmap
    cells and a few cm of localization error it kept nudging the wheels
    (B5 took 91 s with 82 steering flips in the Isaac sim). Now box stops
    (dice_map box_approach_m: 0.10) send Nav2 to a pose 10 cm back, then
    the executor drives straight along the body x axis and stops when the
    front lidar sees the box face at the original stop distance. It only
    moves with DRIVE, fresh odom (advancing stamps) and fresh front scans;
    it does not move before it has seen the box face, keeps the last face
    reading plus odom travel when the box gets too close for the lidar,
    stops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
    [controllers.yaml]
2026-11-03 fix(planning): box approach - signed travel, ignore far face jumps, odom freshness by stamp
    Travel in the final approach is now the signed distance along the
    heading at approach start, and the max-travel check uses the straight
    line distance from the start point. The start pose comes from the first
    fresh odom measured after Nav2 finished, scans stamped before it are
    dropped, and the approach fails if the heading drifts more than 5 deg.
    Face tracking: the first face needs two consecutive scans that agree
    within face_jump_m (3 cm). After that, a face more than 3 cm farther
    than predicted is treated as not seen (box out of lidar view, only the
    background left) and does not overwrite the front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
    [approach.cpp, approach.hpp, executor.cpp, executor.hpp]
2026-11-03 fix(arm): shift the S12 rack paths 5 mm toward +y near the cell
    On the robot the puck held by STORE S12 caught the rim of the S7 cup
    (about 3-5 mm toward -y) and was left tilted in the cell. Moving the
    part of store_S12 and retrieve_S12 near the cell by +5 mm in base_link
    y made both store and retrieve work on the robot (empty rack).
    tools/arm_real/arm/shift_cell_paths.py does the shift on the exported
    arm_paths.yaml: points whose fingertip is within 35 mm of the cell
    centre move fully, 35-90 mm partly, and the PICK end, P0 and rest parts
    stay as they were, so the start pose checks are unchanged. Joints change
    by at most about 2 deg, the approach axis by about 0.1 deg. The README
    adds it to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
2026-11-03 feat: white-ratio traffic light, wide 30 Hz, wide debug image
2026-11-03 feat: detect rack cup floor tags with wrist camera
2026-11-03 feat: launch cameras, perception and compressed debug views together
2026-11-03 chore(arm): turn lazy fold off by default
    On the real robot an arm motor raised a hardware error after waiting
    about 15 s at P0 with holding torque. STORE and PLACE end on the rest
    pose again until an automatic fold after a timeout is added.
    [control.yaml]
2026-11-03 feat(arm): measure rack cells from the AprilTags on the cell floors
    rack_tag_node reads the wrist camera and TF, finds the tag36h11 tags
    listed in config/rack_cells.yaml rack_tags, and intersects the corner
    rays with the cell floor plane, so no depth estimate is needed. The tag
    size is checked against the result. Samples are kept only while the
    camera is still.
    - /rack_tags/detections: DetectionArray in base_link (kind rack_tag)
    - ~/report: per-cell offset against rack_cells.yaml, a rigid fit of
    the whole rack, and the shift for every cell; tags found near another
    cell are listed with a corrected id map
    - launch: ros2 launch bringup rack_tags.launch.py (the arm is not moved)
2026-11-03 feat(arm): empty-hand rack scan and the real cell tag table
    LOOK with slot "rack" runs the new path rack_scan. It unfolds, visits
    six poses that put the wrist camera straight down 170 mm above the cell
    floor over two cells each, holds each pose for 2 s, then folds back to
    the rest pose even with lazy_fold on (drive allowed). With
    rack_tags.launch.py running, rack_tag_node measures all 12 cells. The
    task is rejected while carrying a puck.
    - path nodes take an optional hold [s]: the arm stays at a stop node
    for that long (the last trajectory point is repeated)
    - the poses come from the arm model IK. Checked on the interpolated
    commands: even with every cell full, the arm stays at least 24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
2026-11-04 feat(arm): rack tags - AprilTag 3 for shadowed cells, pucks in cells
    On the real rack the cup walls shade the tag paper, and auto exposure
    follows the bright table, so OpenCV aruco found only 2 of the 12 cell
    tags in the scan images. The node now equalizes contrast locally
    (CLAHE) and decodes with the AprilTag 3 library, which found all 12
    tags with no corrected bits in the same images. Without the apriltag
    package (ros-lyrical-apriltag) it falls back to OpenCV aruco on the
    equalized image and says so at startup.
    It also reads the top tag of a puck standing in a cell (ids 0-11, on
    the puck top plane, tighter size check so a puck caught on the rim is
    dropped). Every sample keeps the camera p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
2026-11-04 fix(planning): executor - cancel only the current goal, keep an arm success on stop
    send_nav() and send_arm() reset the goal state but kept the handle of
    the previous goal. If stop() or a timeout cancelled a new goal before
    its accept response, async_cancel_goal() got the old, finished handle,
    which rclcpp_action no longer knows: UnknownGoalHandleError out of
    stop() ends the mission node. The handle is now cleared when a goal is
    sent, so only the handle from the current accept response is used. A
    goal cancelled before acceptance is still cancelled when it is accepted.
    An arm success result could arrive and stop() run before the next
    step() applied it to the cargo record. arm_ was reset with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
    [executor.cpp, executor.hpp]
2026-11-04 fix(planning): executor - fault when a timed-out arm task never reports, stop waiting on a lost server
    When an arm task timed out, the executor cancelled it and waited up to
    server_wait_s for the final result. If none came, the step failed like
    any arm failure: HOME was inserted and the step retried (or the mission
    replanned around it). That HOME waited on the same pending cancel, so
    if the original PICK or PLACE then finished with success, update()
    applied it to the cargo record without a StepOk, and the retry ran the
    same task again: a second PLACE into a filled cell, a PICK with the
    puck already in the gripper. A timed-out arm step that ends without a
    final result (none within server_wait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
    [executor.cpp, executor.hpp]
2026-11-04 feat(robot_cli): live status screen and command CLI for the robot (C++)
    `nt` (tools/robot_cli/install.sh links ~/.local/bin/nt to the launcher,
    asking before replacing an existing nt) opens an ncurses status screen
    with a command line; `nt <command>` runs one command for scripts (exit 0
    ok, 1 no answer/timeout/Ctrl-C, 2 rejected/failed). Modelled on
    Lv2_bee_Assignment bee.py and manual_window.py but talking to ROS 2
    directly. No new interfaces.
    Screen: page 0 is one line per block with a colour badge (wheels, arm,
    joint limits, manual drive, localization, Nav2, perception, mission,
    hardware, battery: green ok, yellow caution/locked, red problem, grey
    off); numbers live on pages 1-7 (localiz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
    [bag.cpp, command.cpp, main.cpp, model.cpp, pages.cpp]
2026-11-04 feat(robot_cli): rack tags on the perception page, scan command
    Page 4 now lists the rack tag results from /rack_tags/detections
    (manipulation rack_tag_node): for every cell the last cell tag and
    puck-in-cell position in base_link, whether the arm was still, and how
    long ago it was seen. The summary line counts the cells seen.
    "look rack" (short: scan) sends LOOK with slot rack, the empty-hand
    rack scan in control_master.
    [command.cpp, pages.cpp, robot_link.cpp, status_view.cpp, test_command.cpp, test_status_view.cpp]
2026-11-04 feat(robot_cli): pick the puck the wrist camera sees, Fast DDS LARGE_DATA
    "pick det" (one puck in view) and "pick tag <id>" send PICK for a wrist
    perception detection. There is no pick by list number, because the list
    can reorder after the screen is drawn. The detection is taken from the camera pose at capture time
    through odom to the current base_link, so a body move in between is
    accounted for; a stale current-body TF is refused. The grasp point and orientation come from planning_core,
    the same rules the mission executor uses. Detections older than 2 s
    (by capture stamp and by receive time), lying pucks and unknown
    positions are refused. E-STOP is checked again right before sending,
    and a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
2026-11-04 fix(arm): rack tags - near-vertical views only, tag side, raw dump
    In the first real scan the node also took tags that a neighbouring scan
    pose saw from far to the side (the limit was 66 degrees). Any camera
    angle error grows with the view angle (about 10 mm for 2 degrees at 40
    degrees), and the twelve cells disagreed by 16 mm. Rays must now be
    within 20 degrees of vertical; each scan pose sees its own two cells at
    about 7 degrees. The limit is a launch argument (min_view_cos).
    The report also gives the median tag side per cell: a side away from
    26 mm means the floor height or the camera TF is off.
    New ~/dump service: writes the raw still samples (tag id, undistorted
    corners, camera pose)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
2026-11-04 fix(robot_cli): keep the shell's Fast DDS transport
    On the Jetson the CLI with LARGE_DATA did not see the run_robot.sh nodes
    started with the default transport. The launcher no longer sets
    FASTDDS_BUILTIN_TRANSPORTS; every window has to use the same value, and
    the screen title still shows it.
2026-11-04 fix(description): wrist camera hinge angle from the rack tag scan
    Two empty-hand rack scans measured every cell 15-20 mm outward of the
    rack table, the same both times (rigid fit residual 16 mm). The tag
    sides were right (25.8 mm), so the camera tilt was off, not its height.
    Solving the raw tag samples offline, one rotation about the colour
    optical x axis (the bracket hinge) of -5.63 degrees brings all twelve
    cells to 2 mm of the table, with the rack at its table position. The
    depth optical frame turns with it. Only the camera TF changes; arm
    motions are the same.
    On the robot the rescan with this value gave a 2.3 mm residual, and
    pick det, which had missed the puck before, picked it.
    [robot.urdf.xacro]
2026-11-04 feat(arm): LOOK pose sees the whole box
    At a box stop (box centre 0.2935 m ahead) the old LOOK pose saw only
    0.06-0.28 m ahead, so the far half of the box and the pucks on its
    centre line were out of the picture. The new pose lifts the camera
    6 cm and tilts it 13 degrees forward (joints change by at most 12
    degrees): the 205 mm box and the puck tops fit in the colour image with
    a 40 px border, using the corrected camera mount.
    look and home_from_look use the new end pose; pose_safety passes the
    rest -> P0 -> look and look -> P0 -> rest sequences (30 mm clearance)
    with the box and its pucks added as an obstacle.
2026-11-04 fix(arm): PICK from the LOOK pose goes straight to the puck
    With lazy_fold off, a PICK received at the LOOK pose ran home_from_look
    down to the rest and the whole unfold path up again before going to the
    puck. Now it goes from the LOOK pose straight to 40 mm above the puck.
    pose_safety passes that move for puck spots over the whole box (3 x 3
    grid, every spot the arm reaches) with at least 22 mm clearance.
    From the LOOK_BARCODE pose, and for RETRIEVE whose path starts with
    unfold, the arm leaves by its home_from_* path only as far as P0 and
    goes on from there; it no longer folds onto the rest in between.
2026-11-04 feat(arm): shift STORE/RETRIEVE cell paths when the rack has moved
    The rack cell floor tags give the rack position, but the camera and arm
    model still leave a few mm of bias. So the scan is compared with a
    reference scan taken from the same scan poses while the rack is where
    the real-run paths work; the bias cancels in the difference (two scans
    of an unmoved rack agreed within 0.2 mm).
    - During LOOK slot "rack", control_master collects the still rack_tag
    detections from /rack_tags/detections and keeps the per-cell median.
    - ~/save_rack_reference (Trigger) stores the last scan as the reference
    (~/.ros/rack_reference.txt, read again on start).
    - After each later scan it fits the rigid rac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
2026-11-04 feat(robot_cli): place with no arguments puts the puck back at the last pick
    After pick det the arm holds the puck at the staging point, but putting
    it down again needed pl x y [z] [yaw] typed by hand. pl (place) with no
    arguments now sends a PLACE with the target of the last PICK this CLI
    sent that succeeded, exactly as it was sent (position and orientation).
    If there is no such PICK, or a PLACE or STORE has succeeded since, it
    is refused with the reason on one line. With coordinates it works as
    before.
    The bookkeeping is LastPick in robot_cli_core (tested in test_command);
    RobotLink feeds it every arm result. Arm goals sent by other nodes are
    not seen, and a one-line nt pl starts with no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
2026-11-04 fix(arm): LOOK pose sees the whole box even when it touches the robot
    On the robot the box stood against the body (front face 0.16 m ahead),
    not 3 cm off as at a box stop. The previous LOOK pose saw from 0.17 m,
    so the near row of pucks sat on the bottom edge of the image and the
    wrist detections came and went.
    The new pose lifts the camera to 0.44 m above the floor and tilts it
    about 22 degrees forward. In the colour image (fx 615) both box
    positions, touching and 3 cm off, fit with their puck tops inside a
    40 px border. pose_safety passes rest -> P0 -> look -> P0 -> rest and
    look -> 40 mm above every reachable puck spot of both box positions,
    with the box and its pucks as an obstacle.
2026-11-04 feat(arm): PICK grasp offset parameter
    On the robot pick det took the puck about 5 mm off its centre every
    time. pick_offset_x_mm / pick_offset_y_mm (base_link, default 0, at
    most 15 mm) move the PICK grasp point by a fixed amount after it is
    matched to the wrist detection. They are read at every PICK, so they
    can be tuned while running with ros2 param set.
2026-11-04 fix(arm): LOOK closer to vertical, box clear of the gripper finger
    A wrist frame at the previous LOOK pose showed the whole box, but a
    gripper finger covered the bottom right of the image and half of the
    near-right puck. A half-hidden puck gets its centre from the visible
    part only, which fits pick det taking the puck about 5 mm off centre.
    The box outline computed from the model and the corrected camera
    matched the real frame within about 10 px.
    The new pose is the most vertical view the arm reaches over the box:
    the optical axis is 14 degrees from vertical (was 22) and the camera
    0.42 m above the floor, so less of the puck sides shows. Both box
    positions (against the body and 3 cm off) fi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
2026-11-04 config(arm): pick offset measured on the robot
    At the LOOK pose the wrist detection put the centre of a tagged puck
    16 mm forward and 4 mm to the side of the centre given by its top
    AprilTag, and pick det took the puck that far off. With
    pick_offset_x_mm -12 and pick_offset_y_mm -3.5, set while running, the
    robot picked the puck at its centre; they are now the defaults.
2026-11-04 feat(arm): STORE offset parameter; pick offset from the real lens
    STORE S12 left the picked puck on the rim towards S7 twice, with a
    held-puck offset of a few mm. store_offset_x_mm / store_offset_y_mm
    (base_link, default 0, at most 8 mm) move the part of the STORE cell
    path near the cell, added to the rack tag shift, with the same
    cell_shift rule. They are read at every STORE, so they can be tuned
    while running with ros2 param set.
    The pick offset is re-measured with the camera_info of the robot
    (fx 606, centre 325/257) instead of a nominal lens: the wrist detection
    sits 9.6 mm forward and 1.7 mm left of the puck's top AprilTag centre,
    whose side then comes out 15.3 mm as on the puck. -12 /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
2026-11-04 fix(perception): wrist puck centre and face from the top tag when seen
    On the robot the wrist detection put the centre of an upright tagged
    puck 9.6 mm forward and 1.7 mm to the side of the centre of its top
    AprilTag (tag rays on the measured top plane; the tag side then comes
    out 15.3 mm, as printed). pick det took the puck that far off, and the
    picked puck missed the 2.5 mm cup clearance in the rack.
    When puck_pose has a puck tag inside the mask and the puck stands,
    tag_top_refine intersects the four tag corner rays with the top plane
    from the depth points and takes the top centre, the puck centre and the
    face direction (tag edges) from them. It keeps the depth result if a
    tag side is mor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
2026-11-04 feat(arm): per-cell STORE offset; pick offset only for untagged pucks
    - The pick offset (-12 / -3.5 mm, the value that picked and stored in
    S12 on the robot) is now applied only when the matched wrist
    detection has no tag id; tagged pucks get their centre from the tag.
    - A square puck whose face direction the wrist detection did not find
    is refused instead of trying twelve 15-degree closing directions,
    one of which can grip it across the corners (seen on the robot).
    - store_offset.<cell> ([x, y] mm, base_link) for every cell of the rack
    table, added to store_offset_x/y_mm and the rack tag shift, at most
    8 mm in all, read at every STORE. control.yaml sets S7 to [0, 5]
    (5 mm towa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
2026-11-04 feat(arm): regrasp pucks that need a tilted hand
    Beyond about 0.24 m the vertical hand does not reach, so PICK tilts the
    hand 10 degrees and the puck is held tilted by as much. On the robot
    STORE then caught the cup rim every time (the cups leave 2.5 mm), while
    pucks picked with a vertical hand went in.
    When the chosen grasp is tilted, the same PICK now puts the puck down at
    the first free regrasp spot (regrasp_spots, default (0.215, 0),
    (0.225, +-0.065) m in base_link: on the box even at a 3 cm box stop and
    within the vertical reach), with the grasp tilt so the puck stands, and
    picks it up again with a vertical hand before going to the staging
    point. Place and regrasp use the same closing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
2026-11-04 fix(arm): regrasp spot near the body, picked puck's place counted free
    On the robot both regrasps were refused: the three fixed spots were
    within 3 cm of the pucks on the box, one "overlapping the puck being
    picked" and one too close to the other puck for the tilted fingers.
    The spot is now searched along the J1 -> puck direction, starting where
    the puck centre is regrasp_min_x (0.212 m, still on the box at a 3 cm
    box stop) and moving out 1 cm at a time up to 1 cm short of the puck,
    each also 4 and 8 cm to either side. The nearest free spot comes first,
    so the vertical regrasp is well inside the reach. While checking spots
    the puck being picked is left out of the neighbours, since it is lif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
2026-11-04 fix(arm): no false joint-stall abort right after planning
    On the Jetson a PICK that planned a regrasp at (0.214, 0.010) was
    aborted at once: "joint measurements missing for 0.59 s". The goal
    callback plans in the executor thread (many IK solves for a regrasp),
    so the joint_states callbacks waited, and the 50 Hz check saw stale
    stamps before the queued messages were read. For 0.3 s after planning
    the hardware check now keeps its previous verdict, and planning longer
    than 0.2 s is logged.
2026-11-04 feat(arm): separate pick offset for tagged pucks
    With the top-tag centre the wrist detection is within about 2 mm, so the
    untagged pick offset (-12 / -3.5 mm, mostly the depth-centre bias) is
    not used for tagged pucks. On the robot a tagged puck was then taken a
    few mm too far from the body, the arm's own bias.
    pick_offset_tagged_x_mm / pick_offset_tagged_y_mm (default 0, at most
    15 mm) move the grasp point of tagged pucks; they are read at every
    PICK and can be set while running with ros2 param set.
2026-11-04 feat(arm): reach the far corner of the box with a tilted hand
    On the robot a square puck at the far right corner of the box,
    (0.326, -0.102) m and 0.32 m from J1, was refused: the hand tilt was
    limited to 20 degrees, and a square puck could only be taken with a
    tilted hand when its faces were within 10 degrees of the tangent.
    - pick_max_tilt_deg 40 in control.yaml (the corner needs 30-40 degrees
    in the model). Tilted grasps are regrasped upright by PICK, so STORE
    still gets a vertical puck.
    - kTiltFaceTol 10 -> 20 degrees: the fingers turn a square puck that
    much onto its faces as they close.
    Mock run: the corner puck was taken with a 30-degree hand, set down
    upright at (0.214, -0.06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
2026-11-04 fix(perception): keep edge-cut pucks whose centre comes from the top tag
    A puck at the far corner of the box had its mask cut by the top edge of
    the wrist image and was dropped as "truncated", so pick det had nothing
    to take. When tag_top_refine has set the top centre and face from the
    puck tag (new PuckPose::tag_centre), the centre does not depend on the
    mask, so reject_reason no longer drops it for touching the edge.
2026-11-04 fix(arm): LOOK reaches the far corners of the box
    On the robot the box at the box stop measured 0.18-0.40 m ahead and
    -0.12..+0.11 m sideways (about 215 mm, 2 cm to the right), and a puck at
    the far left corner had its top outside the wrist image. One pose cannot
    hold the whole box plus puck tops at all four corners (arm height limit,
    gripper finger in the bottom right), so the new pose gives up the strip
    nearest the body (puck centre x < 0.238 m, where pucks are only put by
    the regrasp) and keeps the far and side corners: puck tops there fit
    inside a 15 px border with the real lens values and the corrected
    camera, out of the finger region. It is 15.6 degrees from vertical,
    0.43 m above the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
2026-11-04 fix(arm): keep trajectory points at least 1 ms apart
    On the robot a 40-degree PICK stopped above the puck: the arm
    controller rejected the 'grasp' motion with "Time between points 19 and
    20 is not strictly increasing, it is 0.999407 and 0.999407". time_path
    added a waypoint arrival time and the final time that were less than a
    nanosecond apart, so they became equal when the controller converted
    them to nanoseconds. Neighbouring output times are now more than 1 ms
    apart; a waypoint within 1 ms of the end is covered by the final point.
    New test NoNearDuplicateTimes.
2026-11-04 config(arm): tagged-puck pick offset measured on the robot
    With the top-tag centre, tagged pucks were still taken towards the box
    side; tuning pick_offset_tagged_x_mm while running on the robot (-8,
    -11, -12.5, -14.5, -15.5), -15.5 mm (towards the body) centred the
    grasp best. It is now the default, and the pick offset limit goes from
    15 to 25 mm so that value is accepted.
2026-11-04 config(arm): tagged pick offset -17 mm; store offset up to 15 mm
    - Further tuning on the robot after -15.5: -17 mm (towards the body)
    centred the grasp of tagged pucks. At the LOOK distance (about 0.3 m)
    this is about 3 degrees of camera tilt at that pose.
    - S7 needed more than the 8 mm store offset limit (9 mm towards S12 was
    refused), so the store offset limit (all + per cell) is now 15 mm.
2026-11-04 feat(arm): move each STORE release point onto its cell; deeper grasp
    On the robot the held puck missed the cup on the side away from the arm
    axis, by a different amount per cell. S7 went in with +13 mm and S12
    with +5 mm (base y).
    With the arm model, the release point (grip "release" node) of every
    recorded store path lies 7 to 13 mm outside the cell centre plus
    place_offset from config/rack_cells.yaml, almost all of it along the
    line from the J1 axis: S7 (+0.3, +12.0) and S12 (+0.6, +6.7) mm. These
    match the robot values within 2 mm.
    New parameter store_to_cell (config: true). For a STORE, control_master
    computes that difference for the cell and adds it to store_offset_* and
    store_offset.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
    [control.yaml]
2026-11-04 feat(hardware): show motor temperatures in robot_cli
    On the robot an arm motor holding P0 for a long time stopped with a
    Hardware Error (overheat / overload), and nothing showed the motor
    temperatures before that.
    - Firmware: the per-cycle health read (one motor per cycle) now reads
    Present Input Voltage and Present Temperature (addresses 144-146) in
    one 3-byte read instead of the 2-byte voltage read, so the bus time
    grows by one byte and there are no extra transactions. A new TEMP box
    (0x06) right after DIAG sends each motor's temperature once a second
    (0xFF = not read in that second). Plugins that do not know the type
    drop it, as before.
    - Hardware plugin: publishes /diagnosti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
    [model.cpp, motor_bus.cpp, motor_bus.h, nt_opencr.ino, nt_packet.h, opencr_hardware.cpp, opencr_link.cpp]
2026-11-04 fix(arm): same wrist angle for every free grasp; pick far corner pucks
    Wrist angle: with no neighbour puck, PICK sent no closing direction and
    the IK took any of the four square-face directions that a vertical hand
    could reach. Near the reach limit this turned J5 by 90 degrees (on the
    robot, the puck at (0.241, -0.026) was closed at 2 degrees, the others
    at 93-97). The grasp centre is about 12 mm off the J5 axis, so the grasp
    point error, and with it the STORE miss, changed with J5. PICK now sends
    the default direction: the face normal nearest the tangent for a square,
    the tangent for a cylinder (cylinders were treated as squares before).
    If the vertical hand cannot reach in that direction,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
    [control.yaml]
2026-11-04 feat(arm): pick lying square pucks with a vertical hand
    Lying pucks were refused by control_master. A lying square puck
    (34.8 mm high) is now taken with a vertical hand: the fingers close
    across the long axis on the two long side faces, the finger width runs
    along the long axis, at 40 -> 10 -> -20 mm from the lying top face
    (pick_lying_heights_mm). At -20 the finger tips are 14.8 mm above the
    surface the puck lies on and the fingers hold the upper 20 mm of the
    sides, over the centre of mass at 17.4 mm. Perception puts the lying
    centre 15 mm below the top (wrist_pose PUCK_D 30 mm), so control sees
    the top 2.4 mm high and the real tips sit that much higher.
    - target_in_model: a target whose z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
2026-11-04 feat(robot_cli): pick det takes lying square pucks
    pick det / pick tag refused every lying puck. Lying square pucks now
    go to control_master with the planning grasp point and orientation
    (centre + robot-side long axis end x grasp_offset, z = that end,
    x = up). Lying cylinders and lying pucks of unknown shape are still
    refused. New test LyingBoxToGraspPoint.
2026-11-04 fix(arm): let a shifted cell path pass the joint range by 15 ticks
    On the robot STORE S10 was refused with "r67 ... joint 4 out of
    range". The recorded store_S10 path runs J4 at 2416-2431 ticks above
    the cell, against a configured limit of 2430. The cell alignment of
    (-9.1, -8.0) mm lifts those points to at most 2443 ticks.
    shift_cell_path now accepts a shifted point up to 15 ticks (1.3 deg)
    past tick_lo/tick_hi. The real J4 stop is about 2485 ticks, so 2445
    keeps 40 ticks of margin. Points that are not shifted are not checked,
    as before.
    Mock run: STORE S10 with (-9.1, -8.0) mm (95 points, at most 5.1 deg
    per joint) succeeded; before this change it was refused at r36.
    New test ShiftedPoin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
2026-11-04 fix(arm): turn the wrist again for a free grasp; offset for a turned grasp
    a0763d3 sent a fixed closing direction when no neighbour puck was
    seen, so a puck at the reach edge was grasped tilted and stood up again
    instead of with J5 turned 90 degrees. On the robot the picks are
    accurate either way, and the store offsets of S9 and S4 were measured
    with the old behaviour. The free choice is back: no direction, and the
    IK takes the square face whose J5 is nearest the rest pose.
    New parameter pick_offset_rot_mm [forward, left] (default 0, at most
    15 mm). It is the correction for a grasp with the wrist turned 90
    degrees from the default (closing axis along the tangent; on the robot
    the turned gra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
    [control.yaml]
2026-11-05 feat(arm): measure where the held puck sits in the hand (wrist camera)
    STORE misses come from the puck sitting a few mm differently in the
    hand from pick to pick, mostly along the finger width (the fingers only
    centre it along the closing axis). The cup leaves 2.5 mm per side.
    Recorded joint states showed the arm reaches the commanded release
    point within 0.3 mm, so the arm itself is not the cause.
    The wrist camera is fixed to wrist_link, so the held puck always shows
    at the same place, the lower right of the image. At the box staging
    pose a tag of the held puck is visible (in the 11-04 frames, a side
    face tag, about 90 mm from the camera).
    - rack_tag_node: a puck tag (ids 0-11) closer tha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
    [control.yaml]
2026-11-05 feat(arm): stand a lying square puck up during PICK (paths from an RL policy)
    The arm cannot stand a lying puck by tilting the hand alone. Standing
    needs the long axis past 60 degrees, and J4 allows about 48 degrees
    near the box. An Isaac Lab policy (team URDF, wrist camera collision,
    J4 limit 2465) learned another way. It holds the lying puck, carries it
    toward the left front of the box, tilts it with the fingers until it
    passes the tipping point, then releases it and lets it fall upright.
    Deterministic evaluation, 1024 episodes:
    - 94.6 % with pose noise, joint offsets and one-step delay.
    - 34.8 mm and 30 mm pucks, held or open-hand starts.
    On the robot the puck cannot be measured while t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
    [control.yaml]
2026-11-05 fix(arm): grasp lying pucks deeper; check the grasp before standing up
    In the first robot trial of stand_lying, the lying puck was held only
    by its top edge. As with standing pucks (-40 mm held about 30 mm), the
    robot grasps about 10 mm shallower than commanded. The stand-up path
    then ran anyway with the puck barely held.
    - pick_lying_heights_mm goes from -20 to -30. The depth limit is now
    pick_lying_tip_clear_mm (code default 10 mm above the surface, config
    0); in practice that is still about 10 mm above.
    - standup_dz_mm (config -10) moves every point of the stand-up path
    down by IK with the same approach and closing axes, so the robot
    grasps as deep as in sim.
    - Before the first s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
    [control.yaml]
2026-11-05 fix(arm): fit the stand-up path to the real puck; open up the box
    Second robot trial of stand_lying. The fingers landed on top of the
    puck instead of around it, and the hand scraped along the box.
    Why:
    - The stand-up used the nearest table cell's grasp pose unchanged.
    Cells are up to 6 mm and 6 deg from the real puck, and the fingers
    clear the puck by only 1 mm per side.
    - The table holds the policy's joint targets, not the joints it
    reached. Some targets point up to 22 mm below the box top. In sim
    the soft arm stops on the box; the real servos push to reach them.
    - standup_dz_mm -25 moved the whole path 15 mm lower than in sim.
    Changes:
    - The whole stand-up path (above, grasp, eve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
    [control.yaml]
2026-11-05 feat(description): new puck rack from CAD (8-cell and 4-cell parts)
    The puck rack was replaced on 11-05 with two printed parts (Onshape
    shak3): an 8-cell part and a 4-cell part. The URDF now uses the CAD
    meshes as they are, so the base plates, screw holes and side notches
    show up. The notches face the outside of the waffle plate.
    The parts sit where the old rack was: the 8 cells where the old 8 were
    and the 4 cells where the old 4 were. One translation places the CAD
    cell centres on the old 12-cell table (config/rack_cells.yaml); the
    plate bottom is on the top plate (z 0.1305).
    Collision is simple shapes: one box per plate and, per cell, the walls
    of the cup. The plate boxes stay 0.5 mm ab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
    [rack_4cell.obj, rack_8cell.obj, robot.urdf.xacro]
2026-11-05 fix(arm): stand-up reaches less and never refuses for one point; lying vs standing from the support height
    Third robot trial of stand_lying.
    Stand-up (control_master, standup_table):
    - After the grasp, every path point is pulled toward the grasp tip:
    its horizontal distance is scaled by standup_reach_scale (config
    0.25). The v10 table path drags the puck about 11 cm toward the far
    left of the box; the hand went past the box. In mock, the puck now
    ends about 2.5 cm from the grasp instead of 11 cm.
    - The retarget (shift onto the real puck, raise points below the box
    top, scale the reach) is one function, standup_retarget, so the robot
    and a sim replay can use the same math.
    - A pa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
    [control.yaml]
2026-11-05 feat(arm): correct wrist detections for a turned wrist camera, measured at HOME
    On 11-05 the wrist camera turned on its hinge by 3.8 deg when the hand
    pressed into the box during a stand-up trial. The joint readings at
    HOME stayed the same, but every grasp landed off, so the pick offsets
    tuned on 11-04 no longer fit.
    At HOME the camera always sees the same part of the robot body, so any
    image motion there means the camera itself moved on the wrist.
    - New camera_drift_node: when joint1-5 rest within 0.01 rad of home_q
    for 1 s, it takes one wrist image and matches ORB features on the
    lower part (the body) against a reference image. RANSAC keeps the
    inliers, and a Kabsch fit of their ra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
    [control.yaml]
2026-11-06 feat(arm): stand-up v11 table, replayed at the recorded timing without stopping to open
    The v10 table failed on the robot. It held the policy's joint targets,
    which pointed up to 37 mm below the box top and out to x 0.43, past the
    box. The sim arm stopped on the box; the real servos pushed and
    scraped.
    New table (config/standup_paths.txt, 2842 paths): an RL policy trained
    in Isaac under the robot's limits.
    - No target more than 2 deg from where the arm really is (no pushing
    into the box). No finger contact with the box over 1 N. No fingertip
    below the box top.
    - The puck stands inside x 0.20-0.30, |y| <= 0.07. The box is free to
    slide (an empty 0.1-0.18 kg filament box) and must move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
    [control.yaml]
2026-11-06 feat(arm): stand a lying puck up in the gripper stand; run the arm 2.5x faster
    A new way to stand a lying square puck during PICK
    (stand_lying_mode park, now the default): use the gripper park stand
    on the robot as a fixture.
    1. Grip the lying puck 25 mm off centre with a vertical hand.
    2. Over the stand, tilt the hand outward to 45 deg (40 if IK fails) in
    the arm plane, close axis tangential, so the long end goes down into
    the stand. Release; the puck leans on the stand wall at about 50 deg
    and cannot slide out.
    3. Close the fingers. From outside the stand, push the fingertips
    inward 25 mm above the stand floor and stop where the standing
    puck's face will be. The puck stands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
    [control.yaml]
2026-11-06 feat: place box measurement and dice v5 updates
    - wrist depth place box fit (perception) and dice cell correction (mission)
    - L2 single box, LOOK_FAR removed, barcode table json, no driving while holding a puck
    - stop distance 0.2575 m with Nav2 to dock_to_pose handoff
    - rack cup tags, inventory policy, nav2/slam launch updates
    - sim, RL tasks (swerve_follow, swerve_track, local_planner, local_dock), yolo export scripts
    [controllers.yaml]
2026-11-06 feat(arm): fewer idle motions; stand lying pucks of any yaw; place far dice cells
    Mission time (same paths, fewer stops):
    - With an empty hand the gripper no longer stops the arm. PICK opens
    while moving toward the puck. STORE and PLACE close after the release
    while leaving. Gripping and releasing a puck still wait for the
    gripper. gripper_time_s is 0.7 (was 1.2). Path node grip_early starts
    the gripper when leaving for a node; grip_on_way also works on
    untimed segments now.
    - lazy_fold is on. STORE and PLACE stop at P0, just above the rest, and
    the next LOOK/PICK/RETRIEVE starts from there. If no arm task comes
    within lazy_fold_idle_s (5 s), control_master folds the arm by its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
    [control.yaml, rack_look_paths.yaml]
2026-11-06 fix(arm): match the PICK goal to the wrist detection before drift correction
    camera_drift_node measured the wrist camera turned 3.2 deg on its hinge
    (1.6 deg earlier the same day). control_master undoes the turn for the
    wrist detections, but robot_cli pick det and planning compute the PICK
    goal with the nominal TF. At 0.33 m the two differ by about 18 mm, close
    to the 25 mm target radius, so the target puck was taken as a neighbour
    and every PICK was refused with "no room for the fingers (0.0 mm)".
    Keep the position before the drift correction for each detection and
    take a detection as the target when either position is within 25 mm of
    the goal. The grasp still uses the corrected centre.
2026-11-06 fix(arm): pick the lying-puck grasp that can also reach the gripper stand
    park_plan took the first lying grasp that cleared the neighbour pucks and
    only then planned the stand-up. On the robot a lying puck at (0.241,
    -0.016) with its long axis at 184 deg was refused: that grasp's hand could
    not reach park_over (0.141, 0.002, z 0.160), although the other end or
    close sign could. Run park_nodes inside the lying_grasp accept callback,
    as park_cli already does, so the next candidate is tried.
    Drop the 25 mm limit on the pick offsets and the 15 mm limit on
    pick_offset_rot_mm. The lying tagged puck needed -27 mm on the robot and
    every PICK was refused while testing it.
    [control.yaml]
2026-11-06 fix(config): rack cell table and cell paths for the new rack
    The rack table still held the old rack's cells. A ruler on the new rack
    gave the CAD pitch (S5-S6 60 mm, S6-S11 45 mm) and 140 mm across the
    middle aisle (S11-S12, S10-S9), 2 mm wider than the URDF. The wrist
    camera scan measured the pitch as 66-72 and 47 mm, so it is not used.
    rack_cells.yaml now holds the URDF rack_cell_<ID>_link centres with the
    8-cell part 1 mm further left and the 4-cell part 1 mm further right.
    The store and retrieve paths near each cell are shifted by the same
    change (shift_cell_paths.py, at most 10.6 mm for S7, joints change at
    most 7 deg), and the LOOK_RACK paths are generated again from them.
    yaw_deg, pl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
    [rack_look_paths.yaml]
2026-11-06 fix(description): wrist camera rotation from the new rack tags
    The wrist camera was glued back onto the wrist on 11-06. A ruler on the
    new rack confirmed the CAD cell pitch and the 140 mm middle aisle, so
    its 12 cup tags are a known target. One empty-hand scan gave 110 still
    tag views from the six scan poses.
    With the nominal TF the cells came out 11 mm off on average (14 mm at
    worst), and the pitch read 66-72 mm instead of 60. Fitting a rotation
    of the colour optical frame together with a rack shift leaves 1.1 mm
    on average and 2.0 mm at worst: (x -3.14, y -1.11, z -0.87) deg, rack
    shift (+0.5, +2.9) mm. A fit that also moves the camera is not well
    posed, since every scan pose sees the tag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
    [robot.urdf.xacro]
2026-11-06 fix(config): lying-puck pick offset and gripper stand values from the robot
    The lying puck with its side tag was gripped 1 cm too far from the
    robot with pick_offset_lying_tagged_x_mm -17; -25 is the robot value.
    After the stand was widened, the puck still caught the arm-side wall at
    45 deg with the end 4 mm toward J1; park_end_inset_mm -3 lets it in.
    Notes record the other values tried on the robot.
    [control.yaml]
2026-11-06 feat(arm): LOOK pose that sees the near row of the place box
    At the 0.2575 m box stop the old LOOK (3911 1911 1353 2380 2009) cut
    part of the near row and showed almost none of the box front edge. The
    new LOOK (3879 1868 1360 2430 1945, J1 -2.8, J2 -3.7, J3 +0.6, J4 +4.4,
    J5 -5.6 deg) sees all nine puck tops and most of the four box edges for
    a +-1 cm stop error, with the corrected camera rotation and the finger
    area left out. It replaces the last point of look and the first point
    of home_from_look.
2026-11-06 fix(config): pick offsets after the camera rotation fix
    The -17 mm tagged and -25 mm lying tagged pick offsets made up for the
    camera rotation error fixed in f8adc21. With the new rotation the lying
    puck was gripped at its centre; -5 mm stands it up again. The tagged
    upright offset is set to 0 to test.
    [control.yaml]
2026-11-06 fix(arm): drop the 20 mm limit on the total STORE offset
    On the robot every store into the right 4-cell part landed 2 cm toward
    the robot front, while the rack scan put the cells within 3.4 mm of the
    table in x. Moving those cells back 20 mm with store_offset made the
    total (store_to_cell + global + cell) 20-24 mm, and STORE refused S12,
    S9 and S7. Keep only the finite check; the cell path shift already
    scales down when a joint would leave its range.
2026-11-06 fix(arm): allow 5 deg of hand tilt when shifting a cell path
    shift_cell_path refused any shift that tilted the approach axis more
    than 1 deg. With five joints, moving the tip 1-2 cm near the right
    rack cells tilts the hand 1.0-1.7 deg, so on the robot the S12, S9 and
    S4 offsets were applied at 50 % and S7 at 75 %. That scaled the
    store_to_cell part too, and each cell landed somewhere else than
    intended. A 5 deg tilt keeps the puck bottom, 60 mm below the
    fingertips, within 5 mm.
2026-11-06 fix(config): store offsets for the right rack part from the robot
    After the camera rotation fix, pucks stored into S4, S7, S9 and S12
    landed toward the robot front, while the rack scan put those cells
    within 3.4 mm of the table in x, so the difference is on the arm side.
    S12 and S9 went in with total near-cell shifts of (-10, +2.5) and
    (-11.7, +3.0) mm (applied at 50 % then); keep those. Start S4 and S7 at
    -10 mm in x from their old values and tune them on the robot.
    [control.yaml]
2026-11-06 feat(arm): tunable lying-puck regrasp spot and untagged offset
    Two things made stored lying pucks land in a different place each time.
    The stood-up puck was regripped at a fixed 6 mm toward J1 from the
    stand centre, a sim value. On the robot, after the stand was widened,
    the pushed puck stood further back and the hand took its front part.
    Add park_regrasp_r_mm (default -6, control.yaml -10 to test).
    A lying puck whose side tag was not seen took the upright puck offset
    pick_offset_x/y_mm. Add pick_offset_lying_x_mm and
    pick_offset_lying_y_mm for that case, starting at the upright values
    (-12, -3.5).
    [control.yaml]
2026-11-06 fix(config): regrip the stood-up puck at the stand centre; S9 offset
    On the robot, with the widened stand, park_regrasp_r_mm -10 and -16
    still took the front of the stood-up puck. With 0, the stand centre,
    the regrasp and the following stores were right. The arm cannot reach
    the regrasp pose beyond -25 mm.
    S9 was tuned with stood-up pucks, which hang 20 mm lower in the hand.
    An upright puck from pick det then went in right-back. Use the upright
    value: near-cell total (-6.7, +8.0) mm, store_offset.S9 [0.7, -2.0].
    [control.yaml]
2026-11-06 fix(config): store offsets for S4 and the left rack part; wrist-turn offset
    Upright pucks from pick det on 11-07: S4 landed 4 mm toward the box,
    S7 went in, and S1 and S2 both landed 4 mm left and 3 mm toward the
    box. Move S4 back 4 mm, and give every cell of the left 8-cell part
    (-3, -4) mm on top of its old value.
    A puck gripped with the wrist turned clockwise (-90 deg) needed the hand
    10 mm further right after the camera rotation fix, so
    pick_offset_rot_mm goes from [0.4, 2.4] to [0.4, -7.6].
    [control.yaml]
2026-11-06 feat(arm): per-path speed scale; slow the rear rack cells
    The robot body sways when the arm reaches the rear cells of the rack.
    Add path_speed_scale, a list of "path=scale" entries applied to every
    node of that path (nodes without a speed get the free-space or stand
    speed, scaled). Set store and retrieve of S1, S2, S3 and S8 to 0.9.
2026-11-06 fix(arm): copy path_speed_scale before looping over it
    The range-for looped over get_parameter(...).as_string_array(), which
    returns a reference into a temporary rclcpp::Parameter that dies at the
    end of the full expression. GCC on the Jetson warned about the dangling
    reference; reading it is undefined and every arm path plan goes through
    this loop. Copy the array into a local first.
2026-11-06 feat(arm): store offset height; S1 and S2 lower, further left and slower
    At S1 and S2 the recorded release point let the puck drop from above
    the cup. store_offset.<cell> now takes an optional third value, a
    height in mm (negative = lower), applied to the same near-cell part of
    the path as x and y (shift_cell_path gets a dz).
    From the robot on 11-07: S1 and S2 move 3 mm further left and release
    2 mm lower ([-3, -1, -2]), and their store and retrieve paths run at
    70 % speed because the body sways at the rear cells.
2026-11-06 feat(arm): let the arm settle before the gripper moves; S1 and S2 lower
    The arm controller accepts a goal within 0.05-0.12 rad, so a gripper
    action can start while the arm is still catching up. In a recorded run
    joint 2 was 2.3 deg short at a gripper event (about 1 cm at the hand),
    and on the robot the lying puck went into the gripper stand only about
    half of the time. A segment that ends at a gripper node (not one opened
    on the way) now holds its last pose for grip_settle_s, 0.3 s in
    control.yaml.
    S1 and S2 released an upright puck with its bottom 20-25 mm above the
    cup rim. Release them 15 mm lower ([-3, -1, -15]). The fingers close
    front-to-back there, so they stay clear of a puck in the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
    [control.yaml]
2026-11-06 fix(config): S8 store offset from the robot
    S1 and S2 went in after the lower release. S8 landed to the right with
    [-3, -4]; move it 10 mm left to [-3, 6].
    [control.yaml]
2026-11-06 fix(config): S3, S5 and S8 store offsets from the robot
    S8 still landed right and toward the box with [-3, 6]; [-10, 15] (back
    and left, toward S1) goes in. S3 was set to [-6, 17] and S5 to [13, 5]
    (front-left) on the robot.
    [control.yaml]
2026-11-06 feat(arm): park insert J3 offset in the stand config
    Add ParkCfg::insert_dj3: it is added to J3 over the tilt-in nodes,
    growing from 0 to the full value at the release node. At the release
    node +5 deg lifts the fingertip about 22 mm, moves it 9 mm outward and
    tilts the hand 5 deg less. control.yaml sets park_insert_j3_deg 5; it
    is read by control_master in the next commit.
2026-11-06 feat(arm): stand-up step mode, J3 offset, wrist-turn offset on the grasp
    With park_step true, a stand-up plan sends its first action and then
    waits before every next action until /control_master/step (Trigger) is
    called. The log names the next action. ArmRunner gets set_step,
    step_go and waiting_step; a cancel or a failure still ends the task,
    and the mode turns off when the task ends.
    control_master also reads park_insert_j3_deg (degrees) into the stand
    config (user request on the robot: J3 5 deg higher while inserting).
    The lying-puck grasp for the stand now gets the same wrist-turn offset
    as an upright pick (pick_offset_rot_mm, tuned in the box on 11-07). The
    grasp is planned again at t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
    [control.yaml]
2026-11-06 revert(arm): no wrist-turn offset on the stand-up grasp
    2abeadd also gave the lying-puck stand-up grasp the upright pick's
    wrist-turn offset (pick_offset_rot_mm). That was a misread of a request
    on the robot. Plan the stand-up grasp at the detected spot again, as
    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
2026-11-06 feat(arm): loosen the fingers while the lying puck goes into the stand
    On the robot the puck went into the gripper stand about half of the
    time. Holding it loosely, as the box stand-up did, lets it turn between
    the fingers and slide into the stand.
    Add a "loose" gripper keyword (GripperValues::loose, park_loose_grip_m,
    0.0060 m; the fingers stop at about 0.0046 on a held puck) and
    ParkCfg::loose_step. From that tilt-in node on (park_loose_step,
    control.yaml 6 of 8) the fingers open to the loose width while the arm
    keeps moving; the release node still opens fully.
    [control.yaml]
2026-11-06 fix(config): S4, S6, S10 and S11 store offsets from the robot
    With [-10, -4] an upright puck still missed S4; stepping toward the
    robot front and right, [-2, -12] goes in. S6 was set to [6, -25],
    S10 to [8, 7] and S11 to [7, 12] on the robot. All 12 cells now take
    an upright puck.
    [control.yaml]
2026-11-06 feat(arm): per-cell retrieve offsets
    The store offsets tuned on 11-07 only move store paths, and retrieve
    paths missed the same way: at S12 the hand needed to be 10 mm further
    back and 5 mm further right to take the puck.
    Add retrieve_offset.<cell> ([x, y] or [x, y, height] mm), applied to
    the near-cell part of retrieve_<cell> like store_offset. The shift log
    now says "cell offset" for both. control.yaml sets S12 [-10, -5].
    [control.yaml]
2026-11-06 fix(arm): no dip at the start of the retrieve paths
    Every recorded retrieve path started with a dip: J3 went 36.4 (upJ2_4)
    -> 29.2 (upJ3a) -> 35.9 (P0) -> 28.2 (r1) and back up to 33.0 (r5)
    before moving on. On the robot this looks like the arm squatting and
    rising about 10 deg before it goes to the cell. Drop upJ3a and r1-r4
    from all 12 retrieve paths, so J3 runs 36.4 -> 35.9 -> 33.0 and keeps
    going down. P0 stays, since the cell shift and the P0 join use it.
2026-11-06 fix(config): S12 retrieve offset from the robot
    S12 retrieve with [-10, -5] stopped 2 mm short toward the robot front;
    [-8, -5] takes the puck.
    [control.yaml]
2026-11-06 feat(arm): set the stand-up tilt above the stand, then lower straight in
    On the robot the lying puck kept catching 2-3 mm on the gripper stand
    rim. It was tilted and lowered at the same time, so its lower end swept
    across the rim on the way in.
    Add park_insert_back_mm: the tilt-in nodes now end that far above the
    insert pose with the full tilt, and a new park_insert node lowers the
    hand straight down into it and opens there. park_insert_extra_mm puts
    the insert pose that much lower, to push the puck past the rim.
    control.yaml sets 15 and 3 mm and loosens the fingers at the last tilt
    node (park_loose_step 8), so the puck can turn while it goes down. 0
    and 0 keep the old motion.
    [control.yaml]
2026-11-06 feat(arm): start the straight stand insert from behind the stand
    The user asked for the straight stand-up insert to start about 3 cm
    behind the stand, toward J1 and S12, so the puck goes in diagonally
    from behind and above instead of straight down. Add
    park_insert_from_back_mm (default 0), which moves the start point of
    the straight insert toward J1. control.yaml sets 30.
    Planned offline for four puck spots, all reachable (two at 40 deg
    tilt). The J1-side corner of the puck clears the arm-side wall of the
    stand by more than 10 mm on the way in.
2026-11-07 fix(arm): review fixes for the 11-07 changes
    From a review of the 11-06/11-07 commits:
    - 9af498b dropped upJ3a from the retrieve paths, but skip_unfold
    needs the whole unfold prefix, not just P0. With lazy fold, RETRIEVE
    from P0 was refused until the arm folded, and LOOK -> RETRIEVE lost
    its P0 shortcut. Keep upJ3a; only r1-r4 (the dip after P0) stay
    removed. New test RealPaths.RetrieveAndLookStartWithUnfold reads
    config/arm_paths.yaml and checks look, look_barcode and all 12
    retrieve paths against unfold.
    - path_speed_scale compared the exact path name, so with LOOK_RACK
    store_look_<cell> and look_rack_<cell> ran at full speed. They now
    use the store_<cell> entry.
    - PICK go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
2026-11-07 feat(perception): reread puck tags with CLAHE; optional flat-print filter
    Two problems seen with the wrist camera on 11-06 and 11-07:
    - The side tag of a lying puck (16 mm, about 25 px from LOOK) came and
    went between frames, and with it the tag-based grasp offset. When
    the first pass finds no puck tag, detect_tags now runs the detector
    again on a CLAHE image (clip 3, 8x8) and adds new ids. The rack tag
    node got 12/12 cells from 2/12 with the same step. This costs a
    second detection pass on frames with segmented pucks but no puck tag.
    - A logo printed on a cardboard box was segmented as a green puck in
    about 8 % of frames. puck_pose takes min_rise_m: with the up
    direction know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
    [perception.yaml]
2026-11-07 fix(description): bird-eye camera looks 30 deg down with the new bracket
    The new bird-eye bracket (cam_brkt - Part 3) holds the camera plate at
    30 deg, where the old clamp held it at 40. Set birdeye_camera_joint
    pitch to 30 deg; the mount position is unchanged until the new bracket
    is measured. The bird-eye detections carry no positions, so this only
    changes the frame shown in RViz and the comment in perception.yaml.
    [robot.urdf.xacro]
2026-11-07 chore(tools): Jetson build script takes packages and uses ccache
    bash tools/jetson/build_jetson.sh manipulation bringup now builds only
    those packages, and the script adds ccache as the compiler launcher
    when it is installed, so unchanged files are not compiled again. Today
    a one-file change still rebuilt every package that depends on it.
2026-11-07 fix(perception): correct box and rack measurements for the turned wrist camera
    The wrist camera turns a little on its hinge (3.8 deg on 11-05, 1-3 deg
    on 11-06 and 11-07). camera_drift_node measures this at HOME and
    publishes /wrist_cam/drift. control_master already undoes it for the
    puck detections, but the place box fit and the rack cup tags go
    straight from perception to mission in base_footprint / base_link with
    the nominal TF. At 0.3 m a 3 deg turn moves them by about 1.5 cm.
    WristPipeline now subscribes to the drift (wrist.drift_correct,
    wrist.drift_topic) and uses TF * drift for the camera rotation in the box
    fit, the rack tags, and the up direction for puck poses. Puck positions
    sta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
    [perception.yaml]
2026-11-07 feat(arm): pull toward the arm while releasing at the stand
    On the robot the lying puck still caught on the stand edge or leaned
    too little after the release. Instead of opening at the insert point,
    park_release_pull_mm > 0 loosens the fingers there (park_loose_grip_m)
    and moves the hand toward J1 on an arc around the lower end face of the
    puck, at the push speed, then opens. The hand keeps its tilt, so the
    puck turns between the loose fingers and leans more upright.
    Isaac fixture (URDF stand, 2 positions x +-3 mm):
    - with the robot's current values (tilt 45, J3 +5, loose 8, start 30 mm
    behind): no pull 0/6, 10 mm 1/6, 15 mm 5/6
    - with tilt 50, J3 0, no loosening and no back start: no pul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
    [control.yaml]
2026-11-07 fix(config): rack, stand and lying-puck values from the robot (11-07)
    - store S4: 4 mm further forward, [2, -12]
    - retrieve S7 [-25, 0]: with the turned wrist it went too far forward
    - retrieve S8 [0, 30]: needed 3 cm more to the left
    - park_center 5 mm back (0.0958): the hand went in front of the stand
    - park_regrasp_r_mm 1: the stood-up puck is regripped 1 mm further out
    - park_grasp_offset_mm 40: the stand-up worked when the fingers covered
    only about half of their width at the front end of the puck. In the
    sim 40 leaves 6 mm of finger on the puck, so the real lying-puck
    centre is probably about 1 cm off; check pick_offset_lying_* later.
    [control.yaml]
2026-11-07 fix(arm): pull straight back at the same height when releasing
    97714fd moved the hand on an arc around the lower end of the puck, so
    on the robot the hand rose about 10 mm while pulling. The user wanted
    the hand to stay low and slide back slowly. The pull now goes straight
    toward J1 at the insert height and tilt, then opens.
    park_release_pull_dz_mm (default 0) can add a vertical part
    (negative = down while pulling).
    [control.yaml]
2026-11-07 fix(config): wrist-turn pick offset and S4 store/retrieve from the robot
    - pick_offset_rot_mm [0.4, -14.6]: a puck gripped with the wrist
    turned clockwise still needed 7 mm more to the right.
    - store S4 [2, -15]: 3 mm further right.
    - retrieve S4 [-4, -8]: the hand needed 8 mm more right and 4 mm more
    back to take the puck out.
    [control.yaml]
2026-11-07 feat(arm): robot-frame offset for pucks gripped with the wrist turned
    pick_offset_rot_mm is a model: the value for a -90 deg turn is turned
    into a hand-frame tip error and applied by (R(a) - I) h for the actual
    turn and arm direction. On the robot, "7 mm more to the right" put into
    that value moved the hand to the left, because the turn and position
    the user saw were not the -90 deg case it is defined for.
    Add pick_offset_rot_robot_mm [forward, left] in base_link, added as it
    is whenever the wrist is turned more than 45 deg either way. The model
    value goes back to [0.4, -7.6], and the robot-frame value takes the
    afternoon corrections: 7 mm right and 2 mm back, [-2, -7].
    [control.yaml]
2026-11-07 feat(arm): end the stand insert 5 mm toward the back of the hand
    The user wanted the wrist raised 5 mm toward the side the wrist camera
    is on, before the release, as part of the insert move and not as a
    separate step. park_release_up_mm moves the insert end point along
    app x close (the back of the hand; the camera body sits 61 mm that way
    from the fingertips in the URDF), with the same tilt. In the insert
    pose that is up and outward at 45 deg. The pull and the release start
    from there. Test ReleaseUpShiftsInsertTowardCameraSide.
2026-11-07 fix(config): stand insert back, regrip out, lying grip closer, S4 out
    d862592 moved park_center 5 mm back because the puck went into the
    stand too far forward. That also moved the push and the regrip, and
    on the robot the hand then hit the stood-up puck. Put park_center back
    at the URDF value and move only the insert point: park_end_inset_mm
    -5 -> 0.
    The stood-up puck is regripped 3 mm further toward the robot front:
    park_regrasp_r_mm 1 -> 4 (from the old stand centre).
    The lying puck is gripped 5 mm closer to the robot, with or without
    its side tag: pick_offset_lying_tagged_x_mm -10, pick_offset_lying_x_mm
    -17.
    Retrieve S4 [-7, -8]: 3 mm further back (toward the profile).
    [control.yaml]
2026-11-07 feat(arm): store at the same puck height whatever the grip depth
    The store offsets were tuned with pucks picked from the box, gripped
    50 mm below the top (pick_heights_mm). A puck stood up in the gripper
    stand is regripped 30 mm below the top, so it hangs 20 mm lower in the
    hand. On the robot such a puck scraped on S2 and did not go in (S2
    also releases 15 mm lower than the recording).
    STORE now raises the near-cell part by (PICK depth - held depth) when
    the held depth comes from a PICK plan: +20 mm for a stood-up puck,
    0 for a box pick or the put-down regrip (50 mm). After a RETRIEVE the
    25 mm depth is only an estimate, so nothing changes there.
    store_match_grip_depth (default true) turns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
2026-11-07 feat(arm): option to push the lying puck further into the stand
    The push that stands the puck up stopped 4 mm outside the outer face
    of a fully upright puck. On the robot the puck sometimes still hung on
    the front edge of the stand and slid back. park_push_extra_mm moves
    the push end point that much further toward J1, at the same height.
    Test PushExtraGoesFurtherTowardJ1.
2026-11-07 fix(config): stand-up values back; push 4 mm; upright tag offset
    With the values changed on 11-07 (J3 +5, loosened fingers, straight
    insert from 30 mm behind, pull and lift before the release, grasp
    offset 40, insert point 0, regrip +4, lying pick offsets -10/-17) the
    stand-up did not work once on the robot that afternoon. Grasp offset
    40 needs a 10 deg hand tilt, and the insert then drops to 40 deg,
    below the ~49 deg lean the push needs. Loading the values of 92b9e1a
    (11-07 00:41) made it stand again.
    Use those values: tilt 45, grasp offset 25, clear 4, insert point -3,
    regrip 0, J3 0, no loosening, no straight insert, no pull or lift,
    lying pick offsets -5 (tag seen) and -12 (no tag). The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
    [control.yaml]
2026-11-07 fix(config): retrieve S1 grips 20 mm lower and 10 mm back
    On the robot the hand took the puck in S1 too high and too far
    forward to pull it out. retrieve_offset.S1 [-10, 0, -20] moves the
    near-cell part 10 mm back and 20 mm down.
    [control.yaml]
2026-11-07 fix(config): box pick 10 mm the other way; rack values from the robot
    Tuned on the robot on 11-07 afternoon after the wrist was taken apart
    and tightened again.
    Box pick (upright pucks): the hand took them about 1 cm off centre
    toward the driving direction, with or without the top tag. -22 made it
    worse, so pick_offset_x_mm and pick_offset_tagged_x_mm go -12 -> -2.
    Store offsets [x, y, height] mm:
    - S3 [-6, 13, -7]: 7 mm lower, 4 mm further right
    - S5 [13, 19]: 10 mm further left
    - S6 [6, 10, -5]: the puck fell into S11; 35 mm further left, 5 mm lower
    - S7 [-10, 5, -10]: 5 mm toward S12, 10 mm deeper
    - S10 [7, 10, -5]: 1 mm away from the box, 3 mm left, 5 mm deeper
    Retrieve offsets (the h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
    [control.yaml]
2026-11-07 fix(config): stand-up grip 7 mm closer to centre; pull 5 mm on release
    On the robot the hand was too far toward the front end of the lying
    puck when it gripped it and put it into the stand.
    park_grasp_offset_mm 25 -> 18.
    The hand did not pull back when it let go in the stand:
    park_release_pull_mm 0 -> 5 (loosen, pull 5 mm toward J1 at the same
    height, then open).
    [control.yaml]
2026-11-07 feat(arm): stand-up pull with a firm grip, push 9 mm, optional scoop push
    Robot test, 11-07 night:
    - The pull on release loosened the fingers to 0.006 first and the
    puck dropped where it was. With park_loose_grip_m 0.005 (contact is
    about 0.0046) the hand keeps it and drags it 10 mm toward the body
    (park_release_pull_mm 10), as the user asked; grasp offset back at 25.
    - park_push_extra_mm 4 only reached the face of an upright puck; 9.
    New option park_push_scoop_deg (default 0 = straight push as before):
    the push starts with the fingertips tilted toward J1 and straightens
    the hand while moving in, like an excavator bucket; park_push_low_mm
    starts it lower (must stay above the 22.5 mm s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
    [control.yaml]
2026-11-07 feat(navigation): RL local planner nf5 + dock3 from the team lead
    From the team lead's 11-07 package (base b82bf20), applied unchanged:
    - nav2.launch.py local_planner:=rl (default) starts planner_server,
    collision_monitor, cmd_vel_hold and two RL nodes instead of MPPI and
    bt_navigator: rl_nav serves navigate_to_pose (nf5), rl_dock serves
    dock_to_pose (dock3). local_planner:=mppi keeps the old stack.
    - navigation/scripts: local_planner_node.py, box_tracker.py,
    numpy_policy.py (numpy only); CMakeLists/package.xml install them.
    - config/rl: nav_nf5 and dock3 policies, team_swerve.yaml.
    - controllers.yaml swerve max_linear 0.20 -> 0.255; nav2.yaml MPPI
    vx/vy 0.255 and a fixed Footprint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
    [controllers.yaml]
2026-11-07 feat(navigation): rule-based precise approach (dock:=simple)
    On the robot (11-07) the RL dock (dock3, and dock2 before it) drove
    into the side wall in front of box B1. The polygons are off during the
    approach and the merged /scan hides everything within the body box
    (±0.17 × ±0.19), so nothing stopped it.
    simple_dock_node.py serves the same dock_to_pose action
    (NavigateToPose) and replaces rl_dock with nav2.launch.py dock:=simple
    (default stays rl):
    - goal fixed in odom at the start; box_tracker.BoxTracker corrects it
    from the box face in /scan (±8 cm, ±15°, frozen within 10 cm)
    - turn in place first when the heading is off by more than 6°, then
    drive straight to the stop point (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
2026-11-07 config(arm): turn on the scoop push at 15°
    The user asked to try the excavator-like push on the robot:
    park_push_scoop_deg 15 (fingertips tilted toward J1 at the start,
    upright at the end), park_push_low_mm 0. In the Isaac fixture it was
    no better than the straight push (3/6 without the pull, 0/6 with the
    10 mm pull), but the sim stand is not the rounded real one.
    Set park_push_scoop_deg 0 to go back.
    [control.yaml]
2026-11-07 feat(navigation): faster simple dock approach (0.15 m/s)
    On the robot (11-07 night) dock:=simple reached B1 at 0.5 cm / 1.5°
    but the approach at 0.05 m/s was too slow.
    - v_max 0.05 -> 0.15 m/s (still proportional to the distance left, so
    the last 15 cm slow down as before). nav2.launch.py dock_vmax sets it.
    Turning stays at 0.3 rad/s.
    - The side check now stops earlier at higher speed: a point blocks a
    command when the body closes on it and the gap is under 2 cm +
    closing speed × 0.25 s (5.75 cm at 0.15 m/s). Moving along a wall
    is still allowed.
    - Sim: straight 6.8 -> 3.9 s, 40 cm with 25° 11.0 -> 5.7 s, same stop
    (face gap 1.3-1.4 cm). The person test now steps in at 0.6 s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
2026-11-07 feat(navigation): simple dock finds the box within 25 cm of the map spot
    Robot runs 11-07 night on arena5: only B1 (stop measured from the scan)
    docked every time. The other stops came from the drawing and were
    8-25 cm off the real boxes, and the box tracker only looks within 8 cm:
    L1 and B2 stopped at a wall, B6 and L2 "arrived" without ever seeing
    a box.
    simple_dock now tracks the box face itself (FaceTrack) instead of
    box_tracker.BoxTracker:
    - face = a straight piece 0.12 m to box side + 3 cm long, contiguous,
    not continuing past its ends (a wall), refit by PCA
    - first fit: within 25 cm (--search) and 15° of the map box, the piece
    whose box centre is closest to the map spot
    - then: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
2026-11-07 feat(tools): fit a SLAM map to the drawing for dice_map map_from_arena
    dice_map map_from_arena: start assumes the robot sat exactly on the
    drawing's start pose when the map was made. For arena5 it sat 31 cm
    off at the edge of the start zone, turned 5.9°, so far stops were
    25-40 cm off and landed on walls and boxes.
    tools/arena/fit_map_to_drawing.py matches the occupied cells of the
    drawing (sim/robot_sim/maps/maze_dice_map) against the SLAM map's
    distance field (yaw ±15°, shift ±0.8 m, coarse to fine), prints
    map_from_arena, and can write a dice_map copy and a check image.
    Reads /map from the running robot or a saved map yaml. arena5: score
    0.61, walls and boxes line up (fit_map_to_draw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
2026-11-07 feat(arm): bend J3 during the stand-up push (park_push_j3_deg), scoop 25°
    Robot 11-07 night: the scoop push at 25° works better than 15° (user),
    so park_push_scoop_deg 25. The user also wants J3 to bend further
    while pushing the puck upright, like an excavator arm.
    park_push_j3_deg (default 0, + = fingertips up like park_insert_j3_deg)
    is added to J3 after IK on the push points, ramping from 0 at the push
    start to the full value at the end point; the fingertips move with it.
    Seen from the robot's right side, negative is clockwise. Test
    ParkStand.PushJ3OffsetRampsOverPush: only J3 on park_push1..4 changes.
2026-11-07 feat(arm): stand-up push curls J3 and lifts J2 mid-stroke, straight at the end
    User (11-07 night): the J3 bend must only happen while pushing. Held
    to the end point, the gripper touches the stand. J2 should rise at the
    same time, so the fingertips scrape the puck's lower back edge and lift
    it upright, like an excavator.
    - park_push_j3_deg now follows sin(pi f) over the push points: 0 at the
    start, full in the middle, 0 again at the end point (was a ramp to the
    full value at the end).
    - New park_push_j2_deg (default 0, + = fingertips up; the joint sign is
    taken from FK), same sin profile, added to J2 after IK.
    - Both leave every other joint and every non-push point unchanged.
    Tests: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
2026-11-07 feat(arm): stand the puck by pressing it down instead of pushing it
    User (11-07 night, robot): the side push catches the puck on the back
    wall of the gripper stand. Keep the grasp, insert and release as they
    are; then lift a little, close the gripper, come back toward J1 and
    press straight down on the caught part.
    park_press_mode (control.yaml true, code default false = old push):
    after the release point the hand keeps its insert tilt and goes
    - park_press_lift: press_lift (10 mm) up, gripper closes
    - park_press_back: press_back (15 mm) toward J1 (negative = away)
    - park_press1..4: straight down press_depth (20 mm)
    - park_press_up: 30 mm up, then the usual regrip of the stood puck
    With the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
2026-11-07 feat(hardware): say which motor failed to enable torque and why
    Team lead request after 11-07 (21:07 drive board "토크를 못 켬" with no
    detail; earlier the same night it was a steer wheel turned past its
    limit while the torque was off).
    Firmware (both OpenCR boards, same sketch):
    - CONFIG reads each position-mode motor's EEPROM Min/Max Position
    Limit and sends them once after the ACK (new POS_LIMITS 0x08).
    - bus_set_torque records the first failing motor of an attempt: step
    (read present / out of limit / goal write / torque write), the
    motor's status error byte, the library error, present tick and
    limits. A present position outside the limits is no longer written
    as the goal;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
    [motor_bus.cpp, motor_bus.h, nt_opencr.ino, nt_packet.h, opencr_hardware.cpp, opencr_link.cpp, opencr_link.hpp]
2026-11-07 fix(arm): press mode plunges a vertical closed gripper at the back of the stand
    The first press version (b62c7f2) kept the 45° insert tilt and pressed
    15 mm back from the release point, which is still in front of the
    stand. The user's photo shows the intended move: the closed gripper
    stands vertical at the back of the stand (J1 side, where the puck
    catches) and goes straight down there.
    Now after the release point:
    - park_press_lift: straight up to press_top (66 mm above the stand
    floor) with the insert tilt, so the open fingers leave the puck
    - park_press_turn: same point, hand vertical, gripper closes
    - park_press_over: vertical over press_r (-16 mm = back side; back wall
    inner face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
    [control.yaml]
2026-11-08 fix(arm): keep the full cell correction when the height shift does not fit
    rack_adjust scaled the horizontal cell correction and the height shift
    by the same factor (1, .75, .5, .25). A puck stood up on the stand is
    regripped at 30 mm instead of the box PICK 50 mm, so
    store_match_grip_depth adds +20 mm; that height pins J4 on the
    approach of most cells and the whole correction fell back to 25 % or
    to the recorded path. With the live config S4, S5, S6, S8, S10 and
    S11 lost the xy correction entirely (11-07 robot: S11 and others
    missed, S12 fine).
    Now xy stays at 100 % while the height tries 100 % down to 5 % in 5 %
    steps, then height 0 with xy 1/.75/.5/.25. The log prints both
    factors and th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
    [control.yaml]
2026-11-08 fix(opencr): report torque loss and slow attempts, safer torque-on
    Follow-up to f47510f after review:
    - a failed goal write now skips the torque write for that motor, like
    a failed position read (the motor still holds the old goal and would
    jump to it)
    - new TORQUE_FAIL steps: TF_LOST when the health step finds torque
    off on a motor that was on (pos carries Hardware Error Status) and
    TF_BUDGET when one attempt runs past TORQUE_BUDGET_MS
    - dxl_err is cleared when the library reports a comm error (it kept
    the previous motor's status byte on timeouts)
    - position limits are reset to TF_NO_LIMIT before the ping and read
    with IO_TIMEOUT_MS, so a missing motor no longer reports 0..0
    - s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
    [motor_bus.cpp, motor_bus.h, nt_opencr.ino, nt_packet.h, opencr_hardware.cpp, opencr_link.cpp]
2026-11-08 fix(dock): treat the box sides as obstacles, fix goal handling, default simple
    simple_dock_core:
    - only the band around the box face the robot docks to is excluded
    from the safety points, and only while the robot centre is within
    the body half width (0.16) of the box axis; sides, back and the face
    seen from beside stay obstacles, and the in-place turn treats the
    whole box as an obstacle. Sim from a handoff beside the box: the old
    rule swept the body 7-10 cm into the box corner, now it slides
    around and docks with 1 cm gap; handoff on the stop line 11-14 cm to
    the side docks too. Monte Carlo (107 runs) unchanged vs before.
    - safety gap uses t_react + the raw scan age (scans up t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
2026-11-08 feat(planning): dock handoff corridor and rack cell rules
    Executor: hand Nav2 over to the precise dock only inside the corridor
    behind the stop (ahead -0.02..dock_handoff_m, |lateral| <
    dock_handoff_lat_m 0.15 m, |yaw| < dock_handoff_yaw_deg 60; the yaml
    lines come with the next commit), the team
    lead's 11-07 rule from the drive test tool. The plain 0.40 m radius
    could hand over beside the box.
    Cargo: optional slot rules (cell, cell that must be empty) for store
    and retrieve, read by the executor from rack_store_needs_empty /
    rack_retrieve_needs_empty (same table as rack_cells.yaml
    rack_constraints). free_slot prefers an empty cell whose rule holds
    and falls back to the first empty cell. Th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
2026-11-08 fix(mission): follow the v5 spec for pip direction, barcode and signal
    Checked against the spec PDF (v5, 11-04):
    - pips: p.4 says map +Y up, the same direction at every place, 2/3
    diagonals and 6 two columns as drawn, no rotation. The plan rotated
    the picture by each stop's view direction, so L1 (viewed west to
    east) got the 2, 3 and 6 patterns turned 90 degrees. Now all three
    use arena +Y (through map_from_arena yaw); the place order still goes
    far-first from the viewer. dice_pip_frame: viewer keeps the old way.
    Test Dice.PlaceDirectionsSameOrientationEverywhere.
    - barcode: a single 5 s read miss ended the whole mission (return
    home). Now the read is retried in place up to rea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
    [planning.yaml]
2026-11-08 docs(setup): current robot run order, ports and firmware upload
    Port table (no udev names yet: drive OpenCR usb 1.3, arm 1.4, lidars
    2.1 / 2.2), Jetson IP, and a section with the 11-07 run order: T1
    remap SLAM, T2 nav2 dock:=simple only after the map is up (planner
    fails on the missing map TF otherwise), T3 goal sender; map fit tool,
    aliases, not mixing bringup with nt-cam / nt-perc, arduino-cli upload,
    common problems. dock:=simple is now the nav2 default.
2026-11-08 fix(arm): keep the wrist camera drift when the home reference is retaken
    On 11-07 around 17:40 the gripper stand was replaced. The HOME photo no
    longer matched the 11-06 reference (17-18 ORB matches, 40 needed), so
    every HOME measurement since then was dropped and control_master kept
    the last value from 11-07 17:39 (1.17 deg). The camera had moved on to
    1.45 deg, a 0.56 deg difference that shifts the pucks seen from LOOK by
    3.0-3.4 mm - the 3 mm short grasp seen on the robot on 11-08. With
    min_points lowered to 15 the 1.45 deg was measured (resid 4.3 px) and
    the grasp was centred again.
    Retaking the reference used to reset the drift to zero, which would
    shift every camera-based position by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
2026-11-08 feat(arm): per-cell measured grip depth for pucks taken out of the rack
    PLACE sets the release height from the grip depth so that the puck
    bottom ends 2 mm above the surface. After RETRIEVE the depth was always
    retrieve_grip_depth_mm (25) whatever the cell, so on 11-08 pucks taken
    out of the rack were dropped from above the box and moved on landing.
    The third value of retrieve_offset is not a usable depth: for S1 and S2
    it brings a recorded path that gripped too shallow back down (comment
    "recording is high"), so adding it would push the puck into the box.
    Instead each cell can now carry a measured depth,
    retrieve_grip_depth.<cell> [mm] (0 = use retrieve_grip_depth_mm). It is
    read when the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
2026-11-08 fix(hardware): unwrap multi-turn joints after CONFIG (J1 read one turn off)
    J1 and the gripper run in the firmware's extended (multi-turn) position
    mode. CONFIG rewrites the operating mode and the motor recounts its
    position within one turn (0..4095). HOME J1 is tick 4085, only 11 ticks
    below the 4096 wrap. On 11-08 T1 was restarted with the body about 1
    degree left of front (tick ~4101): J1 came back as tick 5 = -6.26 rad,
    the joint limiter stopped arm_controller and a HOME would have tried to
    turn the body a full revolution.
    OpenCRLink now fixes a whole-turn offset (turn_rad, a multiple of 2*pi)
    for every MODE_CURRENT_POSITION joint at its first measured STATE after
    each CONFIG, so that t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
    [opencr_hardware.cpp, opencr_link.cpp, opencr_link.hpp]
2026-11-08 Revert "fix(hardware): unwrap multi-turn joints after CONFIG (J1 read one turn off)"
    This reverts commit b6c372abe952764ff54979d9786049c18e939884.
    [opencr_hardware.cpp, opencr_link.cpp, opencr_link.hpp]
2026-11-08 Revert "feat(arm): per-cell measured grip depth for pucks taken out of the rack"
    This reverts commit 0fc5da3f3ddcd2c3db1ef2a232752b72ea05f9ef.
2026-11-08 fix(arm): J1 zero 4104 and restore multi-turn unwrap
    The gripper seated by hand in the park stand now reads J1 4097..4106.
    From the URDF stand and finger meshes the stand leaves 1.3 mm of side
    play (left 0.9, right 0.4 mm) = about 9 J1 ticks at the stand radius
    of 91 mm, so with the old reading the seated range was 4081..4090.
    Both ends moved by +16 ticks: the same physical J1 now reads 16 ticks
    higher. HOME (4084) therefore ended 2.2 mm to the right and the right
    finger hit the stand, and the seated J1 crossed the 4096 wrap so the
    extended-position motor re-counted to 1..10 at power-up and the
    controller refused -6.26 rad.
    - config/hardware_map.yaml: joint1 zero_tick 4088 -> 4104. Paths,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
    [hardware_map.yaml]
2026-11-08 fix(arm): write the J1 zero as 8 (4104 minus one turn)
    f2809a4 set joint1 zero_tick 4104. The OpenCR plugin only accepts
    zero_tick 0..4095, so bus_arm failed to initialize ("zero_tick 4104 은
    위치 모드에서 0~4095 만") and ros2_control_node then crashed in the
    state-interface introspection.
    With the multi-turn unwrap the zero only matters modulo one turn: the
    first reading after CONFIG is moved to within half a turn of the zero,
    so 8 and 4104 give the same joint value for every reading (new test
    sweeps all 4096 ticks). HOME is now motor tick 4. A J1 that powers up
    just below the wrap (e.g. 4093) is taken one turn down (-11 ticks)
    instead of +6.27 rad. robot_cli shows the motor tick a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
    [hardware_map.yaml]
2026-11-08 fix(arm): grip upright pucks 10 mm shallower and 3 mm further forward
    After the J1 zero fix the box PICK grips upright pucks too deep and
    about 3 mm behind the centre. pick_heights_mm -50 was chosen when the
    wrist perception saw the puck top about 1 cm high (command -50 = about
    40 mm real); it now grips deeper than that.
    - New parameter pick_top_bias_mm (default 0, config 10): pick_plan
    raises the perceived top of an upright puck by this much before the
    grasp poses are solved, so the fingertips stop 10 mm higher. The
    recorded grip depth stays the command value (50), so STORE's
    store_match_grip_depth (box PICK 50 vs park re-grasp 30 = +20 mm,
    the 11-07 S2 fix) is unchanged. Lying p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
    [control.yaml]
2026-11-08 fix(config): lying puck pick 3 mm forward and 3 mm left
    After the J1 zero fix lying pucks are also gripped behind and to the
    right of the centre, like the upright ones. Same correction as upright
    (forward +3 mm) plus left +3 mm, for both the tagged and the untagged
    lying offsets: tagged (-5, 0) -> (-2, 3), untagged (-12, -3.5) ->
    (-9, -0.5). Depth (pick_lying_heights_mm) unchanged.
    Claude-Session: https://claude.ai/code/session_01CBYQZsx91AYrBSdtmrqrPg
    [control.yaml]
2026-11-08 fix(config): upright puck pick another 3 mm forward
    [control.yaml]
2026-11-08 Revert "fix(config): lying puck pick 3 mm forward and 3 mm left"
    This reverts commit 4ca3c28c70a6fafb97fa3d85752f3a0503c45f44.
    [control.yaml]
2026-11-09 fix(config): keep the lying puck pick offsets that worked on 11-08
    On 11-08 22:47 the lying puck pick scraped the right side and knocked
    the puck away; ros2 param set to pick_offset_lying_tagged_y_mm -5.0
    and pick_offset_lying_y_mm -8.5 (5 mm to the right) picked it. The
    values were lost on the next T1 restart (23:07). Saved here, marked
    temporary until the arm cause after the J1 zero change is found.
    Comments of pick_offset_x_mm / pick_offset_tagged_x_mm now match the
    value 4.0 (-2 -> +1 in 062d12c -> +4 in d1e2767) and note that the
    11-07 and 11-08 comments read the +x direction opposite ways, to be
    checked on the robot with a 1 mm change.
    [control.yaml]
2026-11-09 fix(hardware): redo the multi-turn turn count after a lost reading
    The turn correction for multi-turn joints (J1, gripper) was decided
    once after CONFIG. If the arm motor power drops briefly while T1 runs,
    the motor recounts within 0..4095 but the old turn stayed, so J1 could
    read a full turn off or the gripper try to turn half a turn.
    - a STATE with the joint's comm_err bit clears turn_set_; the next good
    reading decides the turn again (J1 and gripper ranges are within half
    a turn of their zero, so the answer is unique) and logs it if the
    turn changed
    - until then send_command leaves that joint's valid bit off, so the
    firmware keeps its last goal instead of a goal computed with the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
    [opencr_link.cpp, opencr_link.hpp]
2026-11-09 fix(arm): pair the camera drift base with its reference photo
    - ref_base.txt also stores the size and mtime (stat, Unix seconds) of
    ref.png; if the photo was replaced by hand without the base, the
    base is not chained (WARN) instead of applying the drift twice. Old
    files without the line are read as before.
    - save_reference first measures the new frame against the old
    reference and chains that result into the new base; if that fails it
    keeps using the last published drift and warns how old it is.
    - the 2 deg warning and reject logs also print the chained total angle
    (no new reject condition).
    Tests for the pairing check and the total angle.
2026-11-09 test(robot_cli): expect the 0.2575 m box stops; fix a stale URDF rack note
    Model.Stops still expected the old 0.2935 m stop distance; dice_map
    uses 0.2575 m (box face + 1 cm) since the 11-06 team merge. Expected
    B1 stop and the nearest-stop query point now follow the map file.
    The URDF rack comment claimed a 10 mm gap to rack_cells.yaml from the
    old table; the current table is the URDF cell links + 1 mm. Comment
    only, no URDF value changed (URDF values checked against
    hardware_map, arm_kinematics, rack_cells and control.yaml).
    [robot.urdf.xacro]
2026-11-09 feat(arm): optional settle pause above the puck; robot-tested press and S1 values
    On 11-09 the hand arrived above the puck still swinging and went
    straight down, so picks landed off by several mm. New pick_settle_s
    and place_settle_s (default 0 = unchanged paths) add a stop + hold at
    the point above the puck before descending: box PICK (upright and
    lying, incl. the park stand-up grasp), tilted regrasp, the upright
    regrasp after the table stand-up, PLACE and the far-place put-down /
    regrasp. An open-on-the-way gripper keeps its timing; the stop does
    not add a second gripper action. Test: 0 gives identical paths, > 0
    adds stop + hold above and keeps the open order.
    Values from today's robot t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
2026-11-09 feat(arm): optional settle pause above the rack cell before STORE
    On 11-09 the same cell (S5) missed to a different side each time,
    even after moving its store offset 5 mm, for both stood and box-picked
    upright pucks. The hand arrives above the cell still swinging and goes
    straight in; PICK and PLACE got a settle pause today, STORE had none.
    New store_settle_s (default 0 = unchanged paths) and
    store_settle_up_mm (default 20): on store_* paths, after the cell
    shift, stop and hold at the last point before the first release whose
    hand tip is at least that high above the release tip (just before the
    final descent). From the recorded paths that point is 10-15 points
    before release and 2-4 mm sid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
    [control.yaml]
2026-11-09 fix(config): robot-tested pick offsets and S12 retrieve (11-09 evening)
    Robot test 11-09:
    - pick_offset_lying_x_mm -12 -> 0: a red lying box puck whose tag is
    scratched (always measured by the depth centre) was gripped near its
    middle and dropped in front of the stand at -12; at 0 it was gripped
    at the end and stood. After a restart the old -12 came back and the
    same puck was dropped again (16:13 run), so keep it in the file.
    - pick_offset_tagged_x_mm 4 -> 10: upright pucks with a readable top
    tag were gripped behind the centre; at 10 the S12 store went in.
    - retrieve_offset.S12 [-8, -5] -> [-2, 2, -10]: grips too high at the
    old value; 10 mm deeper, 6 mm forward and 7 mm left to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
    [control.yaml]
